kammoh/fobos/control/README.md

FOBOS Control
=============

If you want to use a Digilent Inc Basis 3 board for FOBOS Control, proceed to the directory `basys3ctrl`.

If you want to use a Xilinx Pynq board for FOBOS Control, proceed to the directory `pynctrl`.

The directory `ip_repo` contains FOBOS IP blocks that are used by either control board project.
