kammoh/fobos/hardware/fobos-dut/README.md

FOBOS-DUT Boards
=========
  * `dut-spartan7-s15`
    FOBOS DUT with a Xilinx Spartan-7 xc7s15cpga196-2 device and power measurement circuitry.
  * `dut-artix7-a12t-csg325`
    FOBOS DUT with a Xilinx Artix-7 xc7a12tcsg325 device and power measurement circuitry.
  * `dut-artix7-a12t-cpg238`
    FOBOS DUT with a Xilinx Artix-7 xc7a12tcpg238 device and power measurement circuitry.
  * `dut-cyclone10LP-016`
    FOBOS DUT with an Interl Cyclone 10 LP 10CL016-YU256C6 device and power measurement circuitry.
  * `dut-ecp5-25`
    FOBOS DUT with a Lattice ECP5 LFE5U-25F-6BG381C device and power measurement circuitry.

Check git Wiki
