kammoh/fobos/releasefilelist.txt

# use with tar czvf fobos-0.1.tgz -T releasefilelist.txt
./fobos/requirements.txt
./fobos/software/dummyCapture.py
./fobos/software/tools/x-test/x-test3.py
./fobos/software/tools/t-test/splitter.py
./fobos/software/tools/t-test/t-test2.py
./fobos/software/tools/t-test/read_traces.py
./fobos/software/tools/viewPlots.py
./fobos/software/dummyCaptureBasic.py
./fobos/software/tvgen/blockCipherTVGen.py
./fobos/software/captureScope.py
./fobos/software/attack_with_cpa.py
./fobos/software/program_Nexys3_dut.py
./fobos/software/dummyDUTCapture.py
./fobos/software/captureAES.py
./fobos/software/captureAES_picoscope.py
./fobos/software/genRandTV.py
./fobos/software/fobos/dummyserial.py
./fobos/software/fobos/fobosctrl.py
./fobos/software/fobos/projmgr.py
./fobos/software/fobos/traceset.py
./fobos/software/fobos/detectctrl.py
./fobos/software/fobos/ttestOnline.py
./fobos/software/fobos/cpa.py
./fobos/software/fobos/powermodels/__init__.py
./fobos/software/fobos/powermodels/AESFirstLast.py
./fobos/software/fobos/basys3ctrl.py
./fobos/software/fobos/nexys3dut.py
./fobos/software/fobos/__init__.py
./fobos/software/fobos/t-test2.py
./fobos/software/fobos/picoscope.py
./fobos/software/fobos/datagen.py
./fobos/software/fobos/scope.py
./fobos/software/fobos/hypopower.py
./fobos/software/fobos/postprocess.py
./fobos/workspace/dummyProject/FOBOS_DUT_dummy1.bit
./fobos/workspace/dummyProject/dinFile.txt
./fobos/workspace/aes/dinFile.txt
./fobos/LICENSE.txt
./fobos/capture/ctrl/ip_repo/dutcomm_1.0/xgui/dutcomm_v1_0.tcl
./fobos/capture/ctrl/ip_repo/dutcomm_1.0/component.xml
./fobos/capture/ctrl/ip_repo/dutcomm_1.0/dutcomm_IP_doc.txt
./fobos/capture/ctrl/ip_repo/dutcomm_1.0/hdl/dutcomm_v1_0_S_AXI.vhd
./fobos/capture/ctrl/ip_repo/dutcomm_1.0/hdl/dutCommCtrl.vhd
./fobos/capture/ctrl/ip_repo/dutcomm_1.0/hdl/half_duplex_interface.vhd
./fobos/capture/ctrl/ip_repo/dutcomm_1.0/hdl/dutcomm_v1_0.vhd
./fobos/capture/ctrl/ip_repo/dutcomm_1.0/hdl/dutcomm_wrapper.vhd
./fobos/capture/ctrl/ip_repo/dutcomm_1.0/hdl/dutComm.vhd
./fobos/capture/ctrl/ip_repo/dutcomm_1.0/hdl/fwft_fifo.vhd
./fobos/capture/ctrl/ip_repo/dutcomm_1.0/hdl/half_duplex_int_tb.vhd
./fobos/capture/ctrl/ip_repo/dutcomm_1.0/hdl/dutcomm_tb.vhd
./fobos/capture/ctrl/ip_repo/dutcomm_1.0/drivers/dutcomm_v1_0
./fobos/capture/ctrl/ip_repo/dutcomm_1.0/drivers/dutcomm_v1_0/src
./fobos/capture/ctrl/ip_repo/dutcomm_1.0/drivers/dutcomm_v1_0/src/Makefile
./fobos/capture/ctrl/ip_repo/dutcomm_1.0/drivers/dutcomm_v1_0/src/dutcomm.h
./fobos/capture/ctrl/ip_repo/dutcomm_1.0/drivers/dutcomm_v1_0/src/dutcomm_selftest.c
./fobos/capture/ctrl/ip_repo/dutcomm_1.0/drivers/dutcomm_v1_0/src/dutcomm.c
./fobos/capture/ctrl/ip_repo/dutcomm_1.0/drivers/dutcomm_v1_0/data
./fobos/capture/ctrl/ip_repo/dutcomm_1.0/drivers/dutcomm_v1_0/data/dutcomm.mdd
./fobos/capture/ctrl/ip_repo/dutcomm_1.0/drivers/dutcomm_v1_0/data/dutcomm.tcl
./fobos/capture/ctrl/ip_repo/seven_seg_1.0/xgui/seven_seg_v1_0.tcl
./fobos/capture/ctrl/ip_repo/seven_seg_1.0/component.xml
./fobos/capture/ctrl/ip_repo/seven_seg_1.0/hdl/seven_seg_v1_0.vhd
./fobos/capture/ctrl/ip_repo/seven_seg_1.0/hdl/seven_seg_v1_0_S_AXI.vhd
./fobos/capture/ctrl/ip_repo/seven_seg_1.0/drivers/seven_seg_v1_0
./fobos/capture/ctrl/ip_repo/seven_seg_1.0/drivers/seven_seg_v1_0/src
./fobos/capture/ctrl/ip_repo/seven_seg_1.0/drivers/seven_seg_v1_0/src/Makefile
./fobos/capture/ctrl/ip_repo/seven_seg_1.0/drivers/seven_seg_v1_0/src/seven_seg.c
./fobos/capture/ctrl/ip_repo/seven_seg_1.0/drivers/seven_seg_v1_0/src/seven_seg_selftest.c
./fobos/capture/ctrl/ip_repo/seven_seg_1.0/drivers/seven_seg_v1_0/src/seven_seg.h
./fobos/capture/ctrl/ip_repo/seven_seg_1.0/drivers/seven_seg_v1_0/data
./fobos/capture/ctrl/ip_repo/seven_seg_1.0/drivers/seven_seg_v1_0/data/seven_seg.tcl
./fobos/capture/ctrl/ip_repo/seven_seg_1.0/drivers/seven_seg_v1_0/data/seven_seg.mdd
./fobos/capture/ctrl/ip_repo/dut_controller_1.0/dut_ctrl_IP_doc.txt
./fobos/capture/ctrl/ip_repo/dut_controller_1.0/xgui/dut_controller_v1_0.tcl
./fobos/capture/ctrl/ip_repo/dut_controller_1.0/component.xml
./fobos/capture/ctrl/ip_repo/dut_controller_1.0/hdl/trigger_tb.vhd
./fobos/capture/ctrl/ip_repo/dut_controller_1.0/hdl/rst_mod.vhd
./fobos/capture/ctrl/ip_repo/dut_controller_1.0/hdl/rst_mod_tb.vhd
./fobos/capture/ctrl/ip_repo/dut_controller_1.0/hdl/counter.vhd
./fobos/capture/ctrl/ip_repo/dut_controller_1.0/hdl/dut_controller_v1_0.vhd
./fobos/capture/ctrl/ip_repo/dut_controller_1.0/hdl/timeout_mod_tb.vhd
./fobos/capture/ctrl/ip_repo/dut_controller_1.0/hdl/fobos_package.vhd
./fobos/capture/ctrl/ip_repo/dut_controller_1.0/hdl/trigger_module.vhd
./fobos/capture/ctrl/ip_repo/dut_controller_1.0/hdl/timeout_module.vhd
./fobos/capture/ctrl/ip_repo/dut_controller_1.0/hdl/dut_controller_v1_0_S_AXI.vhd
./fobos/capture/ctrl/ip_repo/dut_controller_1.0/drivers/dut_controller_v1_0
./fobos/capture/ctrl/ip_repo/dut_controller_1.0/drivers/dut_controller_v1_0/src
./fobos/capture/ctrl/ip_repo/dut_controller_1.0/drivers/dut_controller_v1_0/src/Makefile
./fobos/capture/ctrl/ip_repo/dut_controller_1.0/drivers/dut_controller_v1_0/src/dut_controller.c
./fobos/capture/ctrl/ip_repo/dut_controller_1.0/drivers/dut_controller_v1_0/src/dut_controller_selftest.c
./fobos/capture/ctrl/ip_repo/dut_controller_1.0/drivers/dut_controller_v1_0/src/dut_controller.h
./fobos/capture/ctrl/ip_repo/dut_controller_1.0/drivers/dut_controller_v1_0/data
./fobos/capture/ctrl/ip_repo/dut_controller_1.0/drivers/dut_controller_v1_0/data/dut_controller.tcl
./fobos/capture/ctrl/ip_repo/dut_controller_1.0/drivers/dut_controller_v1_0/data/dut_controller.mdd
./fobos/capture/ctrl/ip_repo/dummyDUT/fobos_dut_pkg.vhd
./fobos/capture/ctrl/ip_repo/dummyDUT/dut_reg1.vhd
./fobos/capture/ctrl/ip_repo/dummyDUT/fobos_controller.vhd
./fobos/capture/ctrl/ip_repo/dummyDUT/FOBOS_DUT.vhd
./fobos/capture/ctrl/ip_repo/dummyDUT/dut_regn.vhd
./fobos/capture/ctrl/ip_repo/dummyDUT/fifo.vhd
./fobos/capture/ctrl/ip_repo/dummyDUT/fifo2.vhd
./fobos/capture/ctrl/ip_repo/dummyDUT/test_controller.vhd
./fobos/capture/ctrl/ip_repo/dummyDUT/fobos_dut_tb.vhd
./fobos/capture/ctrl/ip_repo/dummyDUT/dummy.vhd
./fobos/capture/ctrl/basys3ctrl/sdk/src/seven_seg.c
./fobos/capture/ctrl/basys3ctrl/sdk/src/seven_seg.h
./fobos/capture/ctrl/basys3ctrl/sdk/src/ctrl.c
./fobos/capture/ctrl/basys3ctrl/vivado/Makefile
./fobos/capture/ctrl/basys3ctrl/vivado/src/bd/top.tcl
./fobos/capture/ctrl/basys3ctrl/vivado/src/constr/debug.xdc
./fobos/capture/ctrl/basys3ctrl/vivado/src/constr/basys3ctrl.xdc
./fobos/capture/ctrl/basys3ctrl/vivado/build_proj.tcl
./fobos/capture/dut/fpga_dut/fobos_dut_pkg.vhd
./fobos/capture/dut/fpga_dut/dut_reg1.vhd
./fobos/capture/dut/fpga_dut/fobos_controller.vhd
./fobos/capture/dut/fpga_dut/FOBOS_DUT.vhd
./fobos/capture/dut/fpga_dut/dut_regn.vhd
./fobos/capture/dut/fpga_dut/half_duplex_interface.vhd
./fobos/capture/dut/fpga_dut/fifo.vhd
./fobos/capture/dut/fpga_dut/test_controller.vhd
./fobos/capture/dut/fpga_dut/fobos_dut_tb.vhd
./fobos/capture/dut/fpga_dut/Nexys3.ucf
./fobos/capture/dut/fpga_dut/cw305_dut.xdc
./fobos/capture/dut/example_cores/dummy1
./fobos/capture/dut/example_cores/dummy1/dummy.vhd
./fobos/releasefilelist.txt
