kammoh/fobos/docs/source/dut/index.rst

.. _dut-label:

*********
FOBOS DUT
*********
FOBOS supports two boards for FOBOS Control:

#. Digilent Basys 3
#. Digilent Pynq-Z1

.. toctree::
   :hidden:
   
   dut_setup
   dut_development
