kammoh/fobos/hardware/fobos-dut/dut-artix7-a12t-csg325/dut-artix7-a12t.html

# D:\_Grad_School\CERG_2020\fobos\hardware\fobos-dut\dut-artix7-a12t\dut-artix7-a12t.sch

5/25/2021 10:37:35 PM

Eeschema (5.1.7)-1

Component Count:179

Ref | Qnty | Value | Part | Datasheet | Description | Vendor
C1, C2, C3, C4, C5, C9, C11, C13, C14, C16, C24, C54 | 12 | 100nF | Device:C | ~ | Unpolarized capacitor
C6, C10, C22, C23 | 4 | 10uF | Device:C | ~ | Unpolarized capacitor
C7 | 1 | 47uF6.3V | Device:C | ~ | Unpolarized capacitor
C8 | 1 | 10nF | Device:C | ~ | Unpolarized capacitor
C12 | 1 | 4n7 | Device:C | ~ | Unpolarized capacitor
C15 | 1 | 2u2 | Device:C | ~ | Unpolarized capacitor
C17, C21 | 2 | 22uF | Device:C | ~ | Unpolarized capacitor
C18, C19, C20 | 3 | 20pF | Device:C | ~ | Unpolarized capacitor
C25 | 1 | 100uF | Device:C | ~ | Unpolarized capacitor
C26, C27, C35 | 3 | 47uF | Device:C | ~ | Unpolarized capacitor
C28, C29, C36, C37, C38, C39, C40, C41 | 8 | 4.7uF | Device:C | ~ | Unpolarized capacitor
C30, C31, C32, C33, C34, C42, C43, C44, C45, C46, C47, C48, C49, C50, C51, C52, C53 | 17 | .47uF | Device:C | ~ | Unpolarized capacitor
D1, D2, D3, D4, D5, D6 | 6 | LG_L29K-G2J1-24-Z | cerg:LG_L29K-G2J1-24-Z | https://dammedia.osram.info/media/resource/hires/osram-dam-2493945/LG%20L29K.pdf | LED GREEN DIFFUSED 0603 SMD
F1 | 1 | MF-MSMF050-2 | Device:Polyfuse | ~ | Resettable fuse, polymeric positive temperature coefficient
H1, H2, H3, H4 | 4 | MountingHole | Mechanical:MountingHole | ~ | Mounting Hole without connection
J1 | 1 | Target | Connector_Generic:Conn_02x10_Odd_Even | ~ | Generic connector, double row, 02x10, odd/even pin numbering scheme (row 1 odd numbers, row 2 even numbers), script generated (kicad-library-utils/schlib/autogen/connector/)
J2 | 1 | Pmod 2x6 | Connector_Generic:Conn_02x06_Top_Bottom | ~ | Generic connector, double row, 02x06, top/bottom pin numbering scheme (row 1: 1...pins_per_row, row2: pins_per_row+1 ... num_pins), script generated (kicad-library-utils/schlib/autogen/connector/)
J3, J8 | 2 | 575-8 | cerg:575-8 | https://www.digikey.com/en/products/detail/keystone-electronics/575-8/318495 | CONN TIP JACK SOLDER RED
J4 | 1 | Glitch | Connector:Conn_Coaxial_Power | ~ | coaxial connector (BNC, SMA, SMB, SMC, Cinch/RCA, ...)
J5, J10 | 2 | Conn_01x02 | Connector_Generic:Conn_01x02 | ~ | Generic connector, single row, 01x02, script generated (kicad-library-utils/schlib/autogen/connector/)
J6, J9 | 2 | Measure | Connector:Conn_Coaxial_Power | ~ | coaxial connector (BNC, SMA, SMB, SMC, Cinch/RCA, ...)
J7 | 1 | 0878321420 | dk_Rectangular-Connectors-Headers-Male-Pins:0878321420 | https://www.molex.com/pdm_docs/sd/878322620_sd.pdf | CONN HEADER SMD 14POS 2MM
JP1 | 1 | Source | Jumper:Jumper_3_Open | ~ | Jumper, 3-pole, both open
JP2 | 1 | CurProbe | Jumper:Jumper_2_Open | ~ | Jumper, 2-pole, open
JP3 | 1 | Shunt1R | Jumper:Jumper_2_Open | ~ | Jumper, 2-pole, open
JP4 | 1 | FC3V3_3V3_SHUNT | Jumper:Jumper_2_Open | ~ | Jumper, 2-pole, open
JP5 | 1 | Conn_01x02 | Connector_Generic:Conn_01x02 | ~ | Generic connector, single row, 01x02, script generated (kicad-library-utils/schlib/autogen/connector/)
L1, L2 | 2 | 1k/500mA | Device:L_Core_Ferrite | ~ | Inductor with ferrite core
L3 | 1 | 1.5uH | Device:L | https://www.mouser.com/ProductDetail/Bourns/SRN2012-1R5M/?qs=U0ECReq1GB%2FS6CSJ%2FWDZfQ%3D%3D | Inductor
L4 | 1 | 3.3uH | Device:L | https://www.digikey.com/en/products/detail/taiyo-yuden/BRC2012T3R3MD/2648984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 | Inductor
L5 | 1 | 2.2uH | Device:L | https://www.digikey.com/en/products/detail/bourns-inc/SRN2010-2R2M/4867667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 | Inductor
Q1 | 1 | FDS9435A | Transistor_FET:FDS9435A | https://www.onsemi.com/pub/Collateral/FDS9435A-D.PDF | -5.3A Id, -30V Vds, P-Channel MOSFET, 50mOhm Ron, SO-8
Q2 | 1 | MBT3904DW1 | Transistor_BJT:MBT3904DW1 | http://www.onsemi.com/pub_link/Collateral/MBT3904DW1T1-D.PDF | 200mA IC, 40V Vce, Dual NPN/NPN Transistors, SOT-363
Q3, Q4, Q5, Q6, Q7 | 5 | BSS138 | Transistor_FET:BSS138 | https://www.fairchildsemi.com/datasheets/BS/BSS138.pdf | 50V Vds, 0.22A Id, N-Channel MOSFET, SOT-23
R1, R2, R3, R4, R5, R6, R13, R14, R15, R16, R17, R18 | 12 | 22R | Device:R | ~ | Resistor
R7, R8, R9, R10, R11, R12, R19, R20, R53, R72 | 10 | 200R | Device:R | ~ | Resistor
R21 | 1 | 1M | Device:R | ~ | Resistor
R22 | 1 | 100R | Device:R | ~ | Resistor
R23 | 1 | 0R1 | Device:R | ~ | Resistor
R24 | 1 | 49R9 | Device:R | ~ | Resistor
R25, R26, R31, R32, R33, R41, R52, R54, R55 | 9 | 4.7KR | Device:R | ~ | Resistor
R27, R28, R56 | 3 | 33R | Device:R | ~ | Resistor
R29, R30, R37, R67 | 4 | 0R | Device:R | ~ | Resistor
R34 | 1 | 3.48KR | Device:R | ~ | Resistor
R35, R42, R43, R44, R45, R51, R60, R61, R62, R63, R64, R65, R66, R68, R70, R71 | 16 | 10KR | Device:R | ~ | Resistor
R36 | 1 | 1KR | Device:R | ~ | Resistor
R38, R39, R40, R49 | 4 | 100KR | Device:R | ~ | Resistor
R46, R47 | 2 | 120KR | Device:R | ~ | Resistor
R48 | 1 | 57.6KR | Device:R | ~ | Resistor
R50 | 1 | 800R | Device:R | ~ | Resistor
R57, R58, R59, R69 | 4 | 470R | Device:R | ~ | Resistor
S1 | 1 | JS202011SCQN | cerg:JS202011SCQN | https://www.ckswitches.com/media/1422/js.pdf | SWITCH SLIDE DPDT 300MA 6V
S2, S4, S5 | 3 | 1825910-6 | cerg:1825910-6 | https://www.te.com/commerce/DocumentDelivery/DDEController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 | SWITCH TACTILE SPST-NO 0.05A 24V
SW1, SW2 | 2 | SW_DIP_x03 | cerg:SW_DIP_x03 | https://www.cuidevices.com/product/resource/ds04-254-smt.pdf | 3x DIP Switch, Single Pole Single Throw (SPST) switch, small symbol
U1 | 1 | XC7A12T-CSG325 | cerg:XC7A12T-CSG325 | https://www.xilinx.com/support/documentation/data_sheets/ds180_7Series_Overview.pdf | Xilinx Artix-7 FPGA, XC7A12T, CSG325
U2, U3, U4 | 3 | SP3003-04ATG | cerg:SP3003-04ATG | http://www.onsemi.com/pub/Collateral/SRV05-4-D.PDF | ESD Protection Diodes with Low Clamping Voltage, SOT-23-6
U5 | 1 | INA225 | cerg:INA225
U6 | 1 | BGA2801 | RF_Amplifier:BGA2801 | https://www.nxp.com/docs/en/data-sheet/BGA2801.pdf | MMIC wideband amplifier, DC-2.2GHz, +23dB @ 2120MHz, 3.3V, SOT-363
U7 | 1 | TS3A5018DBQR | cerg:TS3A5018DBQR | https://www.digikey.com/en/products/detail/texas-instruments/TS3A5018DBQR/705733
U8 | 1 | LTC3569EFE#PBF | cerg:LTC3569EFE#PBF
U9 | 1 | IS25LP256D-JMLE | cerg:IS25LP256D-JMLE | https://www.digikey.com/en/products/detail/issi-integrated-silicon-solution-inc/IS25LP256D-JMLE/7567432 | IC FLASH 256M SPI 133MHZ 16SOIC
