kammoh/fobos/docs/presentations/fobos2_reconfig19_demo.odt

An Open-Source Platform for Evaluating Side-channel Countermeasures

in Hardware Implementations of Cryptography

Abubakr Abdulgadir¹, William Diehl² and Jens-Peter Kaps¹

¹Cryptographic Engineering Research Group

George Mason University, Fairfax, Virginia 22030, USA

email: {aabdulga, jkaps}@gmu.edu

²Signatures Analysis Lab

Virginia Tech, Blacksburg, Virginia 24061, USA

email: wdiehl@vt.edu

Side-channel Analysis (SCA) is a major security threat for cryptographic implementations.

The Flexible, Opensource workBench fOr Side-channel analysis (FOBOS) is an SCA platform developed at George Mason University that can perform acquisition and analysis with main focus on FPGA implementations as target devices.

FOBOS uses commercially available boards when possible to reduce cost and make it easy to replicate the system by different teams. The system is designed in a modular fashion allowing easy modification. For example, separate control board and design-under-test (DUT) boards allows easy integration of new DUT boards.

The system is composed of two major modules. The Data Acquisition module is used to capture traces and the Data Analysis module is used to perform SCA attacks or assess leakage.

FOBOS features include configurable triggering unit and support for various hardware APIs like the Lightweight Cryptography (LWC) Hardware API.

The latest version of the system, FOBOS2, supports fast USB3-based oscilloscopes, modern DUT FPGA boards and configurable DUT reset.

Also, new leakage assessment capabilities like the chi-squared test have been added.

At ReConFig 2019, we will demo FOBOS2 and show a typical hardware setup. The acquisition module will be demonstrated by collecting traces and leakage assessment software will be used to evaluate SCA resistance of a NIST LWC round-2 candidate implemented on an FPGA.
