kammoh/fobos/oldfobos/doc/flash_basys3.odt

Used this but not sure if the part related to tools→ Device properties is necessary

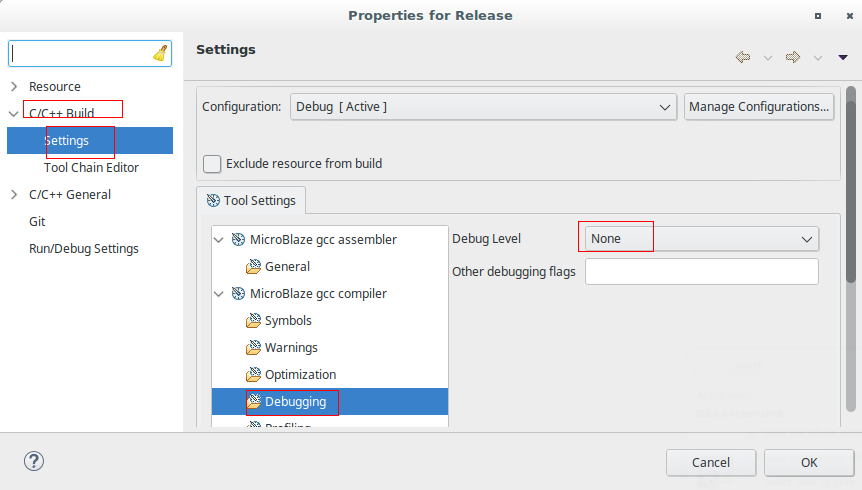
[picture p41: figure]

https://www.instructables.com/id/Flashing-a-MicroBlaze-Program/

Make sure that the program have no debug settings
