kammoh/fobos/doc/Poster/fobosposter.pdf

## Flexible, Opensource workBench fOr Side-channel analysis

# (FOBOS)

## Rajesh Velegalati, Panasayya Yalla, Jens-Peter Kaps

Department of Electrical and Computer Engineering, George Mason University, Fairfax, Virginia 22030, USA

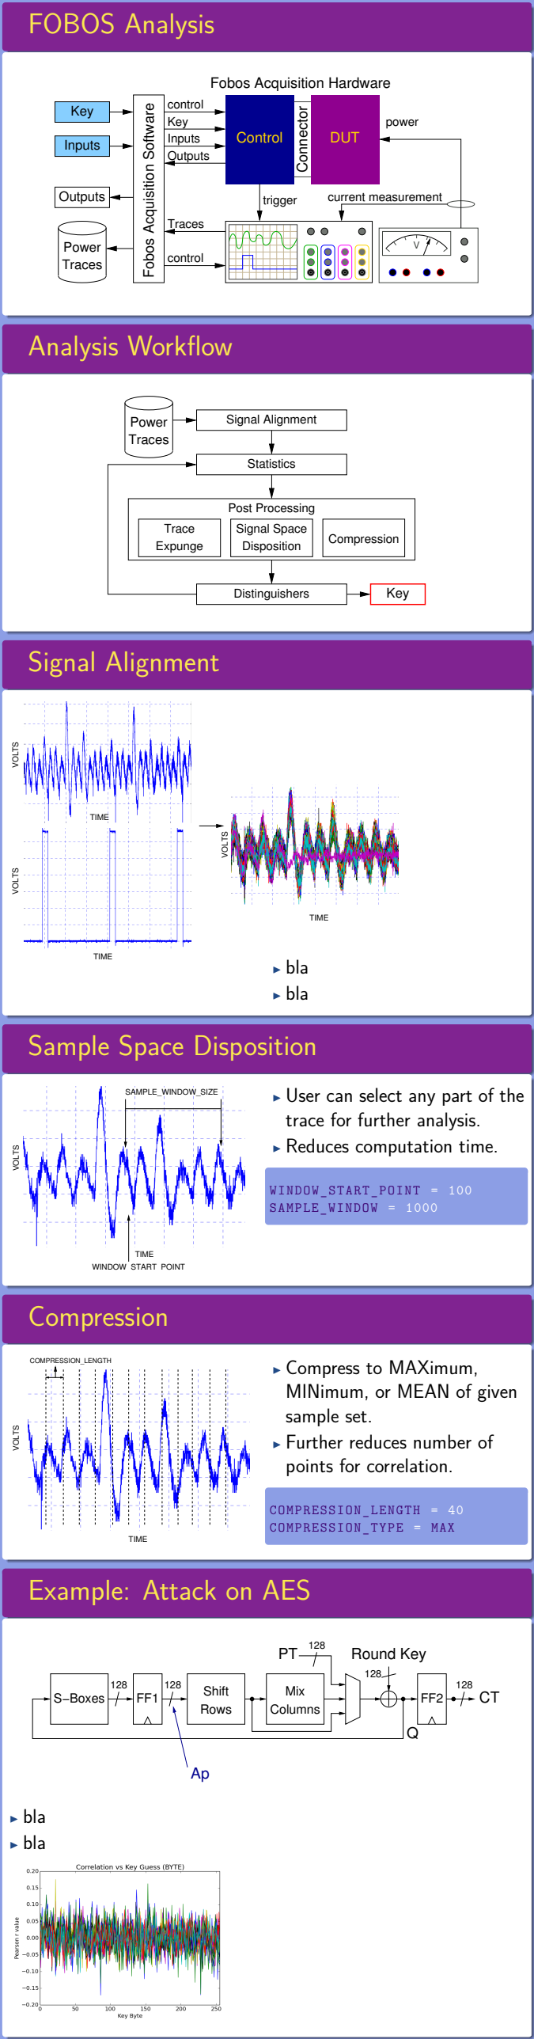
[picture p42: figure]
FOBOS Analysis; Connector; Control; DUT; Key; Inputs; Outputs; Power Traces; trigger; power; current measurement; control; Key Inputs Outputs; Traces; Fobos Acquisition Software; Fobos Acquisition Hardware; Analysis Workflow; Statistics; Distinguishers; Signal Alignment; Post Processing; Signal Space Disposition; Trace; Expunge; Compression; TIME; VOLTS VOLTS; VOLTS; I bla I bla; Sample Space Disposition; SAMPLE_WINDOW_SIZE; WINDOW_START_POINT; I User can select any part of the trace for further analysis. I Reduces computation time.; WINDOW_START_POINT = 100; SAMPLE_WINDOW = 1000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

## Abstract

Side-channel analysis (SCA) attacks pose a growing threat to implementations of cryptographic algorithms implemented in software as well as in hardware. Current standard side-channel evaluation boards with Field Programmable Gate Arrays (FPGAs), that allow for exploring the vulnerability of cryptographic implementations on FPGAs, are expensive and available only for a few FPGA devices. Furthermore, a complete open source software package that includes drivers that run test cases on the board, control the measurement equipment, and contain several side-channel analysis techniques is not readily available. Each user has to assemble their own setup based on software packages from multiple sources, written in multiple languages and write parts themselves. Additionally, this complexity and cost makes it very difficult, if not impossible, to educate students on side-channel analysis through hands-on laboratory exercises. FOBOS is an open-source framework for conducting side-channel attacks on FPGAs which supports multiple FPGA devices and includes all necessary software to run differential power analysis attacks, which are the most prominent kind of side-channel attacks. Through its completeness and support for educational FPGA boards it is an ideal teaching tool.

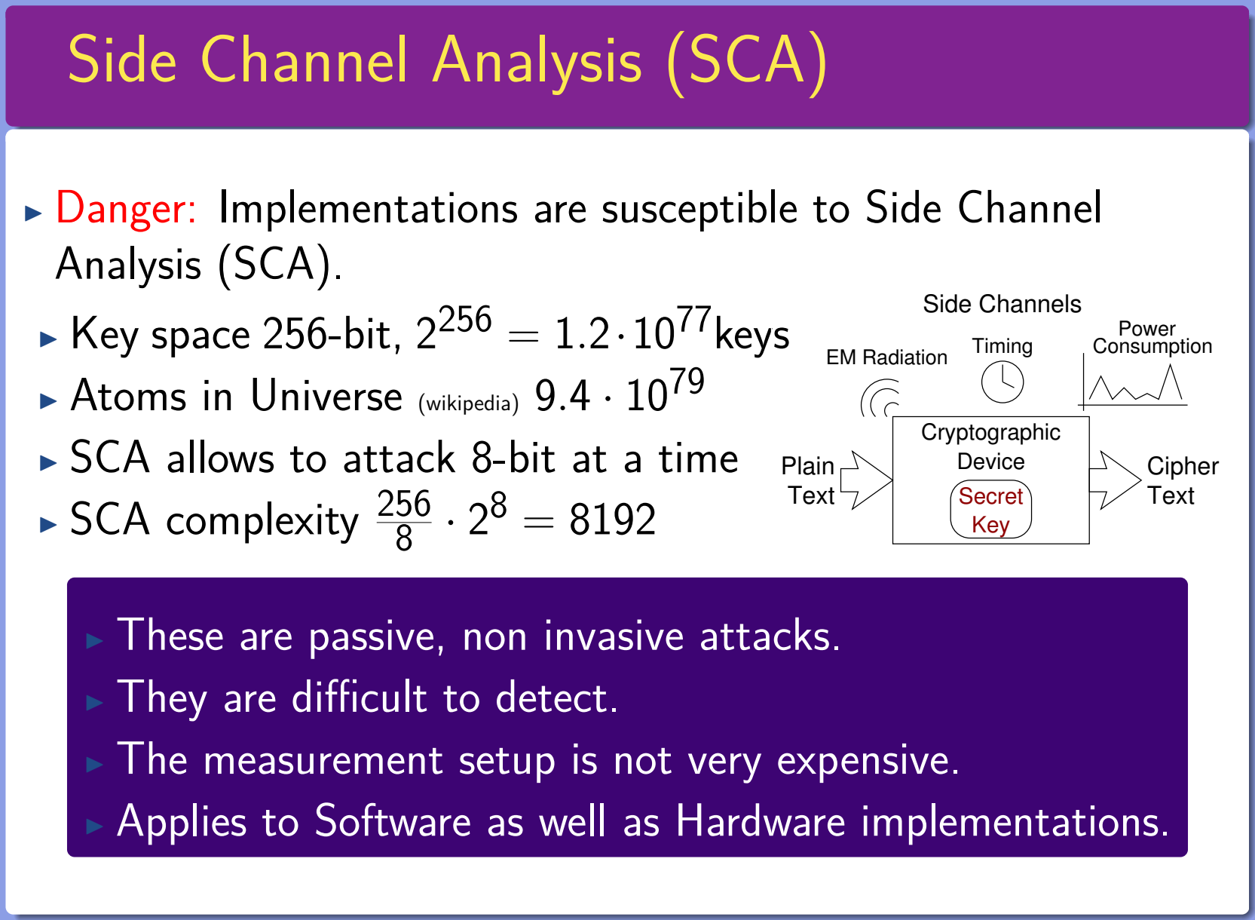
[picture p43: figure]
Side Channel Analysis (SCA); Analysis (SCA).; I SCA allows to attack 8-bit at a time I SCA complexity 256 8; Timing; Consumption; Power; Secret Key; Device; Cryptographic; Plain Text; EM Radiation; Side Channels; Text; Cipher; I They are difficult to detect.

I Danger: Implementations are susceptible to Side Channel

I Key space 256-bit, 2²⁵⁶ = 1.2·10⁷⁷keys
I Atoms in Universe (wikipedia) 9.4 · 10⁷⁹

I These are passive, non invasive attacks.

I The measurement setup is not very expensive.
I Applies to Software as well as Hardware implementations.

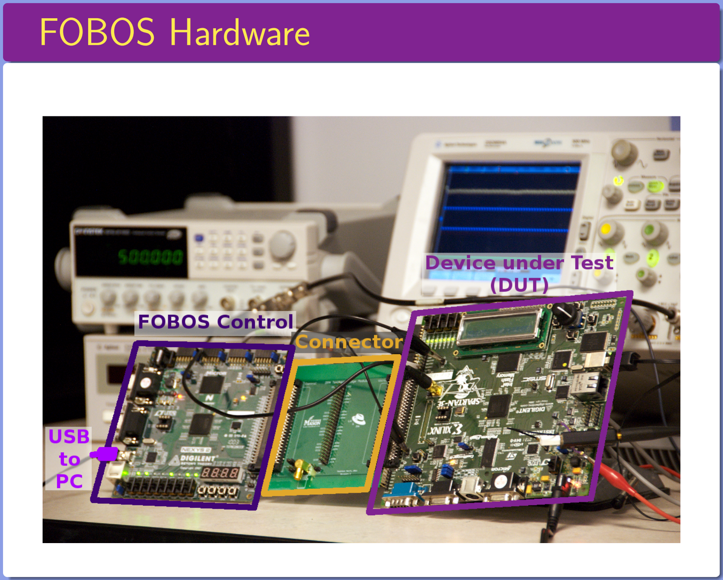
[picture p44: figure]
FOBOS Hardware

## Current SCA Evaluation Solutions

AES
I NIST standard for block
ciphers.
I Based on Rijndael block
cipher.
I 128-bit block size.
I 128/192/256-bit key size.

Keccak-p[1600,nr]
I Permutation based on Keccak, winner of competition for next Secure Hash Algorithm
(SHA-3).
I 1600-bit state size.

## Drawbacks of Current Solutions

I IA Meter only performs acquisition using Python.
I OpenSCA Toolbox performs only analysis using Matlab. I SASEBO has very limited FPGA support und uses C#.
I DPA resistance depends on FPGA family.
I DPA resistance depends on FPGA packaging (e.g., w/ or w/o capacitances).
I Currently only a patchwork of scripts and tools exist.
I No complete, free, and open-source solution is available. I No inexpensive out-of-the-box solution for education.

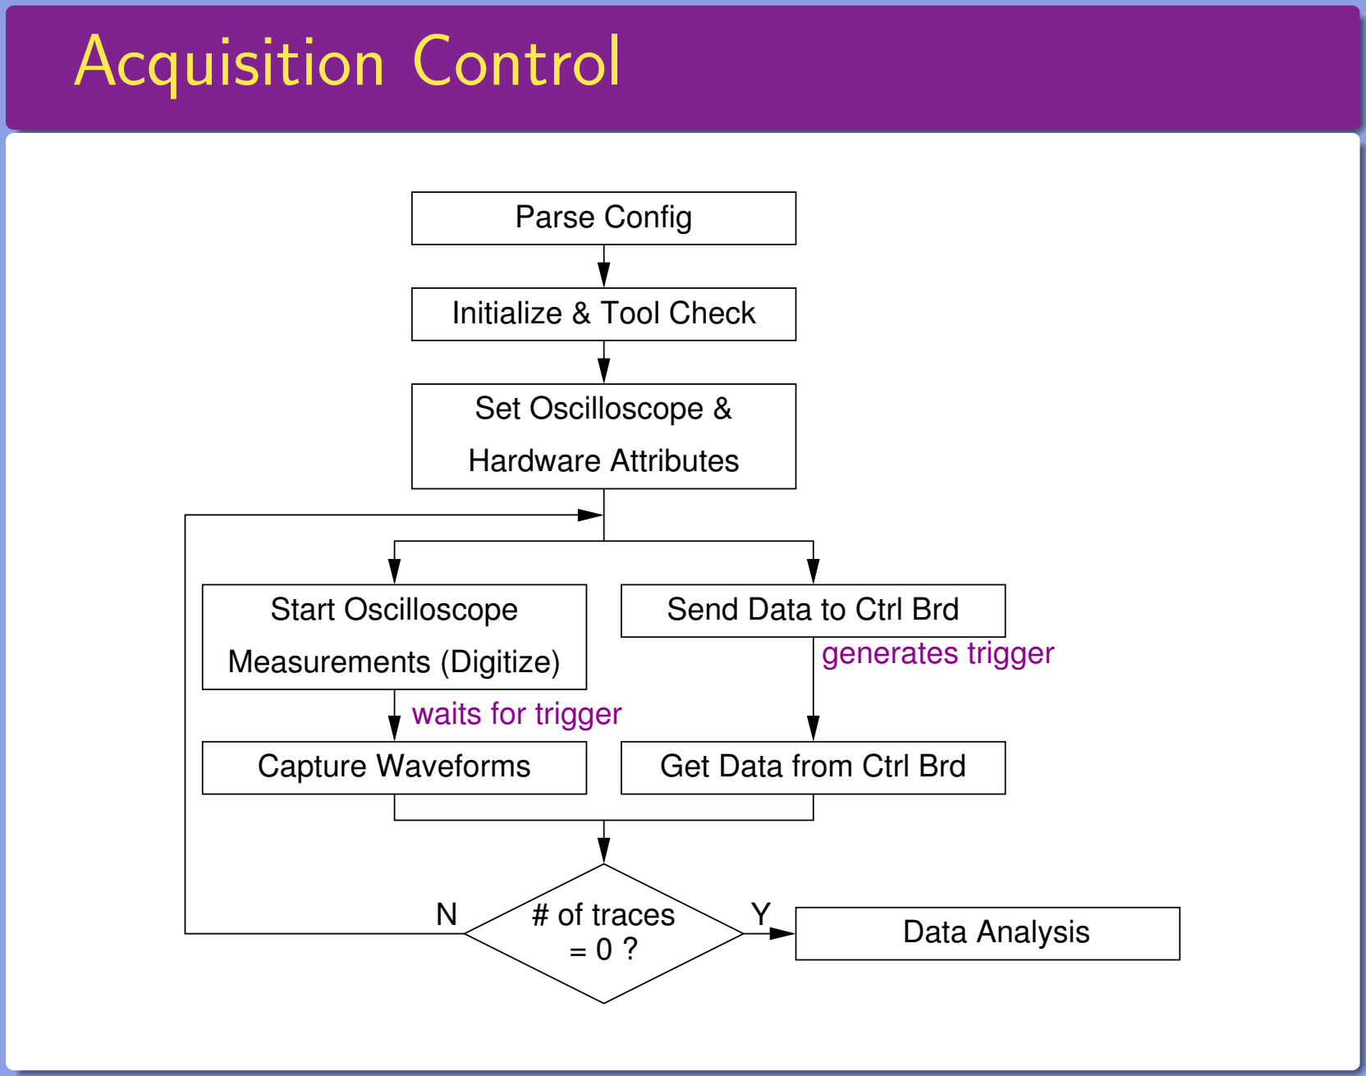
[picture p45: figure]
Acquisition Control; Data Analysis; Initialize & Tool Check; Set Oscilloscope &; Parse Config; Hardware Attributes; Start Oscilloscope; Send Data to Ctrl Brd; Measurements (Digitize); waits for trigger; generates trigger; Capture Waveforms; Get Data from Ctrl Brd; N Y # of traces

## Modes of Operation Summary

AES / Rijndael* and Keccak Modes (Rd. = Number of rounds)

Operation Mode | | Block Key Rd. ρ | Inputs | Outputs
Hash* MAC AEAD PRNG | AES-Hash 256 N/A 14 CMAC GCM Fortuna | 128 128 10 128 128 10 128 N/A 14 | |M|, M |M|, M, K, IV |M|, M, K, IV , T, C |AD|, AD S | H T R
Hash MAC AEAD PRNG | Sponge Sponge Duplex Duplex | 1600 N/A 24 1088 |M|, M 1600 128 24 1088 |M|, M, K, IV 1600 128 12 1344 |M|, M, K, IV , T, C 1600 N/A 12 1344 S | |AD|, AD | H T R

AES

Keccak

M–Message, K–Key, AD–Associated Data, S–Seed, IV –Initialization Value, H–Hash, T–Tag,

C–Cipher-text, R–Random Number, |X|–Length of X

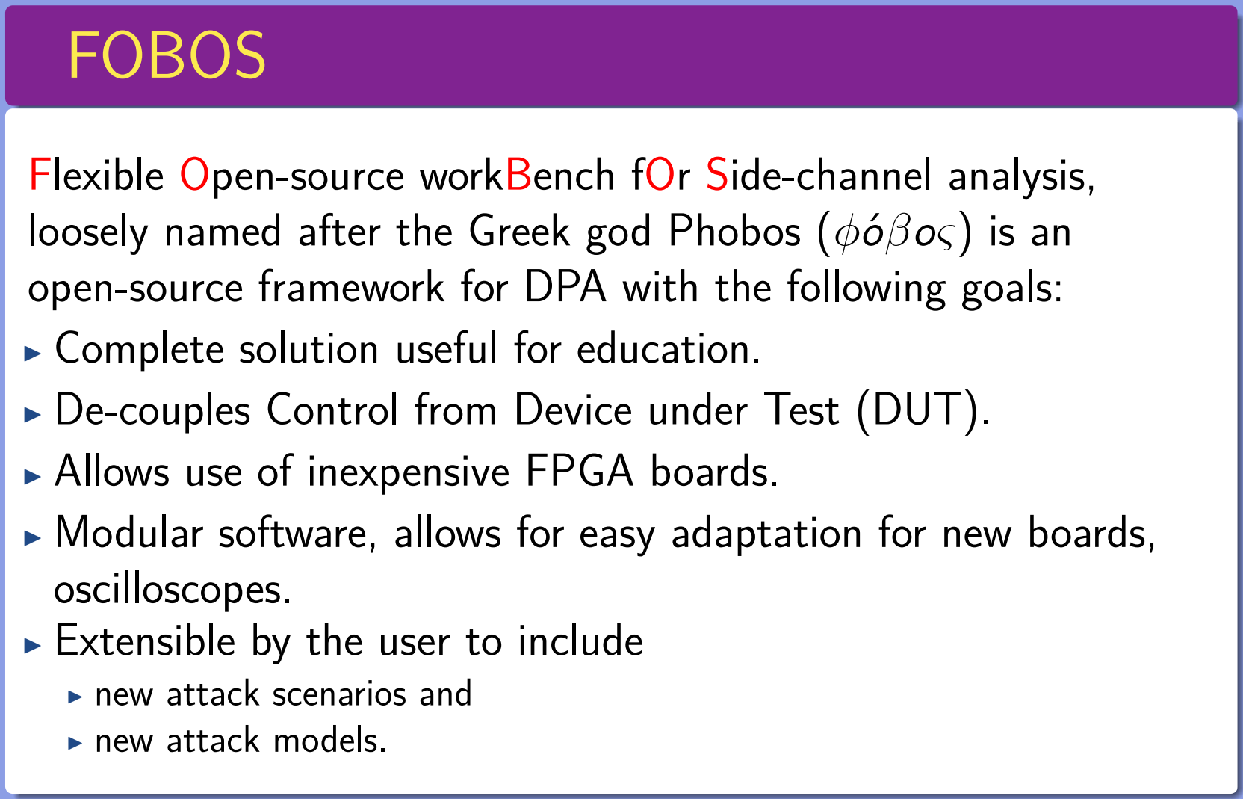
[picture p46: figure]
FOBOS; oscilloscopes. I Extensible by the user to include; I new attack scenarios and I new attack models.

Flexible Open-source workBench fOr Side-channel analysis, loosely named after the Greek god Phobos (φo´βoς) is an open-source framework for DPA with the following goals: I Complete solution useful for education.
I De-couples Control from Device under Test (DUT).
I Allows use of inexpensive FPGA boards.
I Modular software, allows for easy adaptation for new boards,

## Top Level Diagram

Key

Inputs

Outputs

Power
Traces

Power
Model | Key

Data Analysis

FOBOS
Data Acquisition

FOBOS

DUT

control

user provided

current measurement

Key Guess

user provided

## FOBOS Acquisition

V

Connector

Control | DUT

Key

Inputs

Outputs

Power
Traces

trigger

power

current measurement

control

control

Key
Inputs
Outputs

Traces

Fobos Acquisition Software

Fobos Acquisition Hardware

Cryptographic Engineering Research Group (CERG) | Department of Electrical and Computer Engineering | George Mason University | http://cryptography.gmu.edu
