kammoh/fobos/oldfobos/doc/figures/fobos-dan.pdf

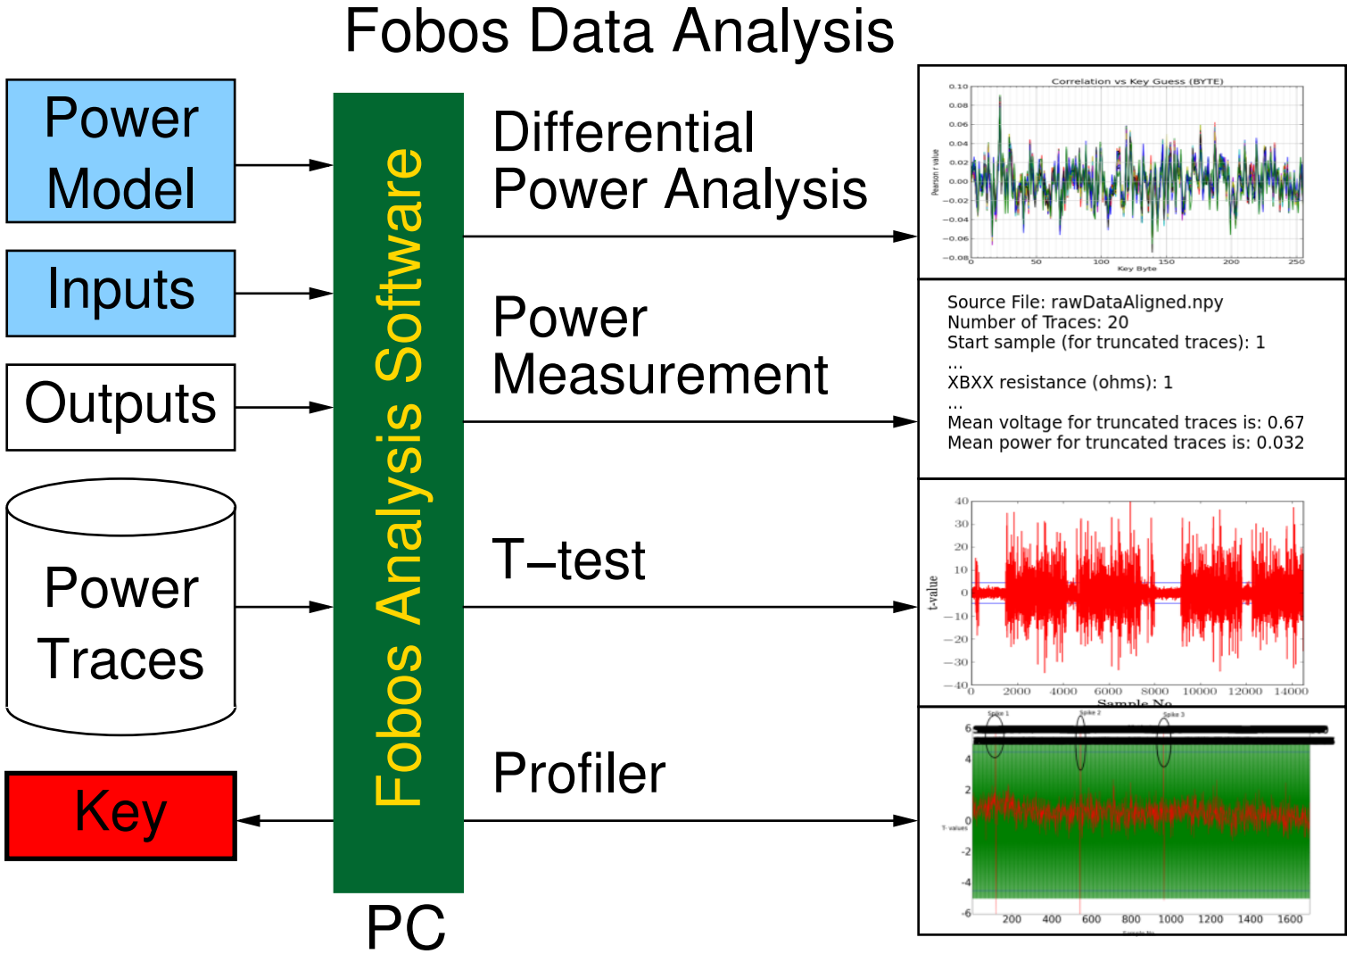
[picture p63: figure]
Power Model; Inputs; Outputs; Power Traces; Key; Fobos Analysis Software; Fobos Data Analysis; Profiler; Differential Power Analysis; Measurement; Power; T−test
