kammoh/fobos/oldfobos/doc/PmodConnector/pmod_connector.pdf

# Pmod On Nexys3 Controller and DUT

November 14, 2016

Pin 12

Pin 6

VCC GND | Pin 1

Pin 12

Pin 6

VCC GND | Pin 1
JD | JC

Figure 1: Pmod Connectors as Viewed from Front

Table 1: Pin Configuration on Nexys3
Pin | LOC | Net | Comment | Pin | LOC | Net | Comment
JC1 | H3 | DUTClock | GCLK20 | JD1 | G11 | reset
JC2 | L7 | src ready | | JD2 | F10 | dst ready
JC3 | K6 | datain[3] | | JD3 | F11 | dataout[3]
JC4 | G3 | datain[1] | | JD4 | E11 | dataout[1]
JC5 | | | GND | JD5 | | GND
JC7 | G1 | src read | | JD7 | D12
JC8 | J1 | | | JD8 | C12 | dst write
JC9 | J6 | datain[2] | | JD9 | F12 | dataout[2]
JC10 | F2 | datain[0] | | JD10 | E12 | dataout[0]

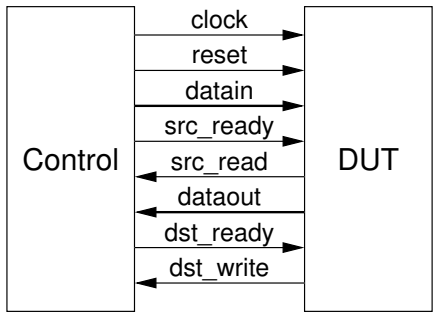
[picture p64: figure]
Control; DUT; src_ready src_read; dst_ready dst_write; clock reset datain; dataout

Figure 2: Connections between Control and DUT

1
