kammoh/fobos/oldfobos/doc/PmodConnector/pmod_connector-Nexys4-DUT.pdf

# Pmod connector on Nexys 4 DUT

November 14, 2016

Pin 12

Pin 6

VCC GND | Pin 1

Pin 12

Pin 6

VCC GND | Pin 1
JD | JC

Figure 1: Pmod Connectors as Viewed from Front

Table 1: Pin Configuration on Nexys3
Pin | LOC | Net | Comment | Pin | LOC | Net | Comment
JC1 | K2 | DUTClock | GCLK20 | JD1 | H4 | reset
JC2 | E7 | src ready | | JD2 | H1 | dst ready
JC3 | J3 | datain[3] | | JD3 | G1 | dataout[3]
JC4 | J4 | datain[1] | | JD4 | G3 | dataout[1]
JC5 | | | GND | JD4 | | GND
JC7 | K1 | src read | | JD7 | H2
JC8 | E6 | | | JD8 | G4 | dst write
JC9 | J2 | datain[2] | | JD9 | G2 | dataout[2]
JC10 | G6 | datain[0] | | JD10 | F3 | dataout[0]

Control; DUT; src_ready src_read; dst_ready dst_write; clock reset datain; dataout

Figure 2: Connections between Control and DUT

1
