kammoh/fobos/oldfobos/doc/figures/tracealingment.pdf

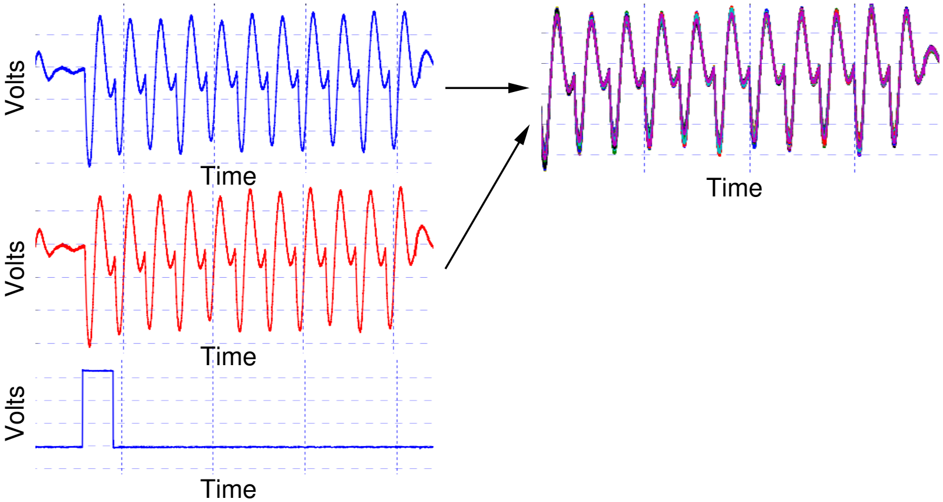
[picture p65: page 1]

Volts

Time

Time

Volts Volts

Time Time
