kammoh/fobos/oldfobos/doc/figures/data_anl.pdf

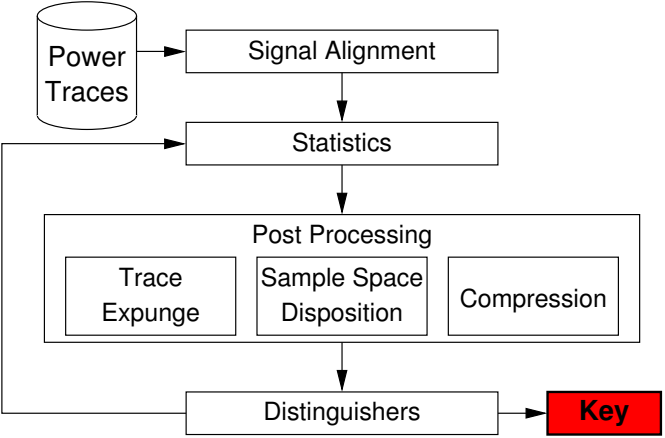
[picture p66: figure]
Statistics; Distinguishers; Power Traces; Signal Alignment; Key; Post Processing; Disposition; Trace; Expunge; Compression; Sample Space
