kammoh/fobos/oldfobos/doc/figures/oscilloscope-sample-window.pdf

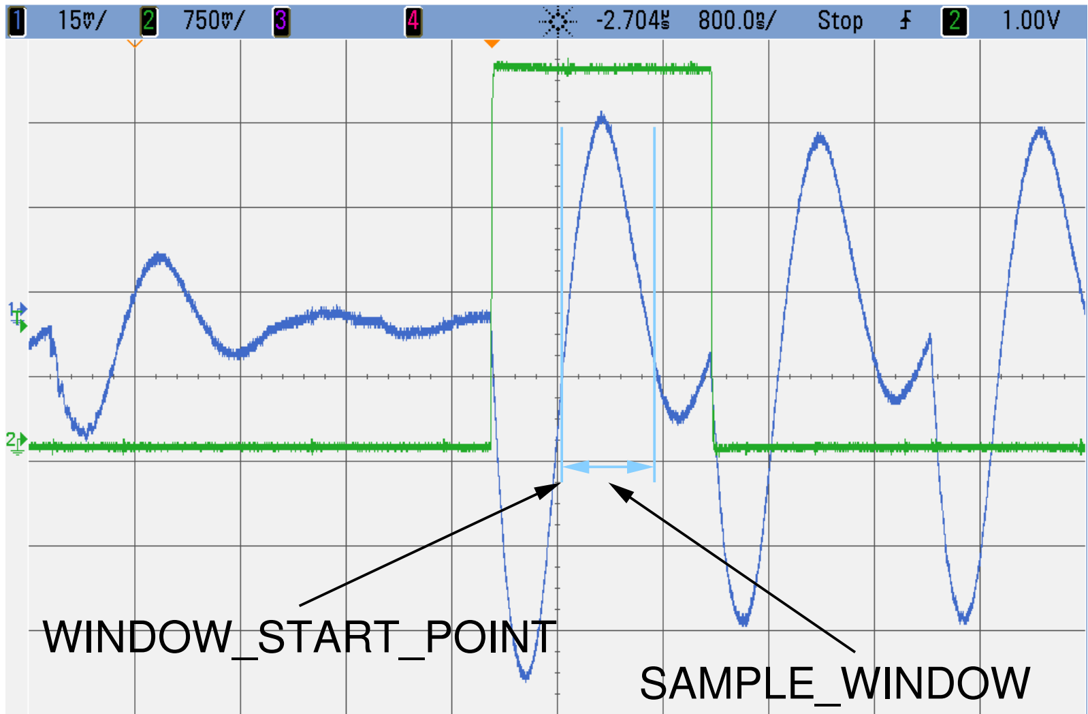
[picture p67: page 1]

WINDOW_START_POINT
SAMPLE_WINDOW
