kammoh/fobos/oldfobos/doc/figures/oscilloscope-compression-window.pdf

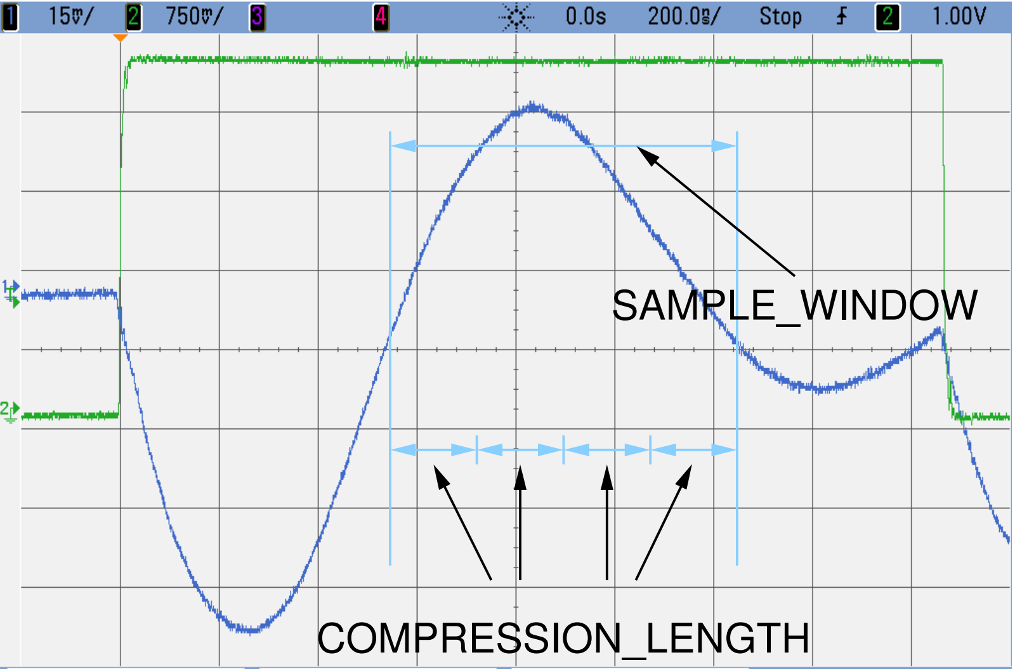
[picture p68: page 1]

SAMPLE_WINDOW

COMPRESSION_LENGTH
