kammoh/fobos/hardware/20 Pin Connector.ods

Sheet: Sheet1
FOBOS Target Connector Pin Number | FOBOS Name / Schematic Label | Chip Whisperer Name | Half Duplex DUT function | Direction* | Alt? | Alt function | Direction*
1 | FC_5V | CW_5V | POWER | in | NO | - | -
2 | GND | GND | POWER | in | NO | - | - | * All direction is denoted from the perspective of the DUT FPGA
3 | FC_3V3 | CW_3V3 | POWER | in | NO | - | - | ** When PROG is asserted, alt functions are enabled
4 | FD2C_CLK | CW_HS1 | UNUSED | out | NO | - | -
5 | FC_RST | CW_RST | d_rst | in | NO | - | -
6 | FC2D_CLK | CW_HS2 | clock_c2d | in | NO | - | - | CLK_C2D max 100 MHz
7 | FC_IO | CW_MISO | FS_IO=0 Dir = i, FS_IO=1 Dir = o | in | NO | - | - | FC_IO sets the direction of the i/o signals
8 | FD_VREF | CW_VREF | POWER | out | NO | - | - | FC stands for FOBOS Control
9 | FD_TF | CW_MOSI | UNUSED | out | YES | done | out | FD stands for FOBOS Device Under Test (DUT)
10 | FC_DIO0 | CW_TARG1 | dio[0] | i/o | YES | clk | in | each time FC or FD indicates the source of the signal
11 | (Ready) FC2D_HS | CW_SCK | handshake_c2d | in | NO | - | - | HS stands for HandShake signals (Valid/Ready)
12 | FC_DIO1 | CW_TARG2 | dio[1] | i/o | YES | din | in | FS_DIO is a 4 bit bidirectional data bus
13 | (Valid) FD2C_HS | CW_PDIC | handshake_d2c | out | NO | - | - | FD_TF is 0 when DUT is busy, else 1 on some DUTs
14 | FC_DIO2 | CW_TARG3 | dio[2] | i/o | YES | program_b | in
15 | (Aux) FC_PROG | CW_PDID | UNUSED | in | NO | - | -
16 | FC_DIO3 | CW_TARG4 | dio[3] | i/o | YES | init_b | out
17 | GND | GND | POWER | in | NO | - | -
18 | FC_3V3 | CW_3V3 | POWER | in | NO | - | -
19 | GND | GND | POWER | in | NO | - | -
20 | FC_5V | CW_5V | POWER | in | NO | - | -

Sheet: CW 20 Pinout
Number | Name | Dir | Description
1 | +VUSB (5V) | O | Not Connected on ChipWhisperer-Lite.
2 | GND | O | System GND.
3 | +3.3V | O | +3.3V to Target Device, can be turned off, 200mA available.
4 | FPGA-HS1 | I/O | High Speed Input (normally clock in).
5 | PROG-RESET | I/O | Target RESET Pin (AVR Programmer).
6 | FPGA-HS2 | I/O | High Speed Output (normally clock or glitch out).
7 | PROG-MISO | I/O | SPI input: MISO (for SPI + AVR Programmer).
8 | VTarget | I | Drive this pin with desired I/O voltage in range 1.5V-5V.
9 | PROG-MOSI | I/O | SPI output: MOSI (for SPI + AVR Programmer).
10 | FPGA-TARG1 | I/O | TargetIO Pin 1 - Usually UART TX or RX.
11 | PROG-SCK | I/O | SPI output: SCK (for SPI + AVR Programmer).
12 | FPGA-TARG2 | I/O | TargetIO Pin 2 - Usually UART RX or TX.
13 | PROG-PDIC | I/O | PDI Programming Clock (XMEGA Programmer), or CS pin (SPI).
14 | FPGA-TARG3 | I/O | TargetIO Pin 3 - Usually bidirectional IO for smartcard.
15 | PROG-PDID | I/O | PDI Programming Data (XMEGA Programmer).
16 | FPGA-TARG4 | I/O | TargetIO Pin 4 - Usually trigger input.
17 | GND | O
18 | +3.3V | O
19 | GND | O
20 | +VUSB (5V) | O | Not Connected on ChipWhisperer-Lite.
