kammoh/fobos/hardware/fobos-dut/dut-spartan7-s15-cpga196/7_Series_Schematic_Review_Recommendations.xlsm

Sheet: Project Info
 | SCHEMATIC REVIEW RECOMMENDATIONS
XMP277 (v1.10) March 30, 2020
Company | GMU CERG
Customer Project | DUT-SPARTAN7-7S15-CPGA196
Customer Contact | Jans Kaps
Review Date | mm-dd-yyyy
Xilinx Reviewers | na
PURPOSE | Conducting schematic reviews to ensure an FPGA design is optimally configured for first-time success is a difficult task. Part of the challenge stems from the many different sources of information that the designer needs to reference, including the device data sheet, family user guide, answer records, errata, etc., as well as the software design tools. This recommendations document provides a template for performing and recording the results of a schematic review.
DISCLAIMER | NOTICE OF DISCLAIMER: The information disclosed to you hereunder (the “Materials”) is provided solely for the selection and use of Xilinx products. To the maximum extent permitted by applicable law: (1) Materials are made available "AS IS" and with all faults, Xilinx hereby DISCLAIMS ALL WARRANTIES AND CONDITIONS, EXPRESS, IMPLIED, OR STATUTORY, INCLUDING BUT NOT LIMITED TO WARRANTIES OF MERCHANTABILITY, NON-INFRINGEMENT, OR FITNESS FOR ANY PARTICULAR PURPOSE; and (2) Xilinx shall not be liable (whether in contract or tort, including negligence, or under any other theory of liability) for any loss or damage of any kind or nature related to, arising under, or in connection with, the Materials (including your use of the Materials), including for any direct, indirect, special, incidental, or consequential loss or damage (including loss of data, profits, goodwill, or any type of loss or damage suffered as a result of any action brought by a third party) even if such damage or loss was reasonably foreseeable or Xilinx had been advised of the possibility of the same. Xilinx assumes no obligation to correct any errors contained in the Materials or to notify you of updates to the Materials or to product specifications. You may not reproduce, modify, distribute, or publicly display the Materials without prior written consent. Certain products are subject to the terms and conditions of Xilinx’s limited warranty, please refer to Xilinx’s Terms of Sale which can be viewed at at www.xilinx.com/legal.htm#tos; IP cor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
COPYRIGHT | © Copyright 2012–2020 Xilinx, Inc. Xilinx, the Xilinx logo, Artix, ISE, Kintex, Spartan, Virtex, Vivado, Zynq, and other designated brands included herein are trademarks of Xilinx in the United States and other countries. The PowerPC name and logo are registered trademarks of IBM Corp., and used under license. All other trademarks are the property of their respective owners.

Sheet: Instructions
General Instructions to the Reviewer
! | Macros must be enabled for full functionality.
1. | This spreadsheet is intended to provide a list of what has been checked (and what has not been checked) during a customer schematic review. It is not intended to be a comprehensive checklist.
2. | The Project Info page gives an overview of the schematic that is being reviewed and the person(s) performing the review. It also contains the Purpose and Disclaimer paragraphs.
3. | The Checklist pages contain some of the more common items that should be checked. In some cases, these items might not apply to a specific schematic review and can be deleted. In other cases, there might be additional items that need to be checked. In that case, the user can add a line to the end of the worksheet.
4. | In several cells, there are Xilinx recommendations containing question marks (e.g., ? of ?? mF cap ). The question marks are intended to remind the user to replace the '?' with the appropriate value. In this example, the number of caps and the value of those caps need to be recorded.
5. | The Checklist pages are intended to collect information for a single FPGA and its supporting device (such as a configuration PROM). At the top of the Checklist page, the device part number and reference designator need to be recorded. If there are multiple devices, a workbook should be created for each device.
6. | Each cell in the Status column has a pull-down menu with the color-coded selections OK, CHECK, and PROBLEM. The Status column allows the customer to quickly see the results of the schematic review. · OK: The item receives reviewer approval. · CHECK: The reviewer does not have sufficient information to determine if the item is OK or poses a PROBLEM. The designer must research the item and provide additional information. · PROBLEM: There is an issue with the item. PROBLEM flags the item for the designer, who needs to research the issue and find a solution. · Not Checked: The item has not been checked and might require additional attention. · N/A: The item is not applicable to this device or design.
7. | The Actual Implementation column can be used to provide additional clarification. This information is especially important if the item is tagged with CHECK or PROBLEM.

Sheet: Spartan 7
Spartan 7
Items on the page are related to the following Device and Configuration Mode
Family | Spartan-7
Device | 7S15
Package | CPGA196
Configuration Mode | Slave Serial (and JTAG) (Mode 111)
Configuration Frequency (MHz) | 25.000
Reference Designator | U1
Power Distribution System
Item | Xilinx Recommendation | Actual Implementation | Status | Additional Information | Comments
VCCINT | 1.0V, 0 of 680 uF, 0 of 330 uF, 1 of 100 uF,0 of 47 uF, 2 of 4.7 uF, 2 of 0.47 uF |  |  | 1.0V except for the following: - Artix-7, Kintex-7, and Zynq-7000 parts in the -2LE speed grade can operate with VCCINT=1.0V or 0.9V. - Artix-7 parts in the -1LI speed grade operate at VCCINT=0.95V. - Kintex-7 and Zynq-7000 parts in the -2LI speed grade operate at VCCINT=0.95V. - Zynq-7000 parts in the -1LI speed grade can operate with VCCINT=1.0V or 0.95V.
VCCBRAM | 1.0V, 0 of 100 uF, 1 of 47 uF, 1 of 4.7 uF , 1 of 0.47 uF |  |  | 1.0V except for the following: - Kintex-7 parts in the -2LE speed grade can operate with VCCBRAM=1.0V or 0.9V. - Artix-7 parts in the -1LI speed grade operate with VCCBRAM=0.95V. - Kintex-7 and Zynq-7000 parts in the -2LI speed grade operate at VCCBRAM=0.95V. - Zynq-7000 parts in the -1LI speed grade can operate with VCCBRAM=1.0V or 0.95V.
VCCAUX | 1.8V, 1 of 47 uF, 1 of 4.7 uF, 2 of 0.47 uF
VCCAUX_IO_G# | Does not apply to selected family or device. |  |  | Supply must be run at 2.0V for high-speed memory applications, but only has a ±3% tolerance. See UG586 "Design Guidelines" and family specific data sheet for voltage tolerances. Also see UG471 for more info on VCCAUX_IO grouping.
VCCO Bank 0 | 1.5V - 3.3V, 1 of 47uF |  |  | VCCO_0 supports 1.5V - 3.3V, except Virtex-7 HT FPGAs support only VCCO_0=1.8V. Make sure that the VCCO_0 matches the voltage level of the JTAG and serial configuration signals. Ensure CFGBVS pin connection is compatible with VCCO_0 voltage. See the "Configuration Banks Voltage Select" section of UG470, 7 Series FPGAs Configuration User Guide for more information.
VCCO Bank 14 | 1.2V - 3.3V, 1 of 47 uF or 100 uF (can be shared by up to 4 banks when powered by the same voltage), 2 of 4.7 uF, 4 of 0.47 uF |  |  | Recommend VCCO_14, VCCO_0, JTAG signals, and serial signals are the same voltage level. See UG470, 7-Series FPGAs Configuration User Guide, for voltage limitations on specific device families. Make sure that VCCO_14 matches the VCCO of the serial configuration source. IMPORTANT! For Artix-7 and Kintex-7 and serial configuration mode, if VCCO_14 is 1.8V or 1.5V, then VCCO_0 must also be 1.8V or 1.5V, and CFGBVS must be connected to GND.
VCCO Bank 15 | 1.2V - 3.3V, 1 of 47 uF or 100 uF (can be shared by up to 4 banks when powered by the same voltage), 2 of 4.7 uF, 4 of 0.47 uF
HR banks 14,34 | 1.2V - 3.3, 1 of 47 uF or 100 uF per 4 banks (when powered by the same voltage) and 2 of 4.7 uF, 4 of 0.47 uF per bank |  |  | Make sure voltages are consistent with I/O standard selections. Due to the architectural differences between banks 14/15 (and banks 11, 12, 17, 18, 20 and 21 for SSI devices) and other banks, special consideration must be taken when using them under certain conditions. See the "State of I/Os During and After Configuration" and the "Special DCI Requirements in Some Banks" sections of UG471, 7 Series FPGAs SelectIO Resources User Guide for details.
HP banks N/A (No VCCAUX_IO groups) | There are no HP banks in this device. |  |  | Make sure voltages are consistent with I/O standard selections. Due to the architectural differences between banks 14/15 (and banks 11, 12, 17, 18, 20 and 21 for SSI devices) and other banks, special consideration must be taken when using them under certain conditions. See the "State of I/Os During and After Configuration" and the "Special DCI Requirements in Some Banks" sections of UG471, 7 Series FPGAs SelectIO Resources User Guide for details.
VREF | Connect to the appropriate voltage if the input standard requires a reference voltage. VREF supply stabilization requires one capacitor per pin; values are in the 0.022 µF—0.47 µF range. If internal VREF is used no capacitor is required and the pin can be used as I/O.
RSVDGND | Connect to ground
Device Migration | 7S6-CPGA196,,,,, |  |  | These are the devices that are pin compatible with the device that was chosen.
VCCO of unused I/O banks | Connect to VCCAUX or any available VCCO, but do not require decoupling. If you plan on migration, connect the unbounded I/O banks to the appropriate VCCO supplies. Make sure the voltage limits are followed for the HR and HP I/O's. |  |  | See AR #11906.
Power-up/down Sequence | VCCINT, VCCAUX, VCCO |  |  | See Power Sequencing in data sheet.
Power Supply Ramp Time | 200 µS < VCCINT ramp < 50 mS 200 µS < VCCAUX ramp < 50 mS 200 µS < VCCO ramp < 50 mS 200 µS < VCCBRAM ramp < 50 mS 200 µS < VCCAUX_IO ramp < 50 mS 200 µS < MGTAVCC ramp < 50 mS 200 µS < MGTAVTT ramp < 50 mS 200 µS < MGTVCCAUX ramp < 50 mS VCCO2VCCAUX < 300 mS @ TJ 125C VCCO2VCCAUX < 500 mS @ TJ 100C VCCO2VCCAUX < 800 mS @ TJ 85C |  |  | See the "Power Supply Ramp Time" table in the family data sheet for details.
Configuration
General Comments: | See User Guide 470. See the 'Configuration Memory Devices' appendix in UG908 for a list of flash memory devices supported by Vivado Device Programmer, and select a flash memory that can fit at least the Bitstream Length shown in this sheet. | UG470 (http://www.xilinx.com/support/documentation/user_guides/ug470_7Series_Config.pdf)
Item | Xilinx Recommendation | Actual Implementation | Status | Additional Information | Comments
CFGBVS | Insufficient or incorrect data selection: Check family, Configuration Mode, and Bank0 Voltage. |  |  | Configuration Banks Voltage Select Dedicated input pin referenced to VCCO_0. CAUTION! CFGBVS must be tied to GND or VCCO_0 according to the VCCO_0 voltage to avoid device damage: - Connect CFGBVS=GND when VCCO_0 is 1.8V or 1.5V. - Connect CFGBVS=VCCO_0 when VCCO_0 is 3.3V or 2.5V. CFGBVS determines the I/O voltage operating range and voltage tolerance for the dedicated bank 0 at all times in all 7 series devices, except for Virtex-7 HT devices where CFGBVS is not available because bank 0 supports only 1.8V operation. For Artix-7 and Kintex-7 FPGAs, CFGBVS also determines the I/O voltage operating range and tolerance for the multi-purpose HRIO bank 14 and HRIO bank 15 prior to and during configuration. See the "Configuration Banks Voltage Select" section of UG470, 7 Series FPGAs Configuration User Guide for more information.
M[2:0] | Connect each mode pin either directly or via a 1 kΩ (or stronger) resistor to VCCO_0 or GND. M[2:0] = 111 |  |  | Configuration Mode Dedicated input pins referenced to VCCO_0. M[2:0] determines the configuration mode. For the configuration mode settings, see the 7 Series FPGA Configuration Modes table in the "Configuration Interfaces" chapter of UG470, 7-Series FPGAs Configuration User Guide.
TCK | Connect to the JTAG cable header's TCK output signal. For the Xilinx 14-pin JTAG ribbon cable header, TCK is pin 6. |  |  | IEEE Std 1149.1 (JTAG) Test Clock for all devices on a JTAG chain. Dedicated input pin referenced to VCCO_0. Treat as a critical clock signal. For multiple device JTAG chains, buffer or voltage translate the TCK signal as necessary. If the TCK signal is buffered, connect the buffer input to an external weak (e.g., 10 kΩ) pull-up resistor to maintain a valid High when no cable is connected.
TMS | Connect to the JTAG cable header's TMS output signal. For the Xilinx 14-pin JTAG ribbon cable header, TMS is pin 4. |  |  | JTAG Test Mode Select Mode select for all devices on a JTAG chain. Dedicated input pin referenced to VCCO_0. For multiple device JTAG chains, buffer or voltage translate the TMS signal as necessary. If the TMS signal is buffered, connect the buffer input to an external weak (e.g., 10 kΩ) pull-up resistor to maintain a valid High when no cable is connected.
TDI | For an isolated device or for the first device in a JTAG chain, connect TDI to the JTAG cable header's TDI output signal. Otherwise, when the FPGA is not the first device in a JTAG chain, connect to the TDO pin of the upstream JTAG device in the JTAG scan chain. For the Xilinx 14-pin JTAG ribbon cable header, TDI is pin 10. |  |  | JTAG Test Data Input. Dedicated input pin referenced to VCCO_0. JTAG data is serially daisy chained from device to device via the device TDI and TDO pins. The Xilinx cable TDI signal drives the data to the TDI pin of the first device. Data is output from the first device's TDO pin to the next device's TDI pin. Finally, the last device's TDO pin is driven back to the Xilinx cable's TDO signal. The TDI input signal to the FPGA might need voltage translation when the upstream device TDO or cable header output is not voltage-compatible with the FPGA TDI input.
TDO | For an isolated device or for the last device in a JTAG chain, connect TDO to the JTAG cable header's TDO input signal. Otherwise, when the FPGA is not the last device in a JTAG chain, connect to the TDI pin of the downstream JTAG device in the JTAG scan chain. For the Xilinx 14-pin JTAG ribbon cable header, TDO is pin 8. |  |  | JTAG Test Data Output. Dedicated three-state output pin referenced to VCCO_0. JTAG data is serially daisy chained from device to device via the device TDI and TDO pins. The Xilinx cable TDI signal drives the data to the TDI pin of the first device. Data is output from the first device's TDO pin to the next device's TDI pin. Finally, the last device's TDO pin is driven back to the Xilinx cable's TDO signal. The TDO output signal from the FPGA might need voltage translation when the downstream device TDI or cable header input is not voltage-compatible with the FPGA TDO output.
PROGRAM_B | Connect PROGRAM_B to an external 4.7 kΩ (or stronger) pull-up resistor to VCCO_0 to ensure a stable High input, and recommend push-button to GND to enable manual configuration reset. |  |  | Program (bar) Dedicated input pin referenced to VCCO_0. Active-Low reset input to configuration logic. When PROGRAM_B is pulsed Low, the FPGA configuration is cleared and a new configuration sequence is initiated. Configuration reset is initiated upon falling edge, and configuration (i.e., programming) sequence begins upon the following rising edge. Note: If the power-on configuration sequence must be delayed, use INIT_B to delay the power-on configuration sequence.
INIT_B | Connect INIT_B to a 4.7 kΩ (or stronger) pull-up resistor to VCCO_0 to ensure clean Low-to-High transitions. |  |  | Initialization (bar) Active-Low FPGA initialization pin or configuration error signal. Dedicated open-drain output and input pin referenced to VCCO_0. The FPGA drives this pin Low when the FPGA is in a configuration reset state, when the FPGA is initializing (clearing) its configuration memory, or when the FPGA has detected a configuration error. Upon completing the FPGA initialization process, INIT_B is released to high impedance, at which time an external resistor is expected to pull INIT_B High. INIT_B can externally be held Low during power-up to stall the power-on configuration sequence at the end of the initialization process. When a High is detected at the INIT_B input after the initialization process, the FPGA starts the configuration sequence dictated by the M[2:0] pin settings. Use the INIT_B signal to reset configuration memories during FPGA configuration initialization.
DONE | Connect DONE to an external 330Ω pull-up resistor to VCCO_0. |  |  | Done Dedicated bidirectional pin referenced to VCCO_0. A High signal on the DONE pin indicates completion of the configuration sequence. The DONE output is an open-drain output by default. Note: DONE has an internal pull-up resistor of approximately 10 kΩ. There is no setup/hold requirement for the DONE register. These changes, along with the DonePipe register software default, eliminate the need for the DriveDONE driver-option. For more details on the need for an external pull-up, see AR# 44237, AR# 44103 and AR# 62972. If multiple devices are to be connected in the same configuration chain, see the "Multiple FPGA Configuration" section of UG470 for guidelines.
PUDC_B | PUDC_B must be tied either directly or via a 1 kΩ (or stronger) resistor to VCCO_14 or GND. |  |  | Pull-Up During Configuration (bar) Multi-purpose pin referenced to VCCO_14. Before and during configuration, PUDC_B is an active-Low input that activates the internal pull-up resistors on the unconfigured SelectIO pins. • When PUDC_B is Low, the internal pull-up resistors are activated on each SelectIO pin. • When PUDC_B is High, internal pull-up resistors are de-activated on each SelectIO pin. Caution! Do not allow this pin to float before and during configuration. After configuration, the PUDC_B pin becomes a user-defined SelectIO. The behavior for all other SelectIO, internal pull-up or otherwise, is defined by the user design for the respective SelectIO pin.
CCLK | Connect CCLK to an external configuration clock source. CCLK is an input that receives the slave serial configuration clock signal. |  |  | Configuration Clock Dedicated output or input depending on the configuration mode pins, referenced to VCCO_0. CCLK runs the synchronous FPGA configuration sequence in all modes except JTAG mode. After configuration, CCLK is ignored and put into a high-impedance state unless the user design drives the CCLK through the STARTUPE2 primitive or the bitstream Persist option is enabled to maintain the SelectMAP configuration interface functionality. Note: Treat CCLK as a critical clock signal to ensure good signal integrity. The FPGA data sheet specifies the maximum CCLK frequency. However, the maximum configuration frequency is dependent on system-level timing between the configuration source and FPGA.
EMCCLK | EMCCLK is ignored in the slave modes and can be left unconnected. |  |  | External Master Configuration Clock Multi-purpose pin referenced to VCCO_14. During a master mode configuration, the bitstream ExtMasterCclk_en option enables the configuration logic to switch to the EMCCLK input as its reference clock source instead of the default internal oscillator. The bitstream ExtMasterCclk_en option also allows the EMCCLK frequency to be divided down before use by the configuration logic. See the Command Line Tools User Guide for the available divider values. During JTAG or a slave configuration mode, the EMCCLK input is ignored. After configuration, EMCCLK becomes a user-defined SelectIO. The FPGA data sheet specifies the absolute maximum EMCCLK input frequency. However, the maximum configuration frequency is dependent on system-level timing between the configuration flash and FPGA. Refer to AR# 44635, 7 Series - EMCCLK considerations to ensure the FPGA completes startup sequence.
CSI_B | CSI_B is ignored and can be left unconnected. |  |  | Chip Select Input (bar) Multi-purpose pin referenced to VCCO_14. Only during SelectMAP mode configuration, CSI_B is an active-Low input that enables the corresponding FPGA's SelectMAP configuration interface. During all non-SelectMAP modes, CSI_B is ignored. After configuration, CSI_B becomes a user-defined SelectIO unless the bitstream Persist option is enabled to maintain the SelectMAP configuration interface functionality.
DOUT_CSO_B | For an upstream device in a serial configuration daisy-chain, connect DOUT to the DIN of the downstream slave-serial FPGA. Otherwise, DOUT_CSO_B is high impedance and can be left unconnected. |  |  | Data Output or Chip Select Output (bar) Multi-purpose pin referenced to VCCO_14. For serial or SPI x1 modes, DOUT is the data output for a serial configuration daisy-chain. (Serial daisy-chaining is NOT supported from a SPIx2 or SPIx4 configuration.) Note: DOUT can output data when the Debug Bitstream option is enabled. For SelectMAP modes and BPI parallel daisy-chains, CSO_B is an active-Low open-drain output that can drive Low to enable the slave SelectMAP configuration interface of the downstream FPGA in a parallel configuration daisy-chain. After configuration, CSO_B becomes a user-defined SelectIO unless the bitstream Persist option is enabled to maintain the SelectMAP configuration interface functionality.
RDWR_B | RDWR_B is ignored and can be left unconnected. |  |  | Read/Write (bar) Multi-purpose pin referenced to VCCO_14. Only during SelectMAP configuration, RDWR_B determines the direction of the SelectMAP data bus. When RDWR_B is High, the FPGA outputs read data onto the SelectMAP data bus. When RDWR_B is Low, an external controller can write data to the FPGA through the SelectMAP data bus. During all non-SelectMAP modes, RDWR_B is ignored. After configuration, RDWR_B becomes a user-defined SelectIO unless the bitstream Persist option is enabled to maintain the SelectMAP configuration interface functionality.
D00_MOSI | D00_MOSI is ignored and kept in a high-impedance state during configuration. It can be left unconnected. |  |  | D[00] (LSB) of a data bus or the SPI bus master-output, slave-input signal. Multi-purpose bidirectional pin referenced to VCCO_14. After configuration, D00_MOSI becomes a user-defined SelectIO unless the bitstream Persist option is enabled to maintain the SelectMAP configuration interface functionality. Note: D00_MOSI is an active signal during iMPACT/Vivado indirect SPI/BPI flash programming.
D01_DIN | Connect D01_DIN to the serial data output pin of the serial data source. |  |  | D[01] of a data bus or serial mode data input. Multi-purpose bidirectional pin referenced to VCCO_14. After configuration, D01_DIN becomes a user-defined SelectIO unless the bitstream Persist option is enabled to maintain the SelectMAP configuration interface functionality. Note: D01_DIN is an active signal during iMPACT/Vivado indirect SPI/BPI flash programming.
D02 | D02 is ignored and can be left unconnected. |  |  | D[02] of a data bus. Multi-purpose bidirectional pin referenced to VCCO_14. After configuration, D02 becomes a user-defined SelectIO unless the bitstream Persist option is enabled to maintain the SelectMAP configuration interface functionality. Note: D02 is an active signal during iMPACT/Vivado indirect BPI flash programming.
D03 | D03 is ignored and can be left unconnected. |  |  | D[03] of a data bus. Multi-purpose bidirectional pin referenced to VCCO_14. After configuration, D03 becomes a user-defined SelectIO unless the bitstream Persist option is enabled to maintain the SelectMAP configuration interface functionality. Note: D03 is an active signal during iMPACT/Vivado indirect BPI flash programming.
D[04-07] | D[04-07] are ignored and can be left unconnected. |  |  | D[04-07] of a data bus. Multi-purpose bidirectional pins referenced to VCCO_14. After configuration, D[04-07] becomes a user-defined SelectIO unless the bitstream Persist option is enabled to maintain the SelectMAP configuration interface functionality. Note: D[04-07] is an active signal during iMPACT/Vivado indirect BPI flash programming.
D[08-15] | D[08-15] are ignored and can be left unconnected. |  |  | D[08-15] of a data bus. Multi-purpose bidirectional pins referenced to VCCO_14. After configuration, D[08-15] becomes a user-defined SelectIO unless the bitstream Persist option is enabled to maintain the SelectMAP configuration interface functionality. Note: D[08-15] is an active signal during iMPACT/Vivado indirect BPI x16 flash programming.
A[00-15]_D[16-31] | A[00-15]_D[16-31] are ignored and can be left unconnected. |  |  | A[00-15] of the BPI address bus or D[16-31] of a SelectMAP data bus. Multi-purpose bidirectional pins referenced to VCCO_14. In BPI mode, A[00-15] pins output addresses to a BPI flash. A00 is the least significant bit of the address bus. In SelectMAP mode, a subset or all of the D[00-31] pins are the bidirectional data bus interface. After configuration, A[00-15]_D[16-31] becomes a user-defined SelectIO unless the bitstream Persist option is enabled to maintain the SelectMAP configuration interface functionality. Note: A[00-15] is actively driven during iMPACT/Vivado indirect BPI flash programming.
A[16-28] | A[16-28] are ignored and can be left unconnected. |  |  | A[16-28] of the BPI address bus. Multi-purpose bidirectional pins referenced to VCCO_15. After configuration, A[16-28] becomes a user-defined SelectIO. Note: During BPI configuraiton and during iMPACT/Vivado indirect BPI flash programming, all A[00-28] pins actively output the BPI addresses. Any re-use of these pins must be tolerant of these situations.
FCS_B | FCS_B is high impedance and can be left unconnected. |  |  | Flash Chip Select (bar) Multi-purpose open-drain output pin referenced to VCCO_14. During SPI and BPI configuration and during iMPACT/Vivado indirect programming, FCS_B drives Low to select the flash. After configuration, FCS_B becomes a user-defined SelectIO. Tie to an external pull-up resistor to maintain the flash in a disabled state when the flash is not being used.
FOE_B | FOE_B is high-impedance and can be left unconnected. |  |  | Flash Output-Enable (bar) Multi-purpose open-drain output pin referenced to VCCO_15. During BPI configuration and during iMPACT/Vivado indirect BPI flash programming, FOE_B drives Low to enable the flash data bus output.
FWE_B | FWE_B is high impedance and can be left unconnected. |  |  | Flash Write-Enable (bar) Multi-purpose output pin referenced to VCCO_15. During BPI configuration, FWE_B drives High to keep the BPI flash in read mode. During iMPACT/Vivado indirect BPI flash programming, FWE_B is driven High or Low, depending on the state of the programming operation.
ADV_B | ADV_B is high impedance and can be left unconnected. |  |  | Address Valid (bar) Multi-purpose output pin referenced to VCCO_15. During BPI configuration, ADV_B is driven to control the BPI flash address latch enable (for flash that have an address latch enable input).
RS0, RS1 | RS0 and RS1 are high impedance and can be left unconnected. |  |  | Revision Select Multi-purpose open-drain output pins referenced to VCCO_15. The RS0 and RS1 pins are revision selection output pins that are optionally used during BPI configuration. Normally, RS0 and RS1 are high impedance during configuration. However, the FPGA can drive the RS0 and RS1 pins under two possible conditions: When the bitstream Config Fallback option is enabled, the FPGA drives RS0 and RS1 Low during the fallback configuration process that follows a detected configuration error. When a user-invoked MultiBoot configuration is initiated, the FPGA can drive the RS0 and RS1 pins to a user-defined state during the MultiBoot configuration process. See the Fallback section in UG470 for more details.
JTAG Connector Pinout | Suggest using Xilinx 14-pin ribbon cable header: GND = pins 1, 3, 5, 7, 9, 11, 13; Vref = pin 2; NC = 12, 14; TMS = pin 4; TCK = pin 6; TDO = pin 8; TDI = pin 10. Connect all header GND pins to the ground plane. Connect header Vref pin to same supply as FPGA VCCO_0. Connect header TCK pin to all devices in the JTAG chain. Connect header TMS pin to all devices in the JTAG chain. Connect header TDI pin to the TDI pin of the first device in the JTAG scan chain. Connect header TDO pin to the TDO pin of the last device in the JTAG scan chain. |  |  | See DS593, Platform Cable USB II data sheet. Treat TCK as a critical clock signal. Buffer TCK and TMS as necessary. If TCK, TMS, TDI, and/or TDO are buffered, connect each buffer input to its own 10 KΩ pull-up such that the buffer inputs are held at a valid logic High when the Xilinx cable is not connected to the board (or when TDO is not driving). The IEEE Std 1149.1 (JTAG) allows devices to have an optional active-low TRST (test reset) input. Xilinx devices and cables do not have and do not support the TRST signal. However, third-party devices in the JTAG chain might have TRST pins. Typically, each TRST pin is tied High, or the TRST pins can be left unconnected because the IEEE Std 1149.1 requires undriven TRST inputs to be equivalent to a logical '1' input.
Bitstream Length | 4310752 Bits
Bitstream Programming Time | (Bitstream Length) / (Configuration Clock Rate x Configuration Bus Width) = 172.43 ms |  |  | Power-up time is not included in this calculation.
VCCBATT | If there is no requirement to use the decryptor key from the volatile key storage area, connect this pin to GND or VCCAUX. If the decryptor key is being used, the voltage must be between 1.0V and 1.89V. |  |  | Battery Backup Supply VCCBATT is the battery backup supply for the FPGA's internal volatile memory that stores the key for the AES decryptor. For encrypted bitstreams that require the decryptor key from the volatile key memory area, connect this pin to a battery to preserve the key when the FPGA is unpowered.
1. Each I/O is referenced to the VCCO supply voltage for the bank in which the I/O is located. For example "0", indicates the I/O is referenced to Bank 0's VCCO_0.
XADC
General Comments: | See User Guide 480 (http://www.xilinx.com/support/documentation/user_guides/ug480_7Series_XADC.pdf)
Item | Xilinx Recommendation | Actual Implementation | Status | Additional Information | Comments
VCCADC_0 | This pin can be tied to the 1.8V VCCAUX supply. However, in a mixed-signal system the supply should be connected to a separate 1.8V analog, if available. See the "Analog Power Supply and Ground (VCCADC and GNDADC)" section of UG480, 7 Series FPGAs XADC Dual 12-Bit 1MSPS Analog-to-Digital Converter User Guide for more information. This pin should never be tied to GND. The pin should be tied to VCCAUX even if the XADC is not being used. A 100 nF decoupling capacitor should be placed between VCCADC and GNDADC as close to the FPGA package balls as possible. |  |  | This is the analog supply pin for the ADCs and other analog circuits in the XADC.
GNDADC_0 | This pin can be tied to the system ground via an isolating ferrite bead. In a mixed-signal system this pin should be tied to an analog ground plane if available, in which case the ferrite bead is not required. See the "Analog Power Supply and Ground (VCCADC and GNDADC)" section of UG480, 7 Series FPGAs XADC Dual 12-Bit 1MSPS Analog-to-Digital Converter User Guide for more information. This pin should always be tied to GND even if the XADC is not being used. |  |  | This is the ground reference pin for the ADCs and other analog circuits in the XADC.
VREFP_0 | This pin should be tied to an external 1.25V accurate reference source (±0.2%) for best performance of the ADCs. It should be treated as an analog signal that together with the VREFN_0 signal provides a differential 1.25V voltage. By connecting this pin to GNDADC, an on-chip reference source (±1%) is activated. This pin should always be connected to GNDADC if an external reference is not supplied. A 100 nF decoupling capacitor should be placed between VREFP_0 and GNDADC as close to the FPGA package balls as possible. |  |  | 0
VREFN_0 | This pin should be tied to the GND pin of an external 1.25V accurate reference source (±0.2%) for best performance of the ADCs. It should be treated as an analog signal that together with the VREFP_0 signal provides a differential 1.25V voltage. This pin should always be connected to GNDADC even if an external reference is not supplied.
VP_0 | This is the positive input terminal of the dedicated differential analog input channel (VP/VN). The analog input channels are very flexible and support multiple analog input signal types. This pin should be connected to GND if not used.
VN_0 | This is the negative input terminal of the dedicated differential analog input channel (VP/VN). The analog input channels are very flexible and support multiple analog input signal types.This pin should be connected to GND if not used.
AD0P to AD15P | These are multi-function pins that can support analog inputs or can be used as regular digital I/O. These pins support up to 16 positive input terminals of the differential auxiliary analog input channels (VAUXP/VAUXN). The analog input channels are very flexible and support multiple analog input signal types. When not being used as analog inputs, these pins can be treated like any other digital I/O. |  |  | Auxiliary channels 6, 7, 13, 14, and 15 are not supported on Kintex-7 devices.
AD0N to AD15N | These are multi-function pins that can support analog inputs or can be used as regular digital I/O. These pins support up to 16 negative input terminals of the differential auxiliary analog input channels (VAUXP/VAUXN). The analog input channels are very flexible and support multiple analog input signal types. When not being used as analog inputs, these pins can be treated like any other digital I/O. |  |  | Auxiliary channels 6, 7, 13, 14, and 15 are not supported on Kintex-7 devices.
General Comments: | See User Guide 476 (http://www.xilinx.com/support/documentation/user_guides/ug476_7Series_Transceivers.pdf)
Item | Xilinx Recommendation | Actual Implementation | Status | Additional Information | Comments
No GTs exist in this device. | No GTs exist in this device. |  |  | No GTs exist in this device.
No GTs exist in this device. | No GTs exist in this device. |  |  | No GTs exist in this device.
No GTs exist in this device. | No GTs exist in this device. |  |  | No GTs exist in this device.
No GTs exist in this device. | No GTs exist in this device. |  |  | No GTs exist in this device.
No GTs exist in this device. | No GTs exist in this device. |  |  | No GTs exist in this device.
No GTs exist in this device. | No GTs exist in this device. |  |  | No GTs exist in this device.
No GTs exist in this device. | No GTs exist in this device. |  |  | No GTs exist in this device.
No GTs exist in this device. | No GTs exist in this device. |  |  | No GTs exist in this device.
General Comments:
Item | Xilinx Recommendation | Actual Implementation | Status | Additional Information | Comments
No GTZs exist in this device. | No GTZs exist in this device. |  |  | No GTs exist in this device.
No GTZs exist in this device. | No GTZs exist in this device. |  |  | No GTs exist in this device.
No GTZs exist in this device. | No GTZs exist in this device. |  |  | No GTs exist in this device.
No GTZs exist in this device. | No GTZs exist in this device. |  |  | No GTs exist in this device.
No GTZs exist in this device. | No GTZs exist in this device. |  |  | No GTs exist in this device.
No GTZs exist in this device. | No GTZs exist in this device. |  |  | No GTs exist in this device.
No GTZs exist in this device. | No GTZs exist in this device. |  |  | No GTs exist in this device.
No GTZs exist in this device. | No GTZs exist in this device. |  |  | No GTs exist in this device.
No GTZs exist in this device. | No GTZs exist in this device. |  |  | No GTs exist in this device.
No GTZs exist in this device. | No GTZs exist in this device. |  |  | No GTs exist in this device.
No GTZs exist in this device. | No GTZs exist in this device. |  |  | No GTs exist in this device.
No GTZs exist in this device. | No GTZs exist in this device. |  |  | No GTs exist in this device.
No GTZs exist in this device. | No GTZs exist in this device. |  |  | No GTs exist in this device.
No GTZs exist in this device. | No GTZs exist in this device. |  |  | No GTs exist in this device.
No GTZs exist in this device. | No GTZs exist in this device. |  |  | No GTs exist in this device.
No GTZs exist in this device. | No GTZs exist in this device. |  |  | No GTs exist in this device.
Other Items
Item | Xilinx Recommendation | Actual Implementation | Status | Additional Information | Comments
MRCC | When connecting a single-ended clock to the differential CC pair of pins, it must be connected to the positive (P) side of the pair. The MRCC (multi-region) pins, when used as single region resource, can drive four BUFIOs and four BUFR in a single bank. Clocking resources in each region are limited, so careful planning must be done to insure the resources are sufficient when connecting multiple clock inputs to a single region. When implementing a source-synchronous interface, it is recommended that clock signals enter the same bank as the data signals or an adjacent bank using MRCC pins. This applies to interfaces spanning multiple banks as well. |  |  | These are the clock capable I/Os driving BUFRs, BUFIOs, BUFGs, and MMCMs/PLLs. In addition, these pins can drive the BUFMR for multi-region BUFIO and BUFR support. These pins become regular user I/Os when not needed as a clock.
SRCC | When connecting a single-ended clock to the differential CC pair of pins, it must be connected to the positive (P) side of the pair. The SRCC (single region) pins can drive four BUFIOs and four BUFRs in a single bank. Clocking resources in each region are limited, so careful planning must be done to insure the resources are sufficient when connecting multiple clock inputs to a single region. |  |  | These are the clock capable I/Os driving BUFRs, BUFIOs, and MMCMs/PLLs. These pins become regular user I/Os when not needed for clocks.
VRN | VRN is pulled High with a reference resistor, the value of reference resistor is dependent on the DCI I/O Standard used in the bank. VRN functionality does not apply to HR banks. NOTE: resistor values have changed from prior generations. |  |  | NOTE: resistor values have changed from prior generations. This pin is for the DCI voltage reference resistor of N transistor (per bank, to be pulled High with reference resistor). See the 7 series FPGA DCI sections in UG471: 7 Series FPGAs SelectIO Resources User Guide for more information on the VRN/VRP pins.
VRP | VRP is pulled Low with a reference resistor, the value of reference resistor is dependent on the DCI I/O Standard used in the bank. VRP functionality does not apply to HR banks. NOTE: resistor values have changed from prior generations. |  |  | NOTE: resistor values have changed from prior generations. This pin is for the DCI voltage reference resistor of N transistor (per bank, to be pulled High with reference resistor). See the 7 series FPGA DCI sections in UG471: 7 Series FPGAs SelectIO Resources User Guide for more information on the VRN/VRP pins.
DXP_0, DXN_0 | When not used, tie to GND. See UG475, 7 Series FPGAs Packaging and Pinout Specification for more information and AR#5738 for implementation examples. |  |  | Temperature-sensing diode pins (Anode: DXP; Cathode: DXN). The thermal diode is accessed by using the DXP and DXN pins in bank 0.
DCI cascading | If you are using DCI Cascade then see UG471, 7 Series FPGAs SelectIO Resources User Guide. Make sure the DCI Cascade rules are followed. |  |  | Note for ISE users: When running BitGen via a command line or script, the .pcf file must be included. The .pcf file is read into BitGen to include the DCI_CASCADE attributes. From Project Navigator, the .pcf file is automatically included during BitGen because it has the same name as the design name.
3.3V level translation | See XAPP520, Interfacing 7 Series FPGAs High-Performance I/O Banks with 2.5V and 3.3V I/O Standards for 3.3V translation solutions. |  |  | HP I/O support 1.2V, 1.5V, and 1.8V I/O standards.
I/O Standard Compatibility | Run DRC with Vivado.
SSO Analysis | Run SSN Analysis with Vivado using the report_ssn command.
MIG | Use MIG tool to verify pin placement rules.
HR memory termination | The HR I/O have uncalibrated termination for HSTL and SSTL standards built in. Therefore, external termination is not necessary.
General Comments: | See Zynq Documentation Site (http://www.xilinx.com/products/silicon-devices/soc/zynq-7000.html)
Item | Xilinx Recommendation | Actual Implementation | Status | Additional Information | Comments
RSVDVCC | Does not apply to selected family.
RSVDGND | Does not apply to selected family.
VCCO_MIO0 | Does not apply to selected family.
VCCO_MIO1 | Does not apply to selected family.
VCCO_DDR | Does not apply to selected family.
VCCPINT | Does not apply to selected family.
VCCPAUX | Does not apply to selected family.
VCCPLL | Does not apply to selected family.
PS_DDR_VREF0 PS_DDR_VREF1 | Does not apply to selected family.
VTT | Does not apply to selected family.
PS_MIO_VREF | Does not apply to selected family.
Power-On/Off Sequence | Does not apply to selected family.
Power Supply Ramp Time | Does not apply to selected family.
General Comments: | See Zynq Documentation Site (http://www.xilinx.com/products/silicon-devices/soc/zynq-7000.html)
Item | Xilinx Recommendation | Actual Implementation | Status | Additional Information | Comments
PS_CLK | Does not apply to selected family.
PS_POR_B PS power-on reset | Does not apply to selected family.
PS_SRST_B PS system reset | Does not apply to selected family.
vmode [1:0] = MIO[8:7] I/O bank voltage | Does not apply to selected family.
BOOT_MODE[3] = MIO[2] JTAG mode | Does not apply to selected family.
BOOT_MODE[2:0] = MIO[5:3] Boot devices | Does not apply to selected family.
BOOT_MODE[4] = MIO[6] PLL mode | Does not apply to selected family.
CASCADED JTAG | Does not apply to selected family.
INDEPENDENT JTAG | Does not apply to selected family.
Note: PUDC_B | Does not apply to selected family.
General Comments: | See Zynq Documentation Site (http://www.xilinx.com/products/silicon-devices/soc/zynq-7000.html)
Item | Xilinx Recommendation | Actual Implementation | Status | Additional Information | Comments
DDR Termination | Does not apply to selected family.
DDR_CK_P DDR_CK_N | Does not apply to selected family.
DDR topology | Does not apply to selected family.
PS_DDR_VRP | Does not apply to selected family.
PS_DDR_VRN | Does not apply to selected family.
DDR ZQ Pin | Does not apply to selected family.
LPDDR2 simulation | Does not apply to selected family.
MIO Interface Type | MIO Pin Selection
IIC0
IIC1
SPI0
SPI1
CAN0
CAN0 CLK
CAN1
CAN1 CLK
UART0
UART1
TTC0
TTC1
SWDT
PJTAG
TRACE CTRL
TRACE
SDIO0
SDIO1
SDIO0 POWER
SDIO1 POWER
SDIO0 WP
SDIO0 CD
SDIO1 WP
SDIO1 CD
ETHERNET0
ETHERNET1
ETHERNET MDIO
QSPI0 1BIT
QSPI0 2BIT
QSPI0 4BIT
QSPI1 1BIT
QSPI1 2BIT
QSPI1 4BIT
QSPI CS
QSPI FEEDBACK CLK
USB0
USB1
NOR/SRAM
NAND 8BIT
NAND 16BIT
Item | Does not apply to selected family. | Actual Implementation | Status | Additional Information | Comments
MIO0 | Does not apply to selected family.
MIO1 | Does not apply to selected family.
MIO2 | Does not apply to selected family.
MIO3 | Does not apply to selected family.
MIO4 | Does not apply to selected family.
MIO5 | Does not apply to selected family.
MIO6 | Does not apply to selected family.
MIO7 | Does not apply to selected family.
MIO8 | Does not apply to selected family.
MIO9 | Does not apply to selected family.
MIO10 | Does not apply to selected family.
MIO11 | Does not apply to selected family.
MIO12 | Does not apply to selected family.
MIO13 | Does not apply to selected family.
MIO14 | Does not apply to selected family.
MIO15 | Does not apply to selected family.
MIO16 | Does not apply to selected family.
MIO17 | Does not apply to selected family.
MIO18 | Does not apply to selected family.
MIO19 | Does not apply to selected family.
MIO20 | Does not apply to selected family.
MIO21 | Does not apply to selected family.
MIO22 | Does not apply to selected family.
MIO23 | Does not apply to selected family.
MIO24 | Does not apply to selected family.
MIO25 | Does not apply to selected family.
MIO26 | Does not apply to selected family.
MIO27 | Does not apply to selected family.
MIO28 | Does not apply to selected family.
MIO29 | Does not apply to selected family.
MIO30 | Does not apply to selected family.
MIO31 | Does not apply to selected family.
MIO32 | Does not apply to selected family.
MIO33 | Does not apply to selected family.
MIO34 | Does not apply to selected family.
MIO35 | Does not apply to selected family.
MIO36 | Does not apply to selected family.
MIO37 | Does not apply to selected family.
MIO38 | Does not apply to selected family.
MIO39 | Does not apply to selected family.
MIO40 | Does not apply to selected family.
MIO41 | Does not apply to selected family.
MIO42 | Does not apply to selected family.
MIO43 | Does not apply to selected family.
MIO44 | Does not apply to selected family.
MIO45 | Does not apply to selected family.
MIO46 | Does not apply to selected family.
MIO47 | Does not apply to selected family.
MIO48 | Does not apply to selected family.
MIO49 | Does not apply to selected family.
MIO50 | Does not apply to selected family.
MIO51 | Does not apply to selected family.
MIO52 | Does not apply to selected family.
MIO53 | Does not apply to selected family.
Note: All skew numbers refer to matching on the PCB. There is no need to incorporate the package when deskewing.
Customer Items

Sheet: Revision History
Revision History
Date | Version | Revision
2012-10-04 | 1.0 | - Initial Draft
2012-10-22 | 1.1 | - Added ability to add or remove checklist sheets
 |  | - Added XC7VX690T-FFG1158 support
 |  | - Changed connection recommendation for unused MGT receive pins
 |  | - Removed XC7V1500T and XC7A350T
 |  | - Added to MRCC and SRCC recommendations
 |  | - Added to VRN and VRP recommendations
 |  | - Added 7VX1140T-FLG1926 support
 |  | - Added 7A200T-SBG484 support
 |  | - Updated recommendations for MGT pins to show document titles
 |  | - Changed capacitor recommendations for MGT pins
2013-04-24 | 1.2 | - Added support for 7Z030, 7Z045, and 7Z100 devices
 |  | - Corrected error in ETHERNET0/ETHERNET1 MIO interface
 |  | - Changed recommendation for PS_DDR_CKE termination
 |  | - Changed recommendation for PS_MIO_VREF
 |  | - Changed MGTAVCC_N/S to MGTAVCC_G(N)
 |  | - Updated decoupling capacitor recommendation to match user guide
 |  | - Added NAND 8BIT MIO interface
 |  | - Added pins to QSPI MIO interfaces
 |  | - Updated color scheme
 |  | - Added recommendations for MIO interface pins
 |  | - Updated recommendations for all MIO interface pins (changed 50 ps to 9 ps)
 |  | - Changed recommendation for VCCPLL
 |  | - Moved recommendations for PS_DDR pins to the PS_DDR section
 |  | - Changed VCCBATT maximum voltage to 1.89 V
 |  | - Updated Zynq-7000 decoupling capacitor recommendations for VCCo
 |  | - Changed configuration mode for Zynq-7000
 |  | - Updated PS_MIO_VREF recommendations
 |  | - Updated Ethernet MIO interface pin recommendations
2013-09-19 | 1.3 | - Added support for 7VH580T and 7VH870T devices
 |  | - Added support for CLG485 package for 7Z015 device
 |  | - Added support for SBG485 package for 7Z030 device
 |  | - Added decoupling capacitor values for SBG484 package for 7A200T device
 |  | - Added to power supply ramp time
 |  | - Fixed reversal of IIC clock and data MIO pin numbers
 |  | - Added section for MGTZ recommendations
 |  | - Added function to hide sections that are not used by selected family/device/package
 |  | - Added support for 7A35T, 7A50T, and 7A75T devices
 |  | - Updated recommendation for Zynq DDR Termination
 |  | - Added support for CLG225 package for 7Z010 device
 |  | - Updated CFGBVS recommendations as per AR # 57045
 |  | - Replaced all instances of "Transciever" with "Transceiver"
 |  | - Updated skew requirements for IIC, SDIO and QSPI interfaces for Zynq
2014-03-07 | 1.4 | - Fixed issue with selecting 7VH580T-HCG1931
 |  | - Changed VCCO_14 to VCCO_34 in PUDC_B recommendation for Zynq-7000
 |  | - Fixed typo in PS_SRST_BPS recommendation
 |  | - Set rows previously showing "Does not apply to selected family" for Zynq to hidden
 |  | - Added pointer to user guide for Zynq power supply section
 |  | - Added pointer to user guide for Bank 14 VCCO recommendation
 |  | - Updated DDR Termination recommendations
 |  | - Updated DDR Topology recommendations
 |  | - Updated Zynq-7000 decoupling capacitor recommendations
 |  | - Added support for the CSG236 and CSG325 package for 7A35T and 7A50T
 |  | - Changed reference to VCCO_14 in PUDC to VCCO_34 for Zynq-7000
 |  | - Added to additional info for EMCCLK
 |  | - Updated VCCO decoupling recommendations
 |  | - Updated Zynq-7000 power supply decoupling recommendations
 |  | - Updated reference in M[2:0] additional information section
 |  | - Updated additional information and voltage implementation selections for VCCO_0
2014-03-25 | 1.4.1 | - Corrected typographical error in Project Info sheet.
2014-04-10 | 1.4.2 | - Corrected error in formula for FTG256 package power supply decoupling recommendations
2015-03-26 | 1.5 | - Added support for 7A15T and 7Z035 Devices
 |  | - Changed pullup resistor value for PJTAG MIO interface
 |  | - Updated delay requirement recommendations for Ethernet CCLK MIO pins
 |  | - Added exception for Virtex-7 VCCO_0 voltage recommendation
 |  | - Updated decoupling capacitor recommendation to match user guide
 |  | - Updated additional information for INIT_B for Zynq-7000 parts
 |  | - Removed MGTVCCAUX, MGTAVTTRCAL, VCCAUX_IO, VRP, VRN, and DCI Cascading recommendations for non-applicable Zynq-7000 and Artix-7 parts
 |  | - Removed VCCBRAM for 7Z010-CLG225
 |  | - Updated the I/O Standard Compatibility and SSO Analysis recommendations
 |  | - Added a note to CAN and USB MIO interfaces about RX/TX positions differing between CAN0/USB0 and CAN1/USB1
 |  | - Loosened delay matching recommendations for UART MIO interface pins
 |  | - Corrected typographical error in TMS recommendations
 |  | - Added decoupling recommendation to VCCADC and VREFP_0
 |  | - Added references to answer records for DONE
 |  | - Moved recommendations for DXP_0/DXN_0 from the additional information column to the recommendations column
 |  | - Removed T and T_DQS from the item list
 |  | - Added additional information to MIG
 |  | - Removed reference to BPI Flash in INIT_B recommendations for Zynq
 |  | - Updated additional information for Zynq BOOT_MODE pins
 |  | - Updated additional information for Zynq Independent JTAG field
 |  | - Updated user guide reference for LPDDR2 ZQ pin and moved it to additional information field
 |  | - Moved user guide reference for DDR Termination to additional information field
 |  | - Moved user guide reference for DDR_CK to additional information field
 |  | - Changed LPDDR2 ZQ to DDR ZQ and updated the recommendations
 |  | - Updated the recommendations and additional information for PS_DDR_VRP and PS_DDR_VRN
 |  | - Updated VCCINT additional information
 |  | - Updated VCCBRAM additional information
 |  | - Replaced all instances of iMPACT with iMPACT/Vivado
 |  | - Added a pointer to UG908 for configuration
 |  | - Added a reference to Design Advisory # 63149 for PS_POR_BPS
 |  | - Updated Zynq LPDDR2 recommendation
2016-06-01 | 1.6 | - Added a pointer to I/O transition/DCI restrictions sections in UG471
 |  | - Added references to answer records for DONE
 |  | - Added note to Zynq BOOT_MODE pins to use jumpers/switches for debug
 |  | - Fixed issue where an error message shows after selecting QSPI PSMIO interfaces
 |  | - Added a note to DONE recommendations
 |  | - Updated recommendations for PS_POR_B
 |  | - Updated recommendations for PS_SRST_B
 |  | - Changed CS236 package name to CP236
 |  | - Removed lead-free (G) designator for package codes and added note for package selection field
 |  | - Added input restriction to vmode recommendations
 |  | - Removed 33.333 MHz recommendation for PS_CLK
 |  | - Updated link to UG908
 |  | - Updated links to Zynq-7000 documentation
 |  | - Changed instances of BitGen to bitstream
 |  | - Added reference to UG471 for VCCAUX_IO_G#
 |  | - Added a check for PUDC_B connection for Zynq-7000
2017-07-25 | 1.7 | - Updated PS_POR_B recommendations
 |  | - Updated recommendations for unconnected MGT receivers
 |  | - Removed Tpor from bitstream programming time calculation
 |  | - Added support for 7A12T and 7A25T devices
 |  | - Added support for 7Z007S, 7Z012S and 7Z014S devices
 |  | - Added support for Spartan-7 devices
2017-08-24 | 1.7.1 | - Corrected decoupling capacitor values for 7S50 in CSGA324 and FTGB196 packages
2018-03-12 | 1.8 | - Updated recommendations for USB MIO Interface
 |  | - Updated recommendations for SPI MIO Interface
 |  | - Fixed broken link to UG908
 |  | - Updated VCCAUX_IO decoupling 4.7 uF capacitor number for 7Z035 devices
 |  | - Added reference to AR# 62972 for DONE
 |  | - Changed RSVDGND tieoff recommendation from ground to floating
2018-10-24 | 1.9 | - Separated QSPI_FEEDBACK_CLK from QSPI_CS
 |  | - Fixed error when selecting USB0 or USB1 MIO interfaces
 |  | - Corrected decoupling capacitor values for 7Z035 devices
2020-03-30 | 1.10 | - Added RSVDGND pin for 7A12T device
 |  | - Corrected the description for Note: PUDC_B in the PS Configuration section
 |  | - Added PS boot mode configurations options
 |  | - Clarified additional information for DCI Cascade only applies to ISE users
