kammoh/fobos/oldfobos/temp/mem_buffer/schematics/dual_fifo/FOBOS_mem_schematics.pptx

## Memory Buffer

Slide 1 = Interface between Datapath and Controller
Slide 2 = Controller Logic

## Slide 2

Datapath “TOP”

Controller
