kammoh/fobos/docs/source/figures/aes-traces-example.pdf

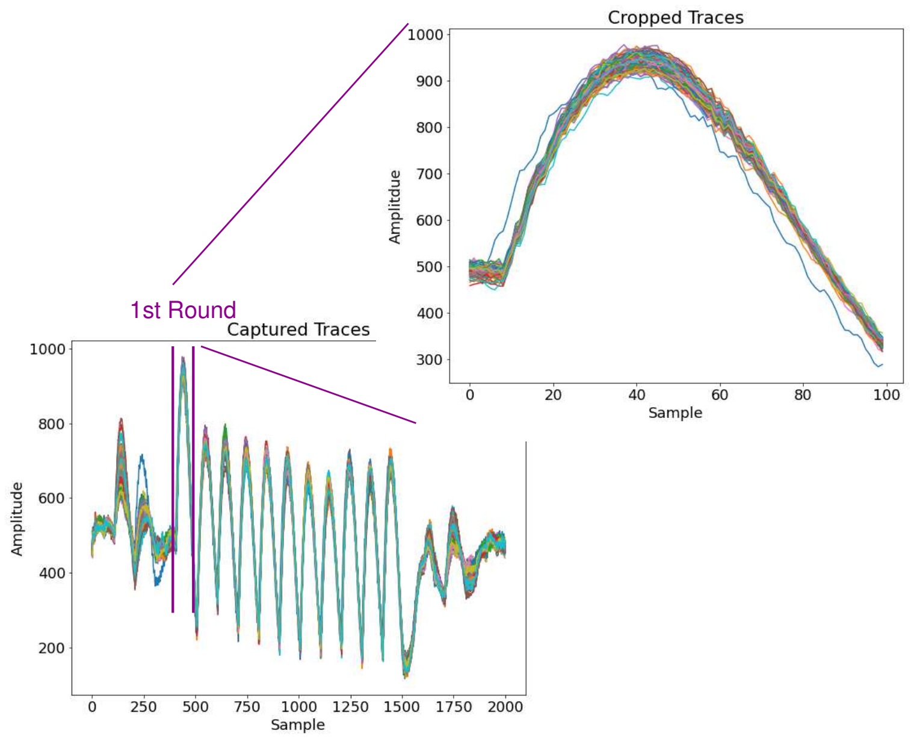
[picture p69: page 1]

1st Round
