kammoh/fobos/oldfobos/doc/figures/DUT_interface.pdf

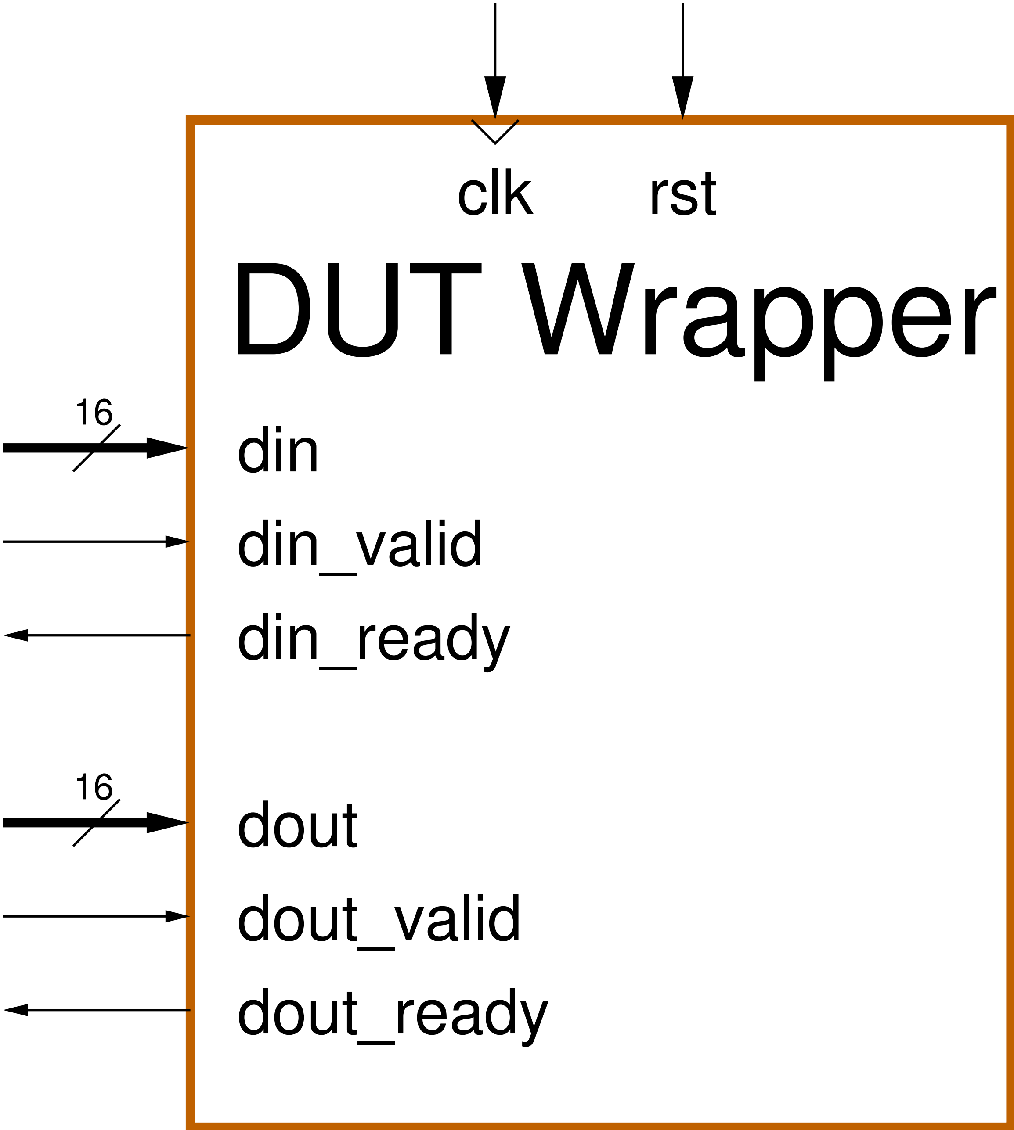
[picture p70: figure]
clk; rst; din; din_valid; din_ready; dout; dout_valid; dout_ready; DUT Wrapper
