kammoh/fobos/docs/source/figures/ctrl-dut_connections.pdf

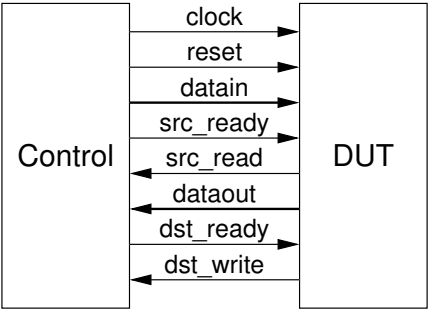
[picture p71: figure]
Control; DUT; src_ready src_read; dst_ready dst_write; clock reset datain; dataout
