kammoh/fobos/oldfobos/doc/figures/oscilloscope-all-4ch.pdf

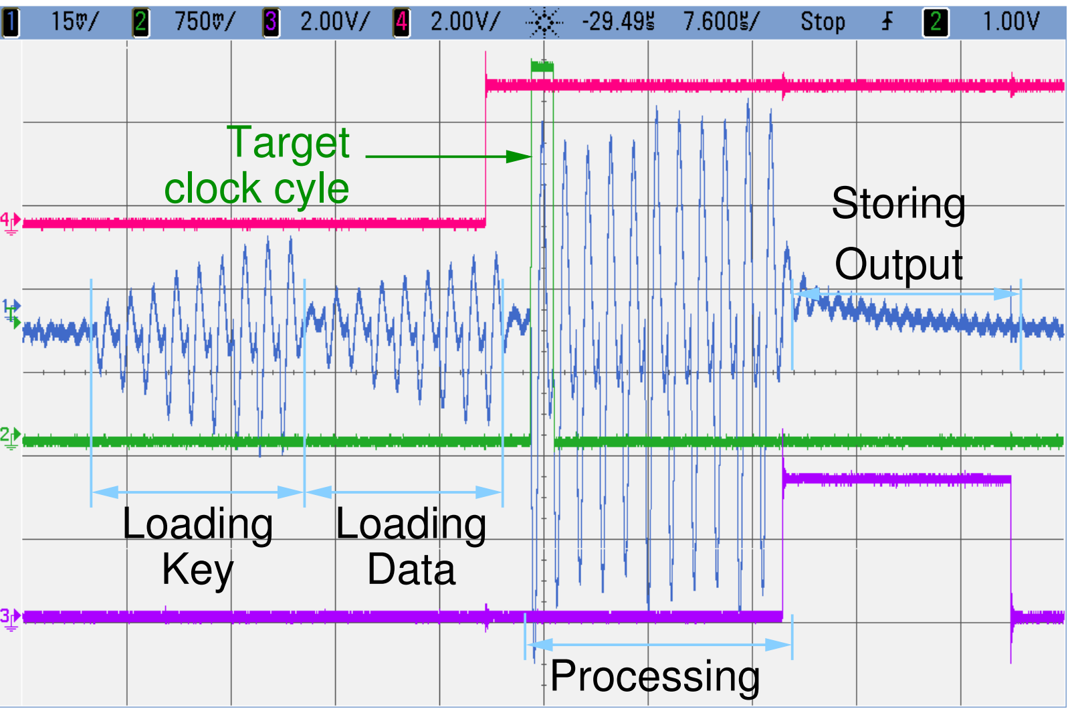
[picture p72: page 1]

Output

Storing

Target
clock cyle

Loading
Data

Loading
Key

Processing
