kammoh/fobos/oldfobos/doc/figures/oscilloscope-compression-window-new.pdf

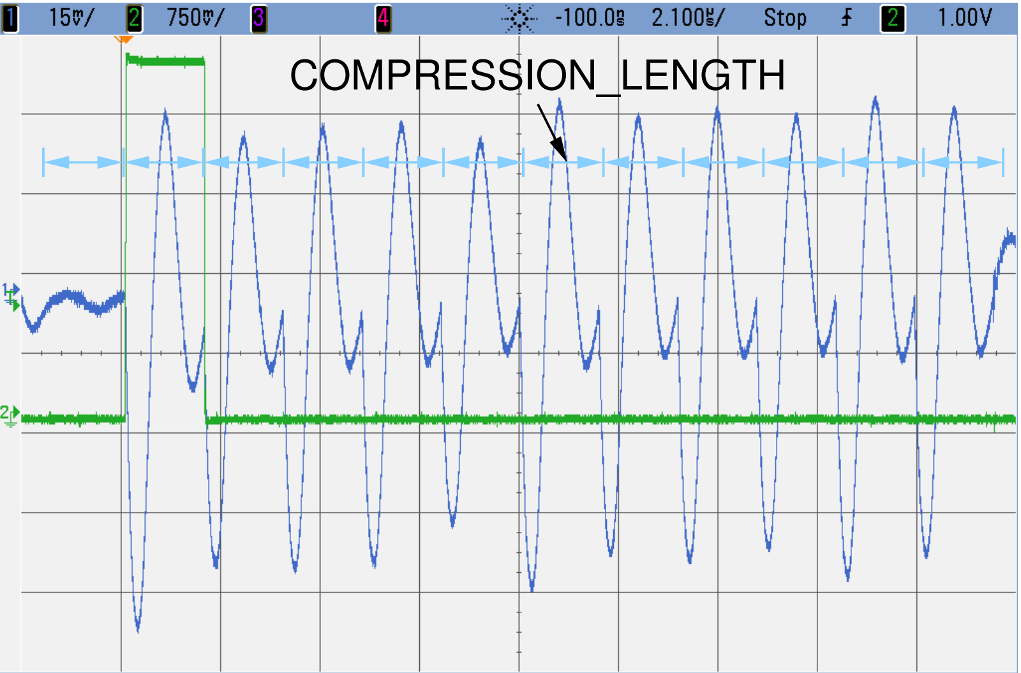
[picture p73: page 1]

COMPRESSION_LENGTH
