kammoh/fobos/docs/source/figures/add_config_mem.png

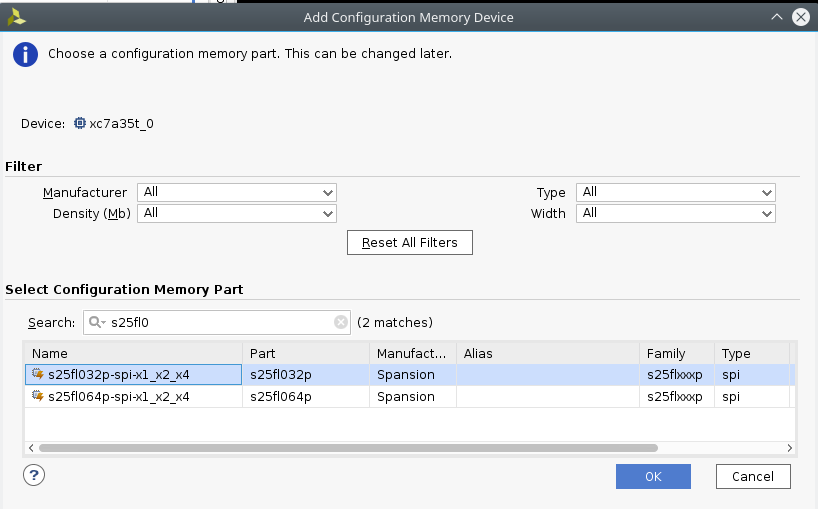
docs/source/figures/add_config_mem.png
