kammoh/fobos/docs/source/figures/aes-traces-cropped.png

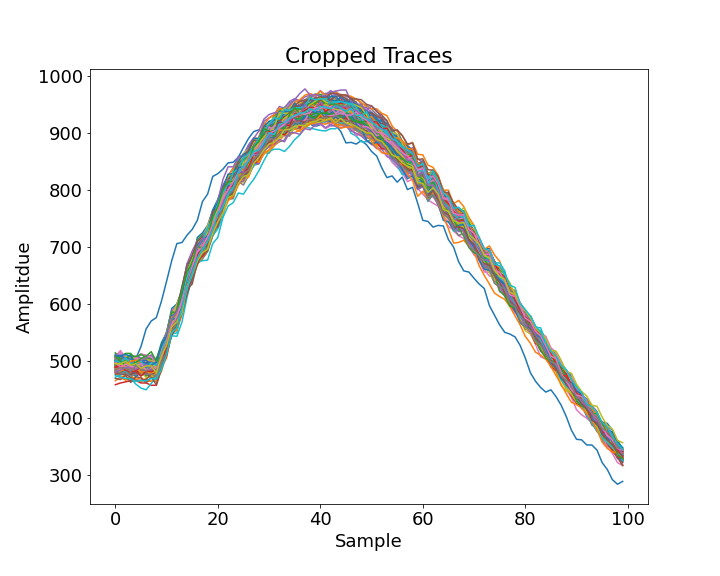
docs/source/figures/aes-traces-cropped.png
