kammoh/fobos/docs/source/figures/aes-traces.png

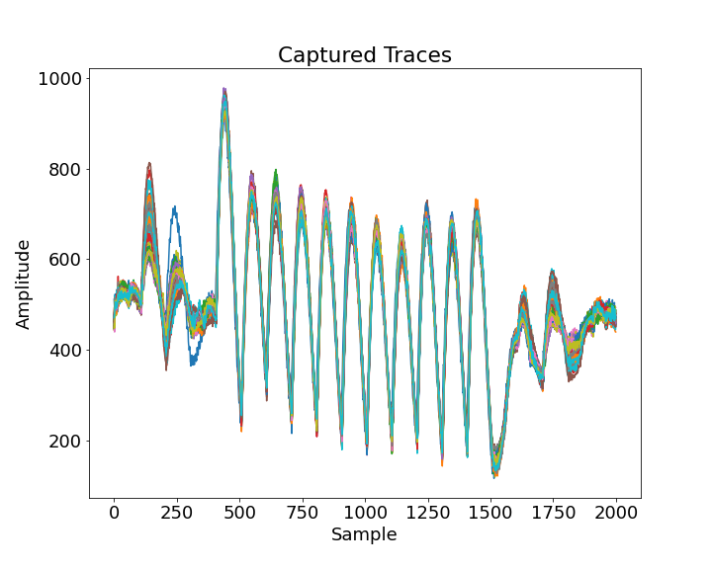
docs/source/figures/aes-traces.png
