kammoh/fobos/docs/source/figures/associate_elf.png

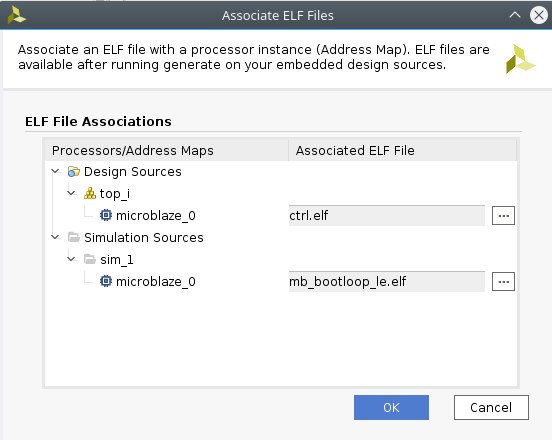
docs/source/figures/associate_elf.png
