kammoh/fobos/docs/source/figures/capture-code-example.png

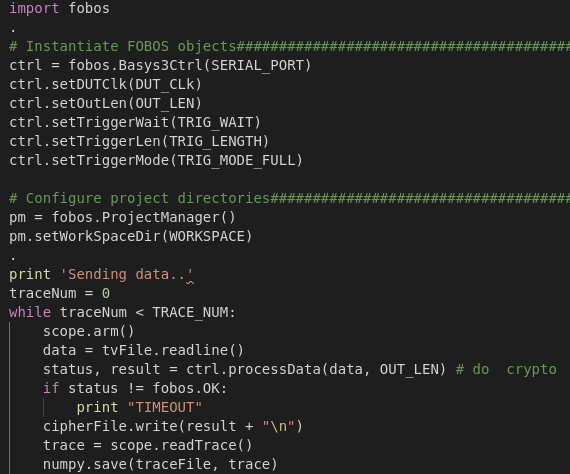
docs/source/figures/capture-code-example.png
