kammoh/fobos/docs/source/figures/correlation04.png

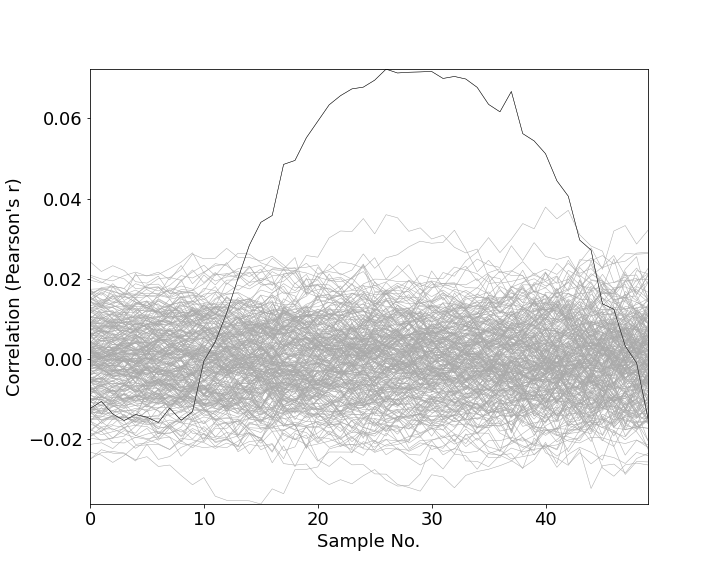
docs/source/figures/correlation04.png
