kammoh/fobos/docs/source/figures/DUT-artix7-power.png

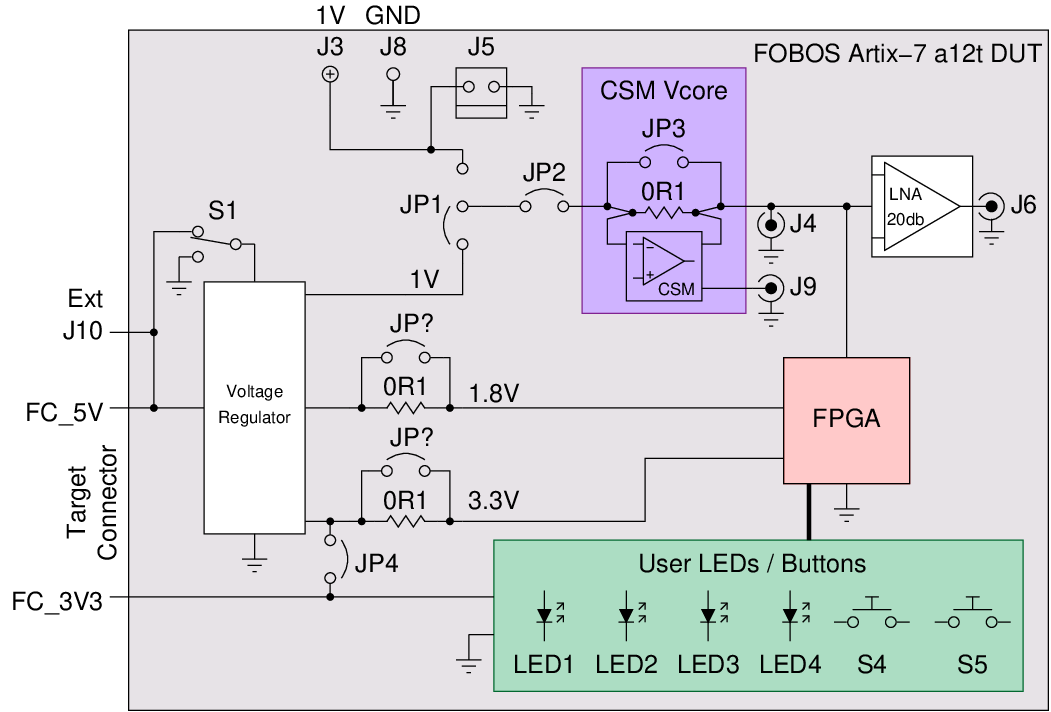
docs/source/figures/DUT-artix7-power.png
