kammoh/fobos/docs/source/figures/fobos2-nexys3-annotated.jpg

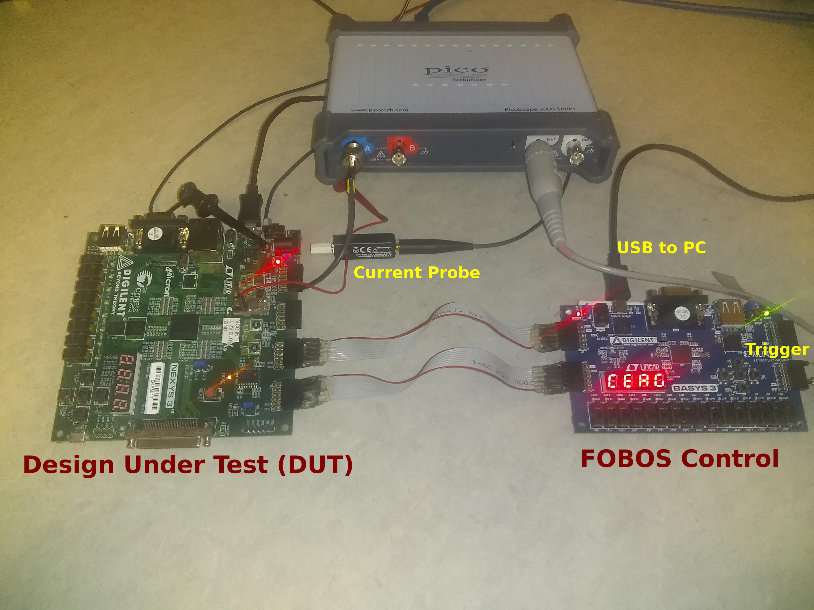
docs/source/figures/fobos2-nexys3-annotated.jpg
