kammoh/fobos/docs/source/figures/fobos3-cw305-power.jpg

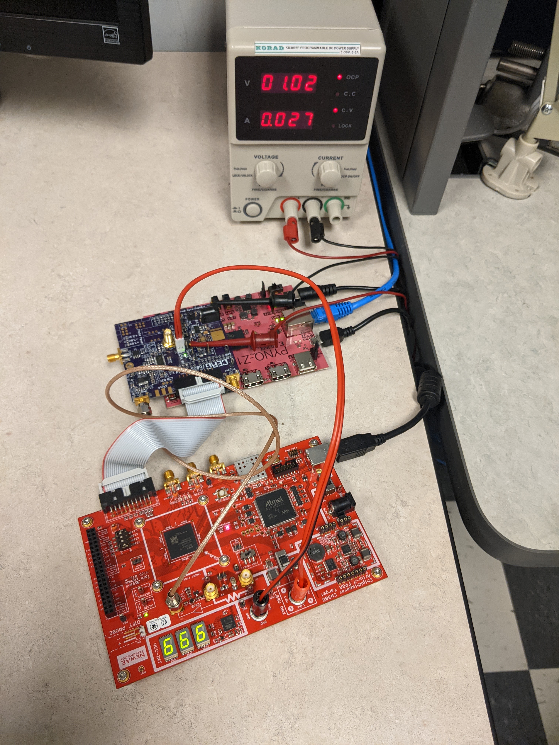
docs/source/figures/fobos3-cw305-power.jpg
