kammoh/fobos/docs/source/figures/fobos3-power.png

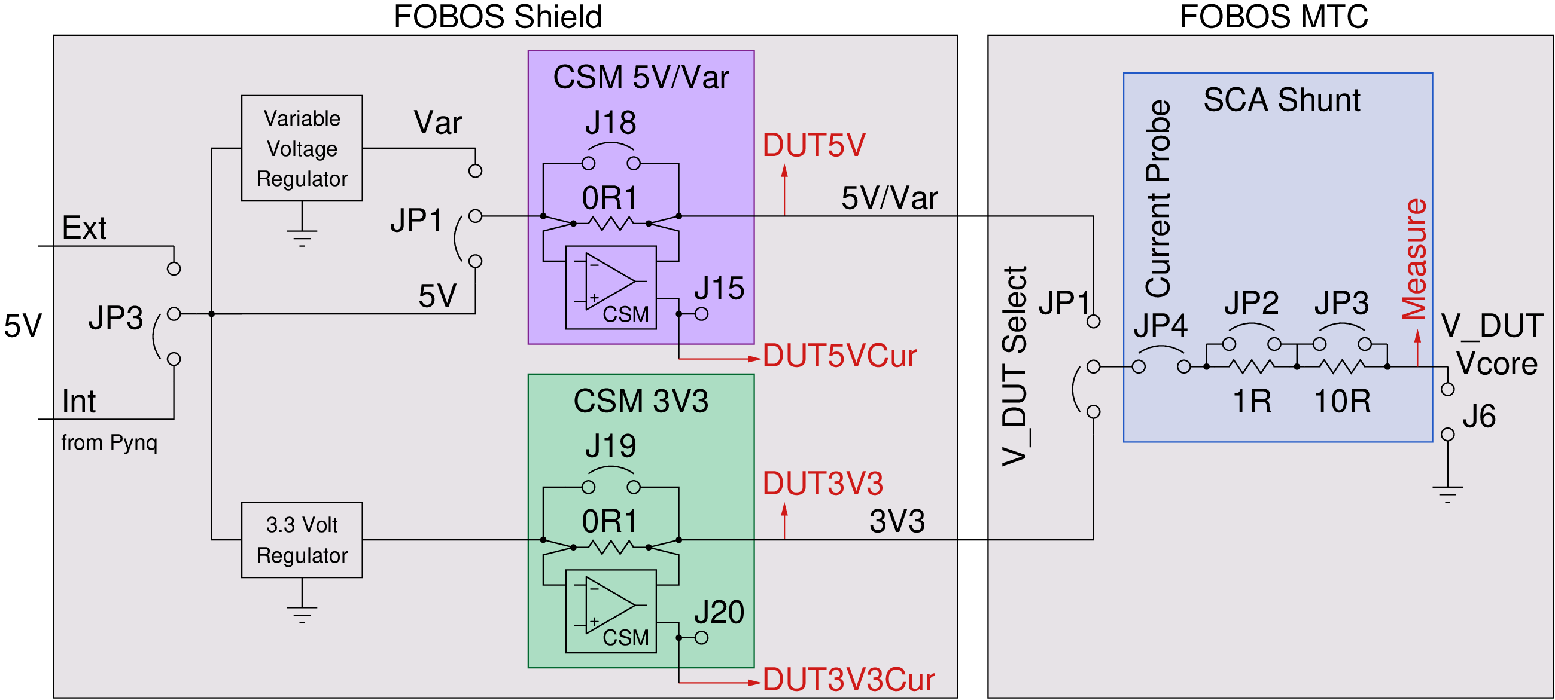
docs/source/figures/fobos3-power.png
