kammoh/fobos/docs/source/figures/MTD04.png

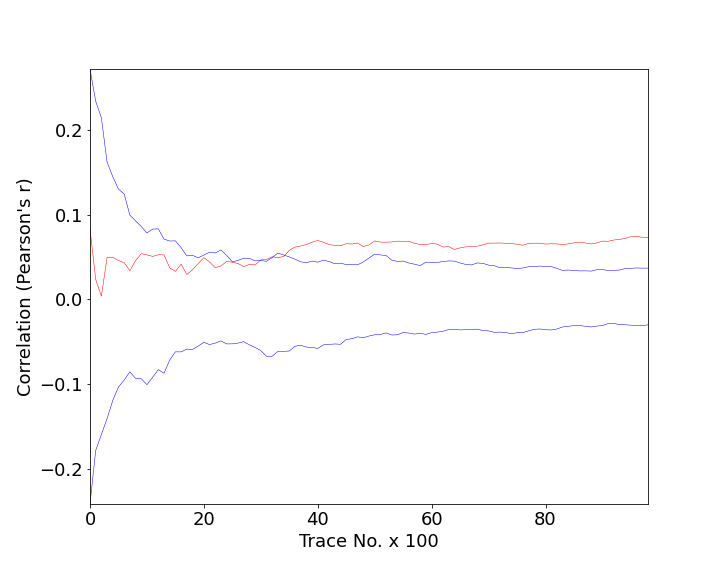
docs/source/figures/MTD04.png
