kammoh/fobos/oldfobos/doc/figures/1-autocorrelationGraph.png

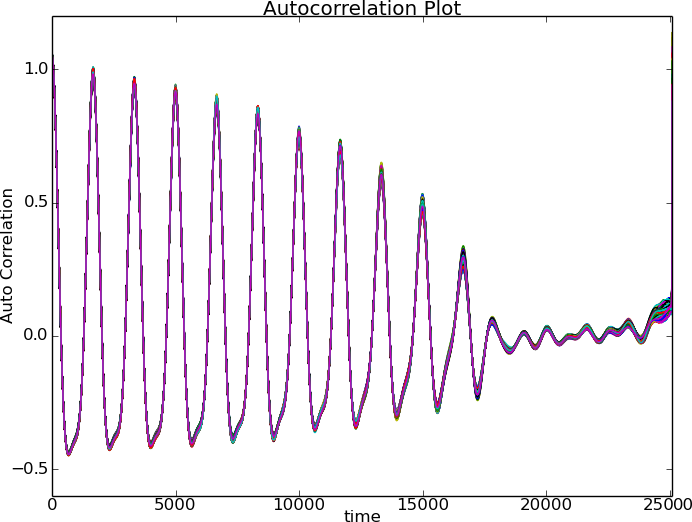
oldfobos/doc/figures/1-autocorrelationGraph.png
