kammoh/fobos/oldfobos/doc/figures/afterAlignment.png

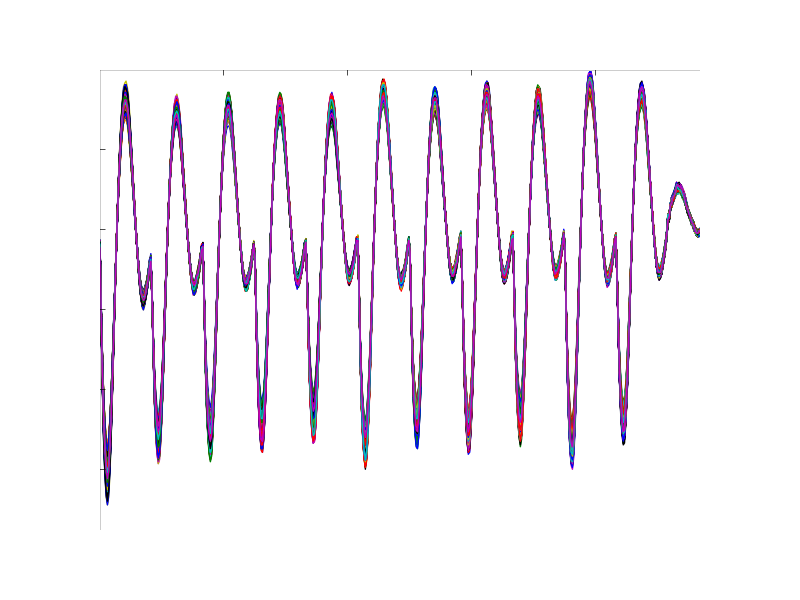
oldfobos/doc/figures/afterAlignment.png
