kammoh/fobos/oldfobos/doc/figures/alignedTraces.png

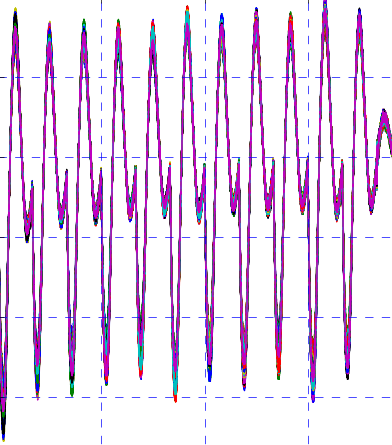
oldfobos/doc/figures/alignedTraces.png
