kammoh/fobos/oldfobos/doc/figures/CorrelationGraph.png

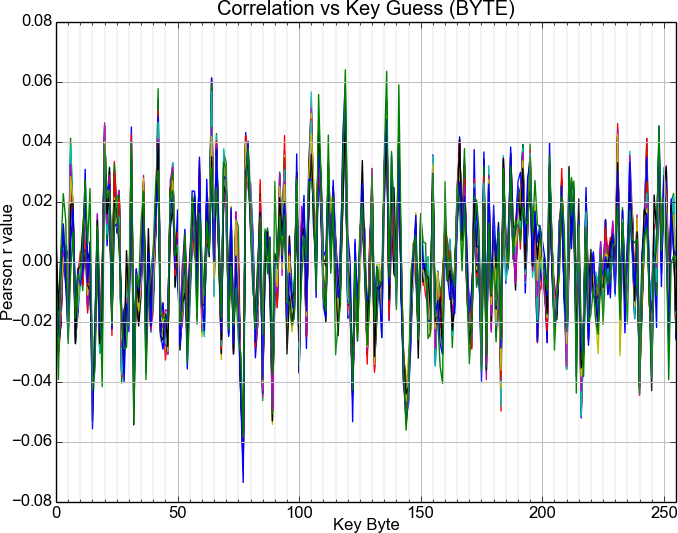
oldfobos/doc/figures/CorrelationGraph.png
