kammoh/fobos/oldfobos/doc/figures/fobos2-block.png

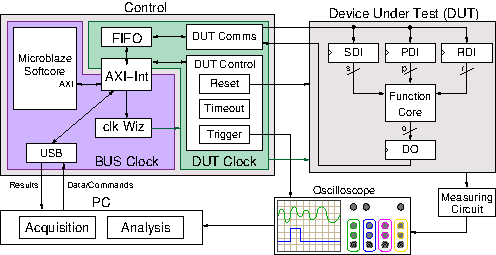
oldfobos/doc/figures/fobos2-block.png
