kammoh/fobos/oldfobos/doc/figures/FOBOS-label.png

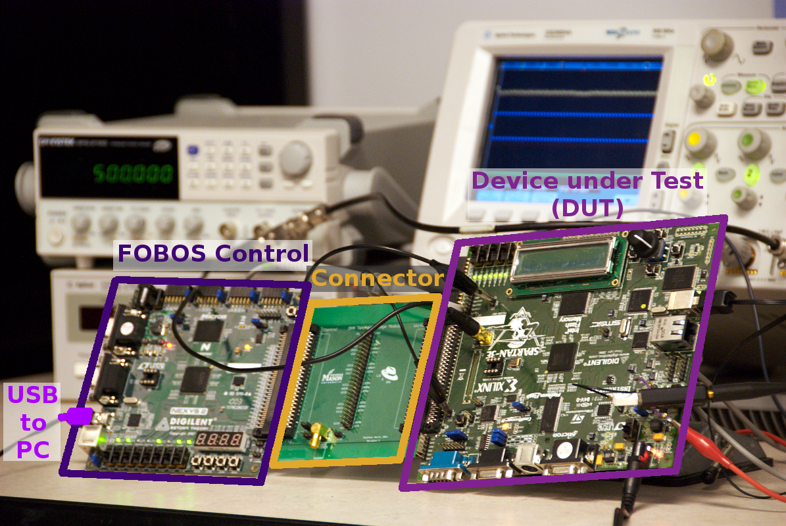
oldfobos/doc/figures/FOBOS-label.png
