kammoh/fobos/oldfobos/doc/figures/FOBOS.png

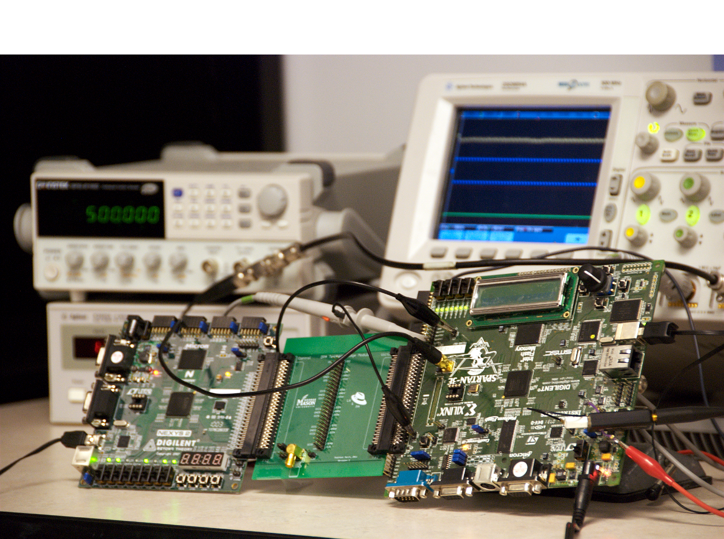
oldfobos/doc/figures/FOBOS.png
