kammoh/fobos/oldfobos/doc/figures/histogram.png

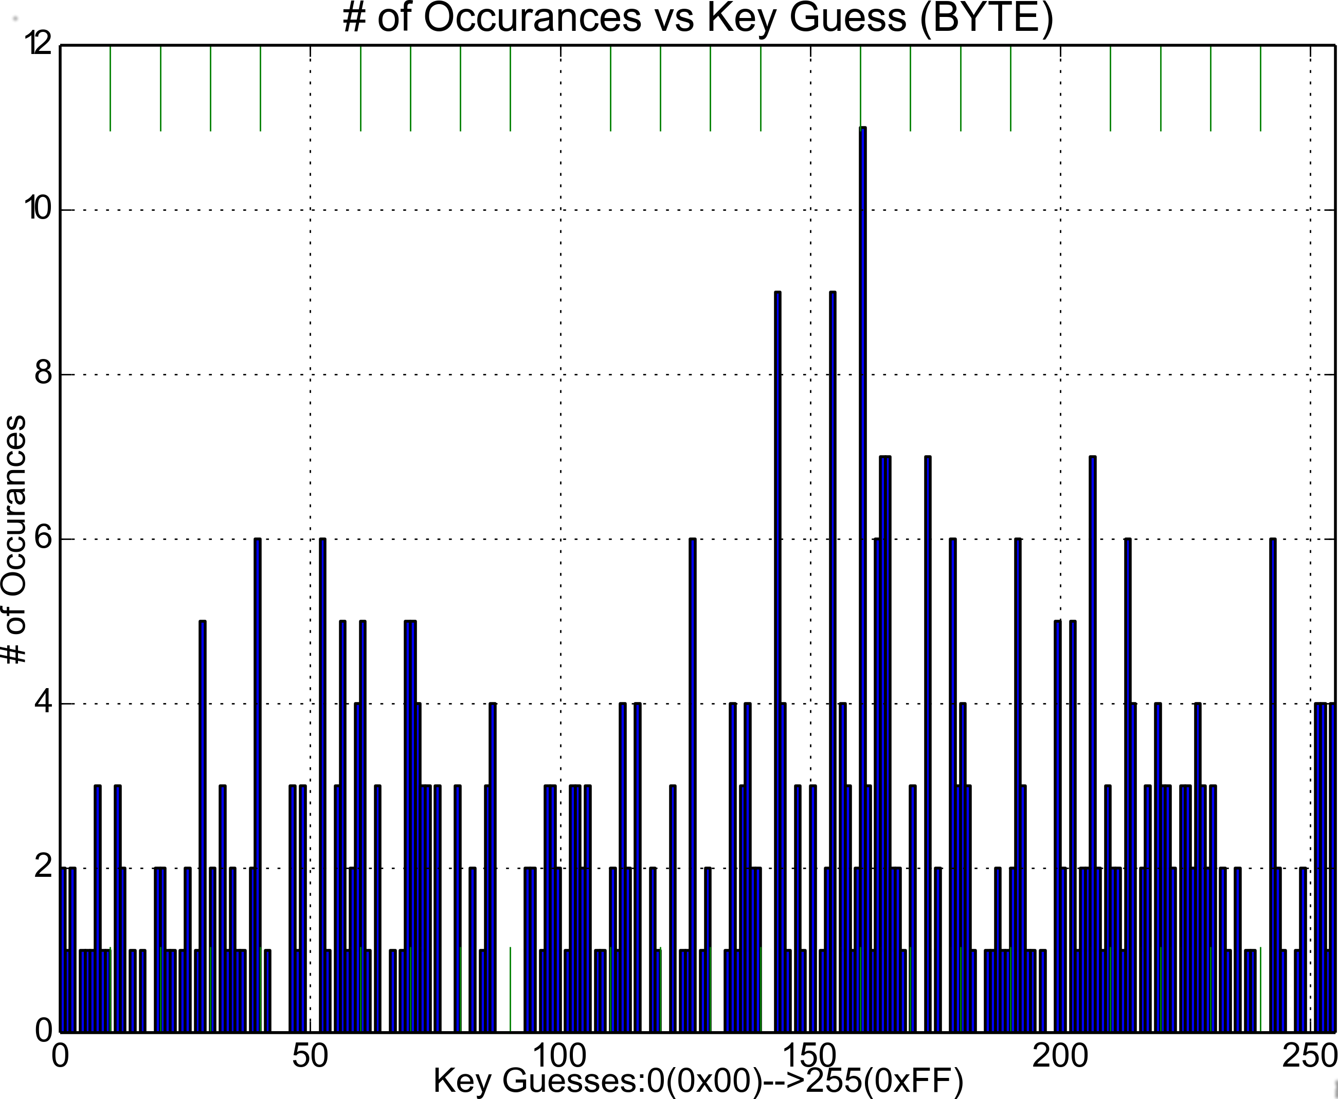
oldfobos/doc/figures/histogram.png
