kammoh/fobos/oldfobos/doc/figures/ina225.png

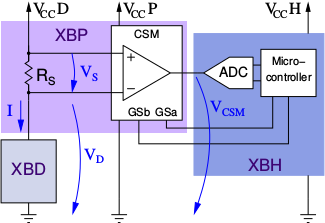
oldfobos/doc/figures/ina225.png
