kammoh/fobos/oldfobos/doc/figures/ina225_only.png

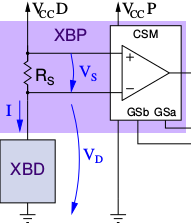
oldfobos/doc/figures/ina225_only.png
