kammoh/fobos/oldfobos/doc/figures/minimumGuessingEntropy.png

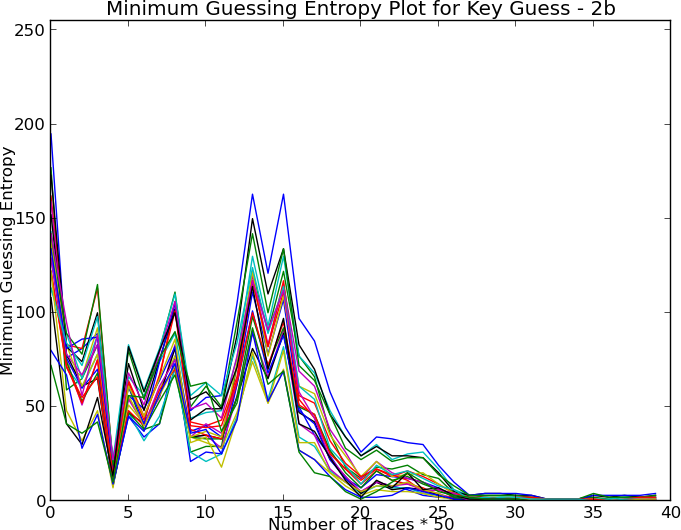
oldfobos/doc/figures/minimumGuessingEntropy.png
