kammoh/fobos/oldfobos/doc/figures/oscilloscope-all-4ch-1.png

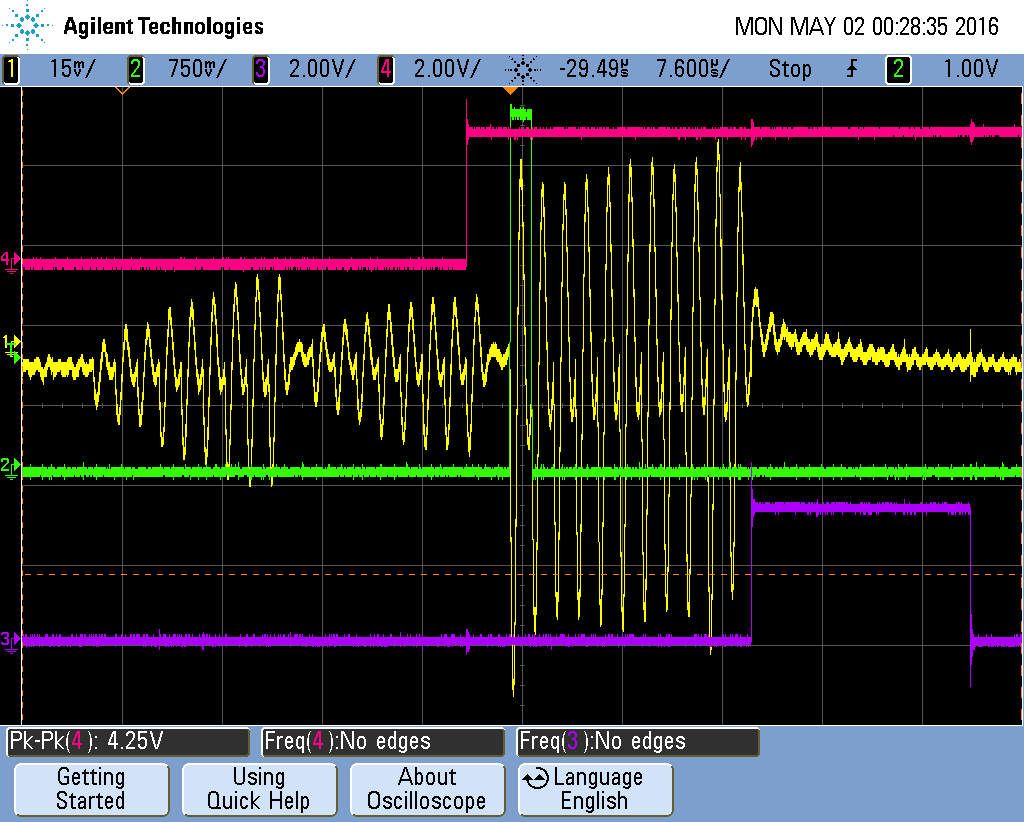
oldfobos/doc/figures/oscilloscope-all-4ch-1.png
