kammoh/fobos/oldfobos/doc/figures/oscilloscope-sample-window-1-mod.png

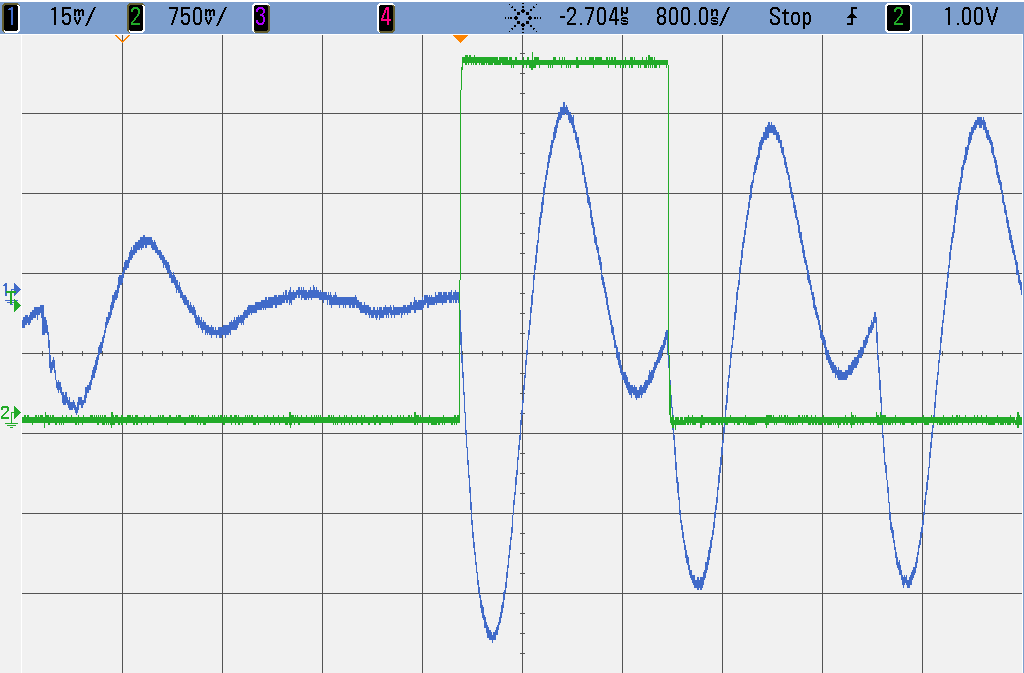
oldfobos/doc/figures/oscilloscope-sample-window-1-mod.png
