kammoh/fobos/oldfobos/doc/figures/oscilloscope-sample-window-1.png

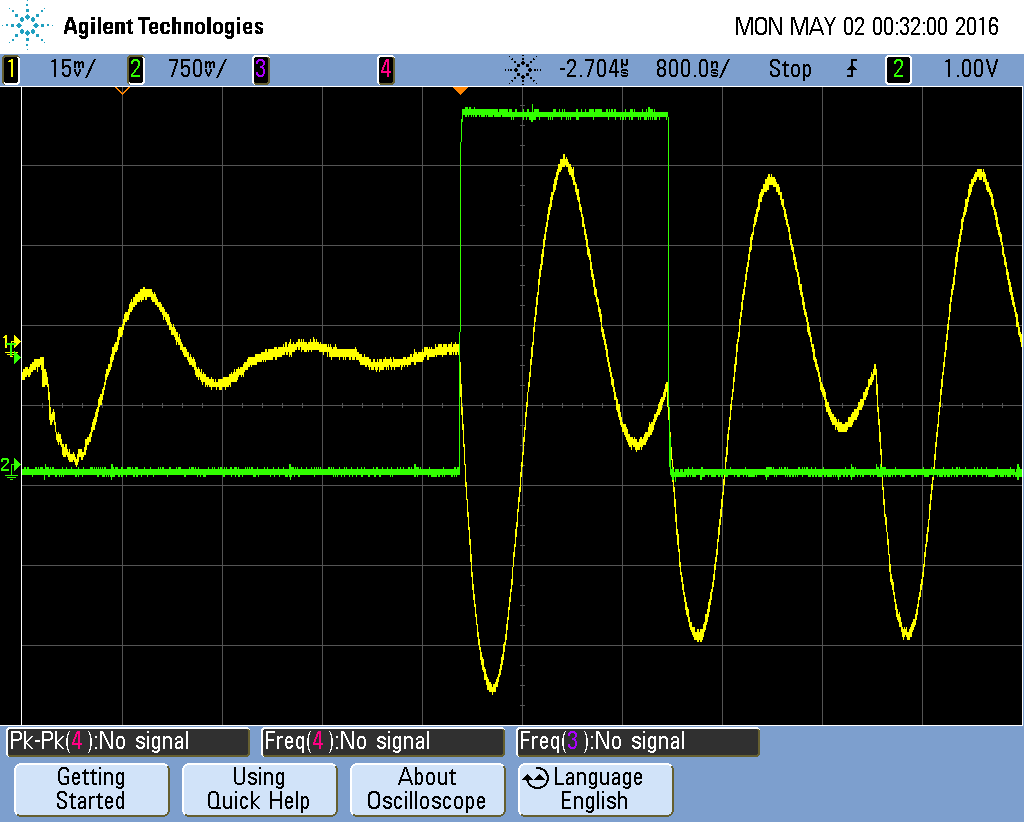
oldfobos/doc/figures/oscilloscope-sample-window-1.png
