kammoh/fobos/oldfobos/doc/figures/oscilloscope-sample-window-2-mod.png

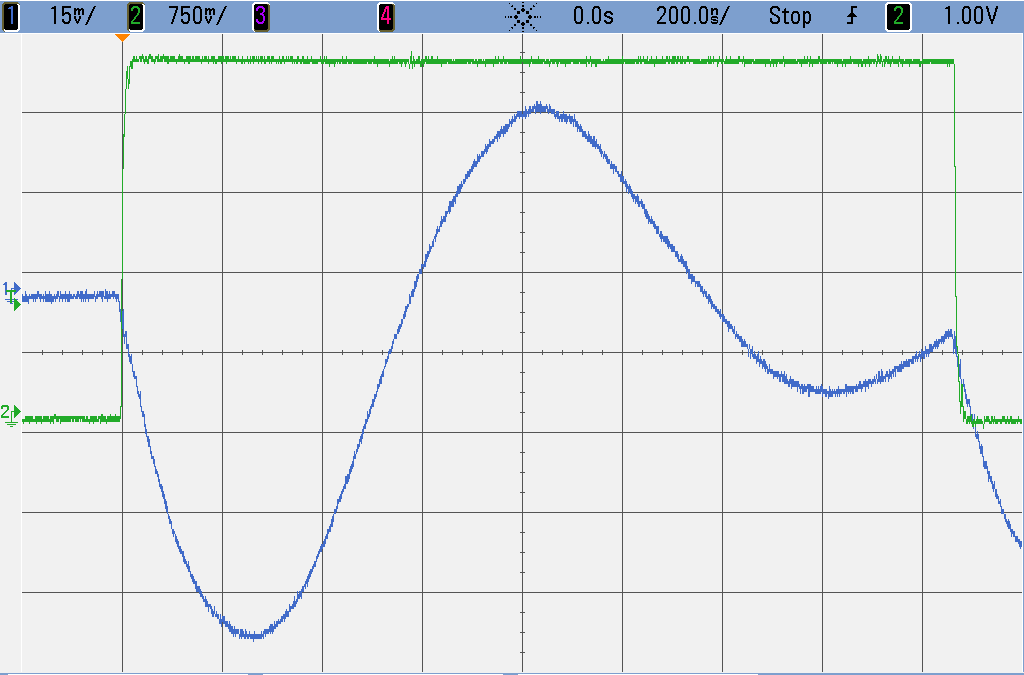
oldfobos/doc/figures/oscilloscope-sample-window-2-mod.png
