kammoh/fobos/oldfobos/doc/figures/oscilloscope-sample-window-2.png

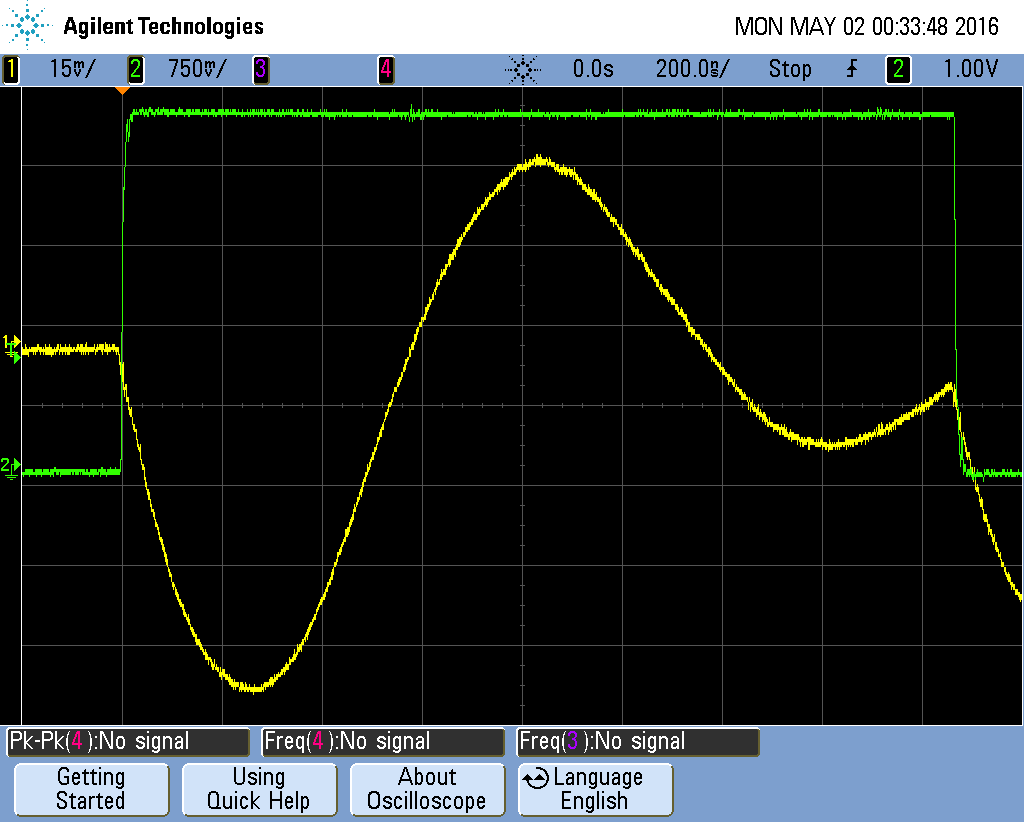
oldfobos/doc/figures/oscilloscope-sample-window-2.png
