kammoh/fobos/oldfobos/doc/figures/Oscilloscope-sample-window.png

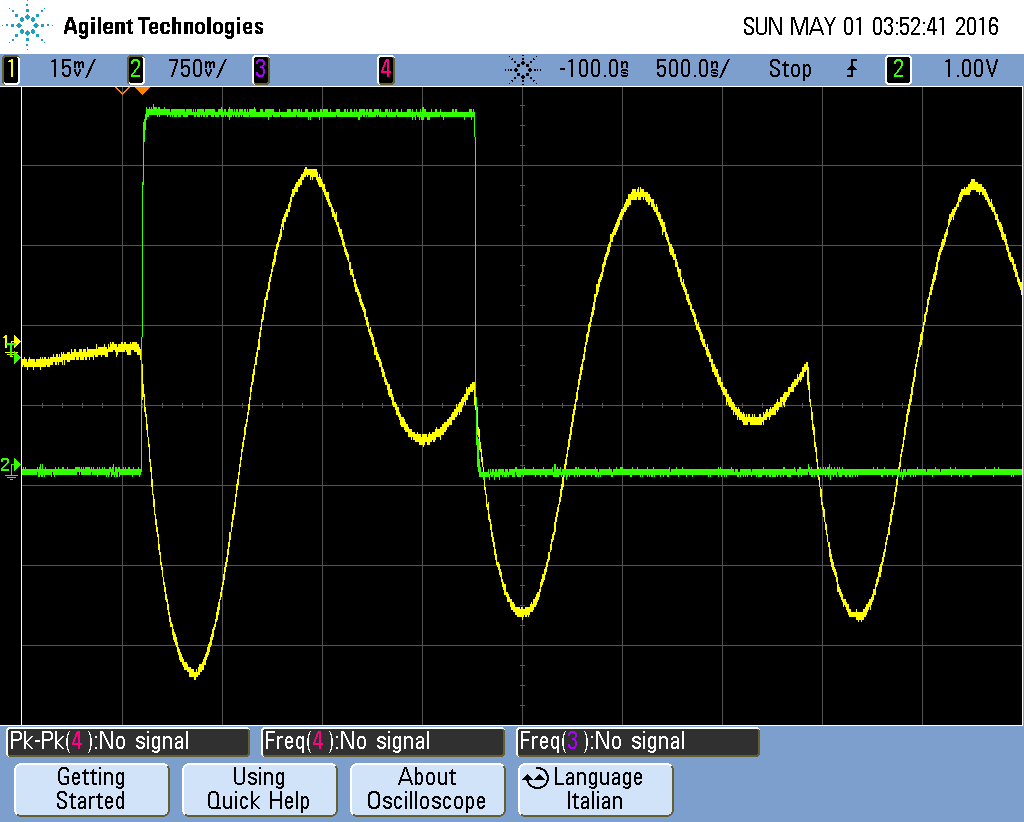
oldfobos/doc/figures/Oscilloscope-sample-window.png
