kammoh/fobos/oldfobos/doc/figures/Oscilloscope_with_all_four_channels-mod.png

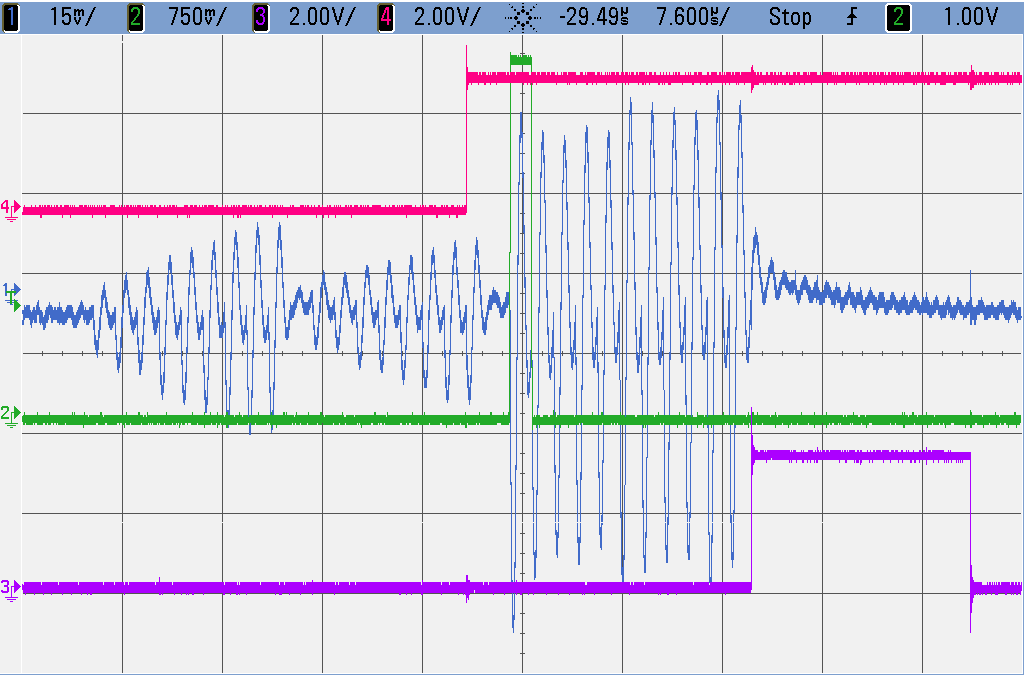
oldfobos/doc/figures/Oscilloscope_with_all_four_channels-mod.png
