kammoh/fobos/oldfobos/doc/figures/Oscilloscope_with_trigger_power_all_11_rounds-mod.png

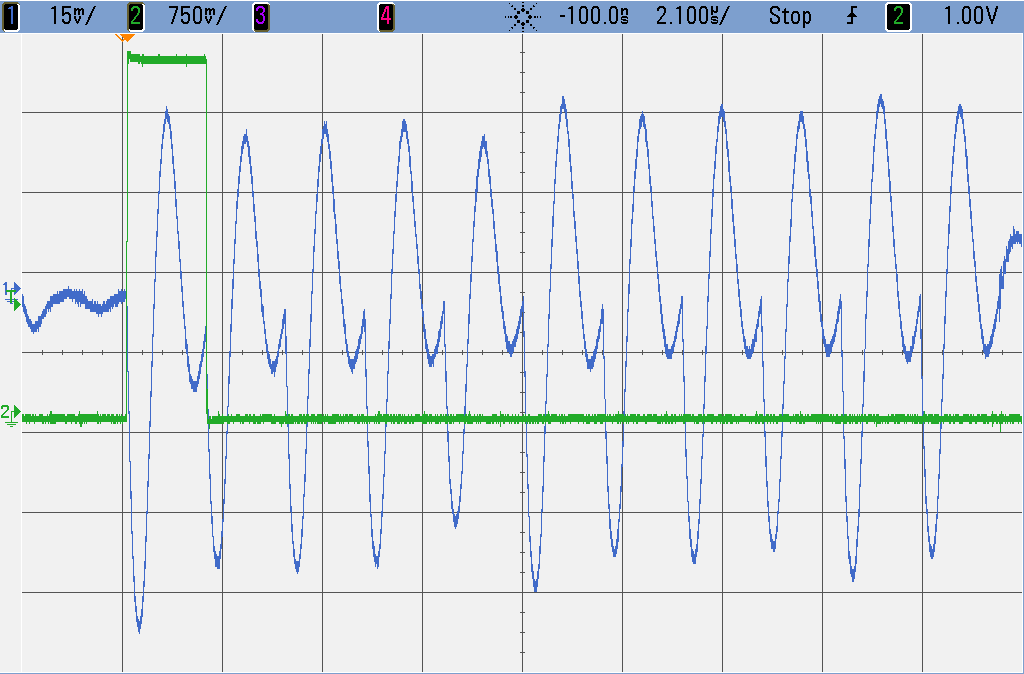
oldfobos/doc/figures/Oscilloscope_with_trigger_power_all_11_rounds-mod.png
