kammoh/fobos/oldfobos/doc/figures/pearsonsGraph.png

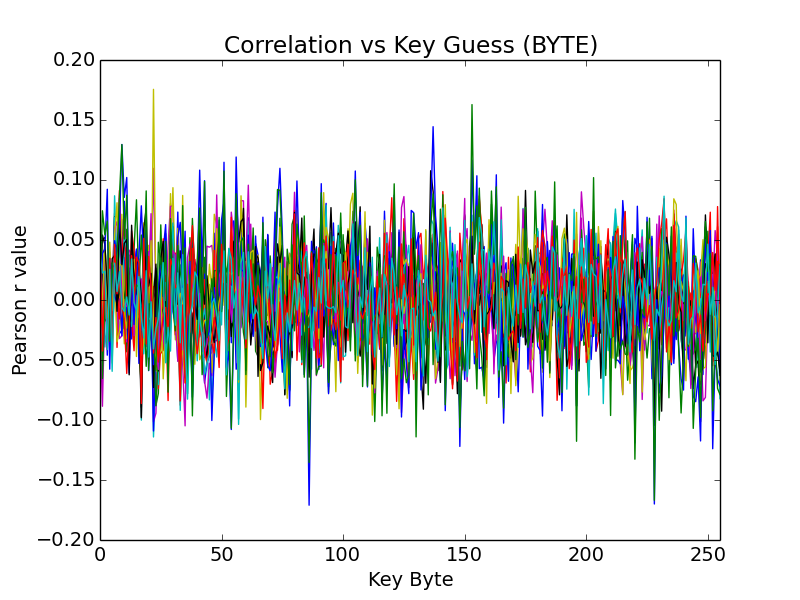
oldfobos/doc/figures/pearsonsGraph.png
