kammoh/fobos/oldfobos/doc/figures/power_script.png

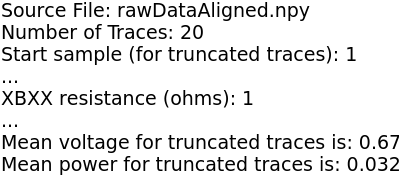
oldfobos/doc/figures/power_script.png
