kammoh/fobos/oldfobos/doc/figures/profiler_1sm.png

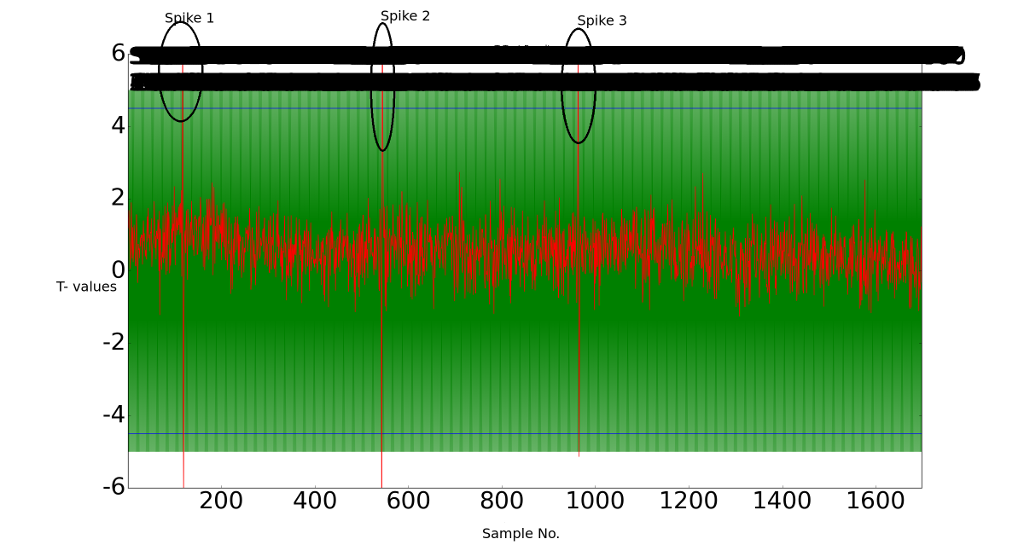
oldfobos/doc/figures/profiler_1sm.png
