kammoh/fobos/oldfobos/doc/figures/rawTrace1.png

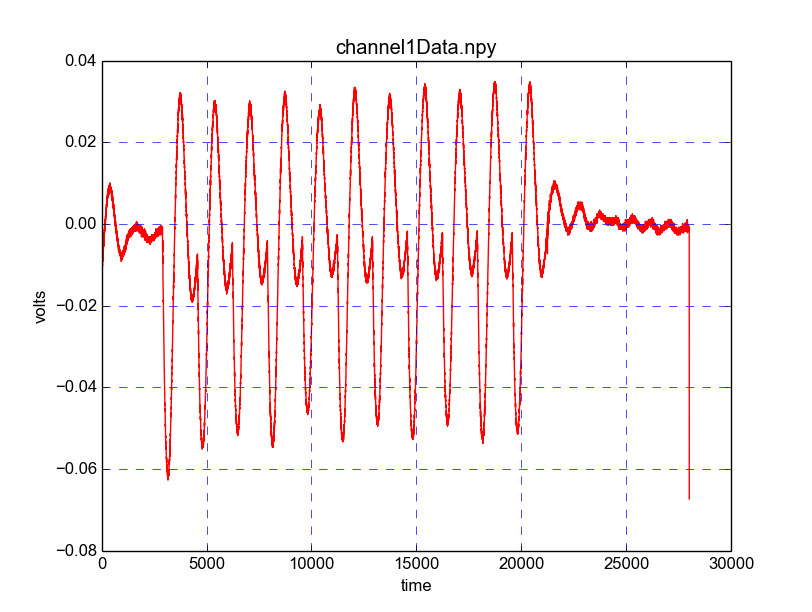
oldfobos/doc/figures/rawTrace1.png
