kammoh/fobos/oldfobos/doc/figures/rawTrace-2.png

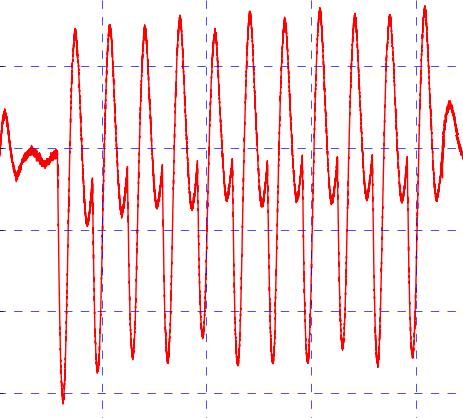
oldfobos/doc/figures/rawTrace-2.png
