kammoh/fobos/oldfobos/doc/figures/rawTrace.png

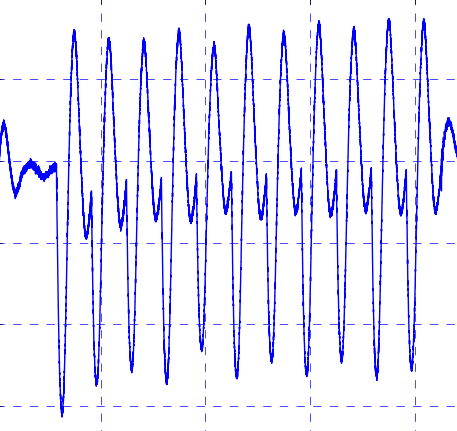
oldfobos/doc/figures/rawTrace.png
