kammoh/fobos/oldfobos/doc/figures/TraceWise-stdOfData.png

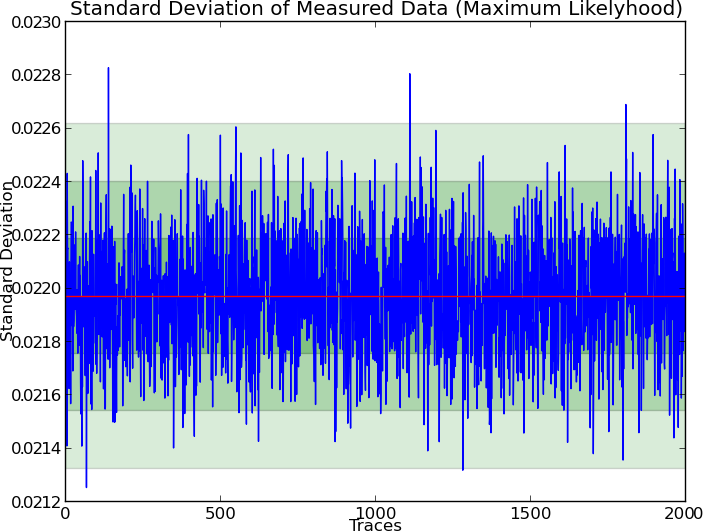
oldfobos/doc/figures/TraceWise-stdOfData.png
