kammoh/fobos/oldfobos/doc/figures/TraceWise-varOfData.png

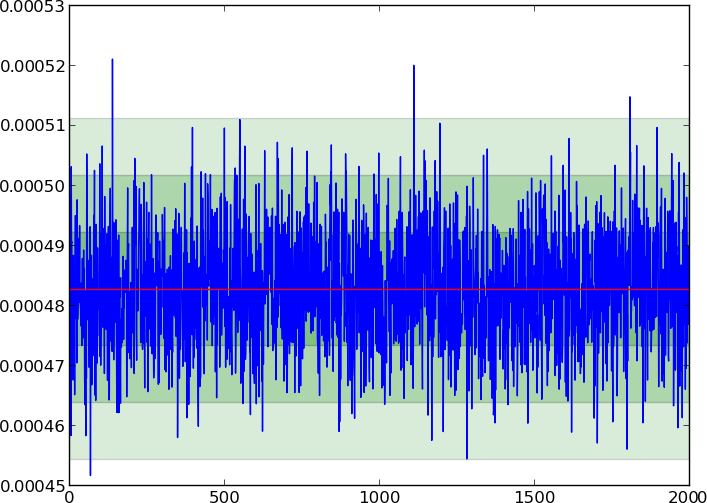
oldfobos/doc/figures/TraceWise-varOfData.png
