kammoh/fobos/oldfobos/doc/figures/traceWith-all-rounds.png

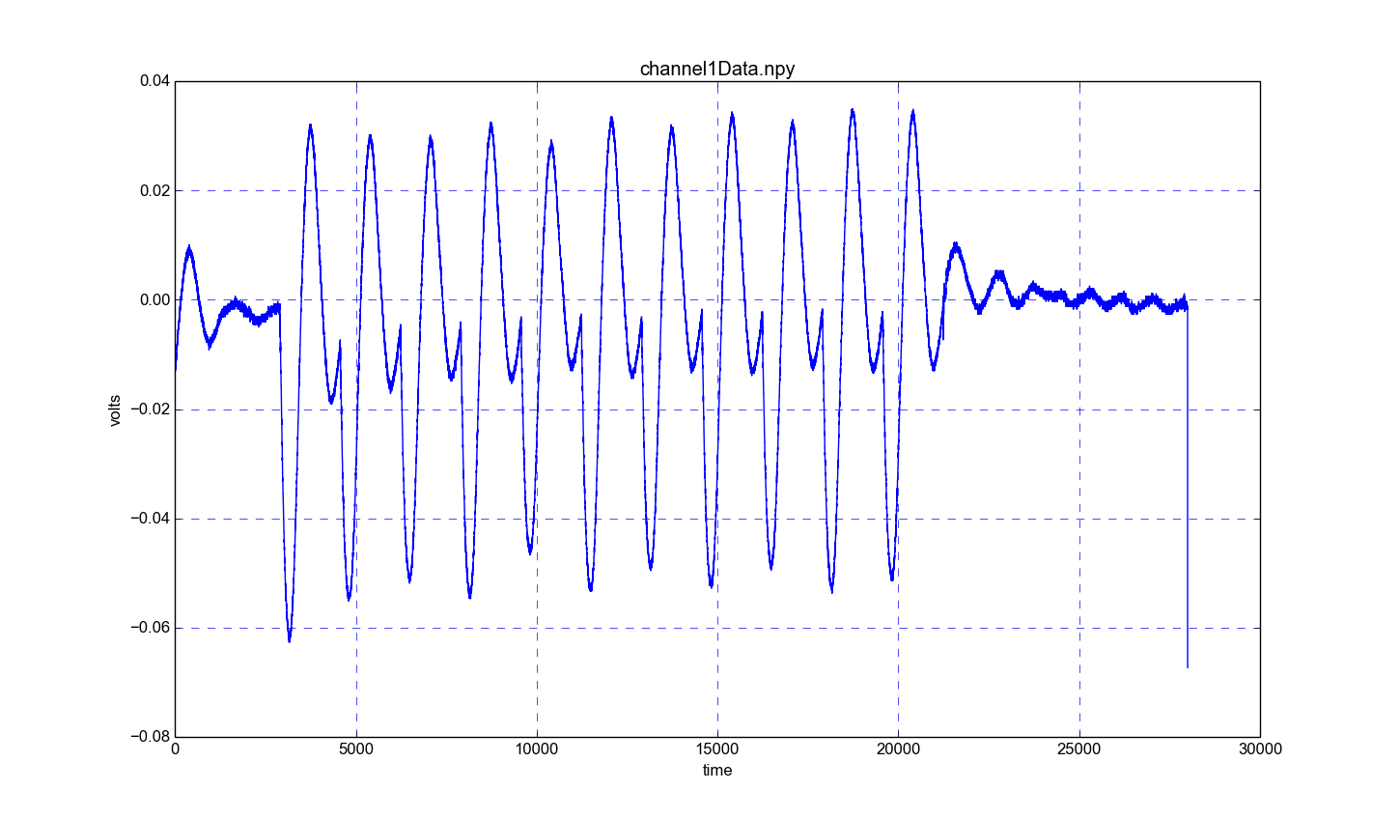
oldfobos/doc/figures/traceWith-all-rounds.png
