kammoh/fobos/oldfobos/doc/figures/trigger.png

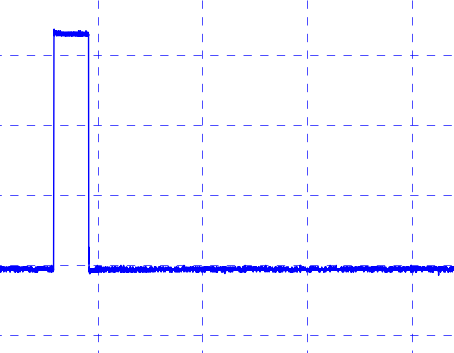
oldfobos/doc/figures/trigger.png
