kammoh/fobos/oldfobos/doc/Poster/images/power_plain.png

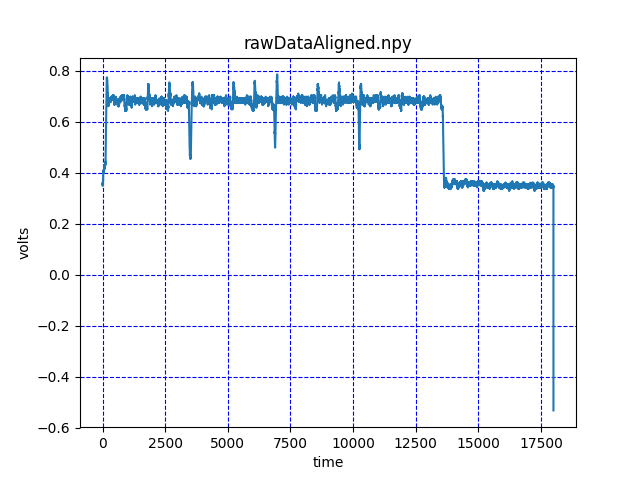
oldfobos/doc/Poster/images/power_plain.png
