kammoh/fobos/oldfobos/doc/Poster/images/power_traces_aes_gcm_unprotected.png

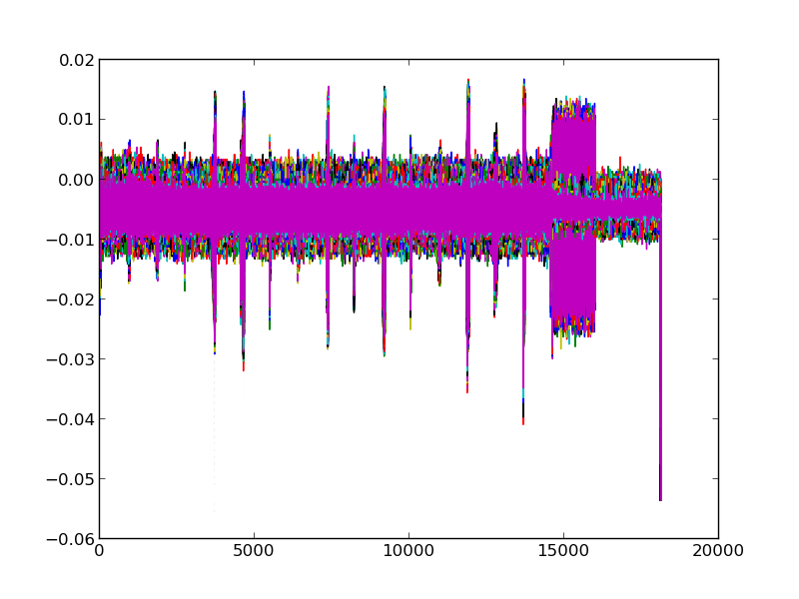
oldfobos/doc/Poster/images/power_traces_aes_gcm_unprotected.png
