kammoh/fobos/oldfobos/doc/Poster/images/profiler_1_plain.png

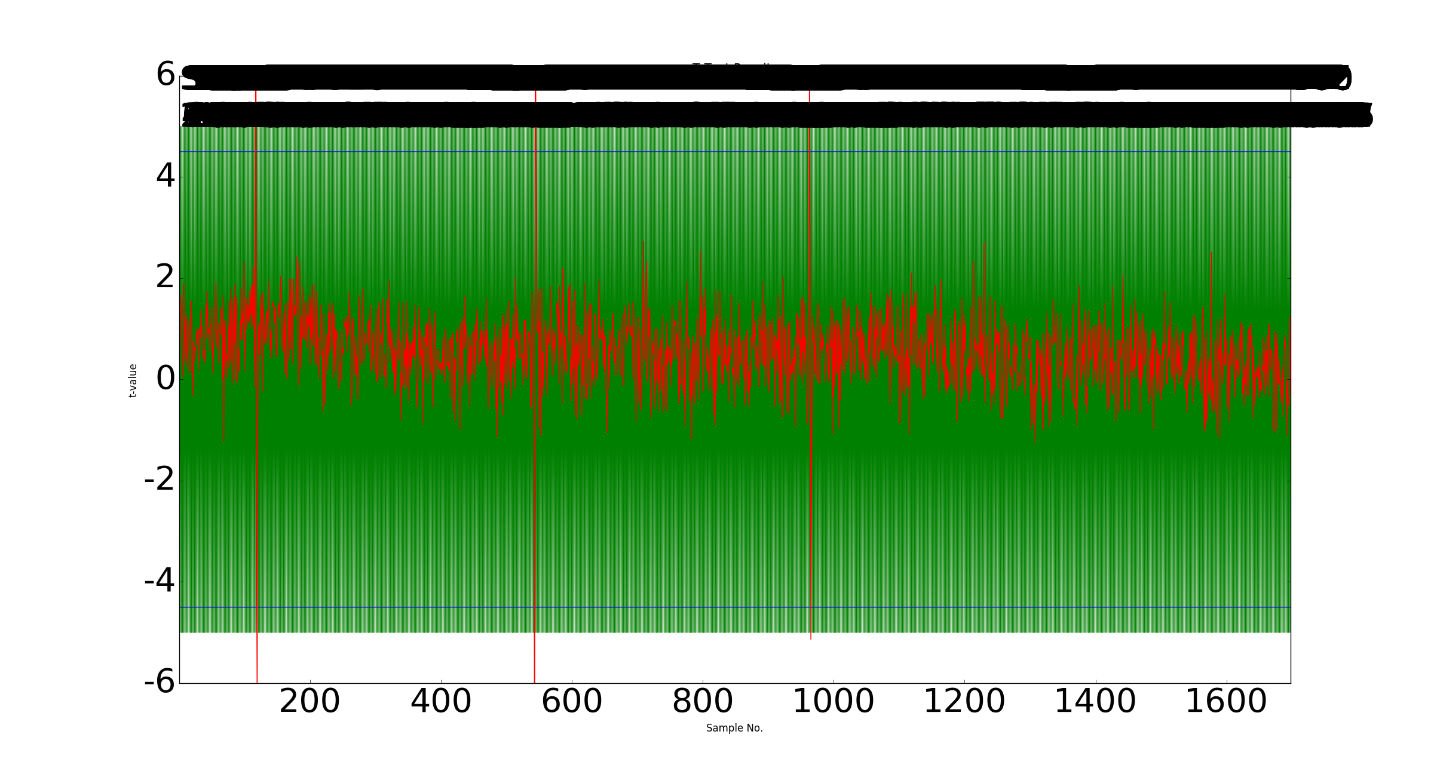
oldfobos/doc/Poster/images/profiler_1_plain.png
