kammoh/fobos/oldfobos/temp/mem_buffer/schematics/dual_fifo/datapath.png

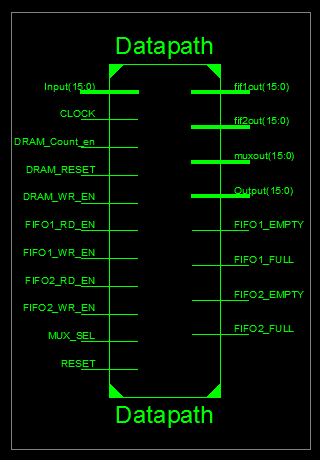
oldfobos/temp/mem_buffer/schematics/dual_fifo/datapath.png
