kammoh/fobos/oldfobos/temp/mem_buffer/schematics/hardware_abstraction_slow/micron cellular ram mt45w8mw16 FSM Async.png

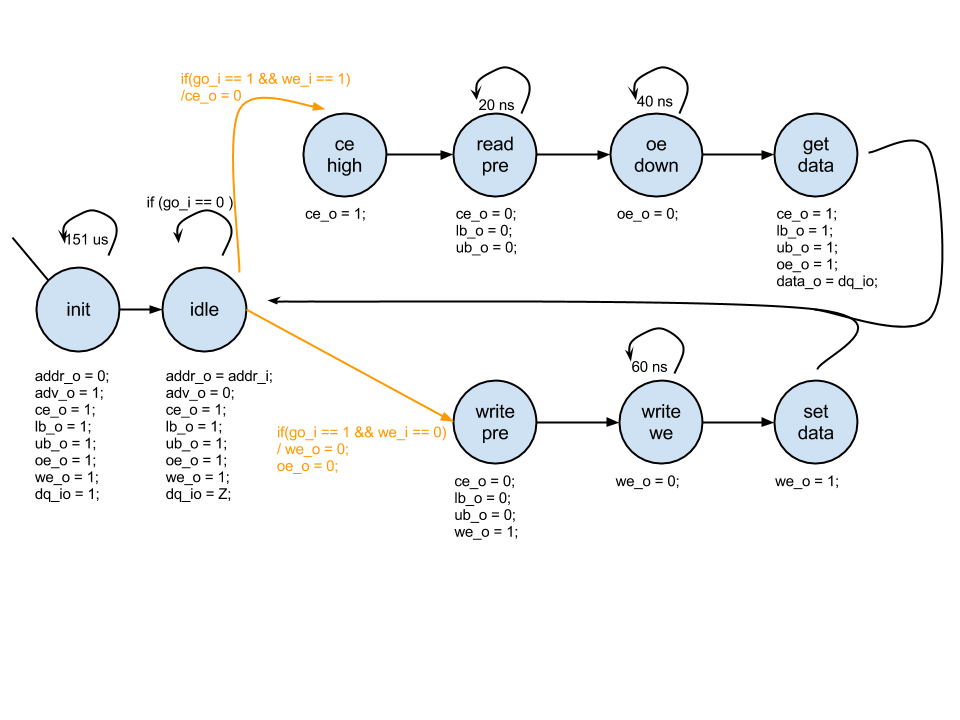
oldfobos/temp/mem_buffer/schematics/hardware_abstraction_slow/micron cellular ram mt45w8mw16 FSM Async.png
