kammoh/fobos/oldfobos/temp/mem_buffer/schematics/hardware_abstraction_slow/micron_rtl_view.PNG

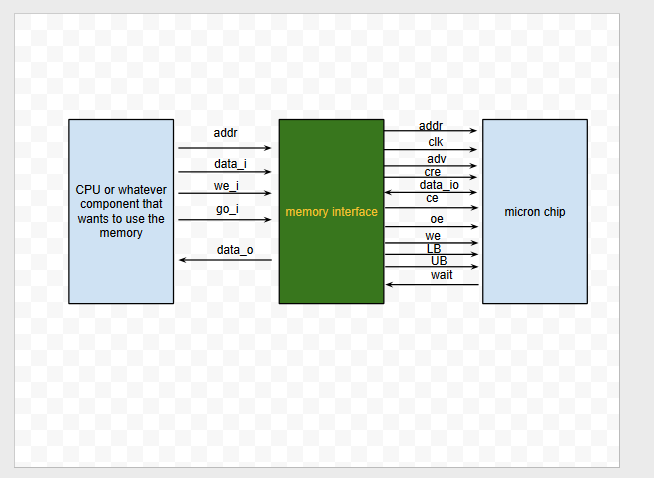
oldfobos/temp/mem_buffer/schematics/hardware_abstraction_slow/micron_rtl_view.PNG
