kammoh/fobos/oldfobos/temp/mem_buffer/schematics/mem_buf_new.jpg

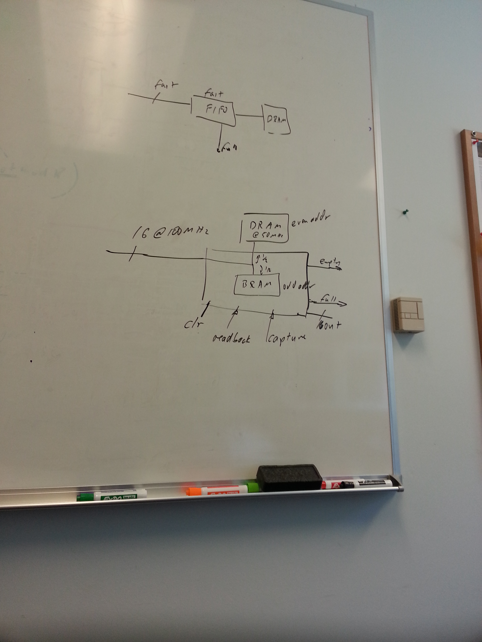
oldfobos/temp/mem_buffer/schematics/mem_buf_new.jpg
