kammoh/fobos/hardware/fobos-shield/fobosshield-bom.ods

Source: | /home/jkaps/projects/fobos/sources/fobos-shield/fobosshield.sch
Date: | Sun 30 Sep 2018 12:37:50 AM EDT
Tool: | Eeschema 5.0.0-fee4fd1~66~ubuntu18.04.1
Generator: | /usr/share/kicad/plugins/bom_csv_grouped_by_value_with_fp.py
Component Count: | 154
Ref | Qnty | Value | Cmp name | Footprint | Description | Vendor
C1, C2, | 2 | 100nF | C | Capacitor_SMD:C_0603_1608Metric | Unpolarized capacitor
C5, C4, C62, | 3 | 1uF | CP | Capacitor_Tantalum_SMD:CP_EIA-3216-18_Kemet-A | Polarised capacitor
C7, C23, C26, C27, C43, C45, C50, C3, C6, | 9 | 1uF | C | Capacitor_SMD:C_0603_1608Metric | Unpolarized capacitor
C9, C17, C20, C19, | 4 | 1nF | C_Small | Capacitor_SMD:C_0603_1608Metric | Unpolarized capacitor
C10, C16, C14, C8, C15, C18, C22, C21, C11, C24, C25, C28, C34, C30, C31, C39, C36, C38, C42, C46, C48, C54, C55, C58, C57, | 25 | 100n | C | Capacitor_SMD:C_0603_1608Metric | Unpolarized capacitor
C12, | 1 | 22pF | C_Small | Capacitor_SMD:C_0603_1608Metric | Unpolarized capacitor
C13, | 1 | 18nF | C_Small | Capacitor_SMD:C_0603_1608Metric | Unpolarized capacitor
C29, C35, | 2 | 10u | C_Small | Capacitor_SMD:C_0603_1608Metric | Unpolarized capacitor
C33, C32, | 2 | 100p | C_Small | Capacitor_SMD:C_0603_1608Metric | Unpolarized capacitor
C41, C37, C40, C44, C47, | 5 | 10n | C_Small | Capacitor_SMD:C_0603_1608Metric | Unpolarized capacitor
C49, | 1 | 2u2 | C_Small | Capacitor_SMD:C_0603_1608Metric | Unpolarized capacitor
C51, | 1 | 10nF | C | Capacitor_SMD:C_0603_1608Metric | Unpolarized capacitor
C52, | 1 | 220p | C | Capacitor_SMD:C_0603_1608Metric | Unpolarized capacitor
C53, | 1 | 10uF X5R | C | Capacitor_SMD:C_0805_2012Metric | Unpolarized capacitor
C59, C56, C60, C61, | 4 | 10uF | C | Capacitor_SMD:C_0805_2012Metric | Unpolarized capacitor
D1, D5, D11, | 3 | 5V1 | D_Zener_ALT | Diode_SMD:D_SOT-23_ANK | Zener Diode, alternativ symbol
D3, | 1 | 1N4148 | 1N4148 | Diode_SMD:D_SOD-323F | 100V 0.15A standard switching diode, DO-35
D4, D2, D6, D10, D12, | 5 | green | LED_ALT | LED_SMD:LED_0603_1608Metric | LED generic, alternativ symbol
D7, | 1 | BAV99 | BAV99 | Package_TO_SOT_SMD:SOT-23 | BAV99 High-speed switching diodes
D8, | 1 | 2V4 | D_Zener_ALT | Diode_SMD:D_SOT-23_ANK | Zener Diode, alternativ symbol
D9, | 1 | red | LED_ALT | LED_SMD:LED_0603_1608Metric | LED generic, alternativ symbol
J1, | 1 | Target | Conn_02x10_Odd_Even | Connector_IDC:IDC-Header_2x10_P2.54mm_Horizontal | Generic connector, double row, 02x10, odd/even pin numbering scheme (row 1 odd numbers, row 2 even numbers), script generated (kicad-library-utils/schlib/autogen/connector/)
J2, | 1 | Glitch | Conn_Coaxial_Power | cerg:SMA-JOHNSON-142-0701-801 | coaxial connector (BNC, SMA, SMB, SMC, Cinch/RCA, ...)
J3, | 1 | Analog | Conn_02x06_Odd_Even | cerg:PinHeader_2x06_P2.54mm_Vertical_flipped | Generic connector, double row, 02x06, odd/even pin numbering scheme (row 1 odd numbers, row 2 even numbers), script generated (kicad-library-utils/schlib/autogen/connector/)
J4, | 1 | IOH | Conn_02x08_Odd_Even | cerg:PinHeader_2x08_P2.54mm_Vertical_Flipped | Generic connector, double row, 02x08, odd/even pin numbering scheme (row 1 odd numbers, row 2 even numbers), script generated (kicad-library-utils/schlib/autogen/connector/)
J5, | 1 | SPI | Conn_02x03_Odd_Even | Connector_PinSocket_2.54mm:PinSocket_2x03_P2.54mm_Vertical | Generic connector, double row, 02x03, odd/even pin numbering scheme (row 1 odd numbers, row 2 even numbers), script generated (kicad-library-utils/schlib/autogen/connector/)
J6, | 1 | Analog2 | Conn_01x04 | Connector_PinHeader_2.54mm:PinHeader_1x04_P2.54mm_Vertical | Generic connector, single row, 01x04, script generated (kicad-library-utils/schlib/autogen/connector/)
J7, | 1 | Power | Conn_01x08 | Connector_PinHeader_2.54mm:PinHeader_1x08_P2.54mm_Vertical | Generic connector, single row, 01x08, script generated (kicad-library-utils/schlib/autogen/connector/)
J8, | 1 | IOL | Conn_02x08_Odd_Even | cerg:PinHeader_2x08_P2.54mm_Vertical_Flipped | Generic connector, double row, 02x08, odd/even pin numbering scheme (row 1 odd numbers, row 2 even numbers), script generated (kicad-library-utils/schlib/autogen/connector/)
J9, | 1 | SPI2 | Conn_01x02 | Connector_PinHeader_2.54mm:PinHeader_1x02_P2.54mm_Vertical | Generic connector, single row, 01x02, script generated (kicad-library-utils/schlib/autogen/connector/)
J10, | 1 | ADCin | Conn_Coaxial_Power | cerg:SMA-JOHNSON-142-0701-801 | coaxial connector (BNC, SMA, SMB, SMC, Cinch/RCA, ...)
J11, | 1 | PP1 | Conn_02x03_Odd_Even | Connector_IDC:IDC-Header_2x03_P2.54mm_Horizontal | Generic connector, double row, 02x03, odd/even pin numbering scheme (row 1 odd numbers, row 2 even numbers), script generated (kicad-library-utils/schlib/autogen/connector/)
J12, | 1 | PP2 | Conn_02x03_Odd_Even | Connector_IDC:IDC-Header_2x03_P2.54mm_Horizontal | Generic connector, double row, 02x03, odd/even pin numbering scheme (row 1 odd numbers, row 2 even numbers), script generated (kicad-library-utils/schlib/autogen/connector/)
J13, | 1 | Clock | Conn_Coaxial_Power | cerg:SMA-JOHNSON-142-0701-801 | coaxial connector (BNC, SMA, SMB, SMC, Cinch/RCA, ...)
J14, | 1 | Trigger | Conn_Coaxial_Power | cerg:SMA-JOHNSON-142-0701-801 | coaxial connector (BNC, SMA, SMB, SMC, Cinch/RCA, ...)
J15, | 1 | CSM5VCur | Conn_01x01 | Connector_PinHeader_2.54mm:PinHeader_1x01_P2.54mm_Vertical | Generic connector, single row, 01x01, script generated (kicad-library-utils/schlib/autogen/connector/)
J16, | 1 | Conn_01x01 | Conn_01x01 | Connector_PinHeader_2.54mm:PinHeader_1x01_P2.54mm_Vertical | Generic connector, single row, 01x01, script generated (kicad-library-utils/schlib/autogen/connector/)
J17, | 1 | Barrel_Jack_Switch | Barrel_Jack_Switch | Connector_BarrelJack:BarrelJack_CUI_PJ-102AH_Horizontal | DC Barrel Jack with an internal switch
J18, J19, | 2 | Conn_01x02 | Conn_01x02 | Connector_PinHeader_2.54mm:PinHeader_1x02_P2.54mm_Vertical | Generic connector, single row, 01x02, script generated (kicad-library-utils/schlib/autogen/connector/)
J20, | 1 | CSM3V3Cur | Conn_01x01 | Connector_PinHeader_2.54mm:PinHeader_1x01_P2.54mm_Vertical | Generic connector, single row, 01x01, script generated (kicad-library-utils/schlib/autogen/connector/)
J22, J21, | 2 | GND | Conn_01x01 | Connector_PinHeader_2.54mm:PinHeader_1x01_P2.54mm_Vertical | Generic connector, single row, 01x01, script generated (kicad-library-utils/schlib/autogen/connector/)
JP1, | 1 | 5V or Variable | Jumper_NC_Dual | Connector_PinHeader_2.54mm:PinHeader_1x03_P2.54mm_Vertical | Dual Jumper, normally closed
JP2, | 1 | ExtClkSel | Jumper_3_Open | Connector_PinHeader_2.54mm:PinHeader_1x03_P2.54mm_Vertical | Jumper, 3-pole, both open
JP3, | 1 | Power Ext or int | Jumper_3_Open | Connector_PinHeader_2.54mm:PinHeader_1x03_P2.54mm_Vertical | Jumper, 3-pole, both open
L1, | 1 | 120nH | L | Inductor_SMD:L_0402_1005Metric | Inductor
L2, | 1 | 1k500mA | L_Core_Ferrite | Inductor_SMD:L_0603_1608Metric | Inductor with Ferrite Core
L3, L4, L5, L6, | 4 | 1k/500mA | L_Core_Ferrite | Inductor_SMD:L_0603_1608Metric | Inductor with Ferrite Core
Q1, | 1 | IRF7807Z | IRF7807Z | Package_SO:SOIC-8_3.9x4.9mm_P1.27mm | Power MOSFET, 30V, 11A
Q2, | 1 | IRLML2502 | Q_NMOS_GSD | Package_TO_SOT_SMD:SOT-23 | Transistor N-MOSFETwith substrate diode (general)
Q3, | 1 | BSS138L | BSS138 | Package_TO_SOT_SMD:SOT-23 | 50V Vds, 0.22A Id, N-channel MOSFET, SOT-23
R3, R1, | 2 | 1R | R | Resistor_SMD:R_0603_1608Metric | Resistor
R5, R6, | 2 | 1K2, 1% | R | Resistor_SMD:R_0603_1608Metric | Resistor
R7, | 1 | 240R,1% | R | Resistor_SMD:R_0603_1608Metric | Resistor
R8, R11, | 2 | 33R, 0.5% | R_Small | Resistor_SMD:R_0603_1608Metric | Resistor, small symbol
R9, | 1 | 274R | R_Small | Resistor_SMD:R_0603_1608Metric | Resistor, small symbol
R10, R4, R2, | 3 | 10k | R | Resistor_SMD:R_0603_1608Metric | Resistor
R12, R13, R19, | 3 | 2k | R_Small | Resistor_SMD:R_0603_1608Metric | Resistor, small symbol
R14, R16, R15, R17, R20, | 5 | 1k | R_Small | Resistor_SMD:R_0603_1608Metric | Resistor, small symbol
R18, R27, R24, R25, R26, | 5 | 100R | R | Resistor_SMD:R_0603_1608Metric | Resistor
R22, | 1 | 22K | R | Resistor_SMD:R_0603_1608Metric | Resistor
R23, | 1 | 240R, 1% | R | Resistor_SMD:R_0603_1608Metric | Resistor
R28, R32, | 2 | 0R1 | R | Resistor_SMD:R_1206_3216Metric | Resistor
R30, R29, R21, R31, | 4 | 1k68 1% | R | Resistor_SMD:R_0603_1608Metric | Resistor
R33, R35, | 2 | 470R | R | Resistor_SMD:R_0603_1608Metric | Resistor
U1, | 1 | RB-0509D | NMA0509SC | Converter_DCDC:Converter_DCDC_muRata_NMAxxxxSC_THT | +/-55mA Isolated 1W Dual output DC/DC Converter Module, 5V Input Voltage, +/-9V Output Voltage, SIP3
U2, | 1 | REE-0505S | REE-0505S | Converter_DCDC:Converter_DCDC_muRata_NMAxxxxSC_THT | 200mA Isolated 1W Dual output DC/DC Converter Module, 5V Input Voltage, 5V Output Voltage, SIP7
U3, | 1 | LM317L_SO8 | LM317L_SO8 | Package_SO:SOIC-8_3.9x4.9mm_P1.27mm | 100mA 35V Adjustable Linear Regulator, SO-8
U4, | 1 | LM337L_SO8 | LM337L_SO8 | Package_SO:SOIC-8_3.9x4.9mm_P1.27mm | 100mA 35V Adjustable Negative Linear Regulator, SO-8
U5, | 1 | LD59015 | AP2204K-3.3 | cerg:sot323-5 | 150mA low dropout linear regulator, wide input voltage range, 3.3V fixed positive output, SOT-23-5 package
U6, | 1 | LP3985IM5-3.0 | LD3985G33R_TSOT23 | Package_TO_SOT_SMD:TSOT-23-5 | 150 mA Low Dropout Voltage Regulator, Fixed Output 3.3V, TSOT-23-5
U7, | 1 | AD8331 | AD8331 | cerg:QSOP-20_3.9x8.7mm_P0.635mm | Ultralow Noise VGAs with Preamplifier and Programmable Rin
U8, | 1 | TPS7A7100_VQFN20 | TPS7A7100_VQFN20 | Package_DFN_QFN:Texas_VQFN-RGW-20 | 1-A, Fast-Transient, Low-Dropout Voltage Regulator
U9, | 1 | AD9215 | AD9215 | Package_SO:TSSOP-28_4.4x9.7mm_P0.65mm | 10-Bit, 65/80/105 MSPS 3V A/D Converter
U10, U11, | 2 | INA225 | INA225 | Package_SO:MSOP-8_3x3mm_P0.65mm
U12, | 1 | LD1117S33TR_SOT223 | LD1117S33TR_SOT223 | Package_TO_SOT_SMD:SOT-223-3_TabPin2 | 800mA Fixed Low Drop Positive Voltage Regulator, Fixed Output 3.3V, SOT-223
