kammoh/fobos/oldfobos/temp/FOBOS_BOM.xlsx

Sheet: Sheet1
FOBOS INPUT/ OUTPUT SIGNALS
NAME | DIRECTION | ENTITY ID | ENTITY PIN | Source/ Destination

Sheet: Sheet2
FOBOS PARTS LIST
FOBOS PARTS
Component | # | Manufacturer | Man Part Num | Vendor | Part Number | Details | Schematic page | PR# | PO# | PO Date | Arrived? | Cost | Total
DAC | 1 | Analog Devices | AD9708ARZ | DIgi-key | AD9708ARZ-ND | sampling rate 125M/s, 28-SOIC (0.295", 7.50mm Width) | 2 |  |  |  |  | $7.34 | $7.34
LEDs | many | REICHELT |  |  |  | will need to be re-spec'ed | 2 |  |  |  |  |  | #VALUE!
Jumpers/ DIP switched |  |  |  |  |  |  | 2 |  |  |  |  |  | $0.00
IC1AD80XXOP1- OP AMP |  | Analog Devices | AD8058 | DIgi-key |  | AD8058 or THS3062 | 2 |  |  |  |  |  | $0.00
BNC port | 1 |  |  |  |  | PU-SMA-V | 2
LT1763NC/G1/G2 |  | LTI | LT1763 | DIgi-key |  | power regulator, exact specs TBD | 1
Test points |  |  |  |  |  |  | 1
Resistors |  |  |  |  |  |  | 1
Capacitors |  |  |  |  |  |  | 1
ADC |  | Analog Devices | AD9283 | DIgi-key | AD9283BRSZ-50-ND |  | 3
multiplexer |  | Analog Devices | AD8183 | DIgi-key |  |  | 3
ISO7816 card interface |  |  |  |  |  |  | 4
Total |  |  |  |  |  |  |  |  |  |  |  |  | $-
USB_FPGA_MODULE 1.11 CONNECTORS
Component | # | Manufacturer | Man Part Num | Vendor | Part Number | Details | Schematic page | PR# | PO# | PO Date | Arrived? | Cost | Total
CON1_ABE_FPGA
ABE_FX2
JTAG
CDF_FX2
CDF_PWR
ABE_PWR
Total |  |  |  |  |  |  |  |  |  |  |  |  | $-
