kammoh/fobos/hardware/fobos-dut/dut-artix7-a12t-cpg238/Outputs/BOM/BOM_dut-artix7-a12t-cpg238.xlsx

Sheet: Project
Artix-7 DUT
Ref# | Qty. | Value | Size | Mouser # | Mfr. # | Manufacturer | Description
R29 R30 R37 R67 | 4 | 0R | 0603 | 603-RC0603JR-070RL | RC0603JR-070RL | Yageo | Thick Film Resistors - SMD 0 Ohms 100 mW 0603 5%
R23 | 1 | 0R1 | 1206 | 71-WSL1206R1000DEA | WSL1206R1000DEA | Vishay | Current Sense Resistors - SMD 1/4watt .1ohms .5%
R24 | 1 | 49R9 | 0603 | 652-CR0603FX-49R9ELF | CR0603-FX-49R9ELF | Bourns | Thick Film Resistors - SMD 49.9 ohm 1%
R75 R76 | 2 | 0R1 | 0805 | 588-KDV08FR100ET | KDV08FR100ET | Ohmite | Current Sense Resistors - SMD 0.1 ohm 0805 1% 0.25W
R22 | 1 | 100R | 0603 | 603-RC0603FR-13100RL | RC0603FR-13100RL | Yageo | Thick Film Resistors - SMD 100 OHM 1%
R36 R77 R78 | 3 | 1k | 0603 | 603-RC0603FR-071KL | RC0603FR-071KL | Yageo | Thick Film Resistors - SMD 1K OHM 1%
R35 R42 R43 R44 R45 R51 R60 R61 R62 R63 R64 R65 R66 R68 R70 R71 R73 R74 | 18 | 10k | 0603 | 603-RC0603FR-0710KL | RC0603FR-0710KL | Yageo | Thick Film Resistors - SMD 10K OHM 1%
R38 R39 R40 R49 | 4 | 100k | 0603 | 652-CR0603-FX-103ELF | CR0603-FX-1003ELF | Bourns | Thick Film Resistors - SMD 100K 1% 1/10 WATT
R21 | 1 | 1M | 0603 | 652-CR0603FX-1004ELF | CR0603-FX-1004ELF | Bourns | Thick Film Resistors - SMD 1M 1% 1/10W
R46 R47 | 2 | 120k | 0603 | 603-RC0603FR-13120KL | RC0603FR-13120KL | Yageo | Thick Film Resistors - SMD 120 kOhms 100-200 mW 0603 1%
R7 R8 R9 R10 R11 R12 R19 R20 R53 R72 | 10 | 200R | 0603 | 603-RC0603FR-07200RL | RC0603FR-07200RL | Yageo | Thick Film Resistors - SMD 200 OHM 1%
R1 R2 R3 R4 R5 R6 R13 R14 R15 R16 R17 R18 | 12 | 22R | 0603 | 603-RC0603FR-0722RL | RC0603FR-0722RL | Yageo | Thick Film Resistors - SMD 22 OHM 1%
R27 R28 R56 | 3 | 33R, 0.5% | 0603 | 667-ERA-3AHD330V | ERA-3AHD330V | Panasonic | Thin Film Resistors - SMD 0603 33ohms 50ppm 0.5% AEC-Q200
R34 | 1 | 3k48 | 0603 | 603-RC0603FR-073K48L | RC0603FR-073K48L | Yageo | Thick Film Resistors - SMD 3.48 kOhms 100mW 0603 1%
R57 R58 R59 R69 | 4 | 470R | 0603 | 603-RC0603FR-10470RL | RC0603FR-10470RL | Yageo | Thick Film Resistors - SMD 470 OHM 1%
R25 R26 R31 R32 R33 R41 R52 R54 R55 | 9 | 4k7 | 0603 | 603-RC0603FR-134K7L | RC0603FR-134K7L | Yageo | Thick Film Resistors - SMD 4.7 kOhms 100-200mW 0603 1%
R48 | 1 | 57k6 | 0603 | 652-CR0603FX-5762ELF | CR0603-FX-5762ELF | Bourns | Thick Film Resistors - SMD 57.6K ohm 1%
R50 | 1 | 800R | 0603 | 603-RC0603FR-07806RL | RC0603FR-07806RL | Yageo | Thick Film Resistors - SMD 806 Ohms 100 mW 0603 1%
C8 | 1 | 10nF | 0603 | 603-CS0603KRX79BB103 | CS0603KRX7R9BB103 | Yageo | Multilayer Ceramic Capacitors MLCC - SMD/SMT 10 nF 50 V 10% Ceramic Capacitors
C1 C2 C3 C4 C5 C9 C11 C13 C14 C16 C24 C54 C57 C58 | 14 | 100nF | 0603 | 77-VJ0603Y104JXQPBC | VJ0603Y104JXQPW1BC | Vishay / Vitramon | Multilayer Ceramic Capacitors MLCC - SMD/SMT 0603 0.1uF 10volts X7R 5%
C6 C10 C22 C23 | 4 | 10uF | 0805 | 81-GRM21BC81C106MA3L | GRM21BC81C106MA73L | Murata Electronics | Multilayer Ceramic Capacitors MLCC - SMD/SMT 0805 10uF 16volts X6S 20%
C18 C19 C20 | 3 | 20pF | 0603 | 80-C0603C200K8HACTU | C0603C200K8HACTU | KEMET | Multilayer Ceramic Capacitors MLCC - SMD/SMT 10V 20pF X8R 0603 10%
C15 | 1 | 2u2F | 0805
C17 C21 | 2 | 22uF | 0805 | 187-CL21A226KQCLRNC | CL21A226KQCLRNC | Samsung | Multilayer Ceramic Capacitors MLCC - SMD/SMT 22uF+/-10% 6.3V X5R 2012
C12 | 1 | 4n7F | 0603 | 710-885012206087 | 885012206087 | Wurth Electronics | Multilayer Ceramic Capacitors MLCC - SMD/SMT WCAP-CSGP 4700pF 0603 10% 50V MLCC
C29 C30 C31 C32 C33 C34 C35 C36 C42 C43 C44 C45 C46 C50 C51 C52 C53 C56 | 18 | 470nF | 0402 | 963-JMK105BJ474KV-F | JMK105BJ474KV-F | Taiyo Yuden | CAP CER 0.47UF 6.3V X5R 0402
C25 C26 C27 C28 C40 C41 C48 C49 | 8 | 4.7uF | 0402 | 81-GRM155R60J475ME8J | GRM155R60J475ME87J | Murata Electronics | CAP CER 4.7UF 6.3V X5R 0402
C37 C39 C47 C55 | 4 | 47uF | 0603 | 81-GRM21BR60J476ME5K | GRM21BR60J476ME15K | Murata Electronics | Multilayer Ceramic Capacitors MLCC - SMD/SMT 0805 47uF 6.3volts
C7 | 1 | 47uF | 0805 | 81-GRT21BR60J476ME3L | GRT21BR60J476ME13L | Murata Electronics | Multilayer Ceramic Capacitors MLCC - SMD/SMT 47UF 6.3V 20% 0805
C38 | 1 | 100uF | 1210 | 81-GRM32ER61A107ME0L | GRM32ER61A107ME0L | Murata Electronics | Multilayer Ceramic Capacitors MLCC - SMD/SMT 1210 100uF 10V
L1 L2 | 2 | 1k/500mA | 0603 | 963-FBMH1608HM102-T | FBMH1608HM102-T | Taiyo Yuden | Ferrite Beads HI CUR CHIP BD 0603 1000OHMS 25%
L3 | 1 | 1.5uH |  | 652-SRN2012-1R5M | SRN2012-1R5M | Bourns Inc. | FIXED IND 1.5UH 1.8A 108MOHM SMD
L4 | 1 | 3.3uH |  | 963-BRC2012T3R3MD | BRC2012T3R3MD | Taiyo Yuden | FIXED IND 3.3UH 870MA 221MOHM SM
L5 | 1 | 2.2uH |  | 652-SRN2010-2R2M | SRN2010-2R2M | Bourns Inc. | FIXED IND 2.2UH 1.7A 170MOHM SMD
D1 D2 D3 D4 D5 D6 | 6 | green | 0603 | 604-APT1608CGCK | APT1608CGCK | Kingbright | Standard LEDs - SMD Green Water Clear 570nm 40mcd 120deg
Q3 Q4 Q5 Q6 Q7 | 5 | BSS138L | SOT-23-3 | 512-BSS138L | BSS138L | ON Semiconductor | MOSFET 0.20A, 50V N-Channel SOT-23 MOSFET
Q1 | 1 | FDS9435A | SOIC-8 | 512-FDS9435A | FDS9435A | ON Semiconductor/Fairchild | MOSFET SO-8 SGL P-CH -30V
Q2 Q8 | 2 | 3904 | SOT-23-3 | 863-MMBT3904LT1G | MMBT3904LT1G | ON Semiconductor | Bipolar Transistors - BJT NPN GENERAL PURPOSE
U8 | 1 | LTC3569EFE#PBF | 16TSSOP | LTC3569EFE#PBF | LTC3569EFE#PBF | Analog Devices Inc. | Switching Voltage Regulators Programmable 1.2A and 2X600mA, Triple Buck Regulator
U5 | 1 | INA225 | MSOP-8 | 595-INA225AIDGKT | INA225AIDGKT | Texas Instruments | Current Sense Amplifiers 36V Bidir 0-Drift Ser Crnt-Shunt Mon
U7 | 1 | TS3A5018DBQR | 16SSOP | 595-TS3A5018DBQR | TS3A5018DBQR | Texas Instruments | Analog Switch ICs 10-Ohm Quad SPDT Analog Switch
U9 | 1 | IS25LP256D-JMLE | 16SOIC | IS25LP256D-JMLE | IS25LP256D-JMLE | ISSI, Integrated Silicon Solution Inc | NOR Flash 256M 3V 166MHZ Serial Flash
U6 | 1 | BGA2801 | SOT-363 | 771-BGA2801115 | BGA2801,115 | NXP USA Inc. | RF Amplifier 6CH MMIC Amp 3.8 dB 3.3V 14.3mA 2.8GHz
U1 | 1 | XC7A12T-cpg238 | CPG238 | 217-XC7A12T-1CPG238C | XC7A12T-1CPG238C | Xilinx | FPGA - Field Programmable Gate Array XC7A12T-1CPG238C
F1 | 1 | MF-MSMF050-2 | 1206 | 667-ERB-RG2R00V | ERB-RG2R00V | Panasonic Electronic Components | FUSE BOARD MOUNT 2A 63VDC 1206
U2 U3 U4 U10 U11 | 5 | Fuse | MSOP-10 | 576-SP3003-04ATG | SP3003-04ATG | Littelfuse | ESD Suppressors / TVS Diodes 4 Ch 8kV 0.65pF SPA
J10 | 1 | Barrel Jack |  | 490-PJ-102AH | PJ-102AH | CUI | DC Power Connectors Power Jacks
J4 | 1 | SMA Edge |  | 530-142-0701-801 | 142-0701-801 | Johnson / Cinch Connectivity Solutions | RF Connectors / Coaxial Connectors PC END MT JCK GLD .062" BOARD THICK
J6 J9 | 2 | SMA Vertical |  | 712-CONSMA008-G | CONSMA008-G | Linx Technologies | RF Connectors / Coaxial Connectors SMA Female PCB Mnt, Extended, Gold
J1 | 1 | Shrd Hdr | 2x10 | 517-30320-5002 | 30320-5002HB | 3M Electronic Solutions Division | Headers & Wire Housings 20P R/A 4WALL GLDFL
JP1, JP2, JP3, JP4 | 1 | Pin Header | 1x36 | 649-68001-236HLF | 68001-236HLF | Amphenol FCI | Headers & Wire Housings 36P HDR
J5 | 1 | Molex | 1x2-P2.54mm | 538-22-11-2022 | 22-11-2022 | Molex | Connector_Molex:Molex_KK-254_AE-6410-02A_1x02_P2.54mm_Vertical, gold
J7 | 1 | Shrd Hdr | 2x7 2mm | 538-87832-1420 | 878321420 | Molex | Headers & Wire Housings 14P SMD PB FREE SHRD
J3 J8 | 2 | 575-8 |  | 534-575-8 | 575-8 | Keystone Electronics | CONN BANANA JACK SOLDER
J2 | 1 | Pin Socket | 2x6 90 deg | 200-SSW10602FDRA | SSW-106-02-F-D-RA | Samtec | Board to Board & Mezzanine Connectors Tiger Buy Socket Strip with PCB Tails, 0.100 Pitch
TP1 TP2 TP3 TP4 TP5 TP6 TP7 TP8 TP9 | 9 | 5281 |  | 534-5281 | 5281 | Keystone Electronics | Circuit Board Hardware - PCB TEST POINT BLACK MULTIPURPOSE
S1 | 1 | JS202011SCQN |  | 611-JS202011SCQN | JS202011SCQN | C&K | SWITCH SLIDE DPDT 300MA 6V
S2 S3 S4 S5 | 4 | 1825910-6 |  |  | 1825910-6 | TE Connectivity ALCOSWITCH Switches | SWITCH TACTILE SPST-NO 0.05A 24V
SW1 SW2 | 2 | SW_DIP_x03 |  | 490-DS04254203BK-SMT | DS04-254-2-03BK-SMT | CUI Devices | DIP SWITCH, SPST, 2.54 PITCH, FL
The following components are DNI
R37 R77 C48 C49 C50 C51 C52 C53

Sheet: MTC
FOBOS 3 MTC
C1, C4, C5, C6, C7 | 5 | 100nF | 0603 | 77-VJ0603Y104JXQPBC | VJ0603Y104JXQPW1BC | Vishay / Vitramon | Multilayer Ceramic Capacitors MLCC - SMD/SMT 0603 0.1uF 10volts X7R 5% | #REF! | #REF!
C2 | 1 | 10uF | 0805 | 81-GRM21BC81C106MA3L | GRM21BC81C106MA73L | Murata Electronics | Multilayer Ceramic Capacitors MLCC - SMD/SMT 0805 10uF 16volts X6S 20% | #REF! | #REF!
C3 | 1 | 47uF | 0805 | 81-GRM21BR60J476ME5K | GRM21BR60J476ME15K | Murata Electronics | Multilayer Ceramic Capacitors MLCC - SMD/SMT 0805 47uF 6.3volts | #REF! | #REF!
D1 | 1 | green | 0603 | 604-APT1608CGCK | APT1608CGCK | Kingbright | Standard LEDs - SMD Green Water Clear 570nm 40mcd 120deg | #REF! | #REF!
F1 | 1 | Fuse | 1812 | 652-MF-MSMF050-2 | MF-MSMF050-2 | Bourns | Resettable Fuses - PPTC 0.50A 15V 0.15ohm AEC-Q200 | #REF! | #REF!
J1, J2, J3, J4 | 1 | Pin Header | 2x36 | 649-67997-272HLF | 67997-272HLF | Amphenol FCI | Headers & Wire Housings BREAKAWAY HEADER 72 | #REF! | #REF!
J5 | 1 | Shrd Hdr | 2x10 | 517-30320-5002 | 30320-5002HB | 3M Electronic Solutions Division | Headers & Wire Housings 20P R/A 4WALL GLDFL | #REF! | #REF!
J6, J7, JP2, JP3, JP4 | 1 | Pin Header | 1x36, 90deg | 710-61303611021 | 61303611021 | Wurth Electronics | Headers & Wire Housings WR-PHD 2.54mm Hdr 36P Single RA Gold | #REF! | #REF!
J8, J9 | 2 | SMA Edge |  | 530-142-0701-801 | 142-0701-801 | Johnson / Cinch Connectivity Solutions | RF Connectors / Coaxial Connectors PC END MT JCK GLD .062" BOARD THICK | #REF! | #REF!
J10, J11 | 2 | Pin Socket | 2x10 | 517-929852-01-10-RB | 929852-01-10-RB | 3M | Headers & Wire Housings 20/2R/BM SKT/.100 STR/.125/30AVE/ROHS | #REF! | #REF!
J12, J13 | 2 | Pin Header | 2x36, 90deg | 710-61303621021 | 61303621021 | Wurth Electronics | Headers & Wire Housings WR-PHD 2.54mm Hdr 36P Dual RA Gold | #REF! | #REF!
JP1 | 1 | Pin Header | 1x36 | 649-68001-236HLF | 68001-236HLF | Amphenol FCI | Headers & Wire Housings 36P HDR | #REF! | #REF!
L1 | 1 | 1k/500mA | 0603 | 963-FBMH1608HM102-T | FBMH1608HM102-T | Taiyo Yuden | Ferrite Beads HI CUR CHIP BD 0603 1000OHMS 25% | #REF! | #REF!
Q1 | 1 | BSS138L | SOT-23-3 | 512-BSS138L | BSS138L | ON Semiconductor | MOSFET 0.20A, 50V N-Channel SOT-23 MOSFET | #REF! | #REF!
Q2 | 1 | BSS84 | SOT-23-3 | 726-BSS84PH6327 | BSS84P H6327 | Infineon | MOSFET P-Ch -60V -170mA SOT-23-3 | #REF! | #REF!
R1, R9, R10, R11, R12, R13, R14, R15, R16, R17, R18, R19 | 12 | 22R | 0603 | 603-RC0603FR-0722RL | RC0603FR-0722RL | Yageo | Thick Film Resistors - SMD 22 OHM 1% | #REF! | #REF!
R2, R3, R6, R7 | 4 | 10k | 0603 | 603-RC0603FR-0710KL | RC0603FR-0710KL | Yageo | Thick Film Resistors - SMD 10K OHM 1% | #REF! | #REF!
R4 | 1 | 1R | 1206 | 660-SR732BTTD1R00D | SR732BTTD1R00D | KOA Speer | Current Sense Resistors - SMD 1 OHM .5%, 330mW | #REF! | #REF!
R5 | 1 | 470R | 0603 | 603-RC0603FR-10470RL | RC0603FR-10470RL | Yageo | Thick Film Resistors - SMD 470 OHM 1% | #REF! | #REF!
R8 | 1 | 10R | 1210 | 660-SR732ETTE10R0F | SR732ETTE10R0F | KOA Speer | Current Sense Resistors - SMD 10ohms 1% 100 PPM, 500mW | #REF! | #REF!
U1, U2, U3 | 3 | Fuse | MSOP-10 | 576-SP3003-04ATG | SP3003-04ATG | Littelfuse | ESD Suppressors / TVS Diodes 4 Ch 8kV 0.65pF SPA | #REF! | #REF!
 |  |  |  |  |  |  |  | #REF! | #REF!
