kammoh/fobos/oldfobos/doc/Presentations/SpeedAnalysis/speed-analysis.ods

Sheet: Osciloscopes
Manufacturer | Model | Sample Rate | Resolution | Bandwidth | Price | Connection | Acquisition Speed
 |  |  |  |  |  |  | [traces/sec]
FOBOS 3 | OpenADC | 105 MS/S | 10 bits | 40 MHz | $137.00 | AXI Stream | 200
Rigol | DS1054Z | 1 GS/S | 8 bits | 50 MHz | $375.00 | Ethernet | 6
FOBOS 4 |  | 1 GS/S | 8 bits | 500 MHz | $500.00 | AXI Stream | 200
Picoscope | 6402C | 5 GS/S | 8 bits | 250 MHz | $3,300.00 | USB 3 | 8000
Agilent | DSO6054A | 4 GS/S | 8 bits | 500 MHz | $10,000.00 | Ethernet | 10
Tektronix | DPO7054C | 20 GS/S | 8 bits | 500 MHz | $21,400.00 | PCI Express | 8000
1 Trace = 2000 samples
19.53 | Msps
2000 | Samples 8 bit each
0.0001024066 | time per trace
9765 | traces
1. Ethernet mounted drive vs sd card
2. Collection loop in C

Sheet: Speed Analysis
 | Secret Key | Public Key
 | AES | RSA
Input size [bits] | 128 | 4096
Transmission at 500 kHz, 4-bit bus [sec] | 0.000064 | 0.002048
For 1 Million vectors [sec] | 64 | 2048 |  | 1.00E-03 | 1000 | 16.6666666667
For 1 Billion vectors [hrs] | 17.78 | 568.89 |  | 1000
Transmission at 5 MHz, 4-bit bus [sec] | 0.0000064 | 0.0002048
For 1 Million vectors [sec] | 6.4 | 204.8
For 1 Billion vectors [hrs] | 1.78 | 56.89
clock cycles | 11 | 16,777,216
Computation 1 encryption, at 500 kHz [sec] | 0.000022 | 33.554432 | 45454.5454545455 | 0.0298023224
For 1 Million vectors [sec] | 22 | 33,554,432 | 388.3614814815
For 1 Billion vectors [hrs] | 6.11 | 9,320,676 | 107.8781893004
Computation 1 encryption, at 5 MHz [sec] | 0.0000022 | 3.3554432
For 1 Million vectors [sec] | 2.2 | 3,355,443 | 38.8361481481
For 1 Billion vectors [hrs] | 0.61 | 932,068 | 10.78781893
Oscilloscope Speed, 1000 samples/trace [traces/sec] | 2 | 10 | 200
For 1 Million vectors [hrs] | 138.89 | 27.78 | 1.39
[days] | 5.79
For 1 Billion vectors [days] | 5787.04 | 1157.41 | 57.87
[days] | 241.13 | 48.23 | 2.41
