kammoh/fobos/hardware/fobos-dut/dut-cyclone10-10cl016-u256/3d models/BELFUSE_1050753001/105-0753-001.stp

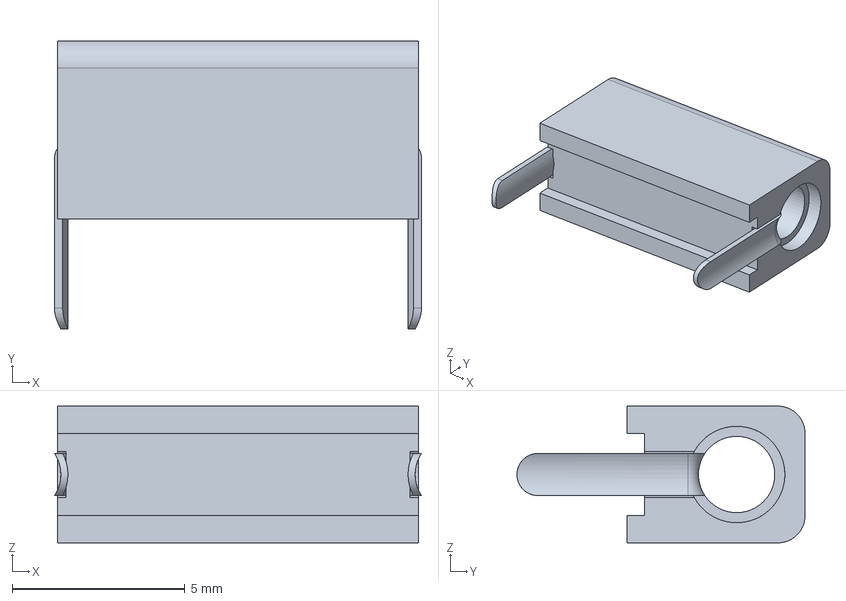
[picture p122: CAD file, 2021-01-13]
hardware/fobos-dut/dut-cyclone10-10cl016-u256/3d models/BELFUSE_1050753001/105-0753-001.stp
10.6 x 8.34 x 3.96 mm
