kammoh/fobos/hardware/fobos-dut/dut-cyclone10-10cl016-u256/3d models/BELFUSE_1420701201/142-0701-201.stp

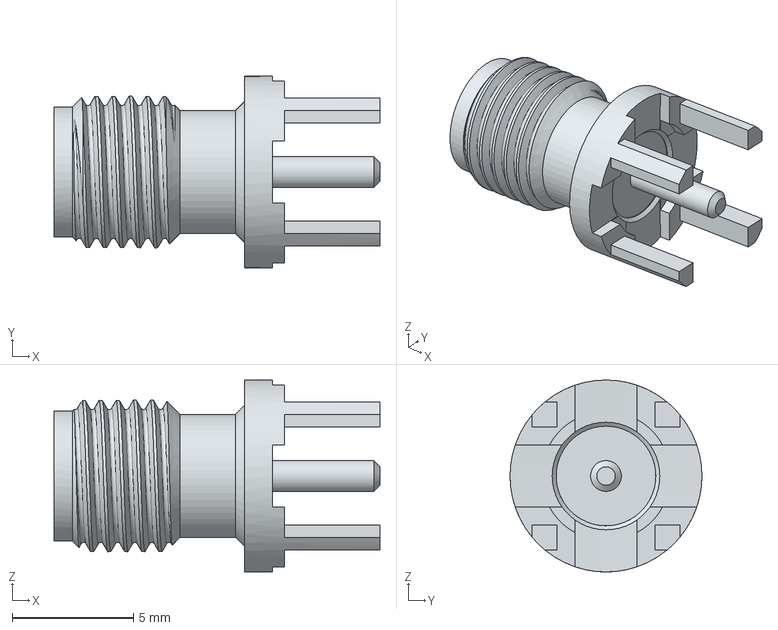
[picture p123: CAD file, 2021-06-06]
hardware/fobos-dut/dut-cyclone10-10cl016-u256/3d models/BELFUSE_1420701201/142-0701-201.stp
13.5 x 7.92 x 7.92 mm
