kammoh/fobos/hardware/fobos-dut/dut-cyclone10-10cl016-u256/3d models/ENG_CVM_CVM_1825910-6_C.3d_stp/c-1825910-6-c-3d.stp

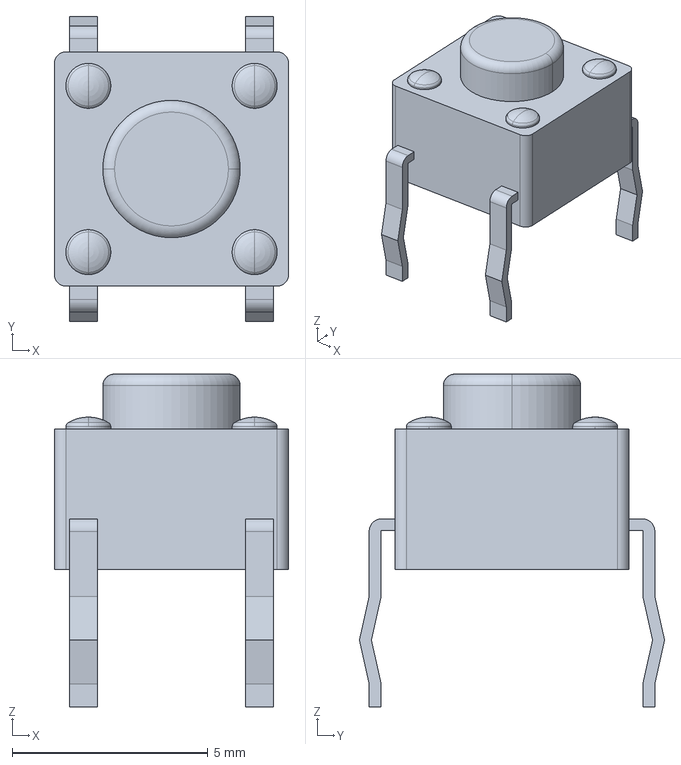
[picture p124: CAD file, 2021-02-05]
hardware/fobos-dut/dut-cyclone10-10cl016-u256/3d models/ENG_CVM_CVM_1825910-6_C.3d_stp/c-1825910-6-c-3d.stp
5.99 x 7.80 x 8.51 mm
