kammoh/fobos/hardware/fobos-dut/dut-cyclone10-10cl016-u256/3d models/SBH11-_ _ _C-D05-ST-_ _.IGS

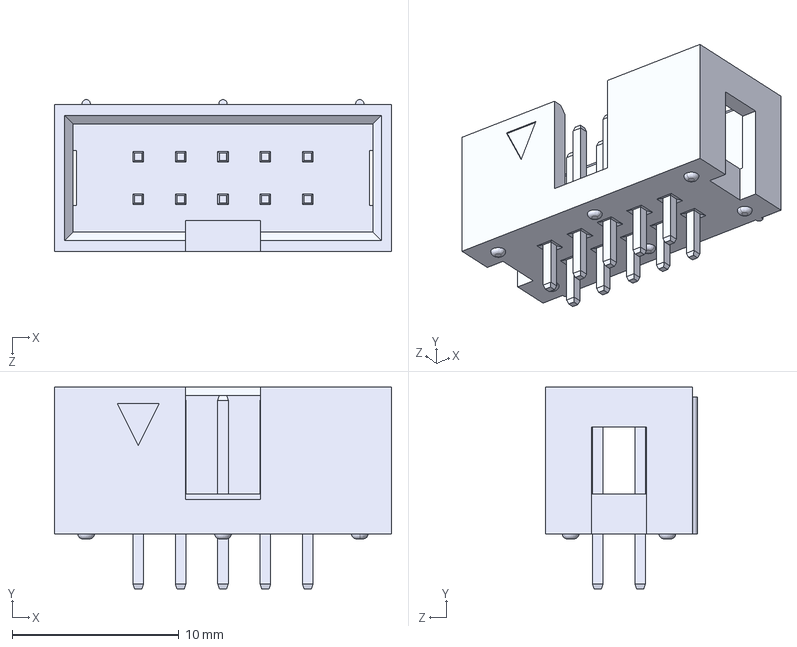
[picture p125: CAD file, 2022-05-28]
hardware/fobos-dut/dut-cyclone10-10cl016-u256/3d models/SBH11-_ _ _C-D05-ST-_ _.IGS
20.2 x 12.1 x 9.10 mm
