kammoh/fobos/hardware/fobos-dut/dut-cyclone10-10cl016-u256/cerg_3d_models/CUI_DEVICES_DS04-254-2-03BK-SMT-TR.step

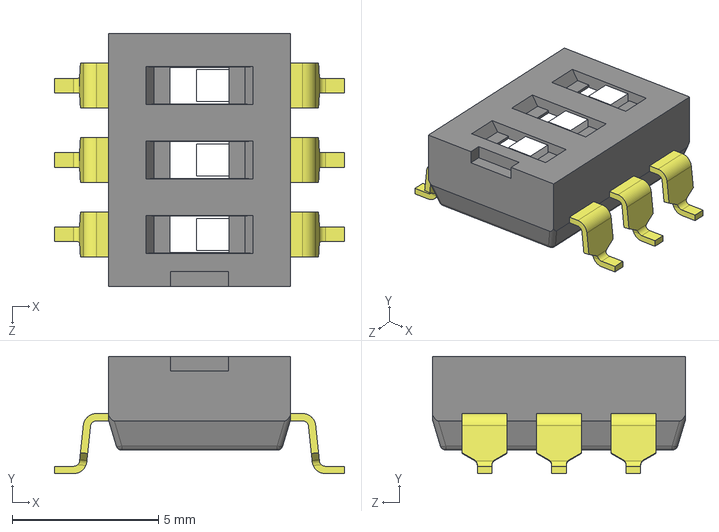
[picture p126: CAD file, 2022-05-28]
hardware/fobos-dut/dut-cyclone10-10cl016-u256/cerg_3d_models/CUI_DEVICES_DS04-254-2-03BK-SMT-TR.step
9.90 x 4.00 x 8.62 mm
