kammoh/fobos/hardware/fobos-dut/dut-spartan7-s15-cpga196/3d models/CUI_PJ-102AH.step

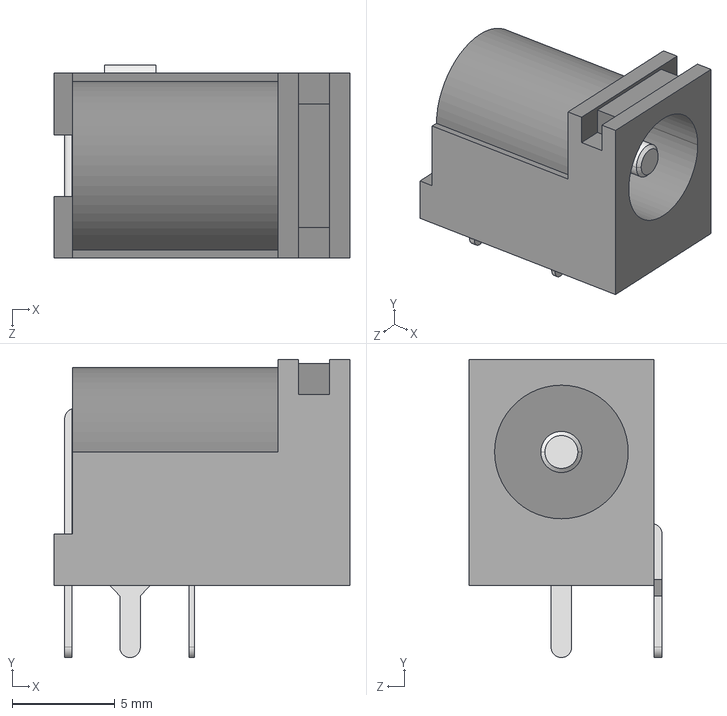
[picture p128: CAD file, 2021-02-15]
hardware/fobos-dut/dut-spartan7-s15-cpga196/3d models/CUI_PJ-102AH.step
14.4 x 14.5 x 9.40 mm
