kammoh/fobos/hardware/fobos-dut/dut-spartan7-s15-cpga196/cerg_3d_models/User Library-SSOP16.step

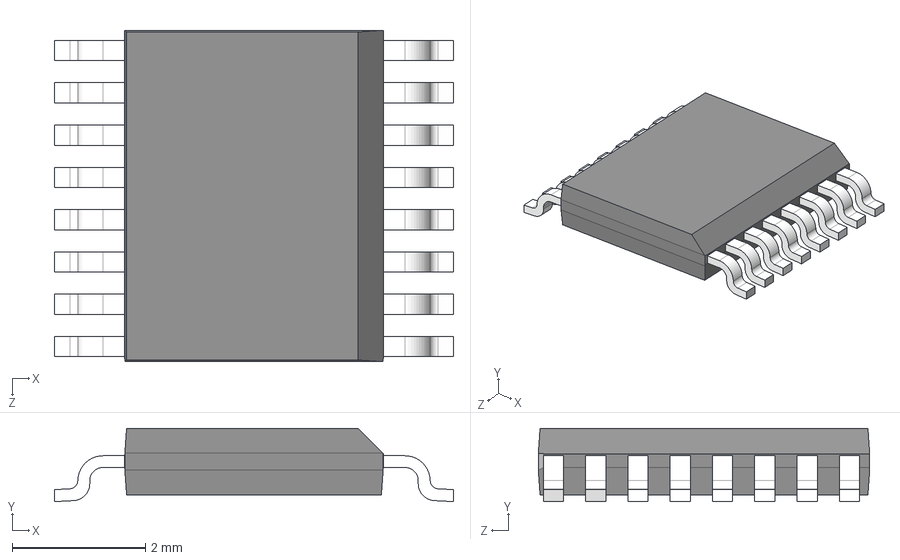
[picture p129: CAD file, 2021-02-15]
hardware/fobos-dut/dut-spartan7-s15-cpga196/cerg_3d_models/User Library-SSOP16.step
5.99 x 1.10 x 4.98 mm
