kammoh/fobos/hardware/fobos-dut/dut-cyclone10-10cl016-u256/3d models/SRN2012 series.stp

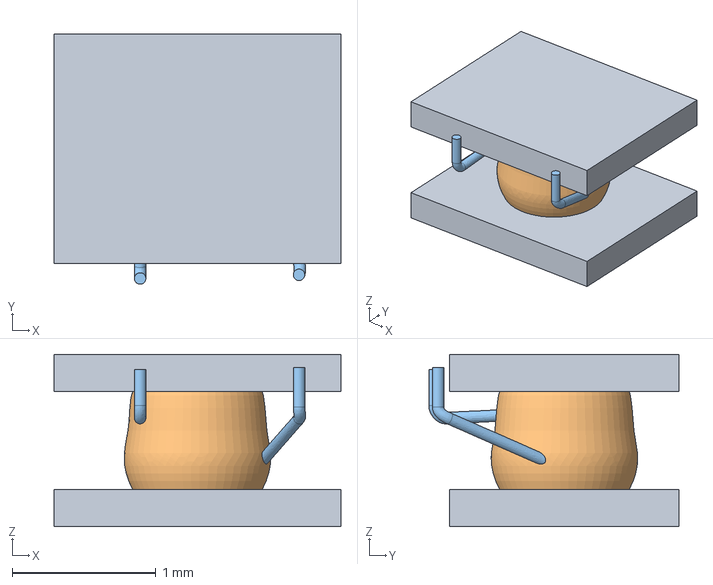
[picture p130: CAD file, 2021-02-05]
hardware/fobos-dut/dut-cyclone10-10cl016-u256/3d models/SRN2012 series.stp
2.00 x 1.75 x 1.20 mm
