kammoh/fobos/hardware/fobos-dut/dut-cyclone10-10cl016-u256/3d models/BRC2012T3R3MD.STEP

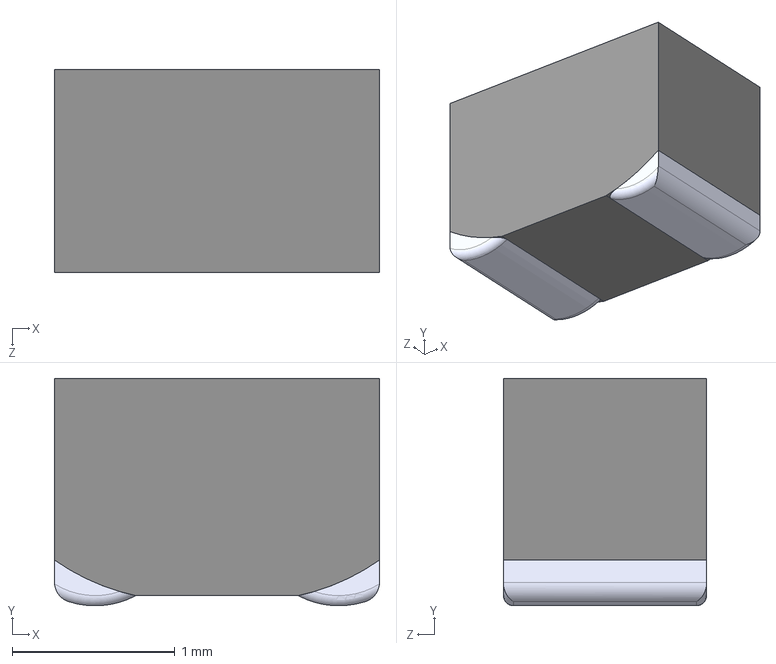
[picture p131: CAD file, 2021-02-05]
hardware/fobos-dut/dut-cyclone10-10cl016-u256/3d models/BRC2012T3R3MD.STEP
2.00 x 1.40 x 1.25 mm
