kammoh/fobos/hardware/fobos-dut/dut-cyclone10-10cl016-u256/cerg_3d_models/TSSOP-16_FEBA_LIT.step

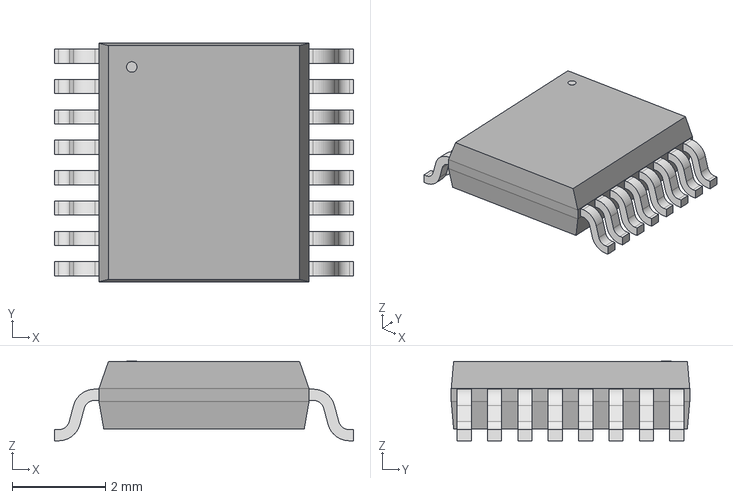
[picture p132: CAD file, 2021-01-13]
hardware/fobos-dut/dut-cyclone10-10cl016-u256/cerg_3d_models/TSSOP-16_FEBA_LIT.step
6.40 x 5.11 x 1.70 mm
