kammoh/fobos/hardware/fobos-dut/dut-cyclone10-10cl016-u256/cerg_3d_models/PVQFN16.step

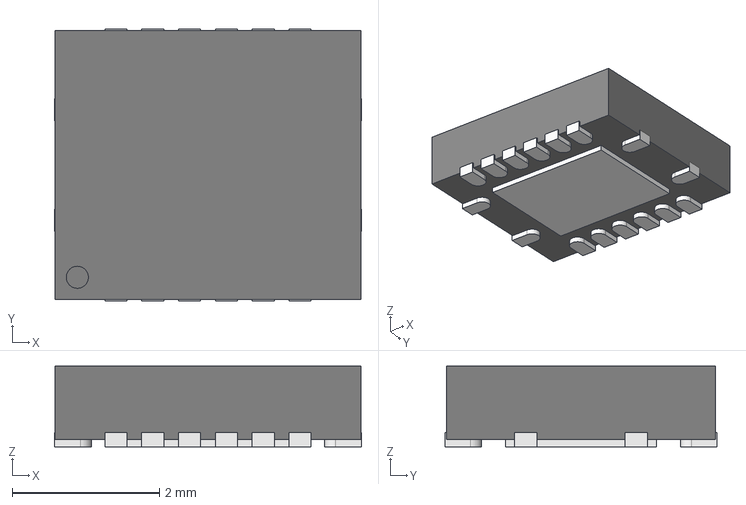
[picture p133: CAD file, 2019-05-30]
hardware/fobos-dut/dut-cyclone10-10cl016-u256/cerg_3d_models/PVQFN16.step
4.17 x 3.70 x 1.10 mm
