kammoh/fobos/hardware/fobos-dut/dut-spartan7-s15-cpga196/cerg_3d_models/SMA_Board_Edge_Molex_732511150.step

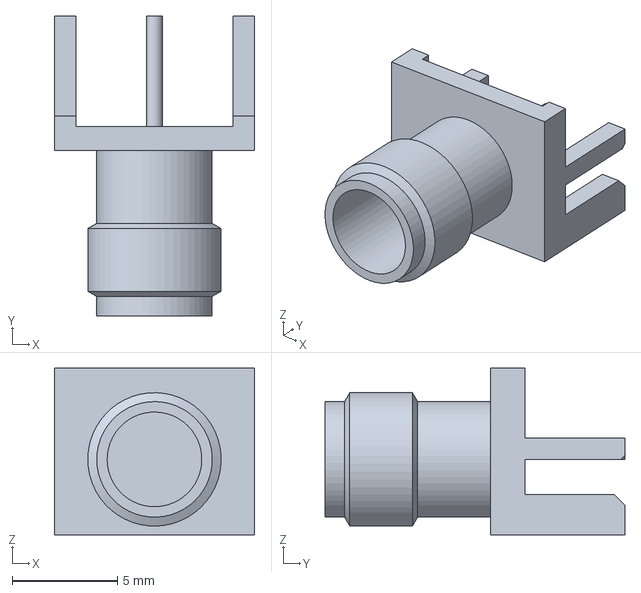
[picture p134: CAD file, 2019-05-30]
hardware/fobos-dut/dut-spartan7-s15-cpga196/cerg_3d_models/SMA_Board_Edge_Molex_732511150.step
9.53 x 14.3 x 7.93 mm
