kammoh/fobos/hardware/fobos-dut/dut-cyclone10-10cl016-u256/cerg_3d_models/SSOP-20.step

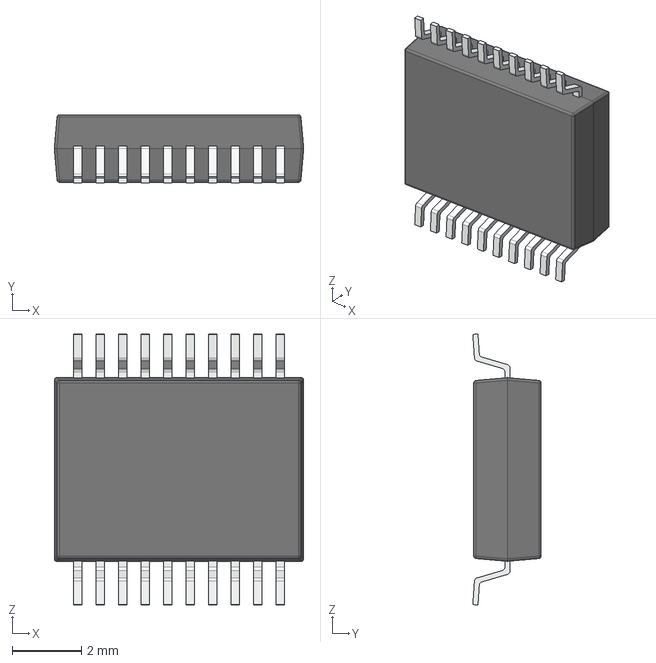
[picture p135: CAD file, 2019-05-30]
hardware/fobos-dut/dut-cyclone10-10cl016-u256/cerg_3d_models/SSOP-20.step
7.20 x 1.98 x 7.82 mm
