kammoh/fobos/hardware/fobos-dut/dut-spartan7-s15-cpga196/3d models/keystone-PN575-8.STEP

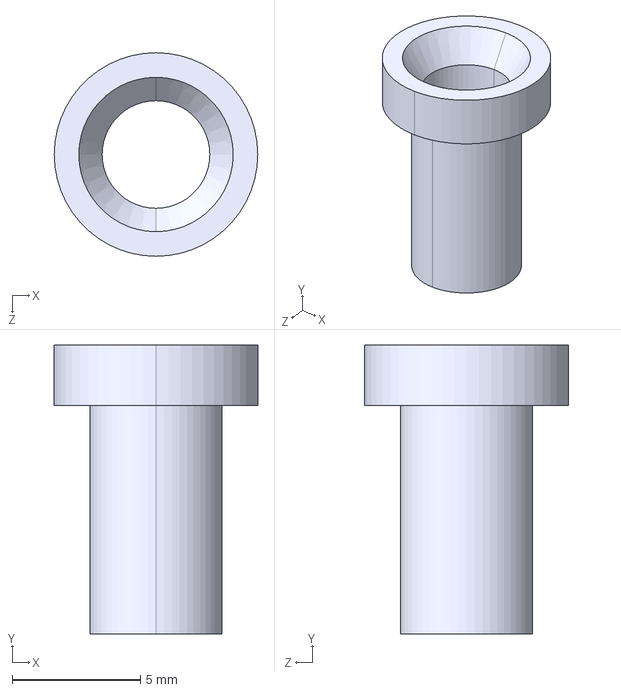
[picture p136: CAD file, 2021-02-05]
hardware/fobos-dut/dut-spartan7-s15-cpga196/3d models/keystone-PN575-8.STEP
7.92 x 11.3 x 7.92 mm
