kammoh/fobos/hardware/fobos-dut/dut-spartan7-s15-cpga196/3d models/keystone-PN5281.STEP

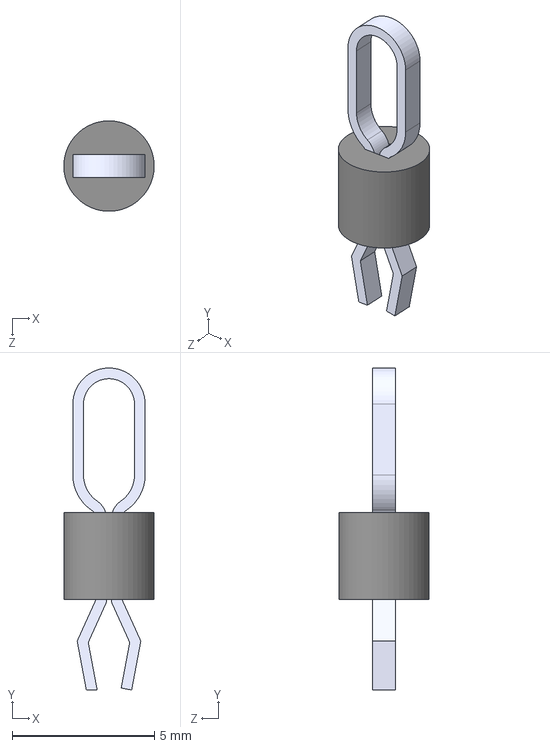
[picture p137: CAD file, 2021-01-13]
hardware/fobos-dut/dut-spartan7-s15-cpga196/3d models/keystone-PN5281.STEP
3.17 x 11.3 x 3.17 mm
