kammoh/fobos/(list of files, cad)

Other CAD files:
hardware/fobos-dut/dut-cyclone10-10cl016-u256/3d models/87832-1420_stp/878321420.stp
hardware/fobos-dut/dut-cyclone10-10cl016-u256/3d models/91772A106_18-8 SS PAN HEAD PHILLIPS MACHINE SCREW.STEP
hardware/fobos-dut/dut-cyclone10-10cl016-u256/3d models/91780A537_ALUM FEM THRDED HEX STANDOFF.STEP
hardware/fobos-dut/dut-cyclone10-10cl016-u256/cerg_3d_models/JS202011SCQN.stp
hardware/fobos-dut/dut-spartan7-s15-cpga196/3d models/87832-1420_stp/878321420.stp
hardware/fobos-dut/dut-spartan7-s15-cpga196/3d models/91772A106_18-8 SS PAN HEAD PHILLIPS MACHINE SCREW.STEP
hardware/fobos-dut/dut-spartan7-s15-cpga196/3d models/91780A537_ALUM FEM THRDED HEX STANDOFF.STEP
hardware/fobos-dut/dut-spartan7-s15-cpga196/cerg_3d_models/JS202011SCQN.stp
hardware/fobos-shield/js202011scqn.stp
