kammoh/fobos/oldfobos/doc/UserGuide/figures/compression.pdf

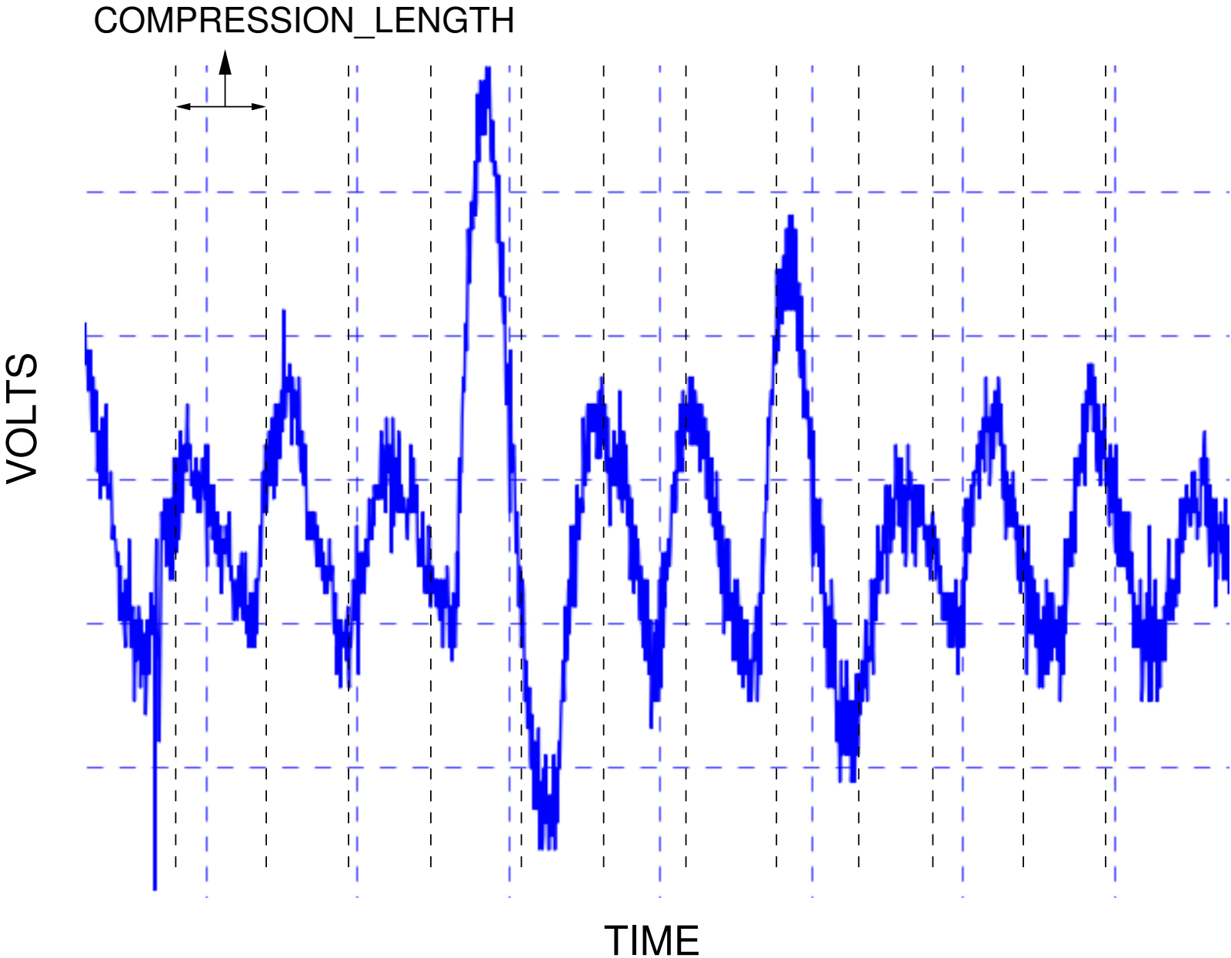
[picture p174: page 1]

COMPRESSION_LENGTH

### TIME

VOLTS
