kammoh/fobos/oldfobos/doc/UserGuide/figures/data_anl.pdf

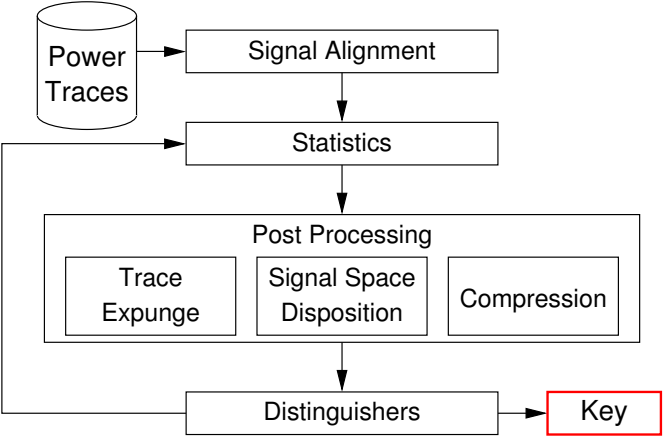
[picture p175: figure]
Statistics; Distinguishers; Key; Power Traces; Signal Alignment; Post Processing; Signal Space Disposition; Trace; Expunge; Compression
