kammoh/fobos/oldfobos/doc/UserGuide/figures/leakage.pdf

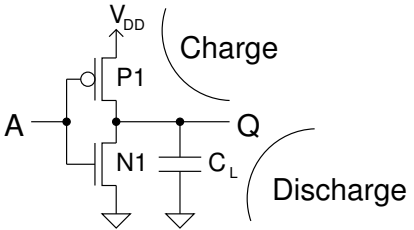
[picture p176: figure]
VDD; Charge; Discharge
