kammoh/fobos/oldfobos/doc/UserGuide/figures/sampleSpaceDisp.pdf

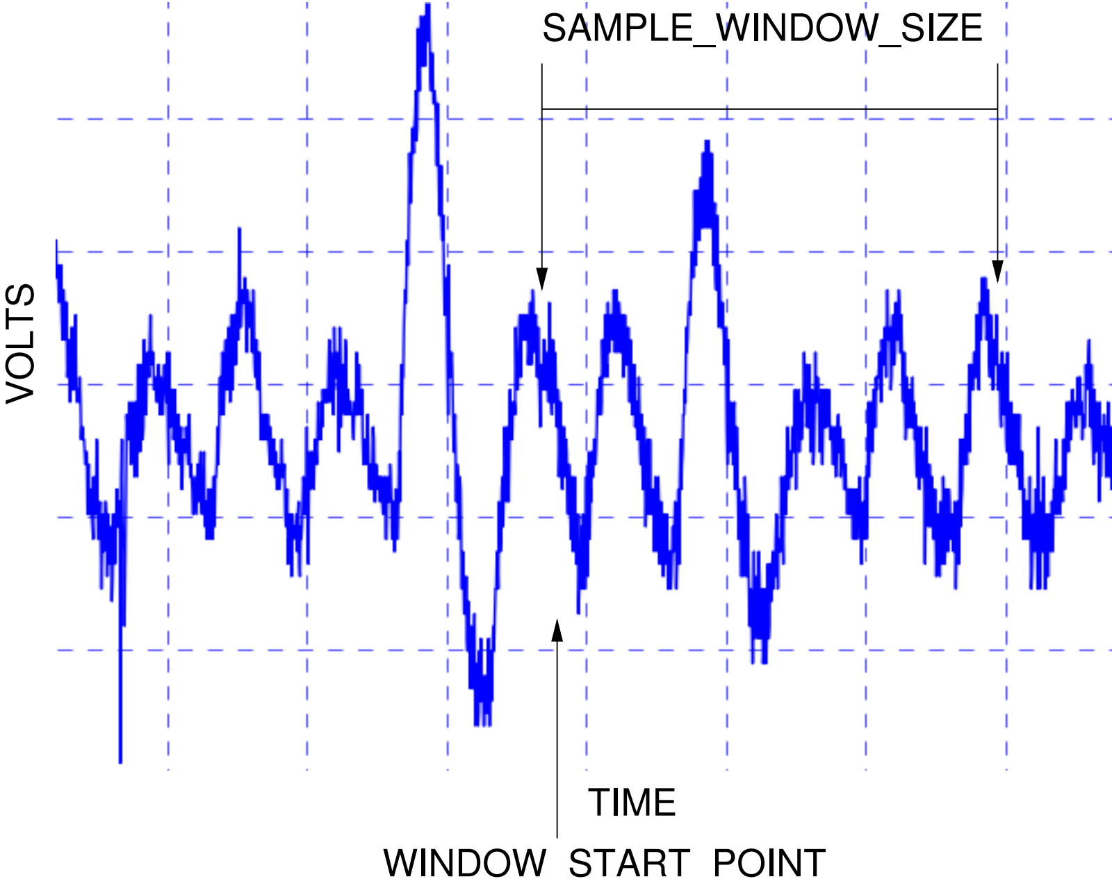
[picture p177: page 1]

SAMPLE_WINDOW_SIZE

VOLTS

WINDOW_START_POINT

TIME
