kammoh/fobos/oldfobos/doc/UserGuide/figures/sampleVstrace.pdf

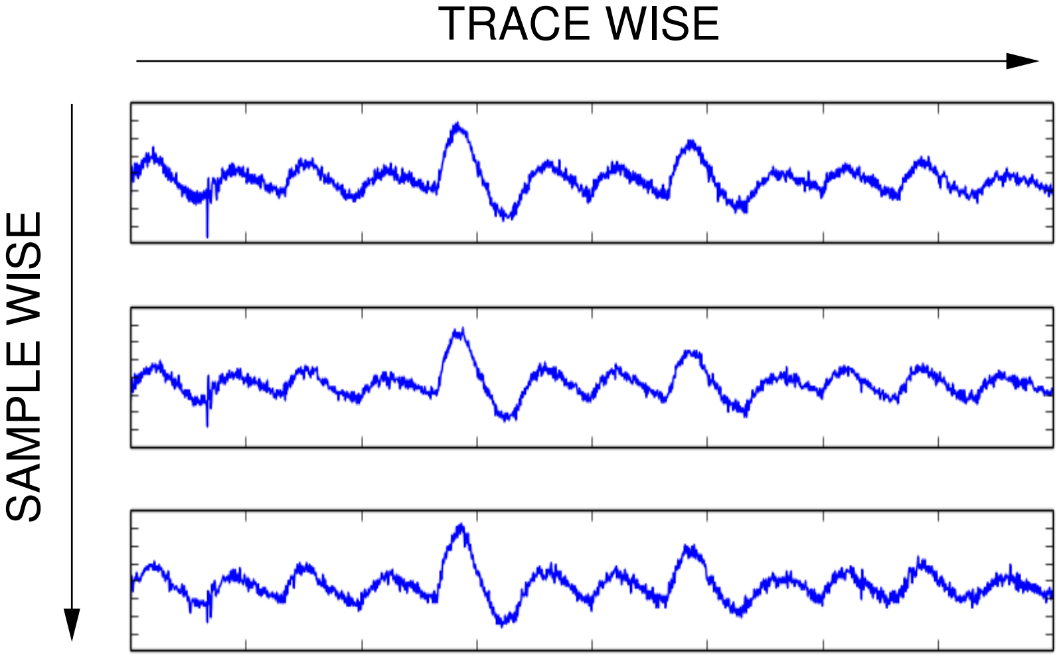
[picture p178: page 1]

TRACE WISE

SAMPLE WISE
