kammoh/fobos/oldfobos/doc/UserGuide/figures/sidechannel2.pdf

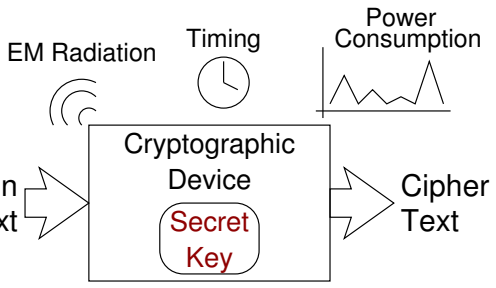
[picture p179: figure]
Timing; Consumption; Power; Secret Key; Device; Cryptographic; EM Radiation; Text; Cipher

### Plain Text

### Side Channels
