kammoh/fobos/oldfobos/doc/UserGuide/figures/sidechannel3.pdf

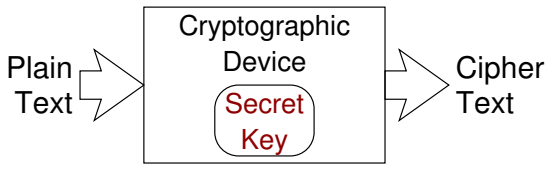
[picture p180: figure]
Secret Key; Device; Cryptographic; Plain; Text; Cipher
