kammoh/fobos/oldfobos/doc/UserGuide/figures/signalAlignment.pdf

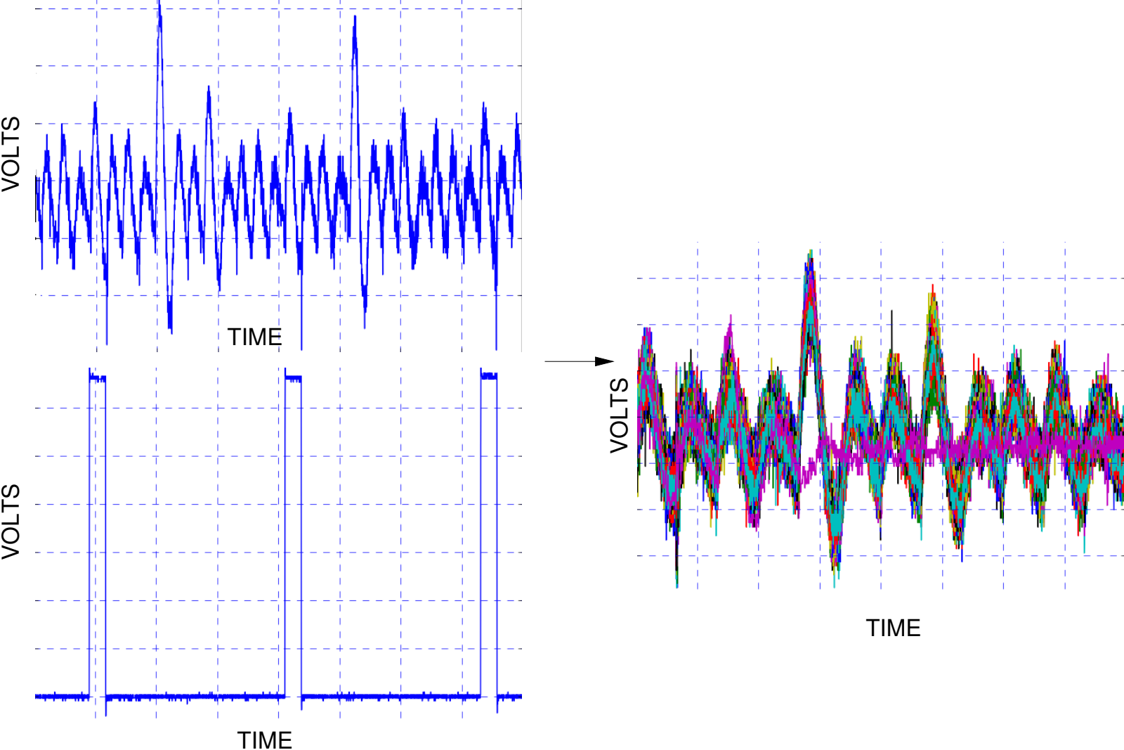
[picture p181: page 1]

TIME

TIME

TIME

VOLTS VOLTS

VOLTS
