kammoh/fobos/oldfobos/doc/UserGuide/figures/traceExpungMod.pdf

2σ
1σ

3σ

ΜΕΑΝ

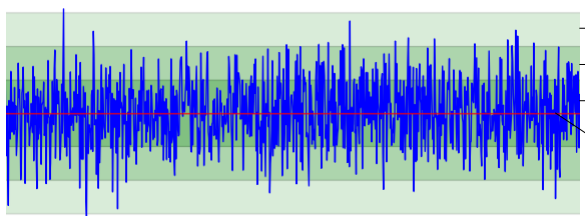
[picture p182: figure]

LOWER_BOUNDS

UPPER_BOUNDS

### TRACES

VAR
