kammoh/fobos/oldfobos/doc/UserGuide/figures/var-tracewise.pdf

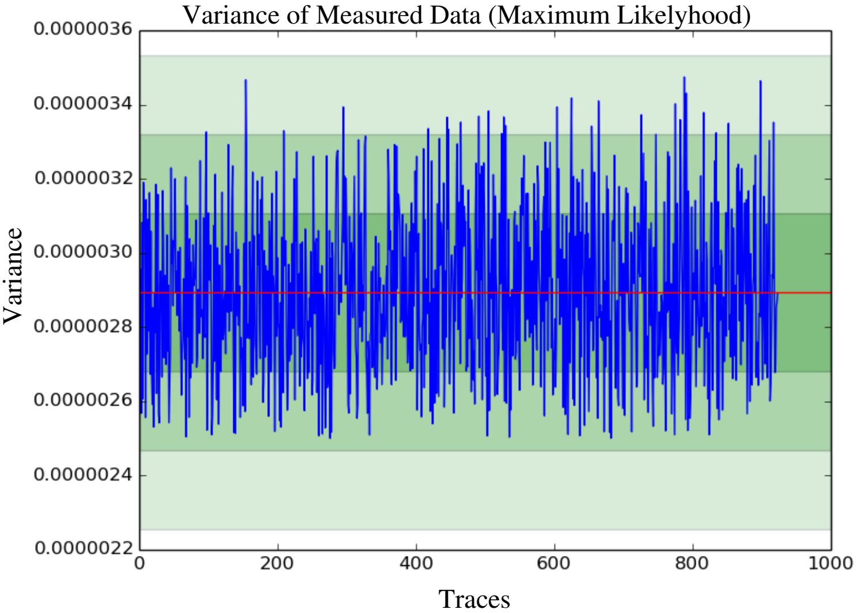
[picture p183: page 1]

Traces

Variance of Measured Data (Maximum Likelyhood)

Variance
