kammoh/fobos/oldfobos/doc/UserGuide/powermanager.ods

Reg Nr. | Address | Command
 |  |  |  | Trigger |  | Gain1 |  | Gain0 |  | clear | P enable | enable = | enables Variable power supply
 |  |  |  |  | en | 3V3 |  | 5V |  |  |  | clear = | clears status register and all result registers
 |  |  |  | SW | HW | 1 | 0 | 1 | 0
0 | 00 |  |  | 7 | 6 | 5 | 4 | 3 | 2 | 1 | 0
 |  | Status
 |  |  | Overflow | Trigger |  | Gain1 |  | Gain0 |  | busy | P good | overflow = | sample counter overflow | Power Good | 1
 |  |  |  | Fired |  | 3V3 |  | 5V |  |  |  |  |  | busy | 2
 |  |  | HW | SW | HW | 1 | 0 | 1 | 0 |  |  |  |  | 3V3 Gain 0 | 4
1 | 04 |  | 8 | 7 | 6 | 5 | 4 | 3 | 2 | 1 | 0 | HW overflow = | HW Trigger sample counter overflow | 3V3 Gain 1 | 8
 |  |  |  |  |  |  |  |  |  |  |  |  |  | 5V Gain 0 | 16
 |  | Results |  |  |  |  |  |  |  |  |  |  |  | 5V Gain 1 | 32
2 | 08 | Actual |  | 3V3 |  | Voltage |  |  |  |  |  |  |  | HW Trig | 64
3 | 0C | Actual |  | 3V3 |  | Current |  |  |  |  |  |  |  | SW Trig | 128
4 | 10 | Actual |  | 5V |  | Voltage |  |  |  |  |  |  |  | overflow | 256
5 | 14 | Actual |  | 5V |  | Current
6 | 18 | Average |  | 3V3 |  | Voltage
7 | 1C | Maximum |  | 3V3 |  | Voltage
8 | 20 | Average |  | 3V3 |  | Current
9 | 24 | Maximum |  | 3V3 |  | Current
10 | 28 | Average |  | 5V |  | Voltage
11 | 2C | Maximum |  | 5V |  | Voltage
12 | 30 | Average |  | 5V |  | Current
13 | 34 | Maximum |  | 5V |  | Current
14 | 38 | Variable Voltage Setting
15 | 3C | Smpl Cnt |  | HW Trigger |  |  |  |  |  | for debugging
