kammoh/fobos/oldfobos/doc/UserGuide/fobos-userguide.tex

\documentclass[twoside,11pt]{cergdoc}
\usepackage{graphicx}
\usepackage{amsmath}
\usepackage{tikz}
\usepackage{enumitem}

\begin{document}

\title{Flexible, Opensource workBench fOr Side-channel analysis (FOBOS)}
\subtitle{FOBOS User Guide v2.0}
\author{Abubakr Abdulgadir \and William Diehl \and Rajesh Velegalati \and Jens-Peter Kaps}
\email{[aabdulga, wdiehl, jkaps]@gmu.edu}
\affiliation{George Mason University\\
  Fairfax, Virginia}
\topicpic{fobos-slide}
\maketitle
\tableofcontents
% -----------------------------------------------------------------------------
\include{fobos-overview}
\include{fobos-installation}
\include{dut-development}
\include{fobos-hardware-config}
\include{test-vector-gen}
\include{fobos-acquisition}
\include{fobos-cpa}
\include{fobos-t-test}
\include{fobos-profiler}
\include{fobos-power-measurement}
% -----------------------------------------------------------------------------
\begin{appendix}
\include{functions}
\end{appendix}
\end{document}
