kammoh/fobos/oldfobos/doc/UserGuide/gls.tex

\newglossaryentry{SCA}
{
	name=SCA,
	description={Side Channel Attack}
}

\newglossaryentry{HD}
{
	name=HD,
	description={Hamming Distance}
}

\newglossaryentry{HW}
{
	name=HW,
	description={Hamming Weight}
}
