kammoh/fobos/oldfobos/doc/UserGuide/figures/mean-samplewise.pdf

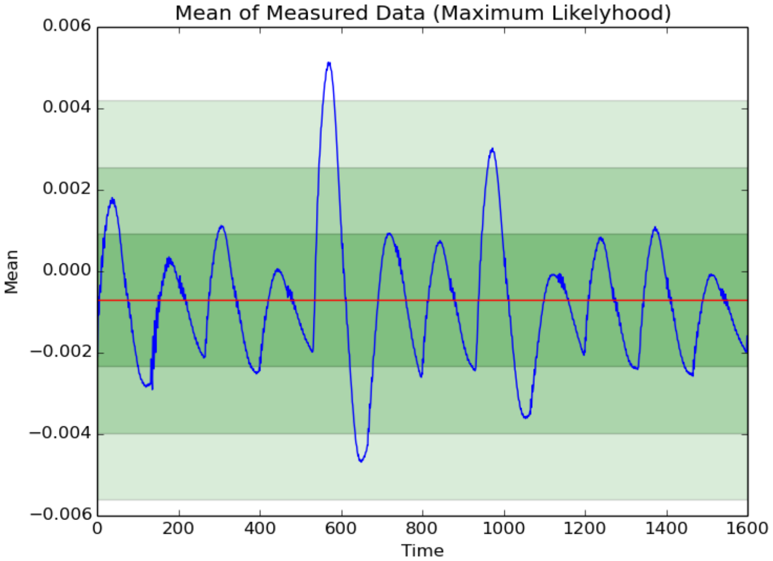
[picture p184: page 1]
