kammoh/fobos/oldfobos/doc/UserGuide/figures/mean-tracewise.pdf

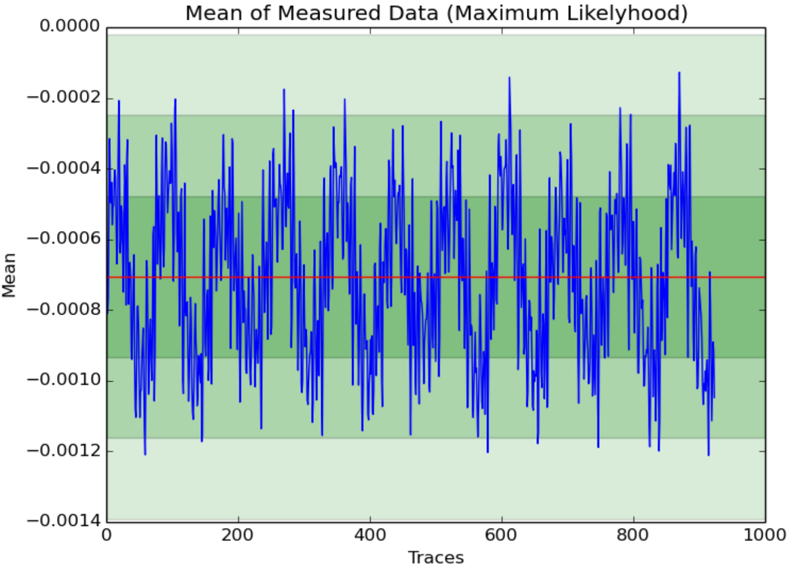
[picture p185: page 1]
