kammoh/fobos/oldfobos/doc/UserGuide/figures/pearson-r.pdf

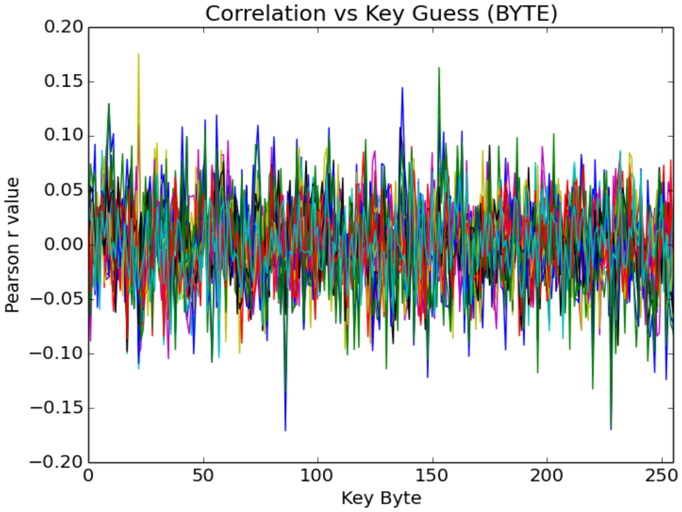
[picture p186: page 1]
