kammoh/fobos/oldfobos/doc/UserGuide/figures/protocol.pdf

16−bit Command for Loading / Writing Data

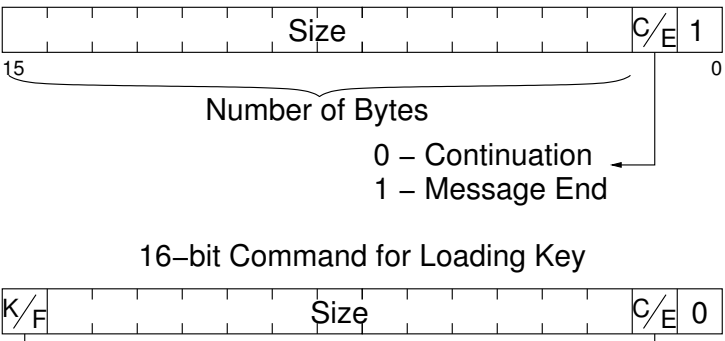
[picture p187: figure]
16−bit Command for Loading Key; 15 0 Number of Bytes; 0 − Continuation 1 − Message End; Size
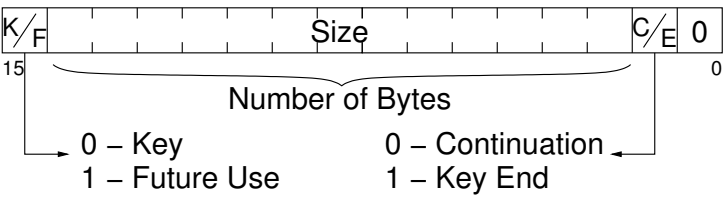
[picture p188: figure]
0 − Continuation 1 − Key End; 0 − Key; Number of Bytes; 1 − Future Use
