kammoh/fobos/oldfobos/doc/UserGuide/figures/scaTrace1.pdf

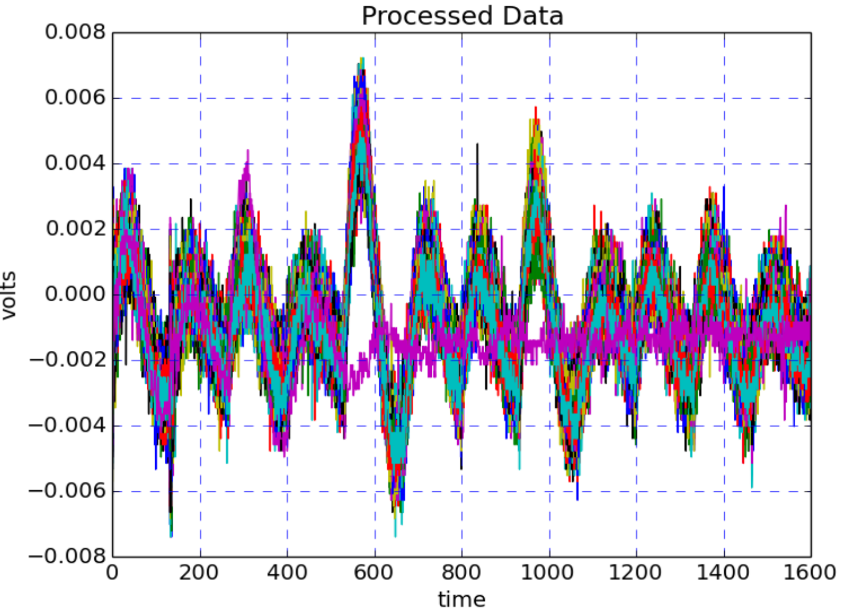
[picture p189: page 1]
