kammoh/fobos/oldfobos/doc/UserGuide/figures/scaTrace2.pdf

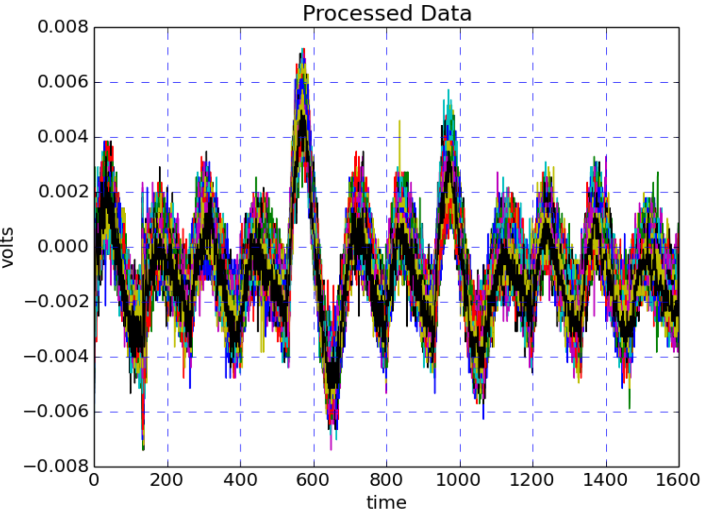
[picture p190: page 1]
