kammoh/fobos/oldfobos/doc/UserGuide/figures/scaTrace3.pdf

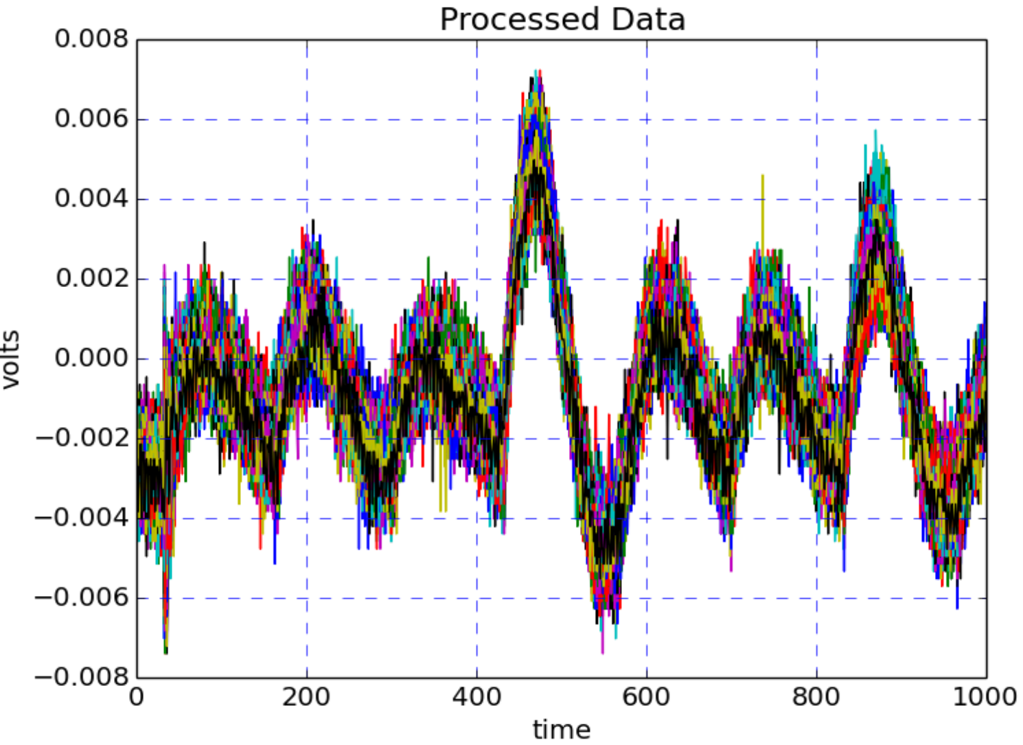
[picture p191: page 1]
