kammoh/fobos/oldfobos/doc/UserGuide/figures/scaTrace4.pdf

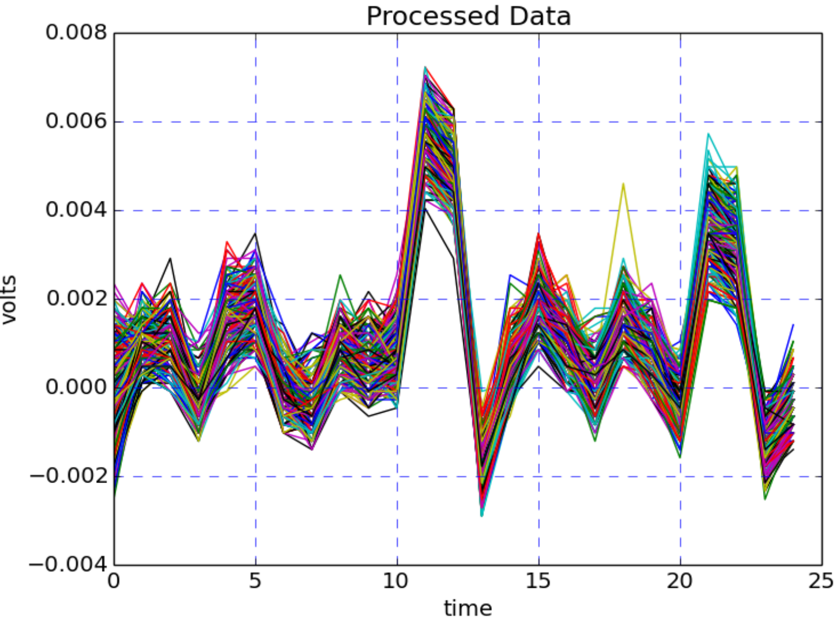
[picture p192: page 1]
