kammoh/fobos/oldfobos/doc/UserGuide/figures/spearman-rho.pdf

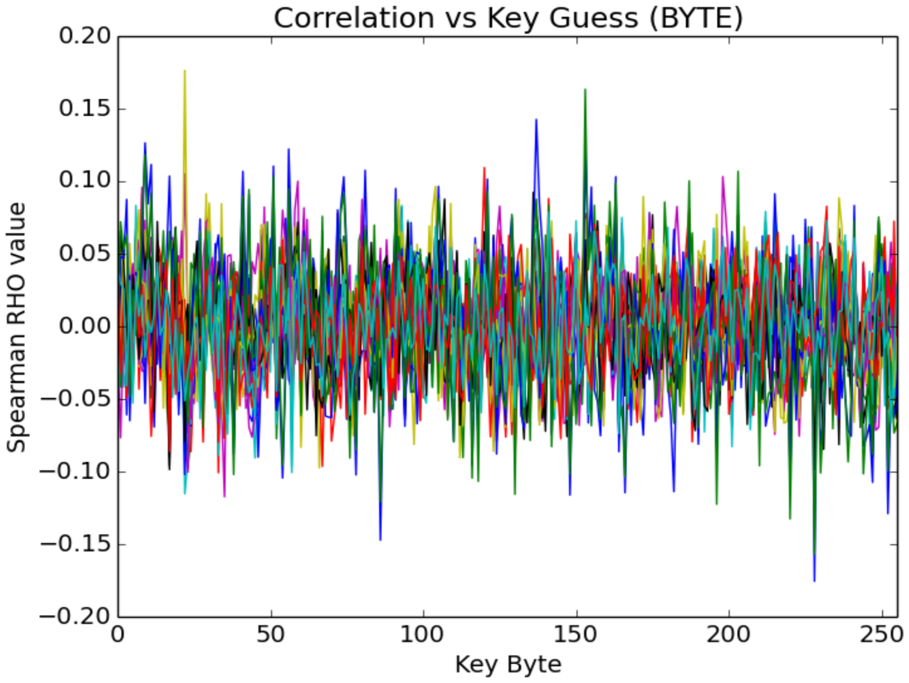
[picture p193: page 1]
