kammoh/fobos/oldfobos/doc/UserGuide/figures/std-samplewise.pdf

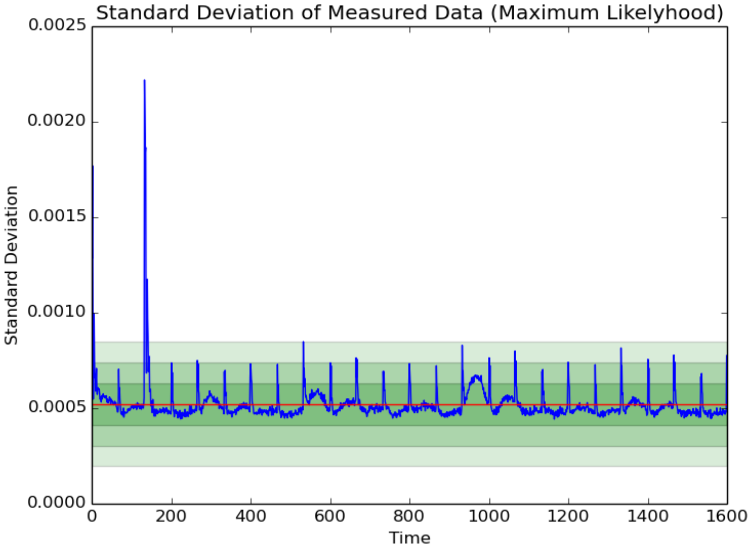
[picture p194: page 1]
