kammoh/fobos/oldfobos/doc/UserGuide/figures/std-tracewise.pdf

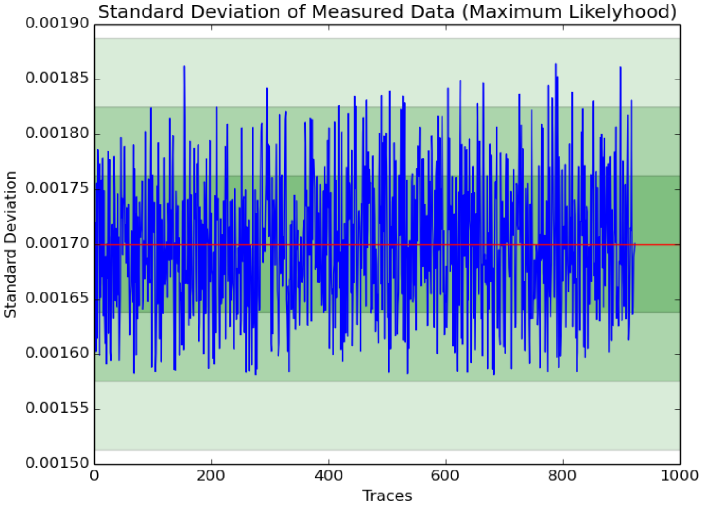
[picture p195: page 1]
