kammoh/fobos/oldfobos/doc/UserGuide/figures/var-samplewise.pdf

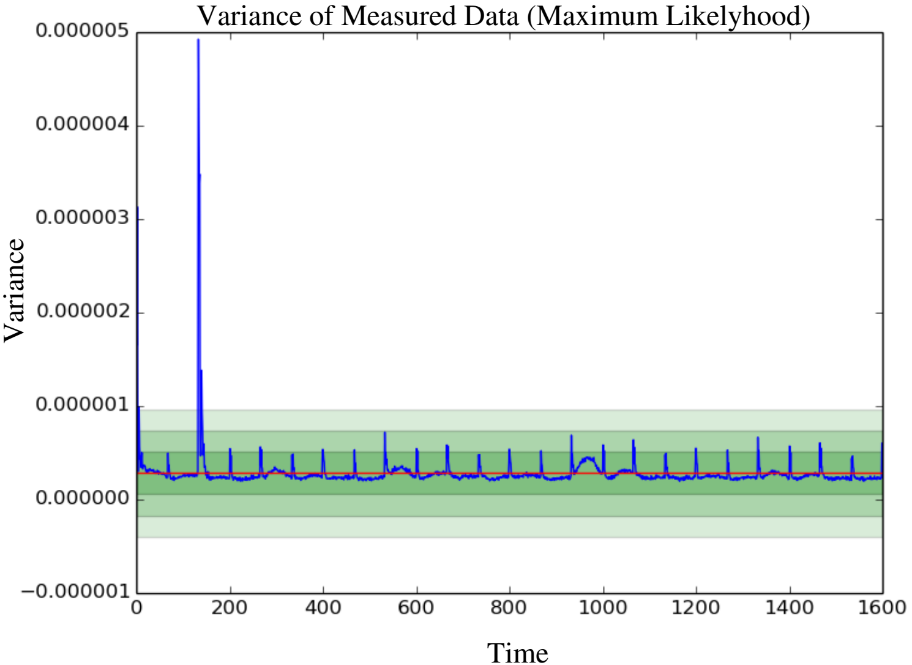
[picture p196: page 1]

Time

Variance of Measured Data (Maximum Likelyhood)

Variance
