kammoh/fobos/oldfobos/doc/UserGuide/figures/alignedTraces.png

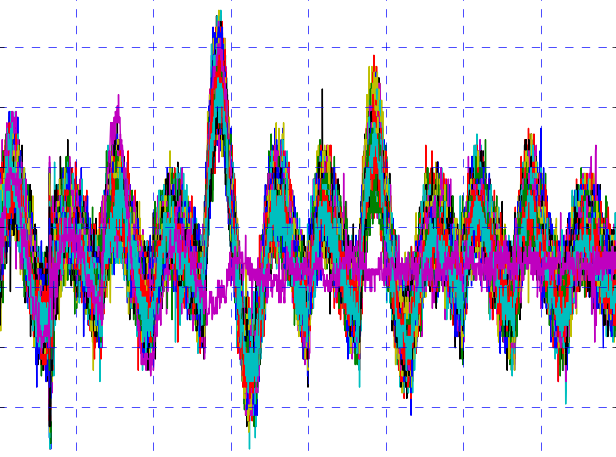
oldfobos/doc/UserGuide/figures/alignedTraces.png
