kammoh/fobos/oldfobos/doc/UserGuide/figures/ctrl-create-project.png

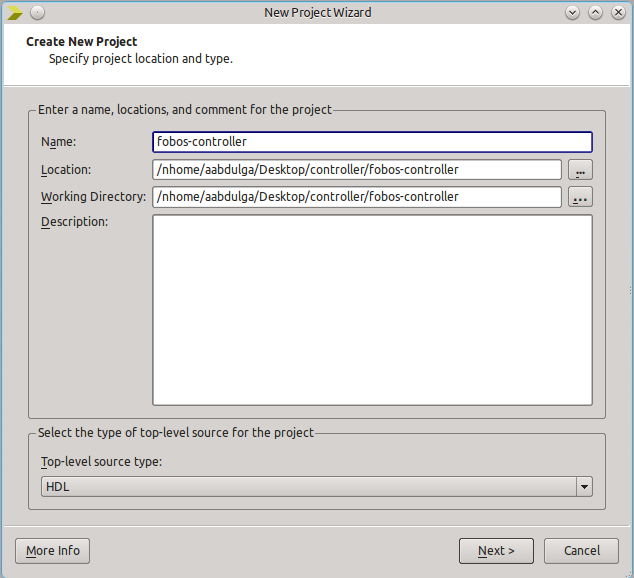
oldfobos/doc/UserGuide/figures/ctrl-create-project.png
