kammoh/fobos/oldfobos/doc/UserGuide/figures/ctrl-gen-prog-file.png

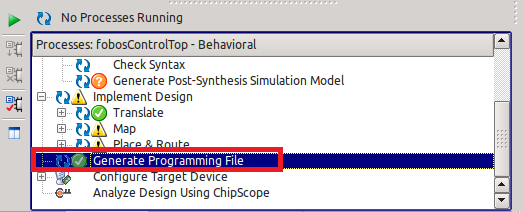
oldfobos/doc/UserGuide/figures/ctrl-gen-prog-file.png
