kammoh/fobos/oldfobos/doc/UserGuide/figures/ctrl-project-properties.png

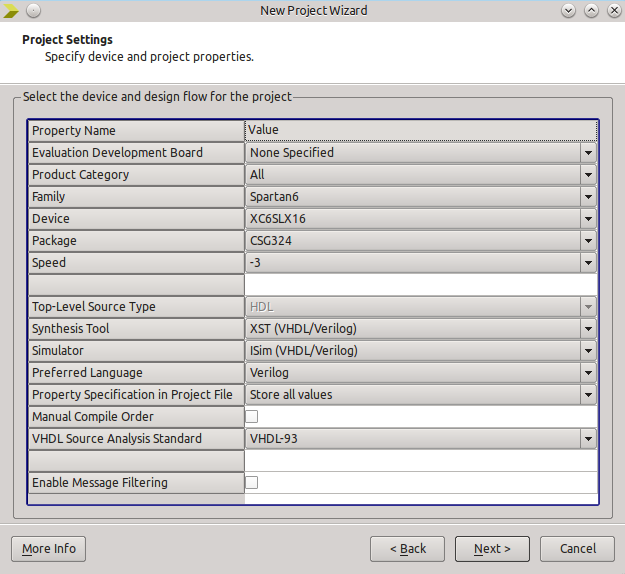
oldfobos/doc/UserGuide/figures/ctrl-project-properties.png
