kammoh/fobos/oldfobos/doc/UserGuide/figures/FOBOS-label.png

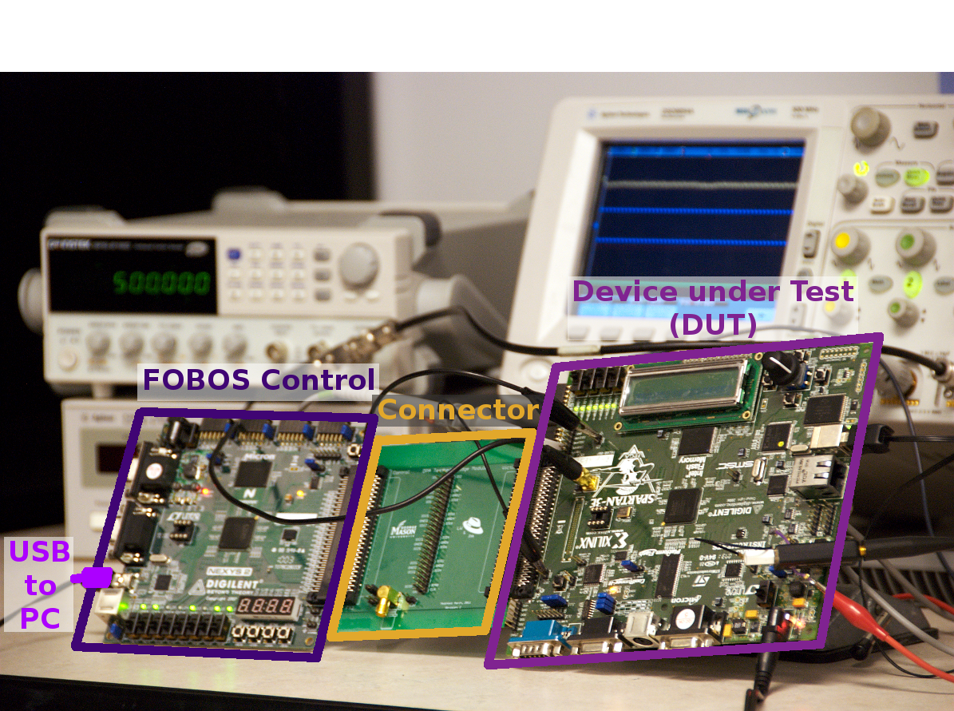
oldfobos/doc/UserGuide/figures/FOBOS-label.png
