kammoh/fobos/oldfobos/doc/UserGuide/figures/openADC.png

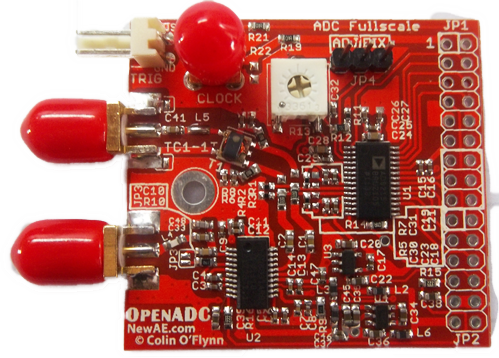
oldfobos/doc/UserGuide/figures/openADC.png
