kammoh/fobos/oldfobos/doc/UserGuide/figures/rawPowerTrace.png

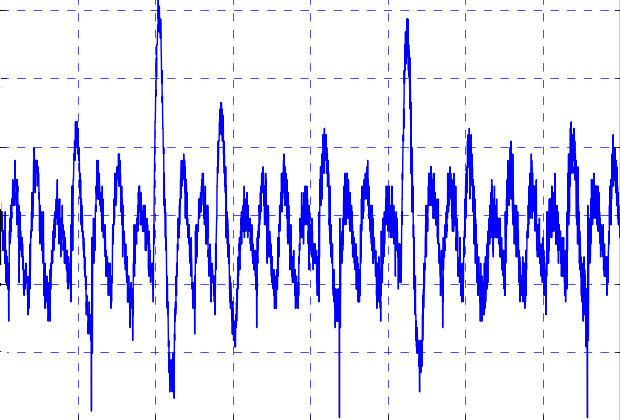
oldfobos/doc/UserGuide/figures/rawPowerTrace.png
