kammoh/fobos/oldfobos/doc/UserGuide/figures/rawTriggerTrace.png

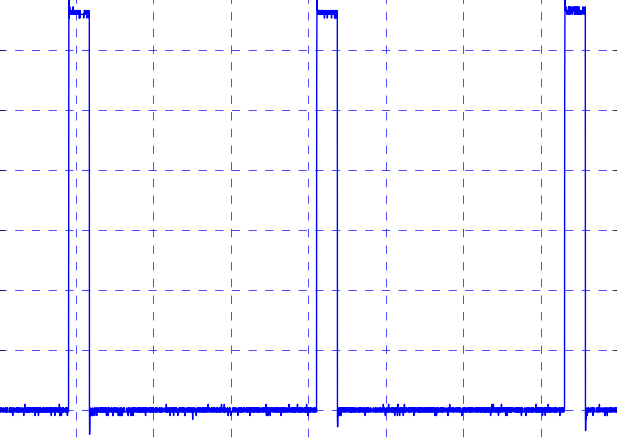
oldfobos/doc/UserGuide/figures/rawTriggerTrace.png
