kammoh/fobos/oldfobos/doc/UserGuide/figures/sampleWindowRaw.png

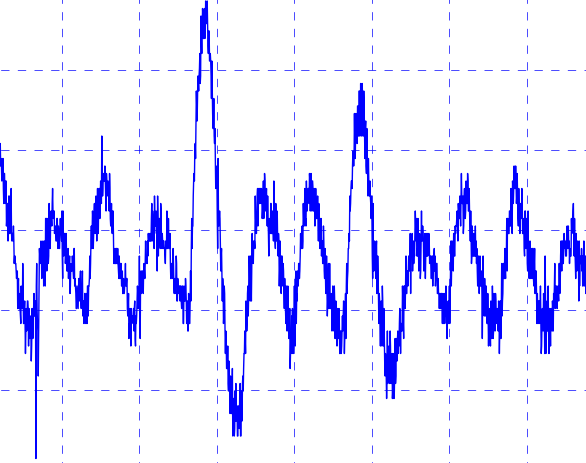
oldfobos/doc/UserGuide/figures/sampleWindowRaw.png
