kammoh/fobos/oldfobos/doc/UserGuide/figures/SampleWise-meanOfData.png

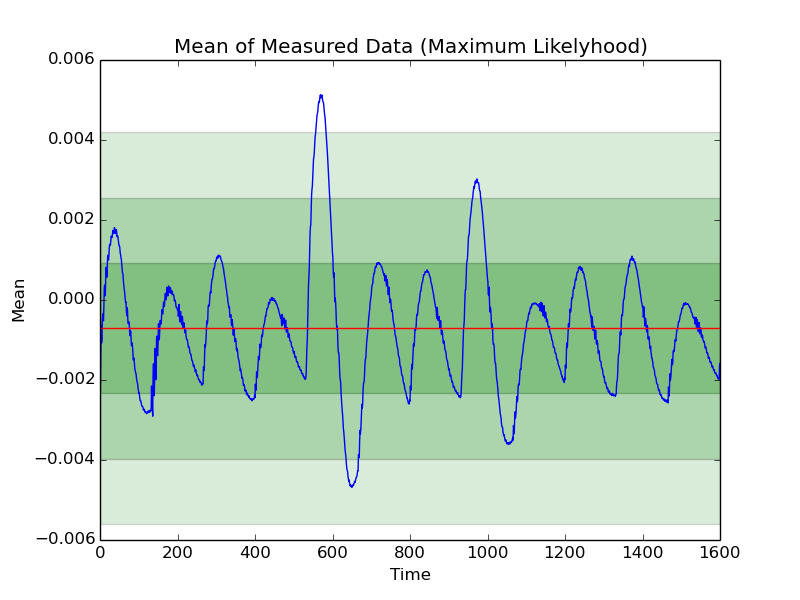
oldfobos/doc/UserGuide/figures/SampleWise-meanOfData.png
