kammoh/fobos/oldfobos/doc/UserGuide/figures/SampleWise-stdOfData.png

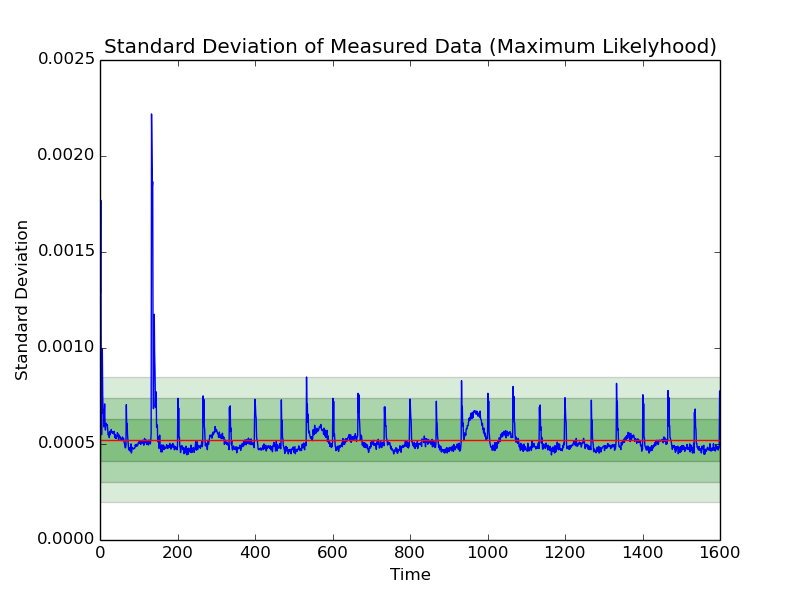
oldfobos/doc/UserGuide/figures/SampleWise-stdOfData.png
