kammoh/fobos/oldfobos/doc/UserGuide/figures/SampleWise-varOfData.png

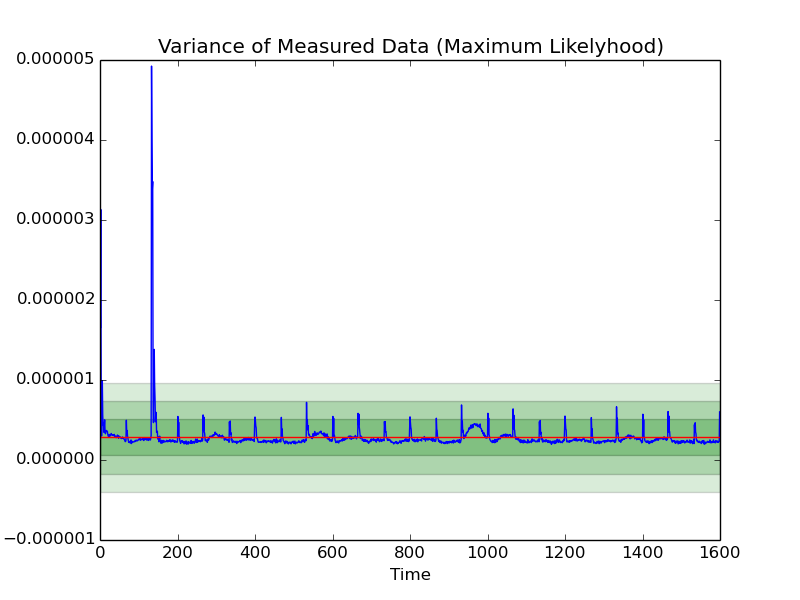
oldfobos/doc/UserGuide/figures/SampleWise-varOfData.png
