kammoh/fobos/oldfobos/doc/UserGuide/figures/spa-rsa.jpg

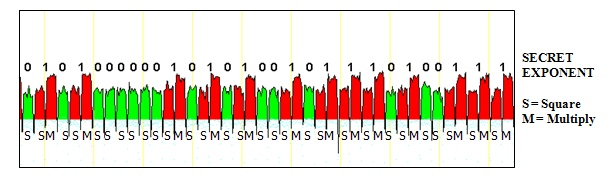
oldfobos/doc/UserGuide/figures/spa-rsa.jpg
