kammoh/fobos/oldfobos/doc/UserGuide/figures/traceExpunge.png

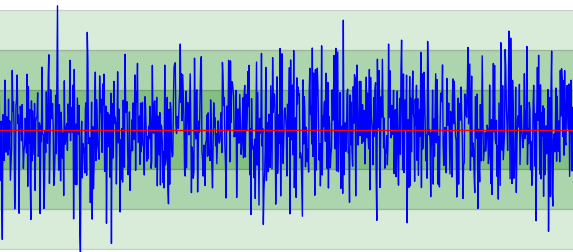
oldfobos/doc/UserGuide/figures/traceExpunge.png
