kammoh/fobos/oldfobos/doc/UserGuide/figures/traceVsample.png

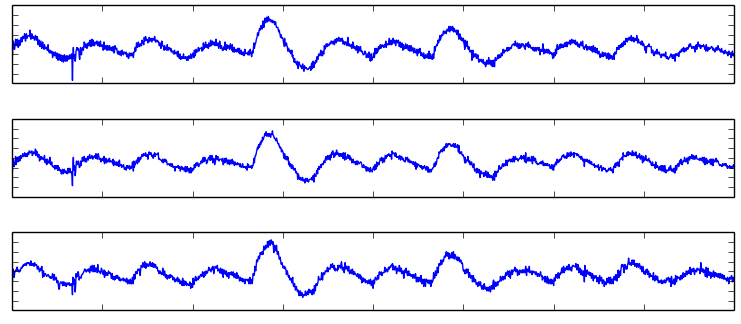
oldfobos/doc/UserGuide/figures/traceVsample.png
