kammoh/fobos/oldfobos/doc/UserGuide/figures/TraceWise-meanOfData.png

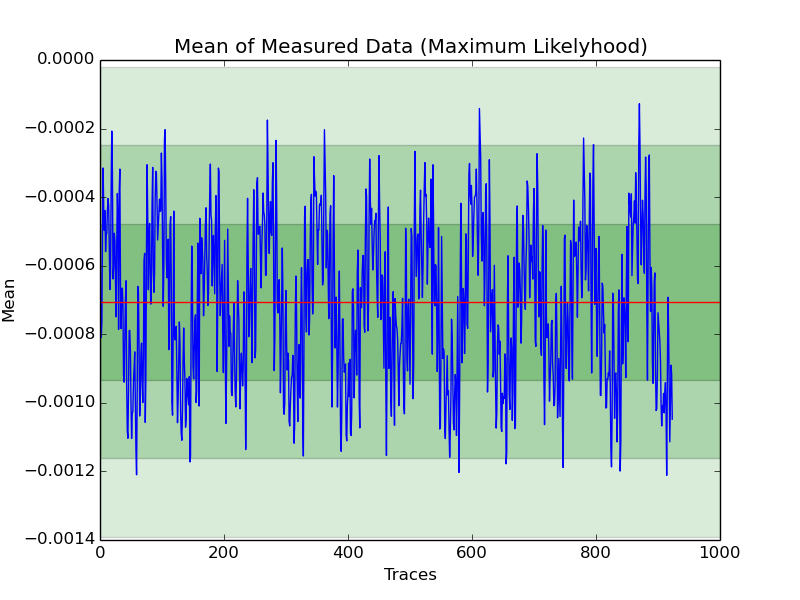
oldfobos/doc/UserGuide/figures/TraceWise-meanOfData.png
