kammoh/fobos/oldfobos/doc/UserGuide/figures/TraceWise-stdOfData.png

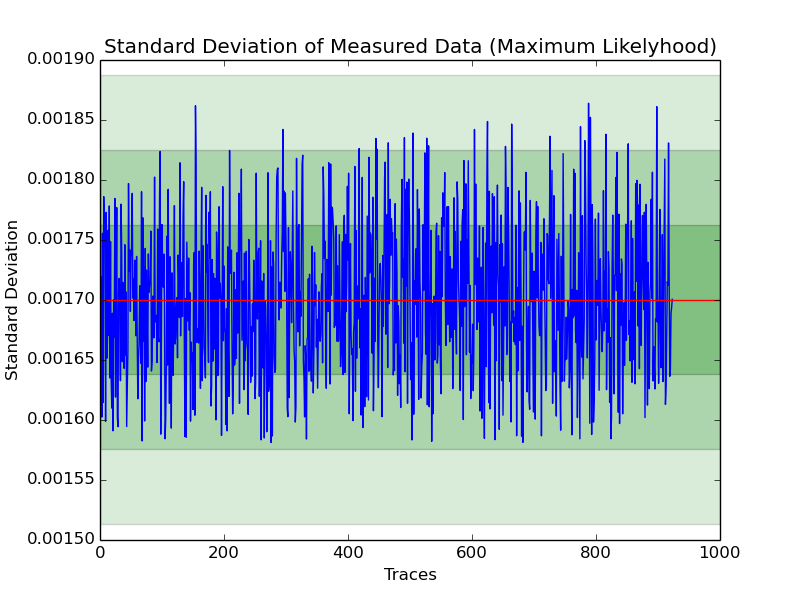
oldfobos/doc/UserGuide/figures/TraceWise-stdOfData.png
