kammoh/fobos/oldfobos/doc/figures/t-test-flow.pdf

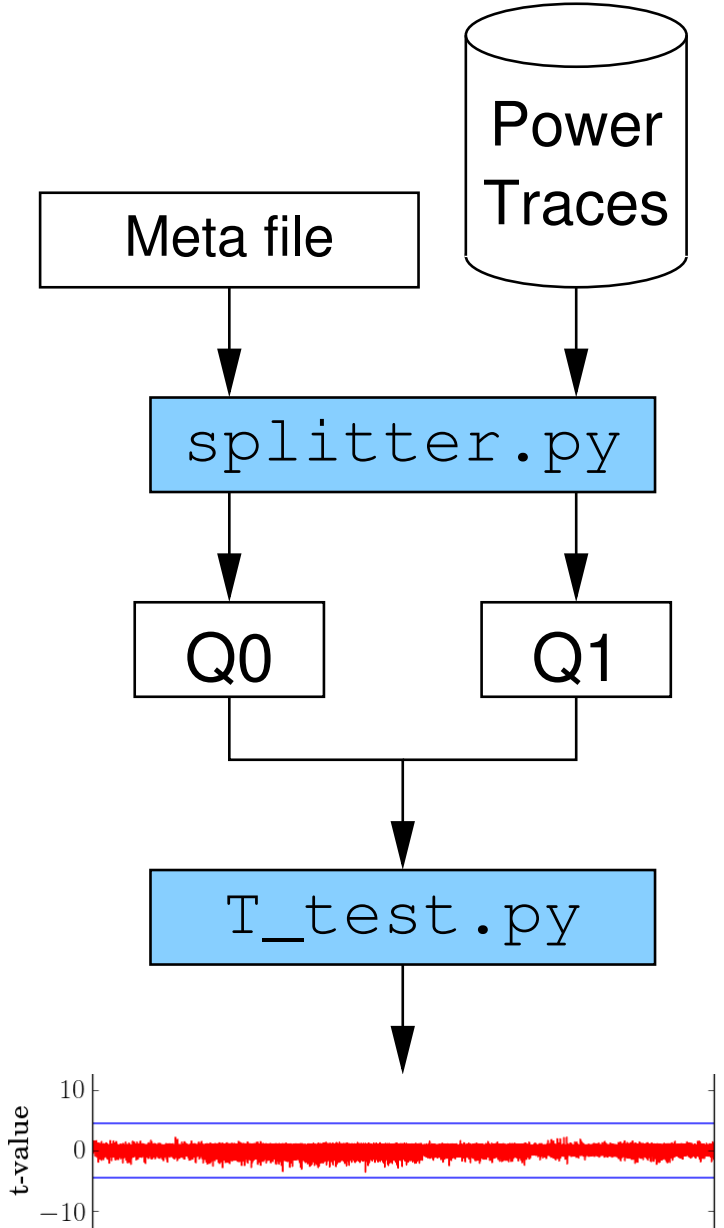
[picture p217: figure]
Power; Traces; splitter.py; Meta file; T_test.py
