kammoh/fobos/oldfobos/bin/usb/test/500kHz-100mV-zoom-clean.png

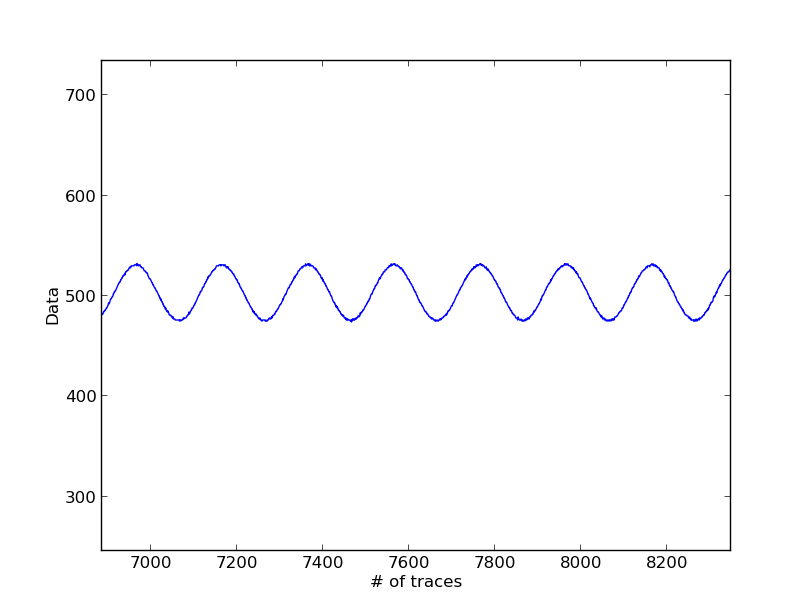
oldfobos/bin/usb/test/500kHz-100mV-zoom-clean.png
