kammoh/fobos/oldfobos/bin/usb/test/500kHz-100mV-zoom-spikes.png

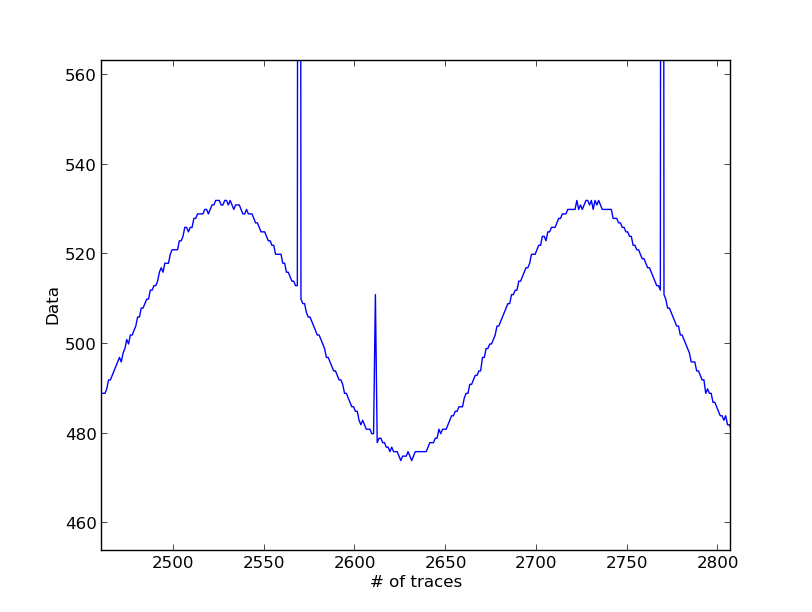
oldfobos/bin/usb/test/500kHz-100mV-zoom-spikes.png
