kammoh/fobos/oldfobos/bin/usb/test/500kHz-100mV.png

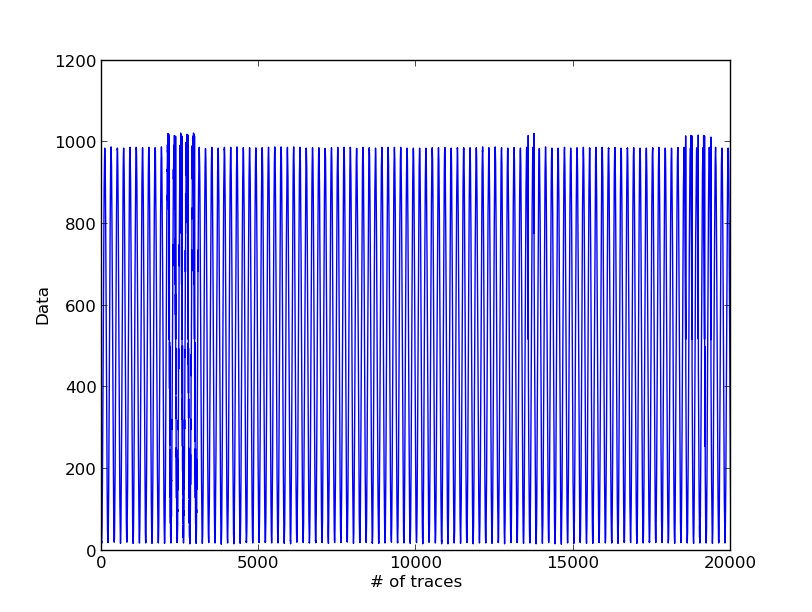
oldfobos/bin/usb/test/500kHz-100mV.png
