kammoh/fobos/oldfobos/bin/usb/test/500kHz-200mv-Nexys2.png

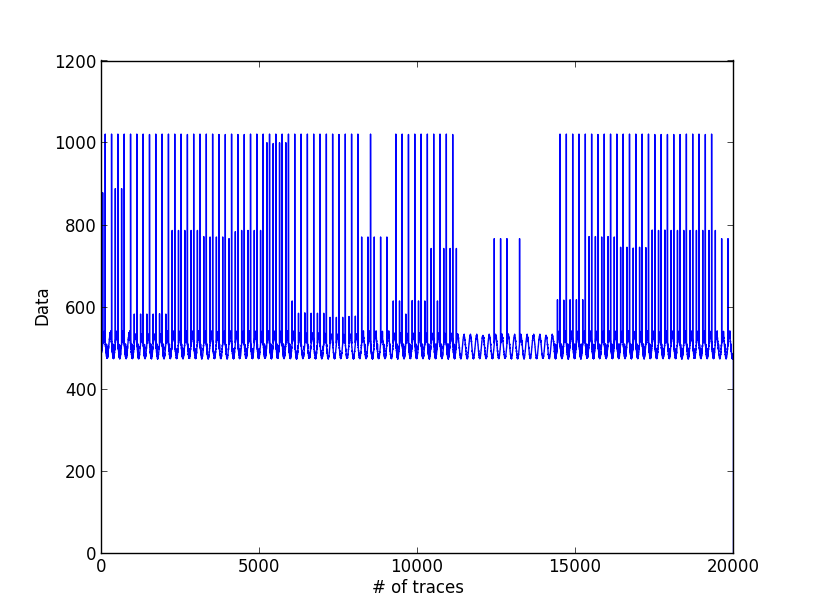
oldfobos/bin/usb/test/500kHz-200mv-Nexys2.png
