kammoh/fobos/oldfobos/bin/usb/test/500kHz-200mv-Nexys3.png

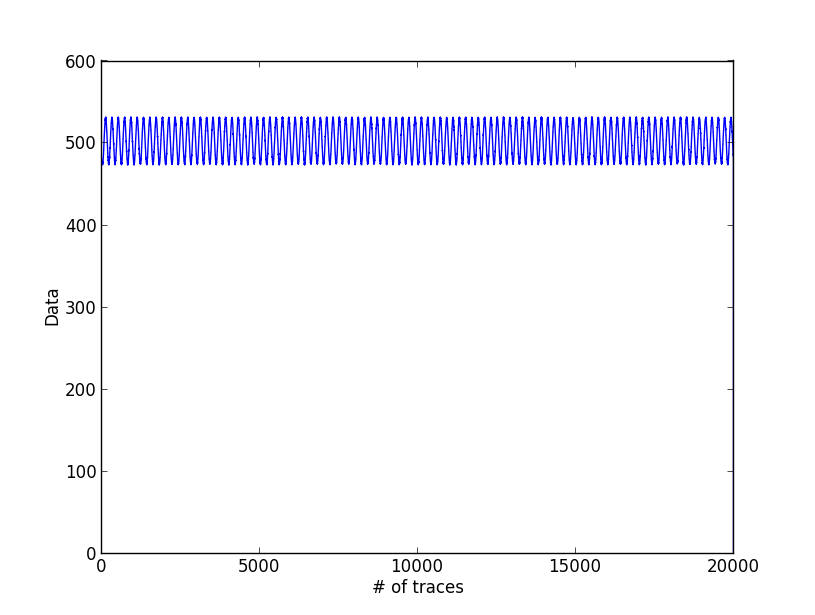
oldfobos/bin/usb/test/500kHz-200mv-Nexys3.png
