kammoh/fobos/oldfobos/bin/usb/test/500kHz-500mv-Nexys2.png

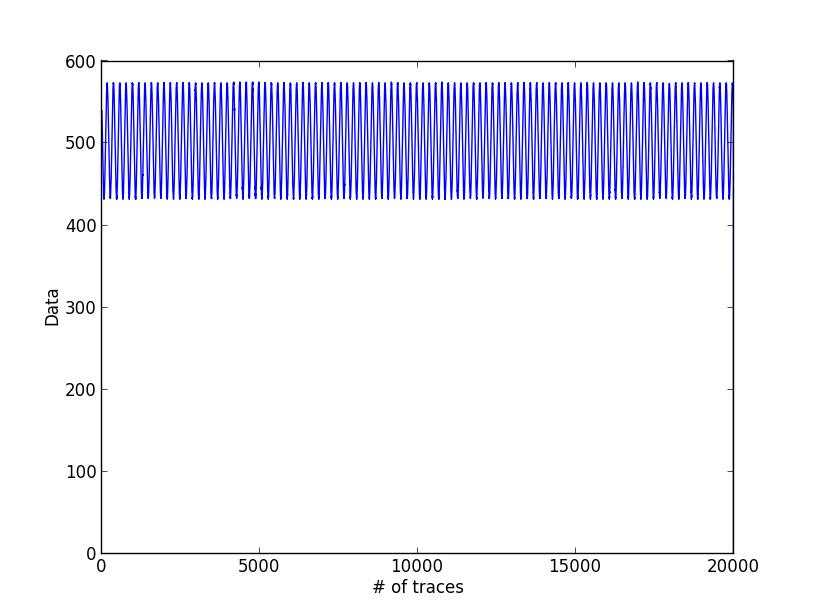
oldfobos/bin/usb/test/500kHz-500mv-Nexys2.png
