kammoh/fobos/oldfobos/bin/usb/test/snapShot.png

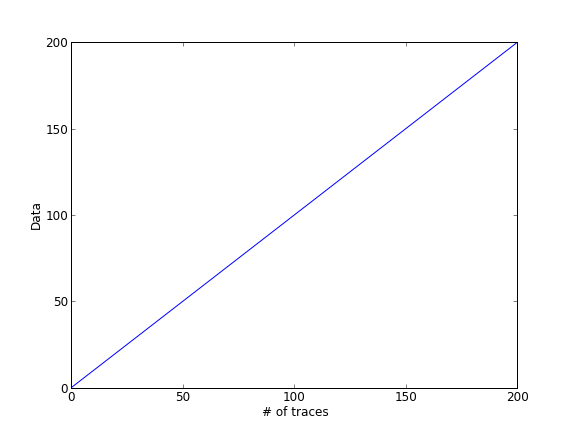
oldfobos/bin/usb/test/snapShot.png
