kammoh/fobos/oldfobos/doc/figures/t_test_aes_gcm_unpr_a7_edited.png

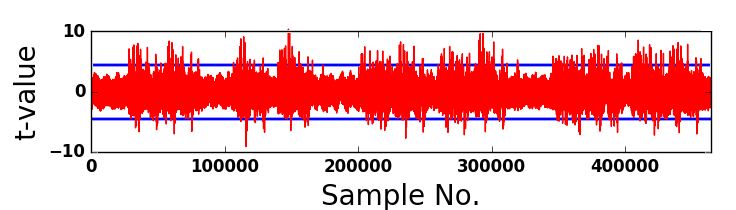
oldfobos/doc/figures/t_test_aes_gcm_unpr_a7_edited.png
