kammoh/fobos/oldfobos/fobosold/t-test/cleanTrace.png

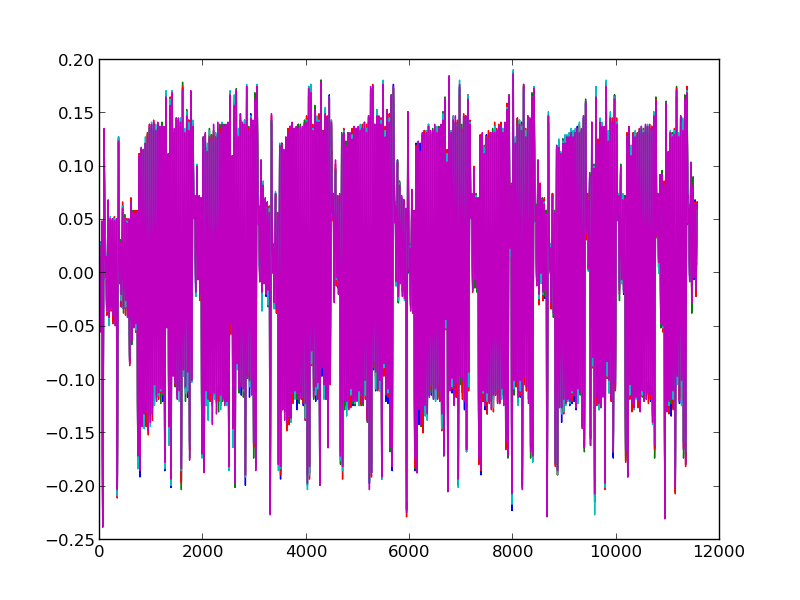
oldfobos/fobosold/t-test/cleanTrace.png
