kammoh/fobos/oldfobos/fobosold/t-test/fig.png

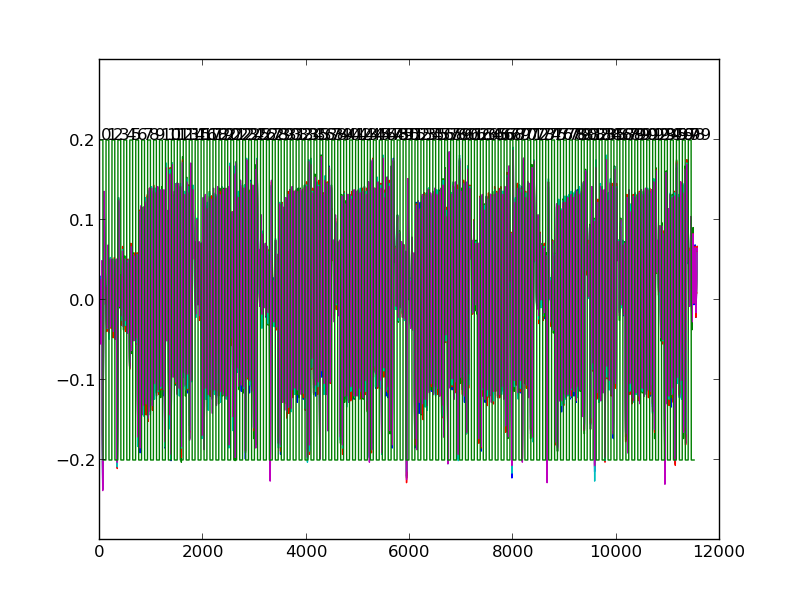
oldfobos/fobosold/t-test/fig.png
