kammoh/fobos/oldfobos/temp/test/graph.png

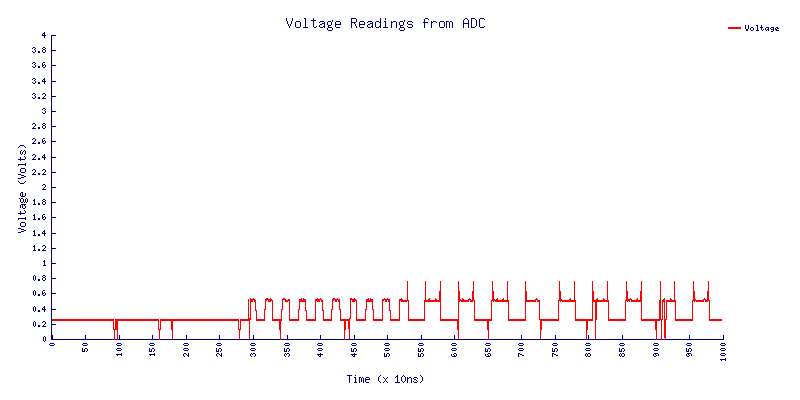
oldfobos/temp/test/graph.png
