kammoh/fobos/hardware/fobos-dut/dut-artix7-a12t-csg325/dut-artix7-a12t.pdf

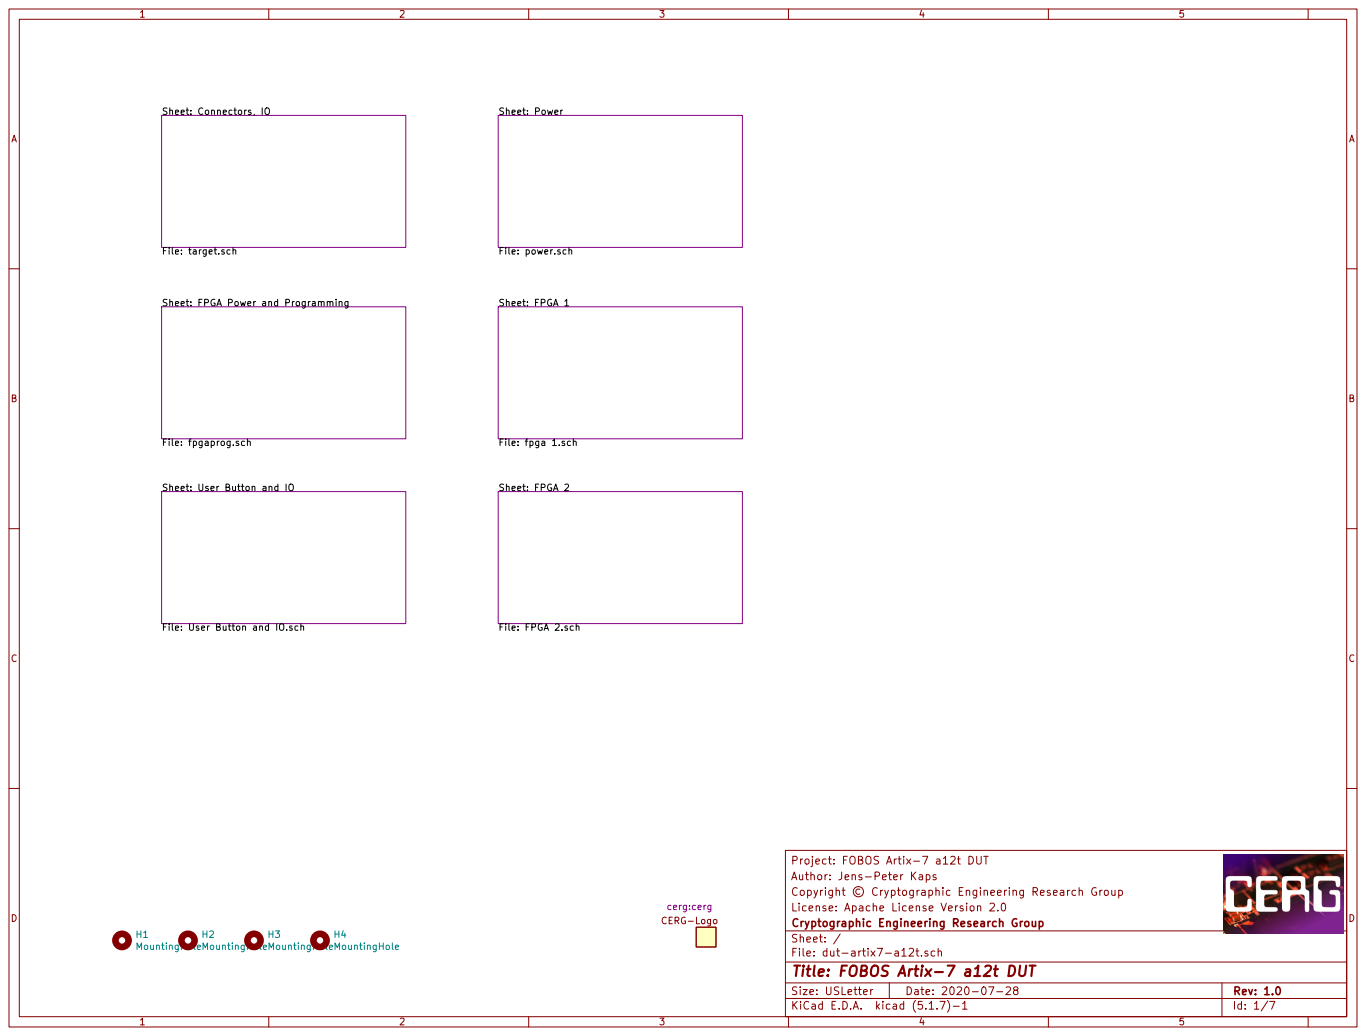
[picture p233: page 1]

Sheet: FPGA Power and Programming

File: User Button and IO.sch H1MountingHole H2MountingHole H3MountingHole H4MountingHole

Project: FOBOS Artix-7 a12t DUT
Author: Jens-Peter Kaps
Copyright © Cryptographic Engineering Research Group
License: Apache License Version 2.0
File: dut-artix7-a12t.sch Sheet: / Cryptographic Engineering Research Group

Id: 1/7 Title: FOBOS Artix-7 a12t DUT

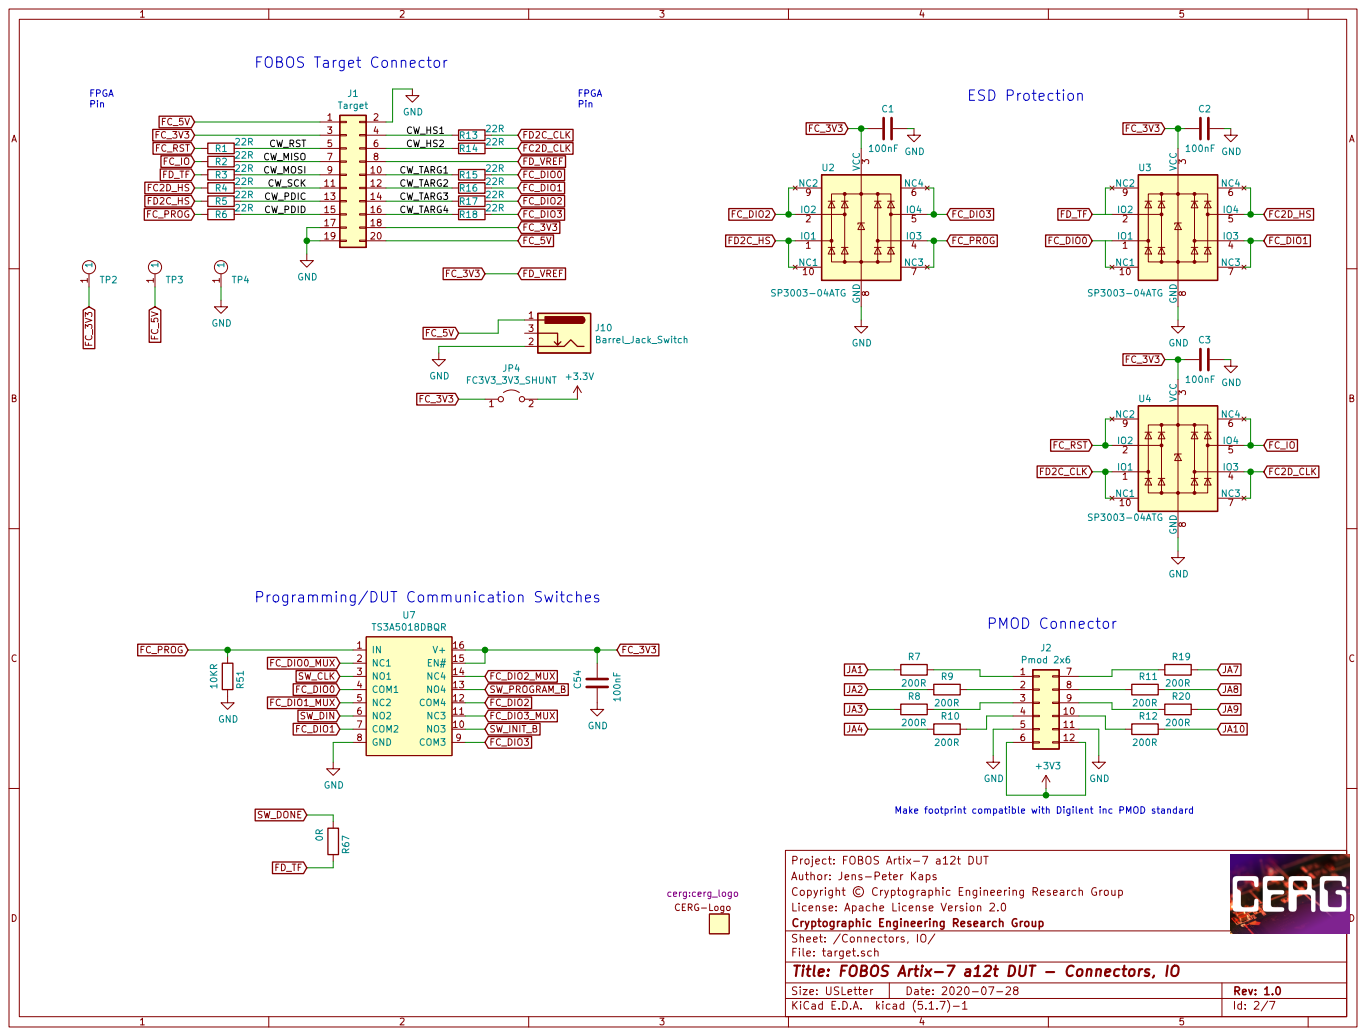
[picture p234: page 2]

Author: Jens-Peter Kaps
Copyright © Cryptographic Engineering Research Group
License: Apache License Version 2.0
Cryptographic Engineering Research Group
Sheet: /Connectors, IO/
File: target.sch
Id: 2/7 Title: FOBOS Artix-7 a12t DUT - Connectors, IO

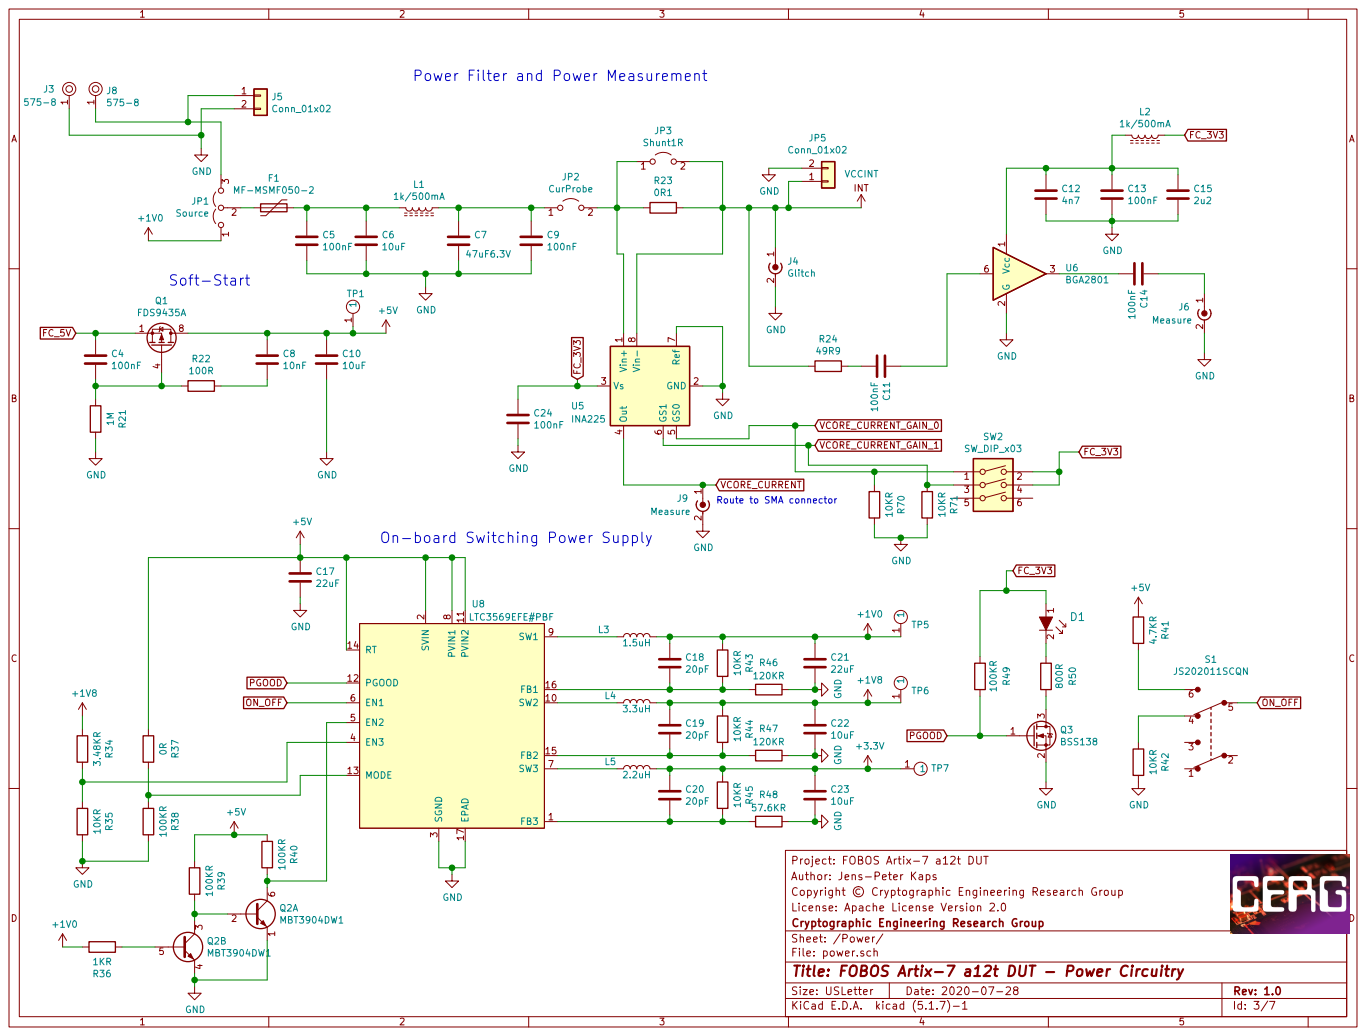
[picture p235: page 3]

FC_3V3 FC_3V3 Route to SMA connector Power Filter and Power Measurement

On-board Switching Power Supply

Project: FOBOS Artix-7 a12t DUT GND

Author: Jens-Peter Kaps
Copyright © Cryptographic Engineering Research Group
License: Apache License Version 2.0
File: power.sch Sheet: /Power/ Cryptographic Engineering Research Group

Id: 3/7 Title: FOBOS Artix-7 a12t DUT - Power Circuitry

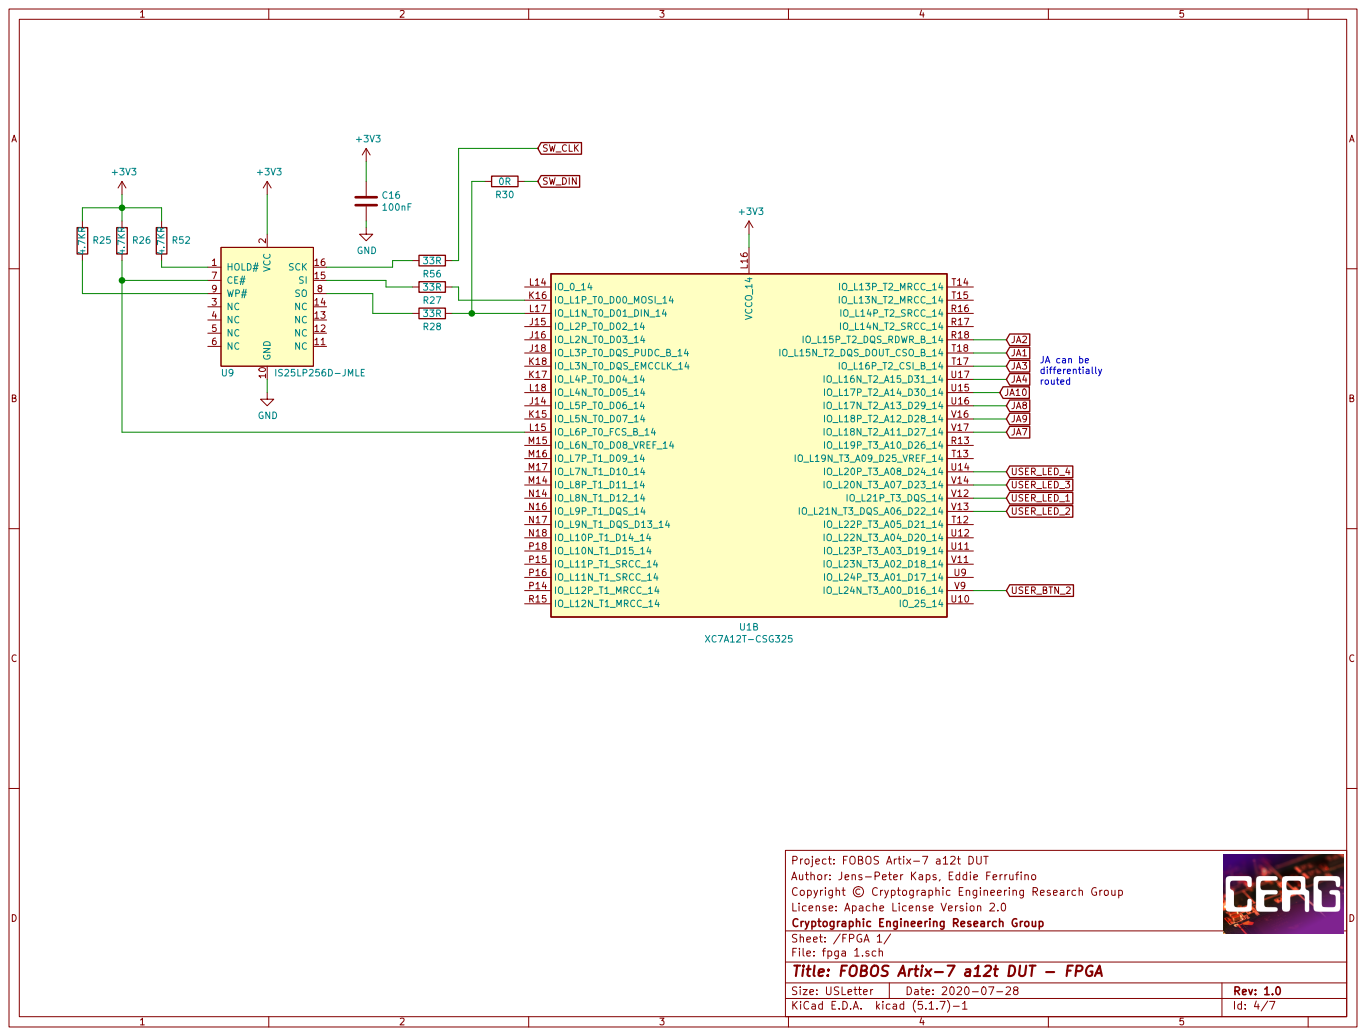
[picture p236: page 4]

2 NC 3 NC 4 NC 5 NC 6 CE# 7 SO 8 WP# 9 U9 IS25LP256D-JMLE R30

Project: FOBOS Artix-7 a12t DUT
Author: Jens-Peter Kaps, Eddie Ferrufino
Copyright © Cryptographic Engineering Research Group
License: Apache License Version 2.0
File: fpga 1.sch Sheet: /FPGA 1/ Cryptographic Engineering Research Group

Id: 4/7 Title: FOBOS Artix-7 a12t DUT - FPGA

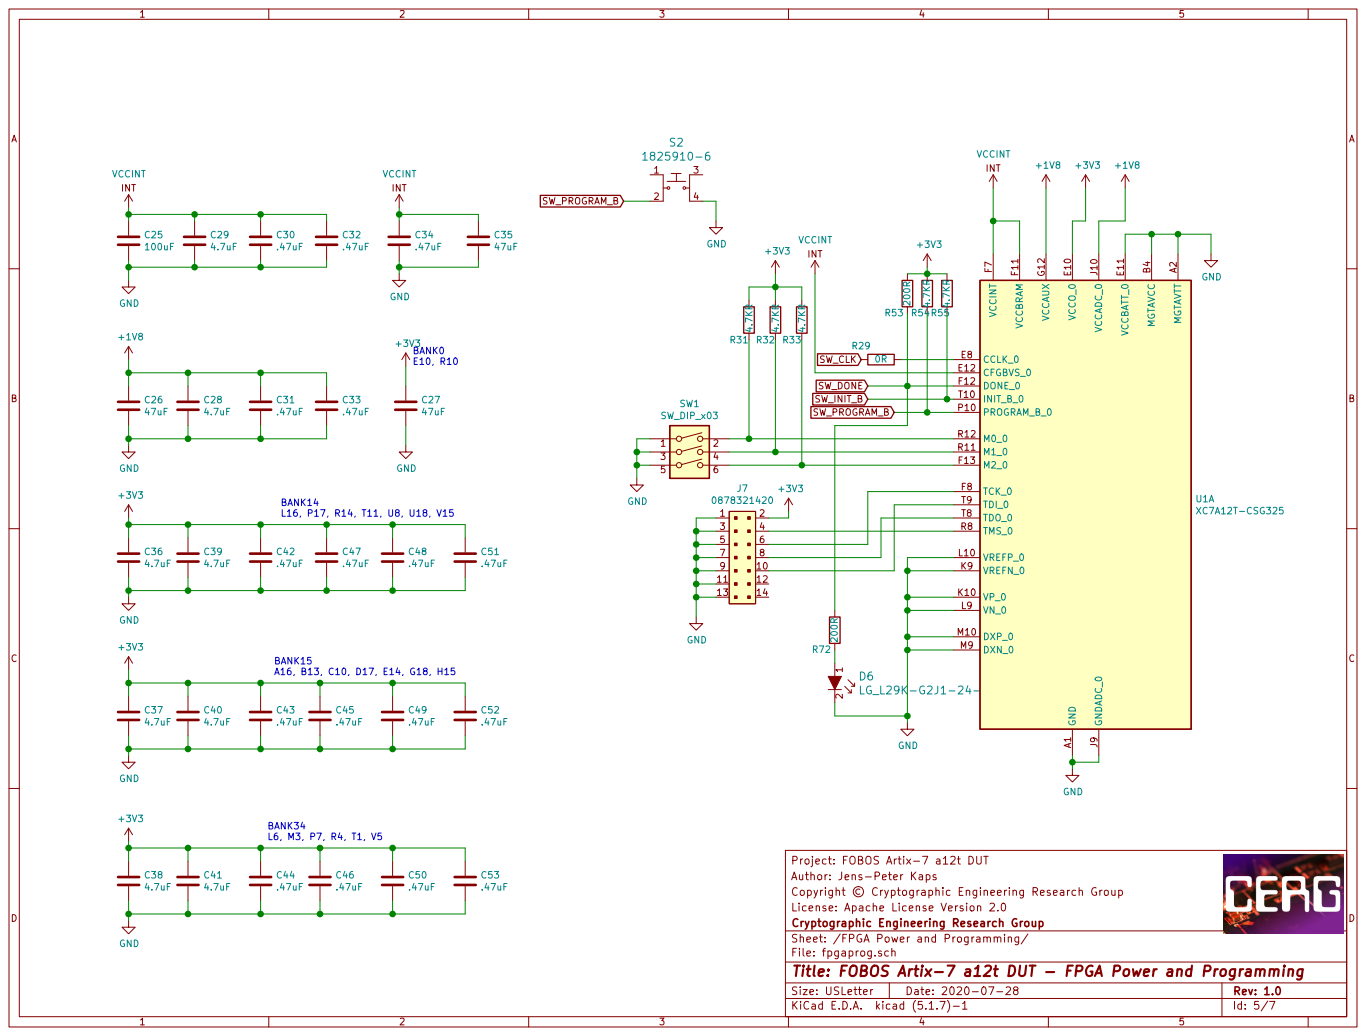
[picture p237: page 5]

9 | 10
11 | 12
13 | 14

Project: FOBOS Artix-7 a12t DUT
Author: Jens-Peter Kaps
Copyright © Cryptographic Engineering Research Group
License: Apache License Version 2.0
Cryptographic Engineering Research Group
Sheet: /FPGA Power and Programming/
File: fpgaprog.sch
Id: 5/7 Title: FOBOS Artix-7 a12t DUT - FPGA Power and Programming

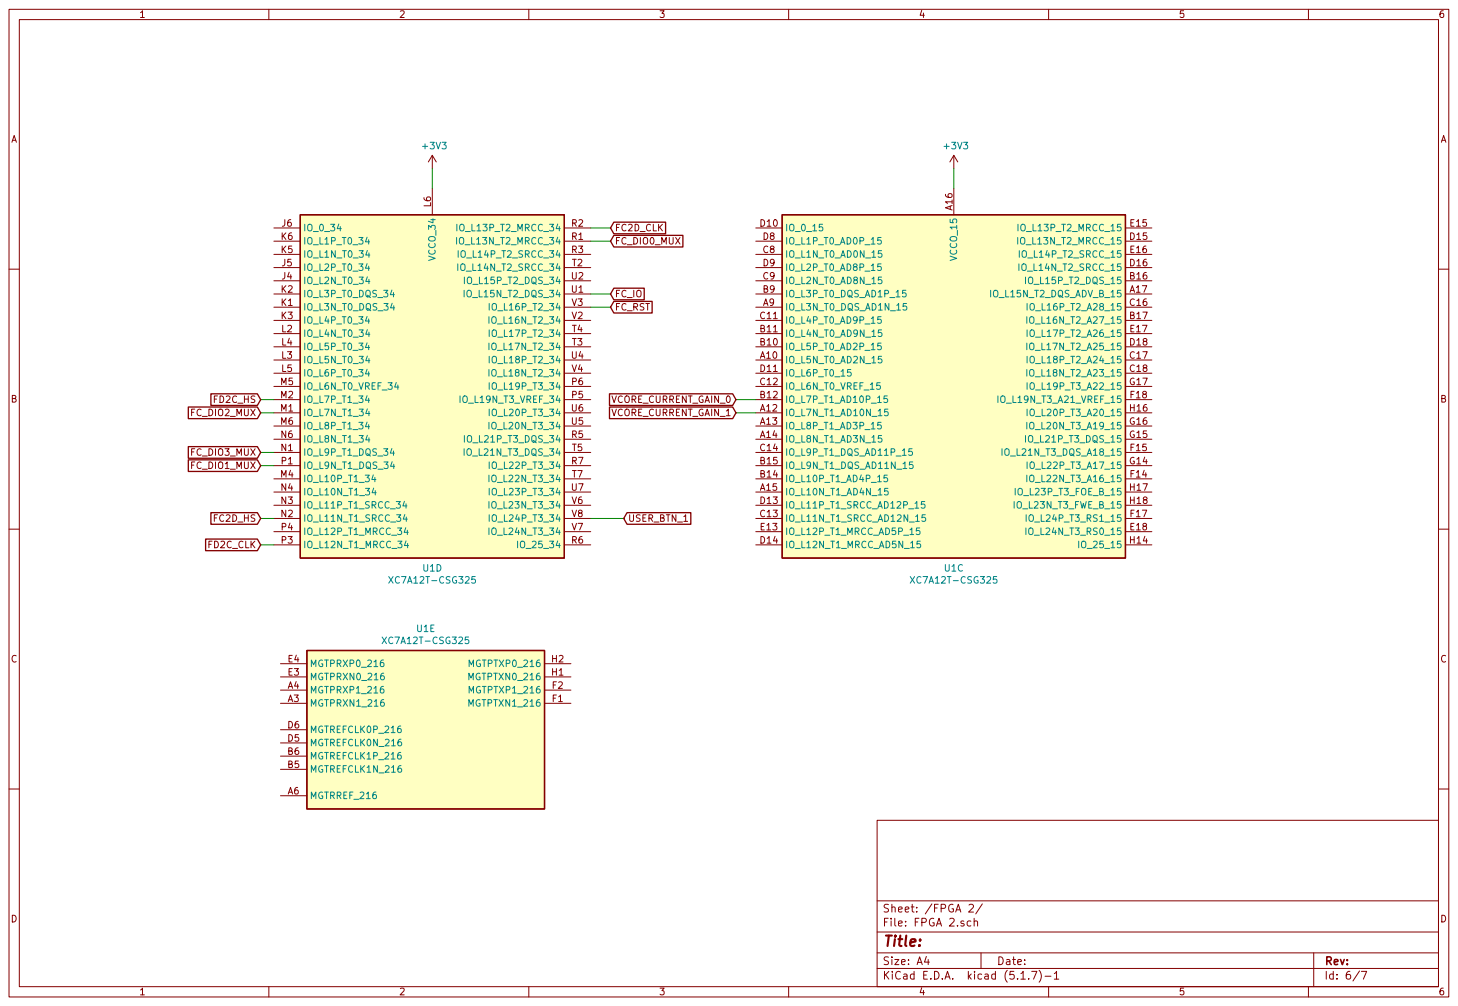
[picture p238: page 6]

Id: 6/7 Title: File: FPGA 2.sch Sheet: /FPGA 2/

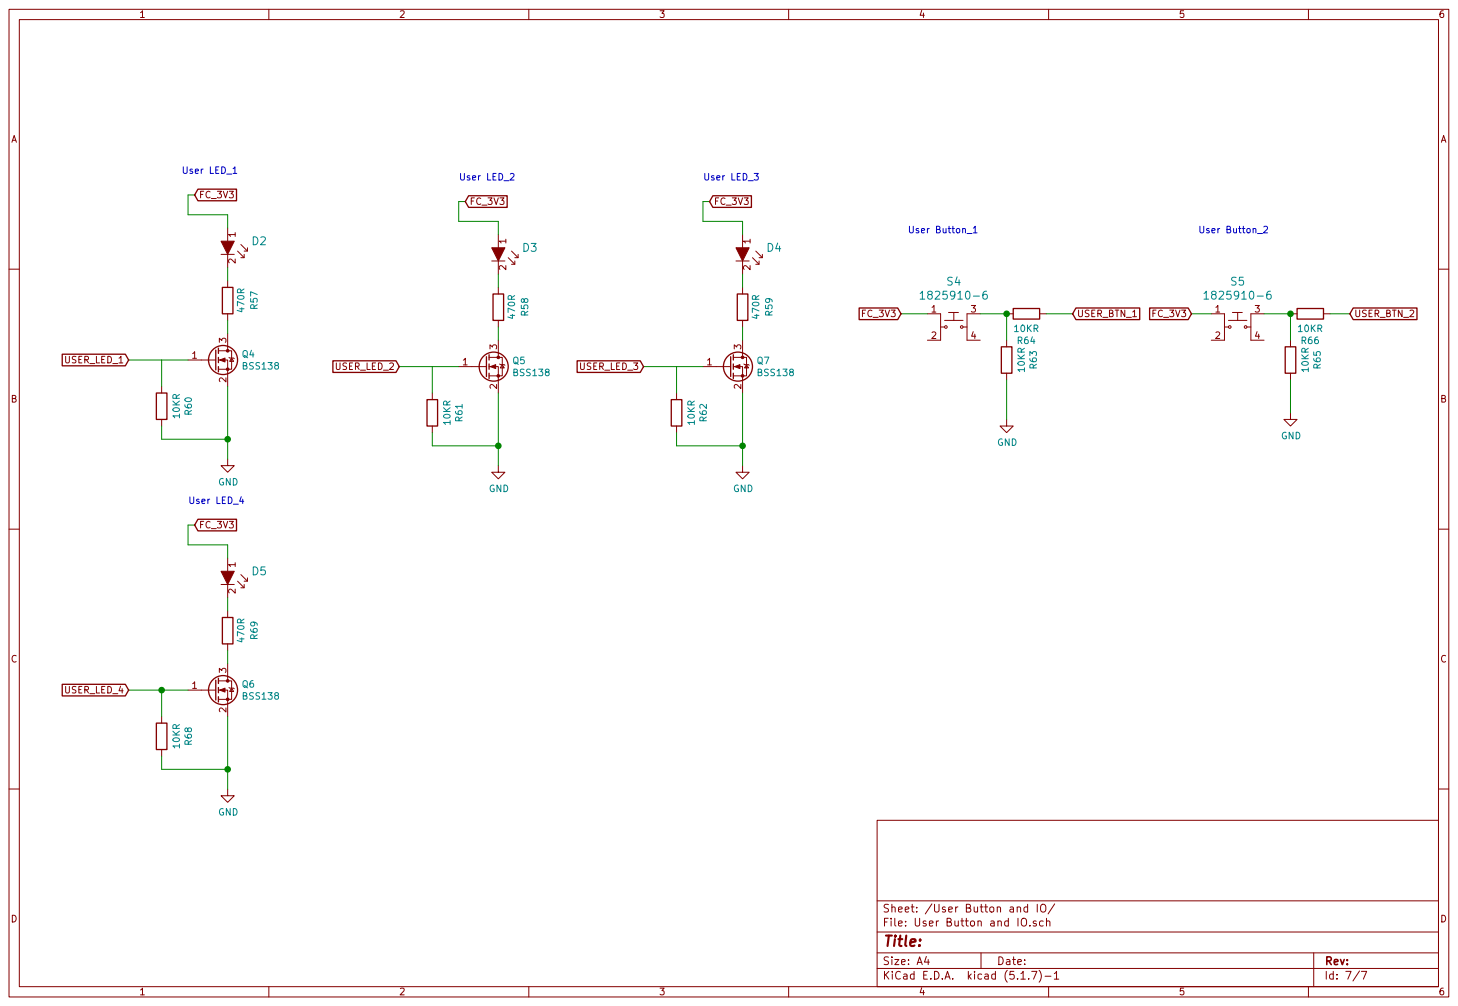
[picture p239: page 7]

1 2 D4 USER_LED_2 USER_LED_3 USER_LED_4 USER_LED_1 FC_3V3 FC_3V3 USER_BTN_2 FC_3V3 FC_3V3 FC_3V3 USER_BTN_1 FC_3V3 User Button_1 User LED_1 User Button_2 User LED_4 User LED_2 User LED_3
