kammoh/fobos/hardware/fobos-dut/dut-artix7-a12t-cpg238/Outputs/dut-artix7-a12t-schematic.pdf

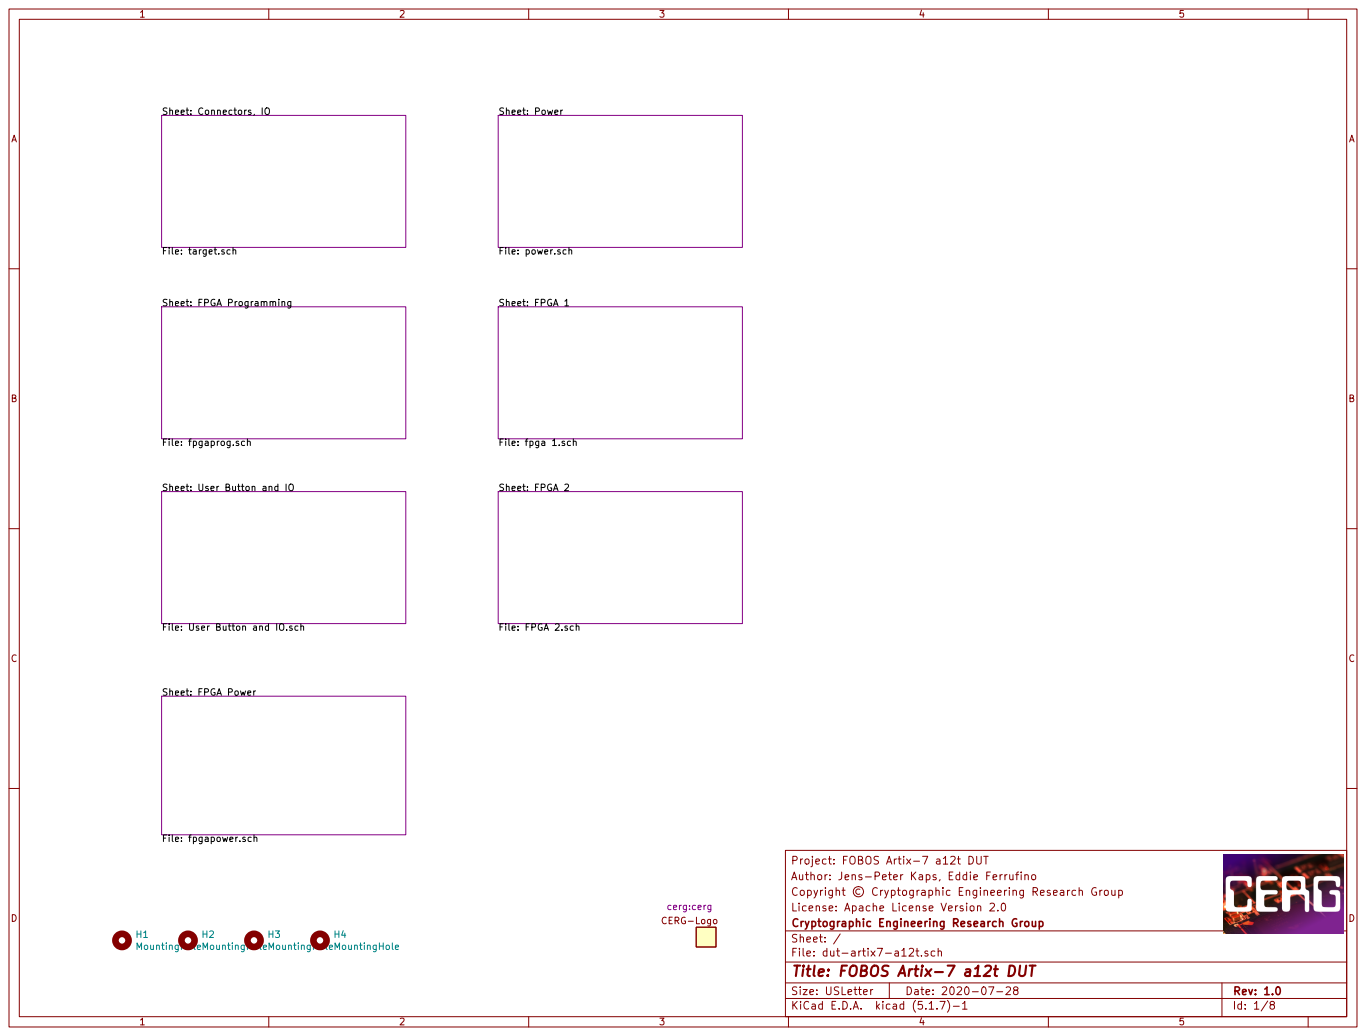
[picture p240: page 1]

File: fpgaprog.sch Sheet: User Button and IO

Project: FOBOS Artix-7 a12t DUT
Author: Jens-Peter Kaps, Eddie Ferrufino
Copyright © Cryptographic Engineering Research Group
License: Apache License Version 2.0
File: dut-artix7-a12t.sch Sheet: / Cryptographic Engineering Research Group

Id: 1/8 Title: FOBOS Artix-7 a12t DUT

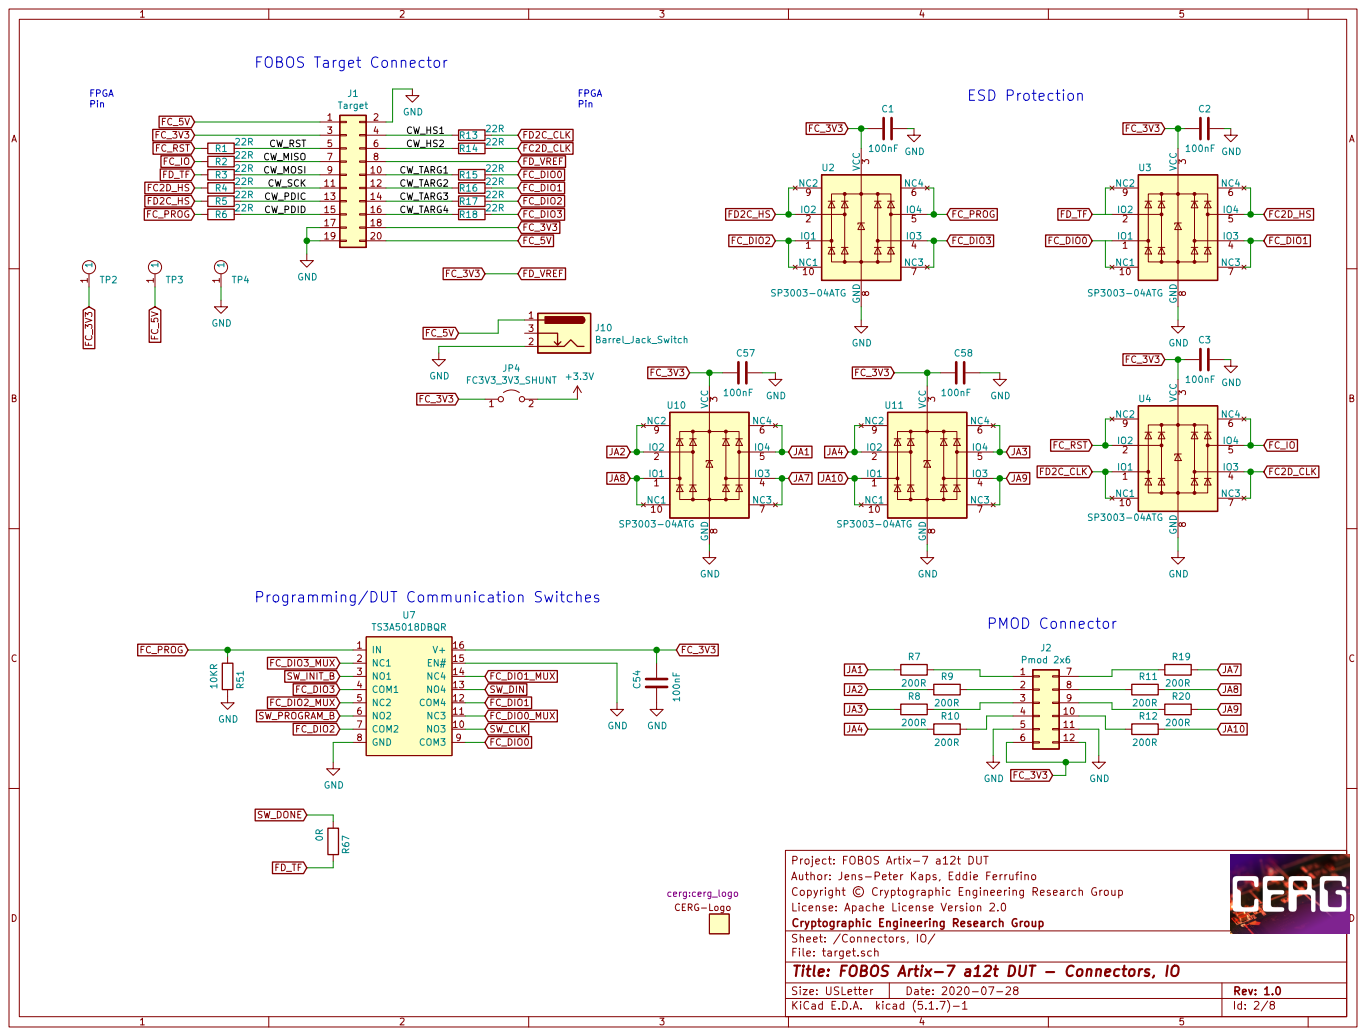
[picture p241: page 2]

Pin Programming/DUT Communication Switches

Project: FOBOS Artix-7 a12t DUT
Author: Jens-Peter Kaps, Eddie Ferrufino
Copyright © Cryptographic Engineering Research Group
License: Apache License Version 2.0
Cryptographic Engineering Research Group
Sheet: /Connectors, IO/
File: target.sch
Id: 2/8 Title: FOBOS Artix-7 a12t DUT - Connectors, IO

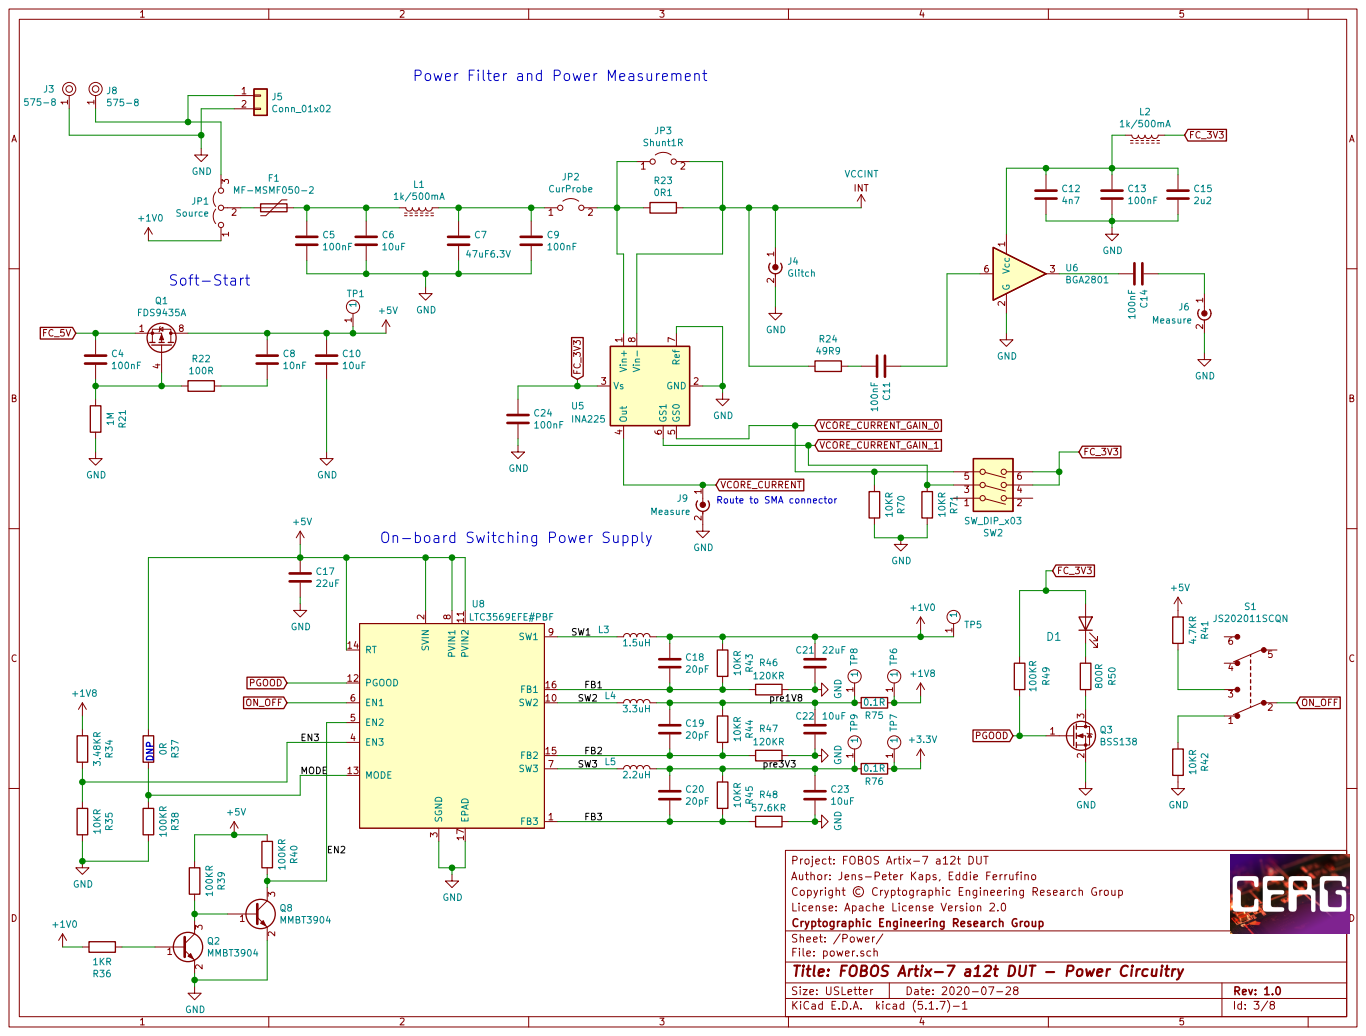
[picture p242: page 3]

Route to SMA connector Power Filter and Power Measurement

SW1FB1 FB2 On-board Switching Power Supply

Project: FOBOS Artix-7 a12t DUT
Author: Jens-Peter Kaps, Eddie Ferrufino
Copyright © Cryptographic Engineering Research Group
License: Apache License Version 2.0
File: power.sch Sheet: /Power/ Cryptographic Engineering Research Group

Id: 3/8 Title: FOBOS Artix-7 a12t DUT - Power Circuitry

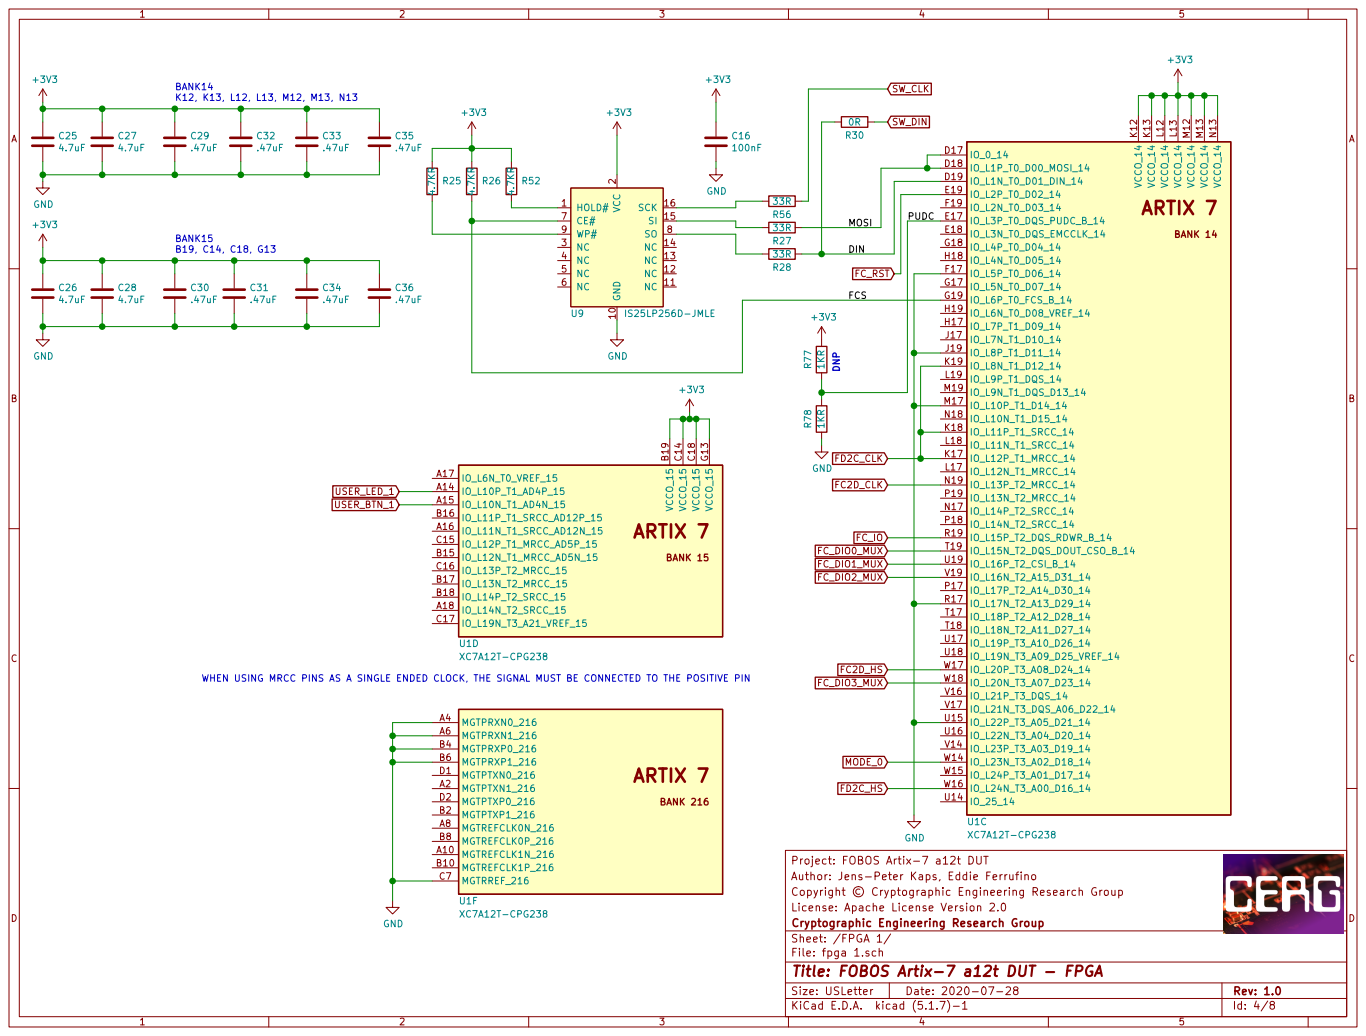
[picture p243: page 4]

2 NC 3 NC 4 NC 5 NC 6 CE# 7 SO 8 WP# 9 U9 IS25LP256D-JMLE R52 4.7KR R26 4.7KR

Project: FOBOS Artix-7 a12t DUT GND

Author: Jens-Peter Kaps, Eddie Ferrufino
Copyright © Cryptographic Engineering Research Group
License: Apache License Version 2.0
File: fpga 1.sch Sheet: /FPGA 1/ Cryptographic Engineering Research Group

Id: 4/8 Title: FOBOS Artix-7 a12t DUT - FPGA

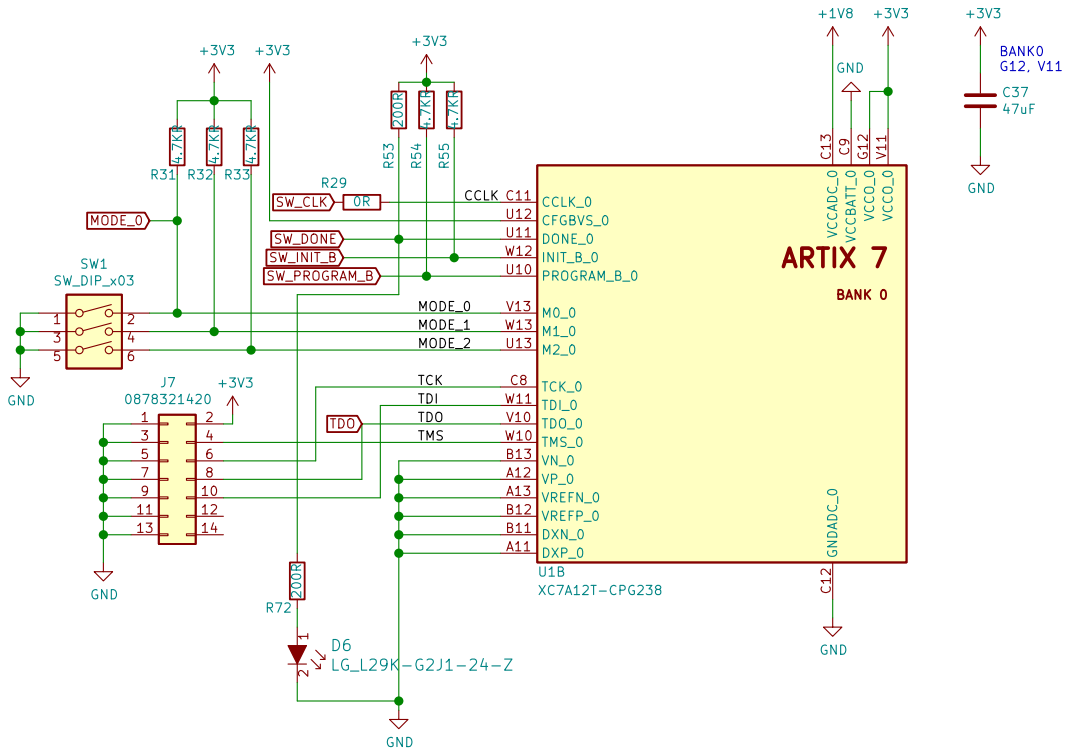
[picture p244: page 5]

Project: FOBOS Artix-7 a12t DUT GND GND

9 | 10
11 | 12
13 | 14

Author: Jens-Peter Kaps, Eddie Ferrufino
Copyright © Cryptographic Engineering Research Group
License: Apache License Version 2.0
Cryptographic Engineering Research Group
Sheet: /FPGA Programming/
File: fpgaprog.sch
Id: 5/8 Title: FOBOS ARTIX7-A12T-CPG238 DUT - FPGA Programming

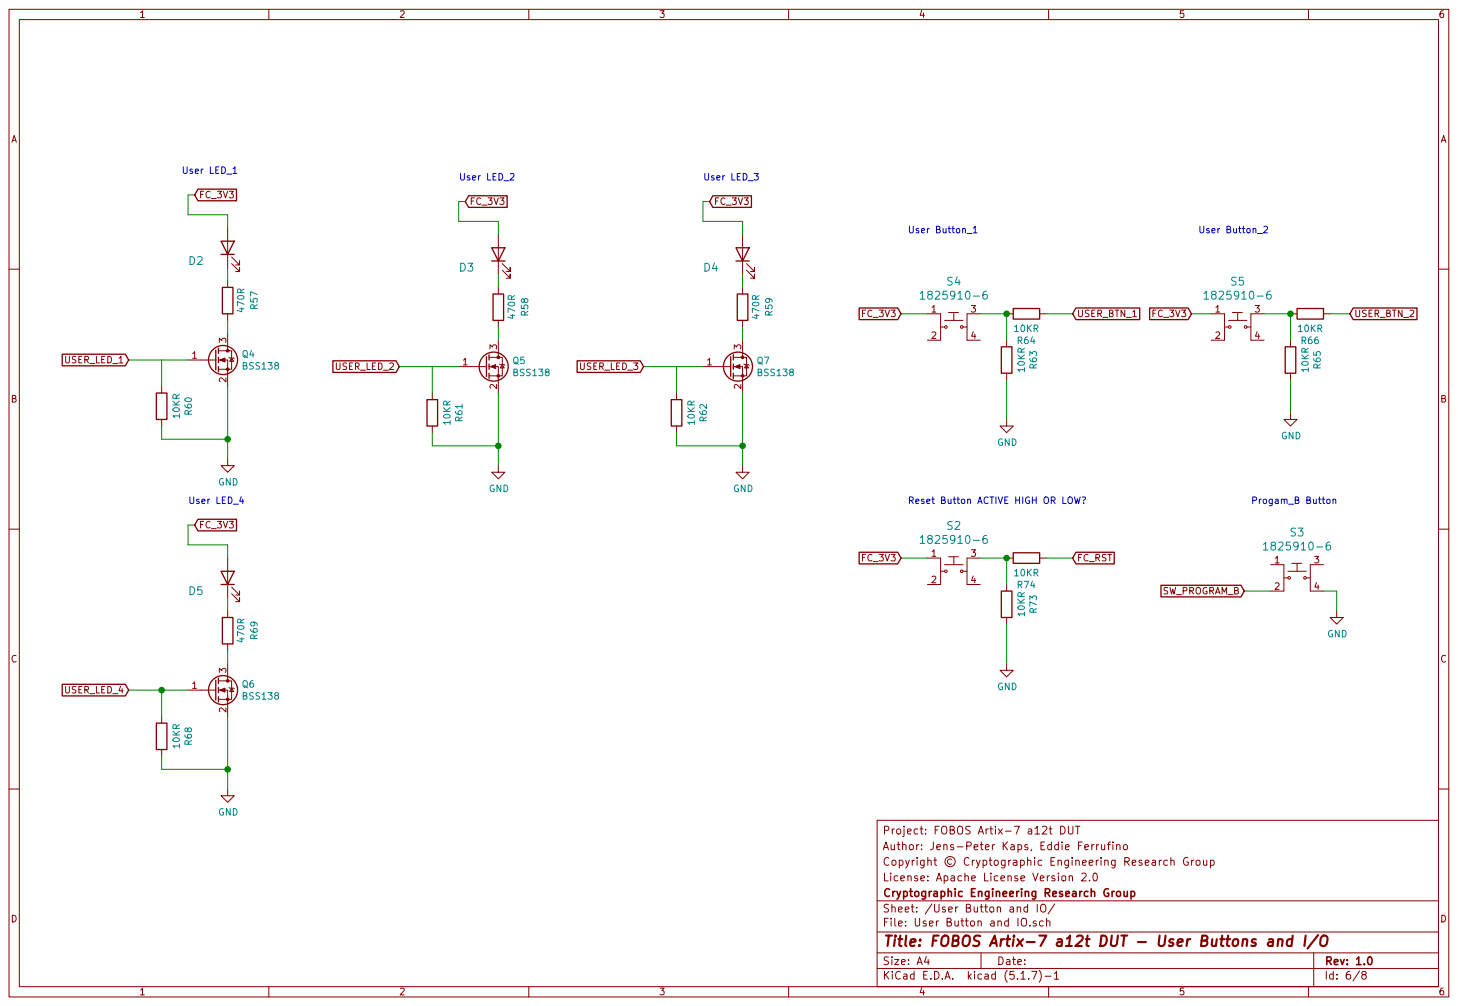
[picture p245: page 6]

Project: FOBOS Artix-7 a12t DUT R62 10KR

Author: Jens-Peter Kaps, Eddie Ferrufino
Copyright © Cryptographic Engineering Research Group
License: Apache License Version 2.0
File: User Button and IO.sch Sheet: /User Button and IO/ Cryptographic Engineering Research Group

Id: 6/8 Title: FOBOS Artix-7 a12t DUT - User Buttons and I/O

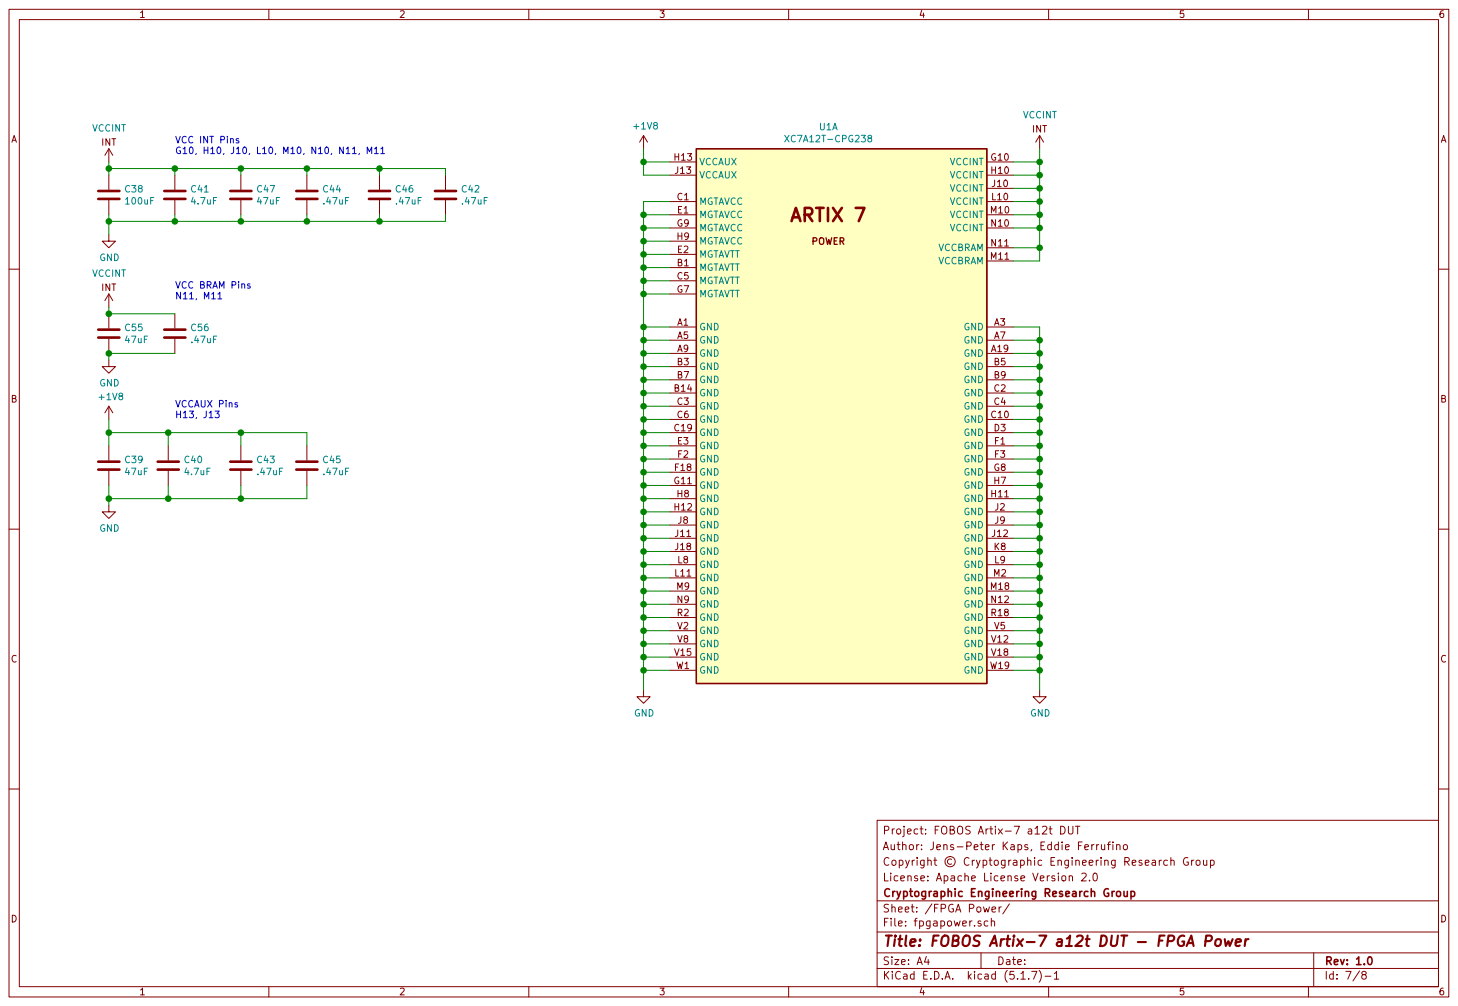
[picture p246: page 7]

XC7A12T-CPG238 C41
.47uF VCC INT Pins G10, H10, J10, L10, M10, N10, N11, M11 VCC BRAM Pins N11, M11 VCCAUX Pins H13, J13

Project: FOBOS Artix-7 a12t DUT
Author: Jens-Peter Kaps, Eddie Ferrufino
Copyright © Cryptographic Engineering Research Group
License: Apache License Version 2.0
File: fpgapower.sch Sheet: /FPGA Power/ Cryptographic Engineering Research Group

Id: 7/8 Title: FOBOS Artix-7 a12t DUT - FPGA Power

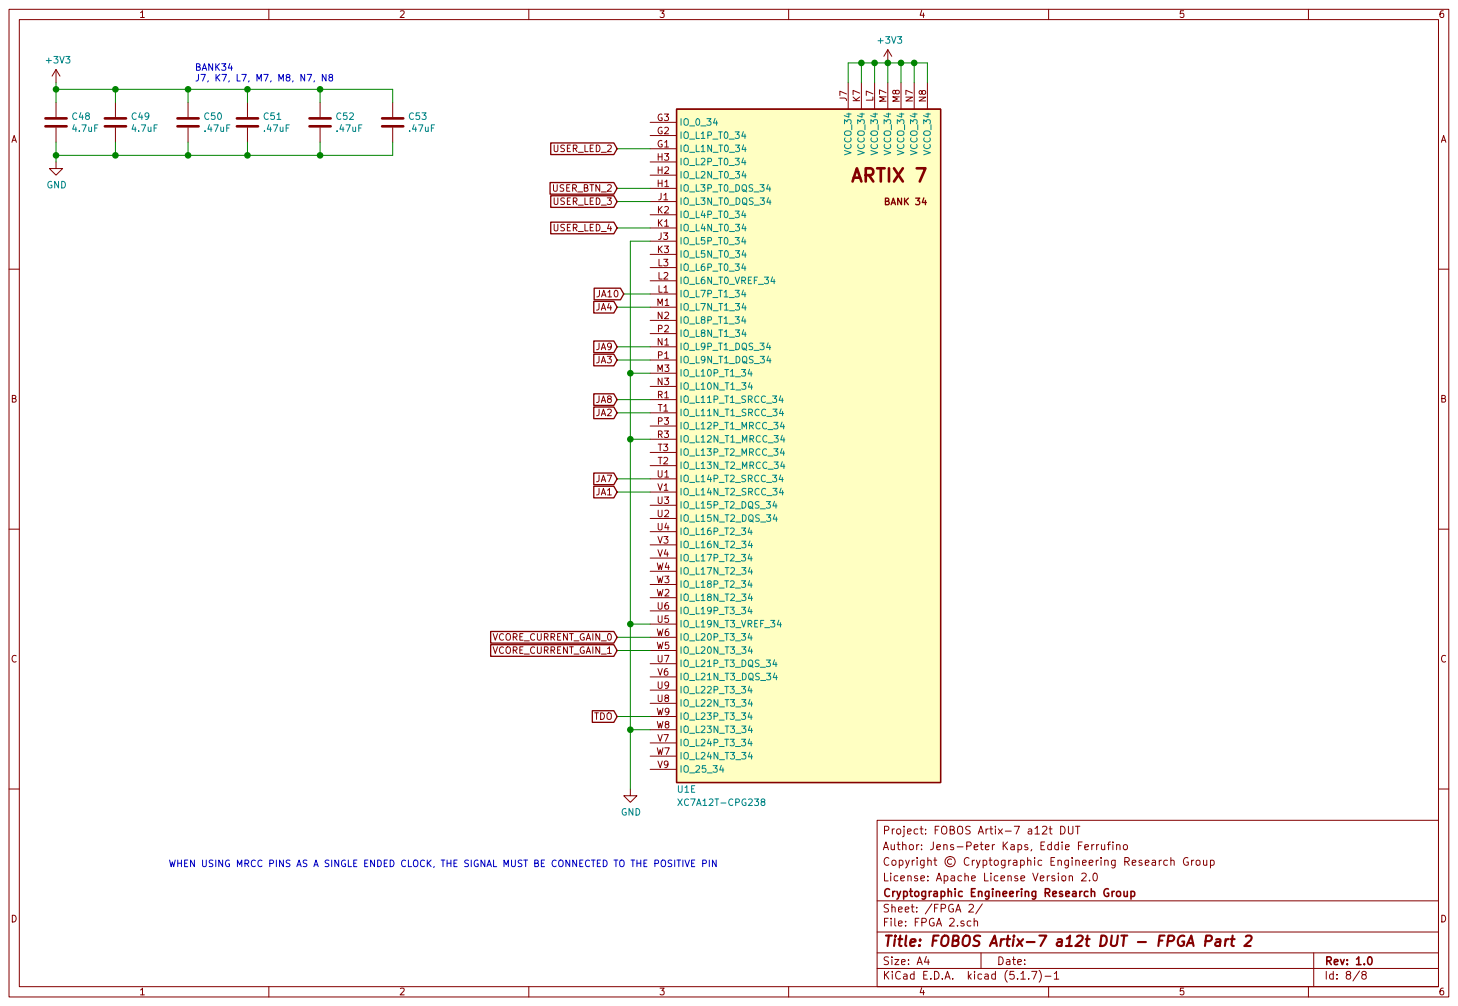
[picture p247: page 8]

JA7 BANK34
J7, K7, L7, M7, M8, N7, N8 WHEN USING MRCC PINS AS A SINGLE ENDED CLOCK, THE SIGNAL MUST BE CONNECTED TO THE POSITIVE PIN
USER_LED_2 USER_LED_4 USER_LED_3 VCORE_CURRENT_GAIN_1 TDO
USER_BTN_2 VCORE_CURRENT_GAIN_0

Project: FOBOS Artix-7 a12t DUT
Author: Jens-Peter Kaps, Eddie Ferrufino
Copyright © Cryptographic Engineering Research Group
License: Apache License Version 2.0
File: FPGA 2.sch Sheet: /FPGA 2/ Cryptographic Engineering Research Group

Id: 8/8 Title: FOBOS Artix-7 a12t DUT - FPGA Part 2
