kammoh/fobos/oldfobos/doc/UserGuide/figures/cmospwr.pdf

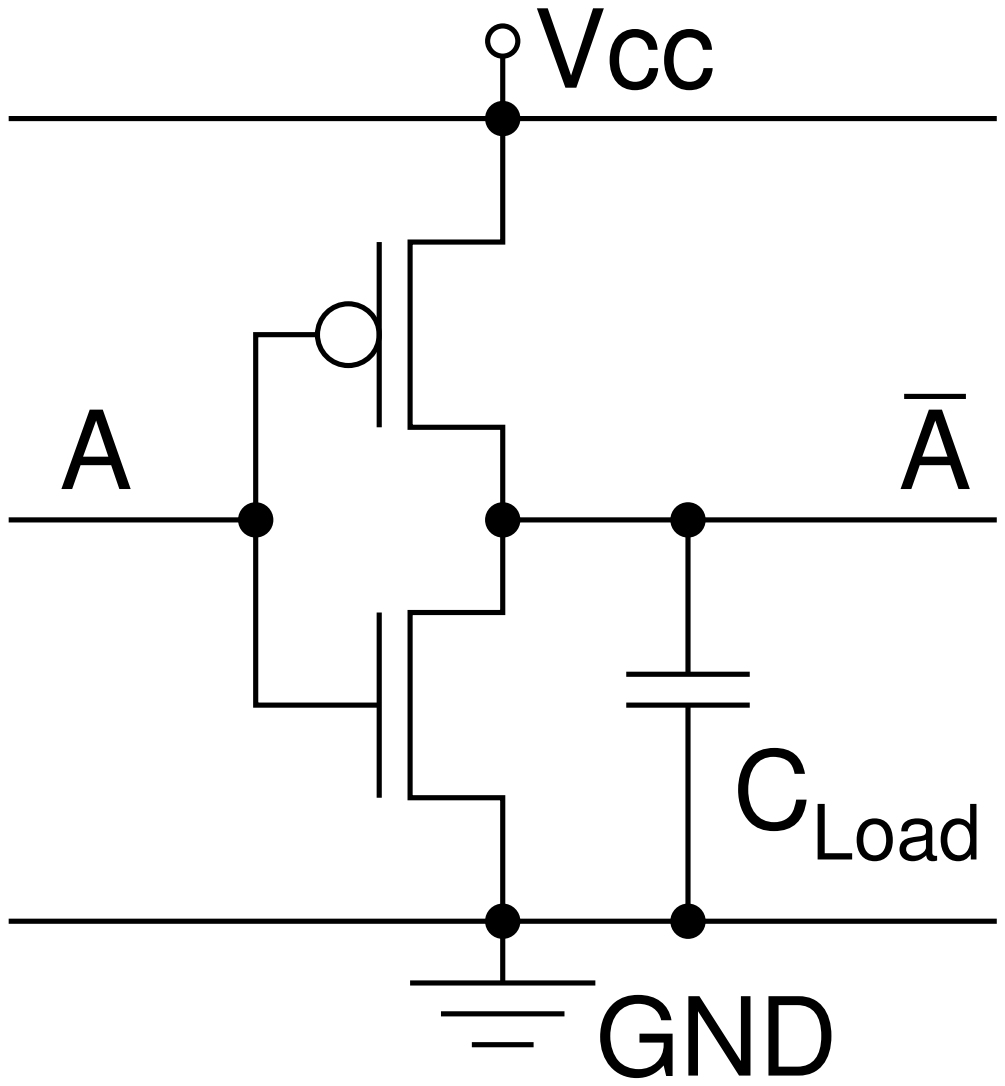
[picture p248: page 1]
Vcc; GND; CLoad
