kammoh/fobos/oldfobos/doc/UserGuide/figures/cmospwr1.pdf

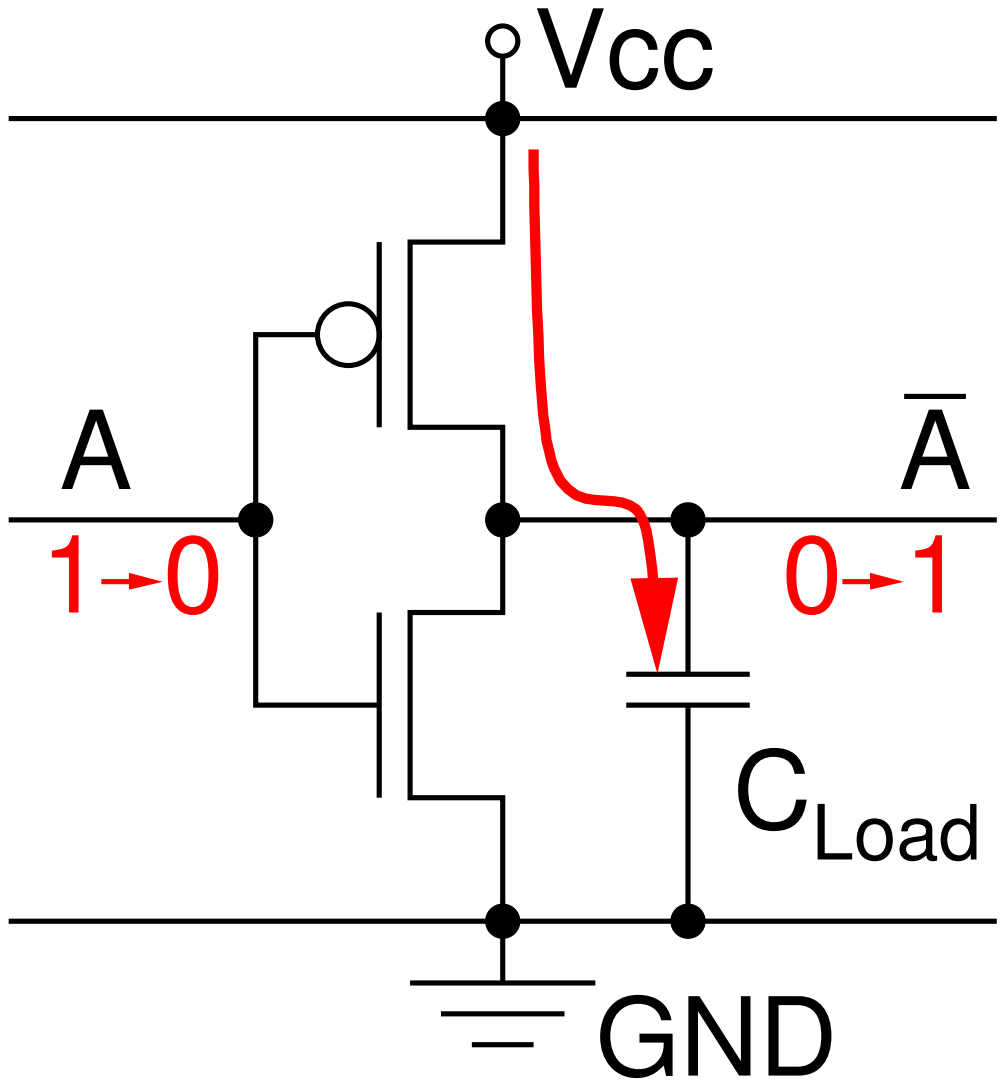
[picture p249: page 1]
Vcc; GND; CLoad
