kammoh/fobos/oldfobos/doc/UserGuide/figures/cmospwr2.pdf

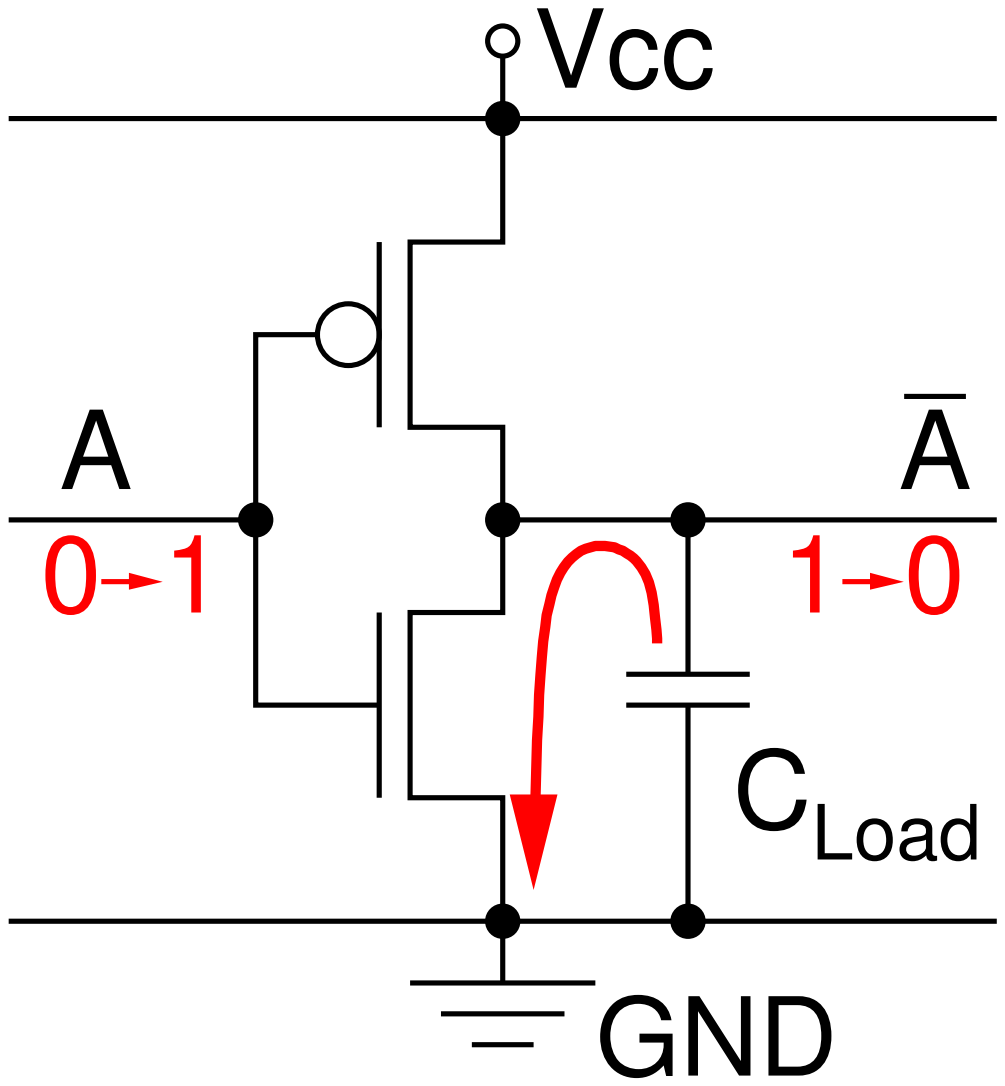
[picture p250: page 1]
Vcc; GND; CLoad
