kammoh/fobos/docs/source/figures/fobos3-remote.pdf

### FOBOS Control

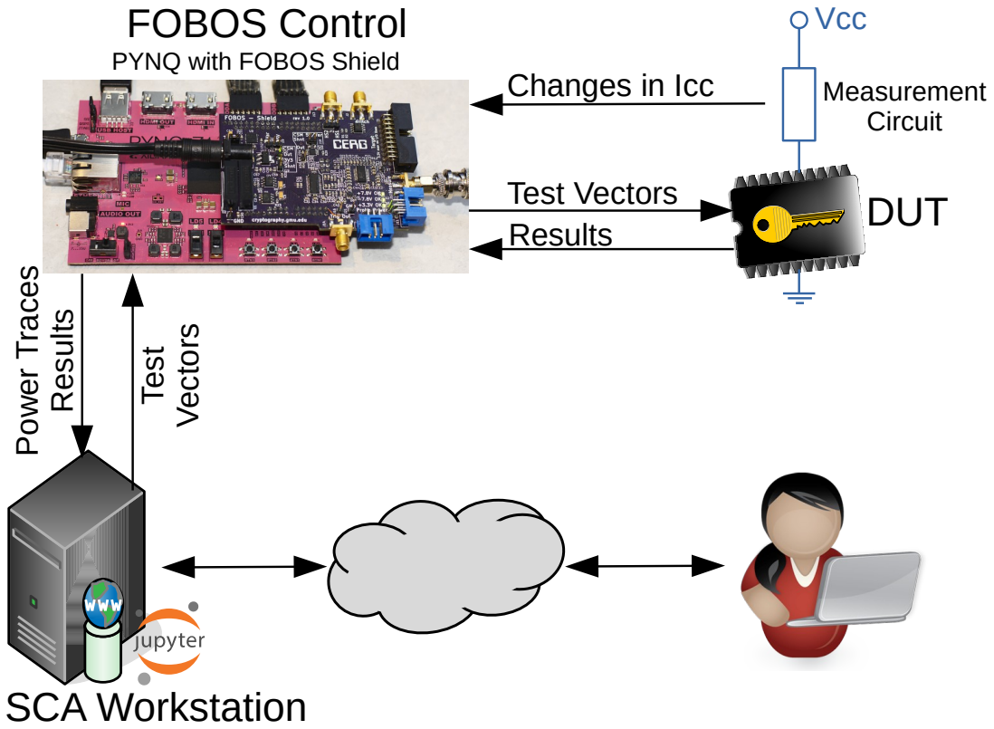
[picture p251: page 1]
Test Vectors Results; SCA Workstation; DUT; Vcc; ctors; er Tra; ults; Measurement Circuit

PYNQ with FOBOS Shield

Changes in Icc
