kammoh/fobos/oldfobos/doc/figures/fobos2-block.pdf

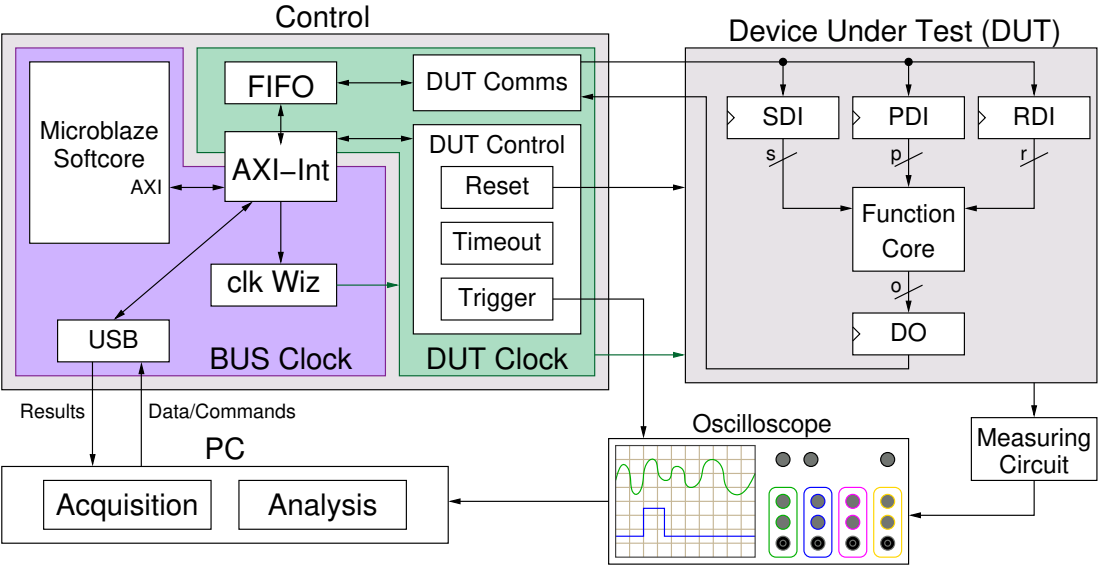
[picture p252: page 1]
FIFO; clk Wiz; Acquisition; Analysis; DUT Clock; Control; AXI−Int; BUS Clock; AXI; Results; Data/Commands; Timeout; Reset; Trigger; SDI; PDI; RDI; Core; Function; USB; Measuring Circuit; DUT Control; DUT Comms; Microblaze Softcore; Oscilloscope

Device Under Test (DUT)
