kammoh/fobos/oldfobos/doc/figures/fobos3-block.pdf

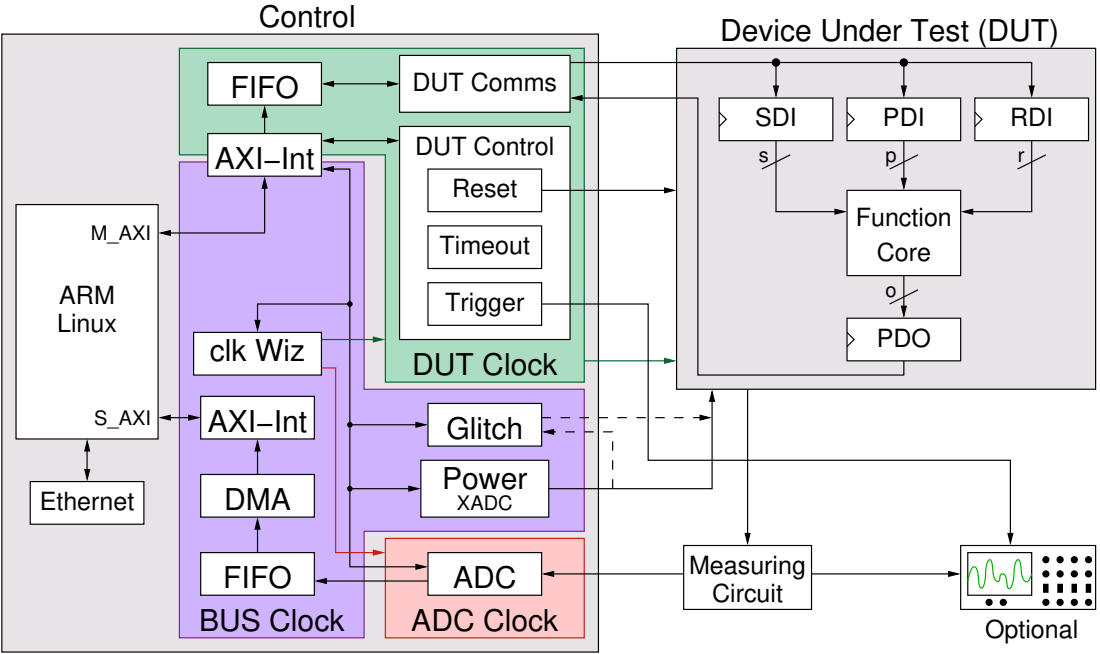
[picture p253: page 1]
DMA; XADC; Power; FIFO; ADC; clk Wiz; AXI−Int; Glitch; BUS Clock; ADC Clock; M_AXI; S_AXI; DUT Clock; Control; Timeout; Reset; Trigger; SDI; Measuring Circuit; PDI; RDI; Core; Function; PDO; Ethernet; DUT Control; DUT Comms; Optional; ARM Linux

Device Under Test (DUT)
