kammoh/fobos/oldfobos/doc/figures/fobos-block.pdf

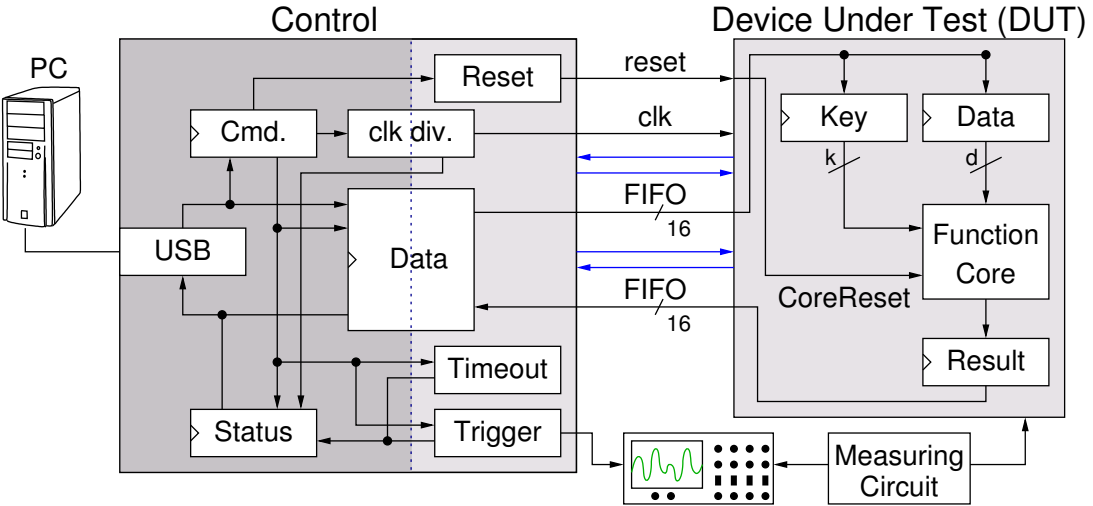
[picture p254: page 1]
Control; Device Under Test (DUT); FIFO; clk; reset; CoreReset; Status; Trigger; Timeout; USB; Reset; Cmd.; Key; Data; Core; Function; Result; clk div.; Measuring Circuit
