kammoh/fobos/oldfobos/doc/figures/fobos-dac.pdf

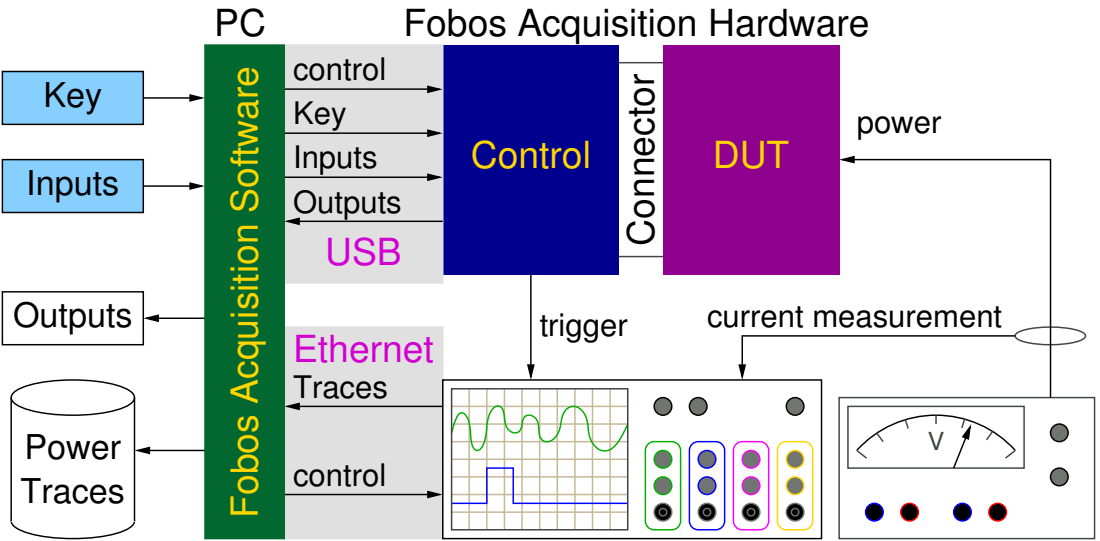
[picture p255: page 1]
Key; Inputs; Outputs; Power Traces; Connector; Control; DUT; trigger; power; current measurement; control; Traces; control Key Inputs Outputs USB; Ethernet

Fobos Acquisition Hardware

Fobos Acquisition Software
