kammoh/fobos/oldfobos/doc/figures/fobos-top.pdf

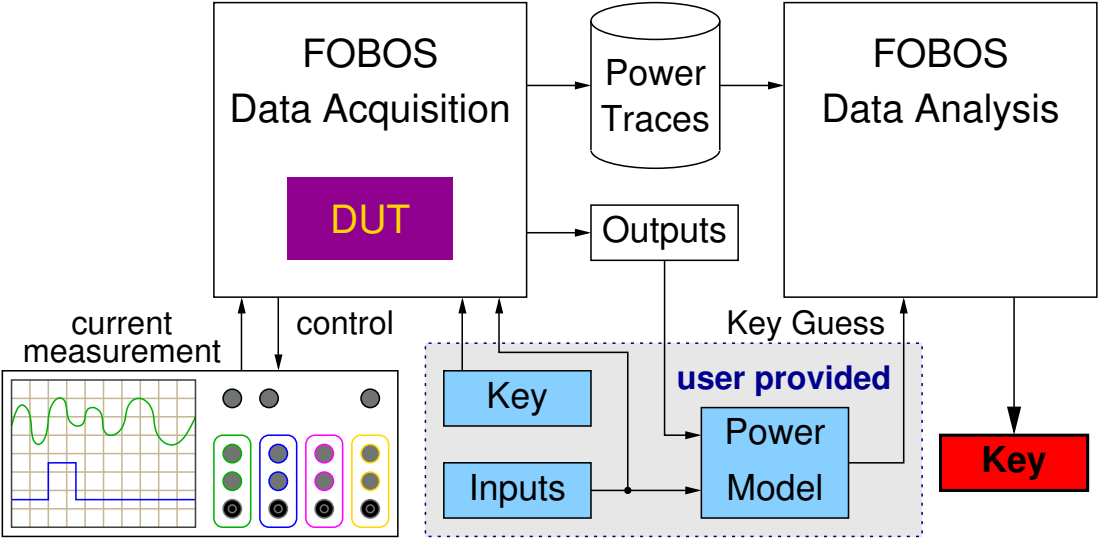
[picture p256: page 1]
Data Acquisition; FOBOS; DUT; Key; Power Traces; Inputs; Power; Model; Outputs; Data Analysis; measurement; current; control; Key Guess; user provided
