kammoh/fobos/oldfobos/doc/UserGuide/figures/aes128.pdf

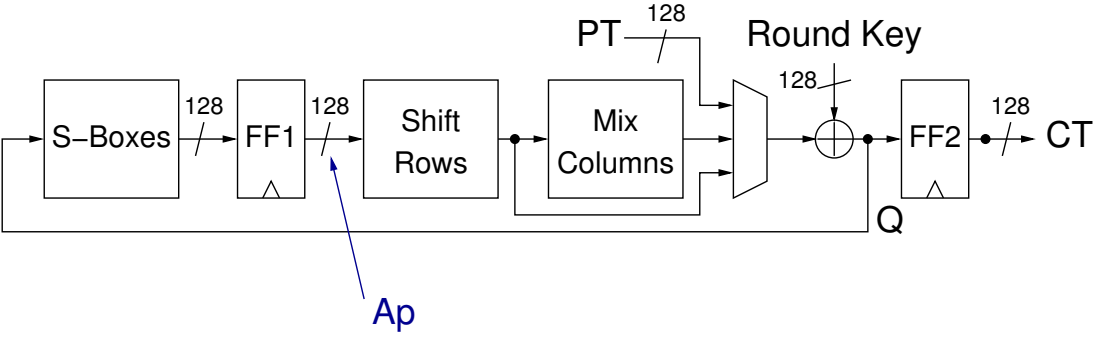
[picture p257: page 1]
S−Boxes; Columns; Shift; Mix; Rows; Round Key
