kammoh/fobos/oldfobos/doc/UserGuide/figures/aescompblock.pdf

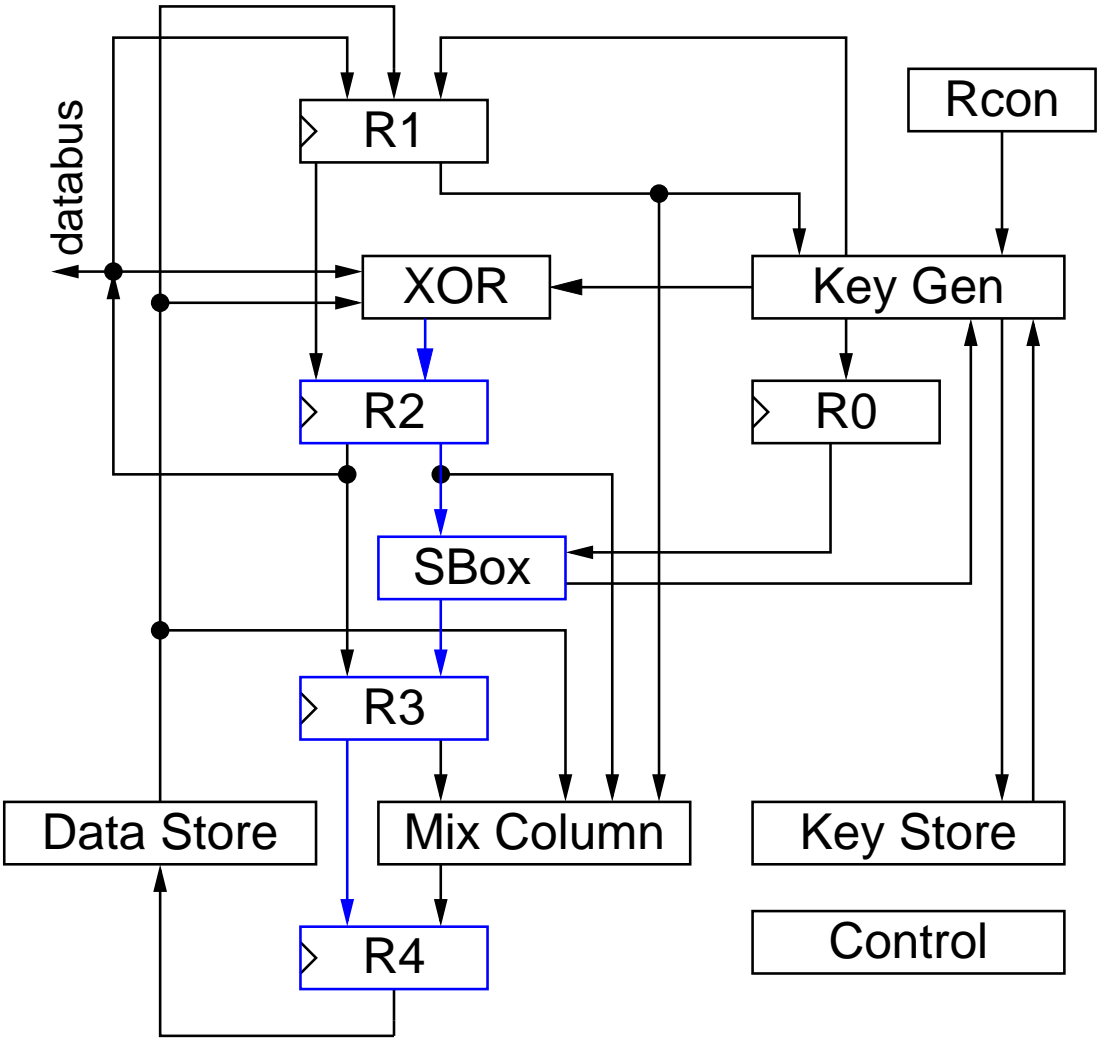
[picture p258: page 1]
Mix Column; Key Gen; Rcon; Key Store; Control; databus; Data Store; SBox; XOR
