kammoh/fobos/oldfobos/doc/UserGuide/figures/corr_plot.pdf

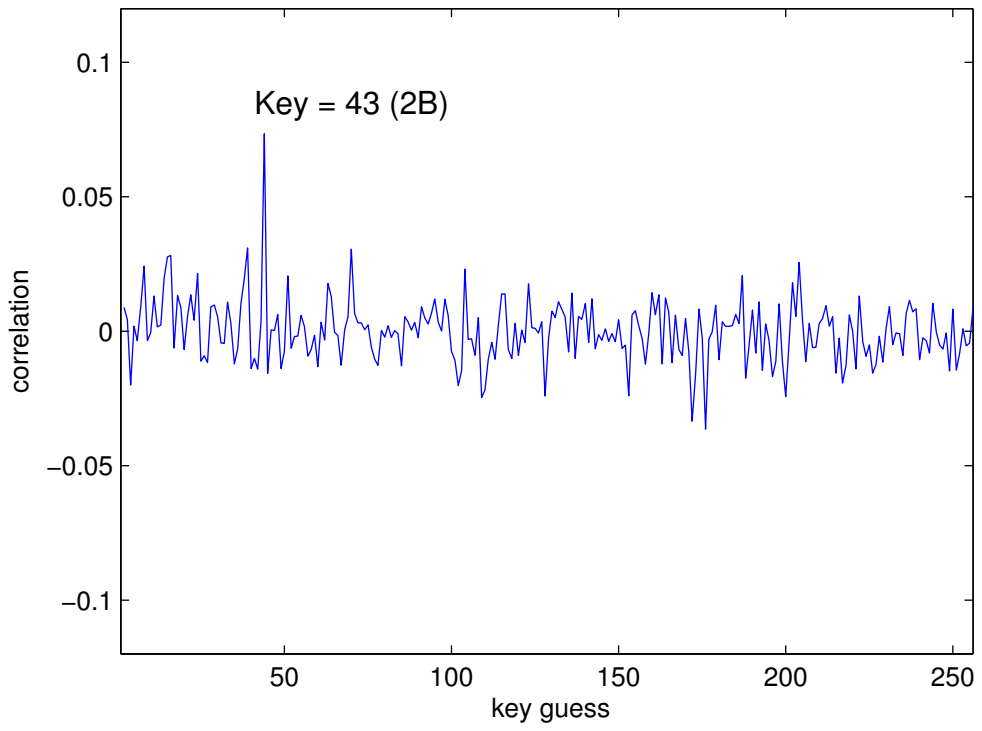
[picture p259: page 1]
key guess; correlation; Key = 43 (2B)
