kammoh/fobos/oldfobos/doc/UserGuide/figures/mtd_plot.pdf

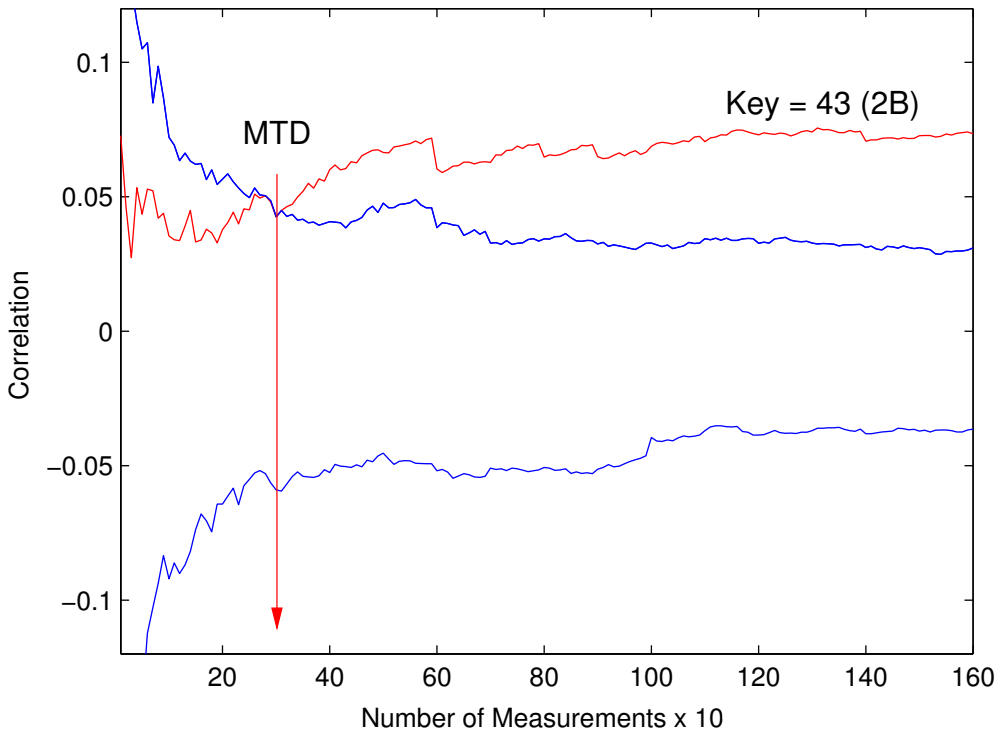
[picture p260: page 1]
Correlation; Key = 43 (2B); MTD

Number of Measurements x 10²
