kammoh/fobos/oldfobos/temp/mem_buffer/schematics/micron cellular ram mt45w8mw16 FSM Async.pdf

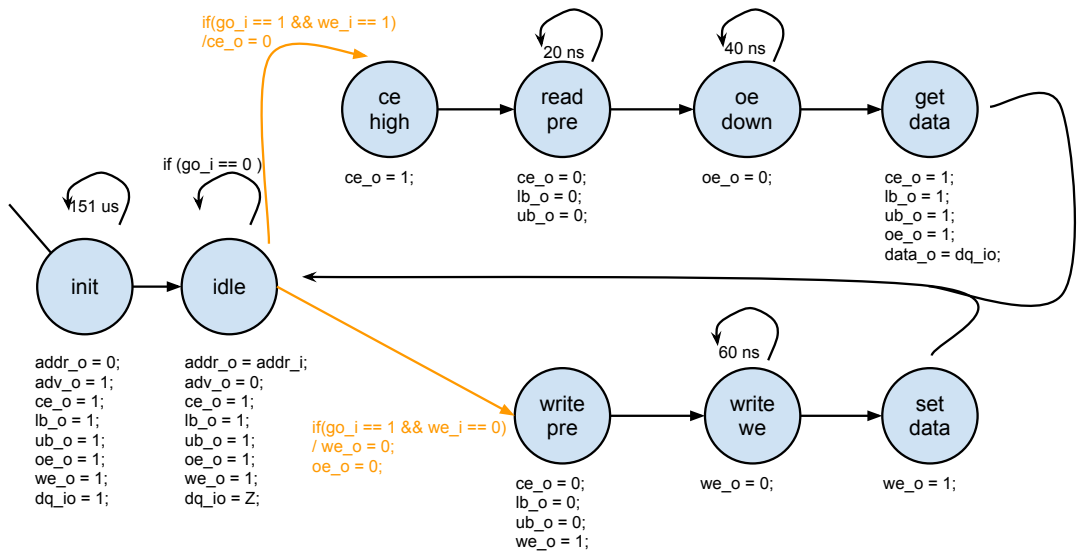
[picture p261: page 1]
init; oe down; idle; ce high; read pre; write pre; write we; set data; get data; addr_o = 0; adv_o = 1; ce_o = 1; lb_o = 1; ub_o = 1; oe_o = 1; we_o = 1; dq_io = 1;; addr_o = addr_i; adv_o = 0; ce_o = 1; lb_o = 1; ub_o = 1; oe_o = 1; we_o = 1; dq_io = Z;; lb_o = 1; ub_o = 1; oe_o = 1; data_o = dq_io;
