kammoh/fobos/docs/source/figures/DUT-artix7-power.pdf

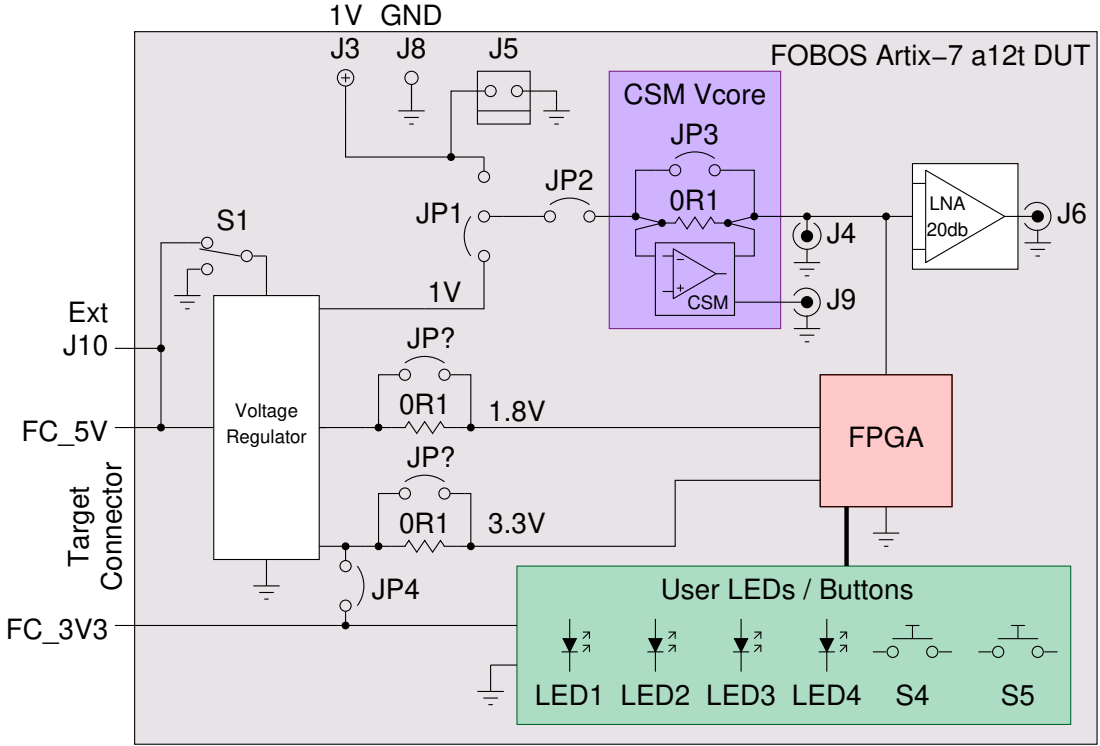
[picture p262: page 1]
