kammoh/fobos/docs/source/figures/fobos3-power-rev2.pdf

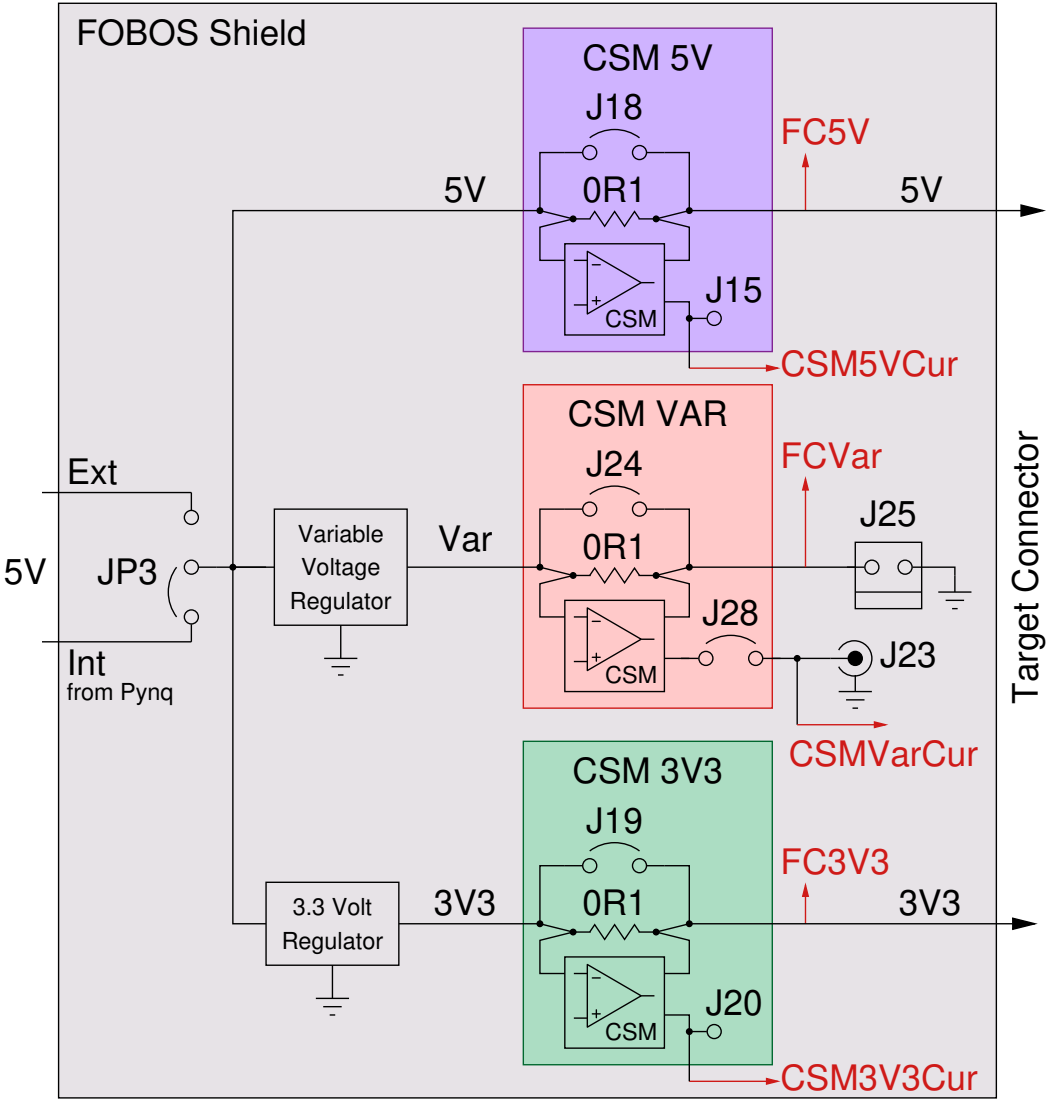
[picture p263: page 1]
