kammoh/fobos/hardware/fobos-dut/dut-artix7-a12t-cpg238/dut-artix7-a12t.kicad_pcb

## KiCad design hardware/fobos-dut/dut-artix7-a12t-cpg238/dut-artix7-a12t.kicad_pcb (2022-08-14)

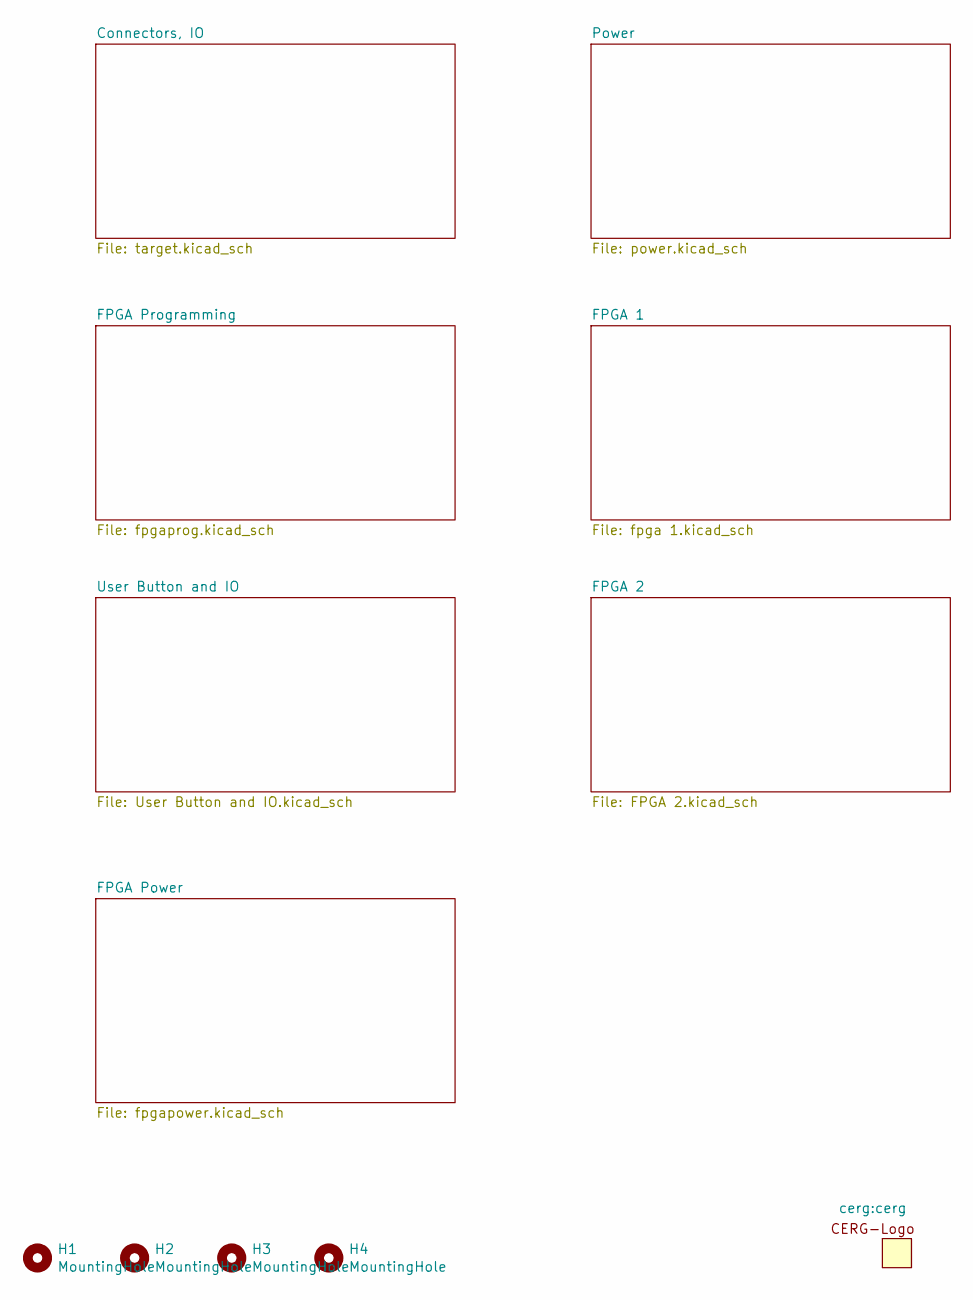
[picture p265: schematic dut-artix7-a12t.kicad_sch, FOBOS Artix-7 a12t DUT]

Parts:
H1, H2, H3, H4: MountingHole; MH_4-40

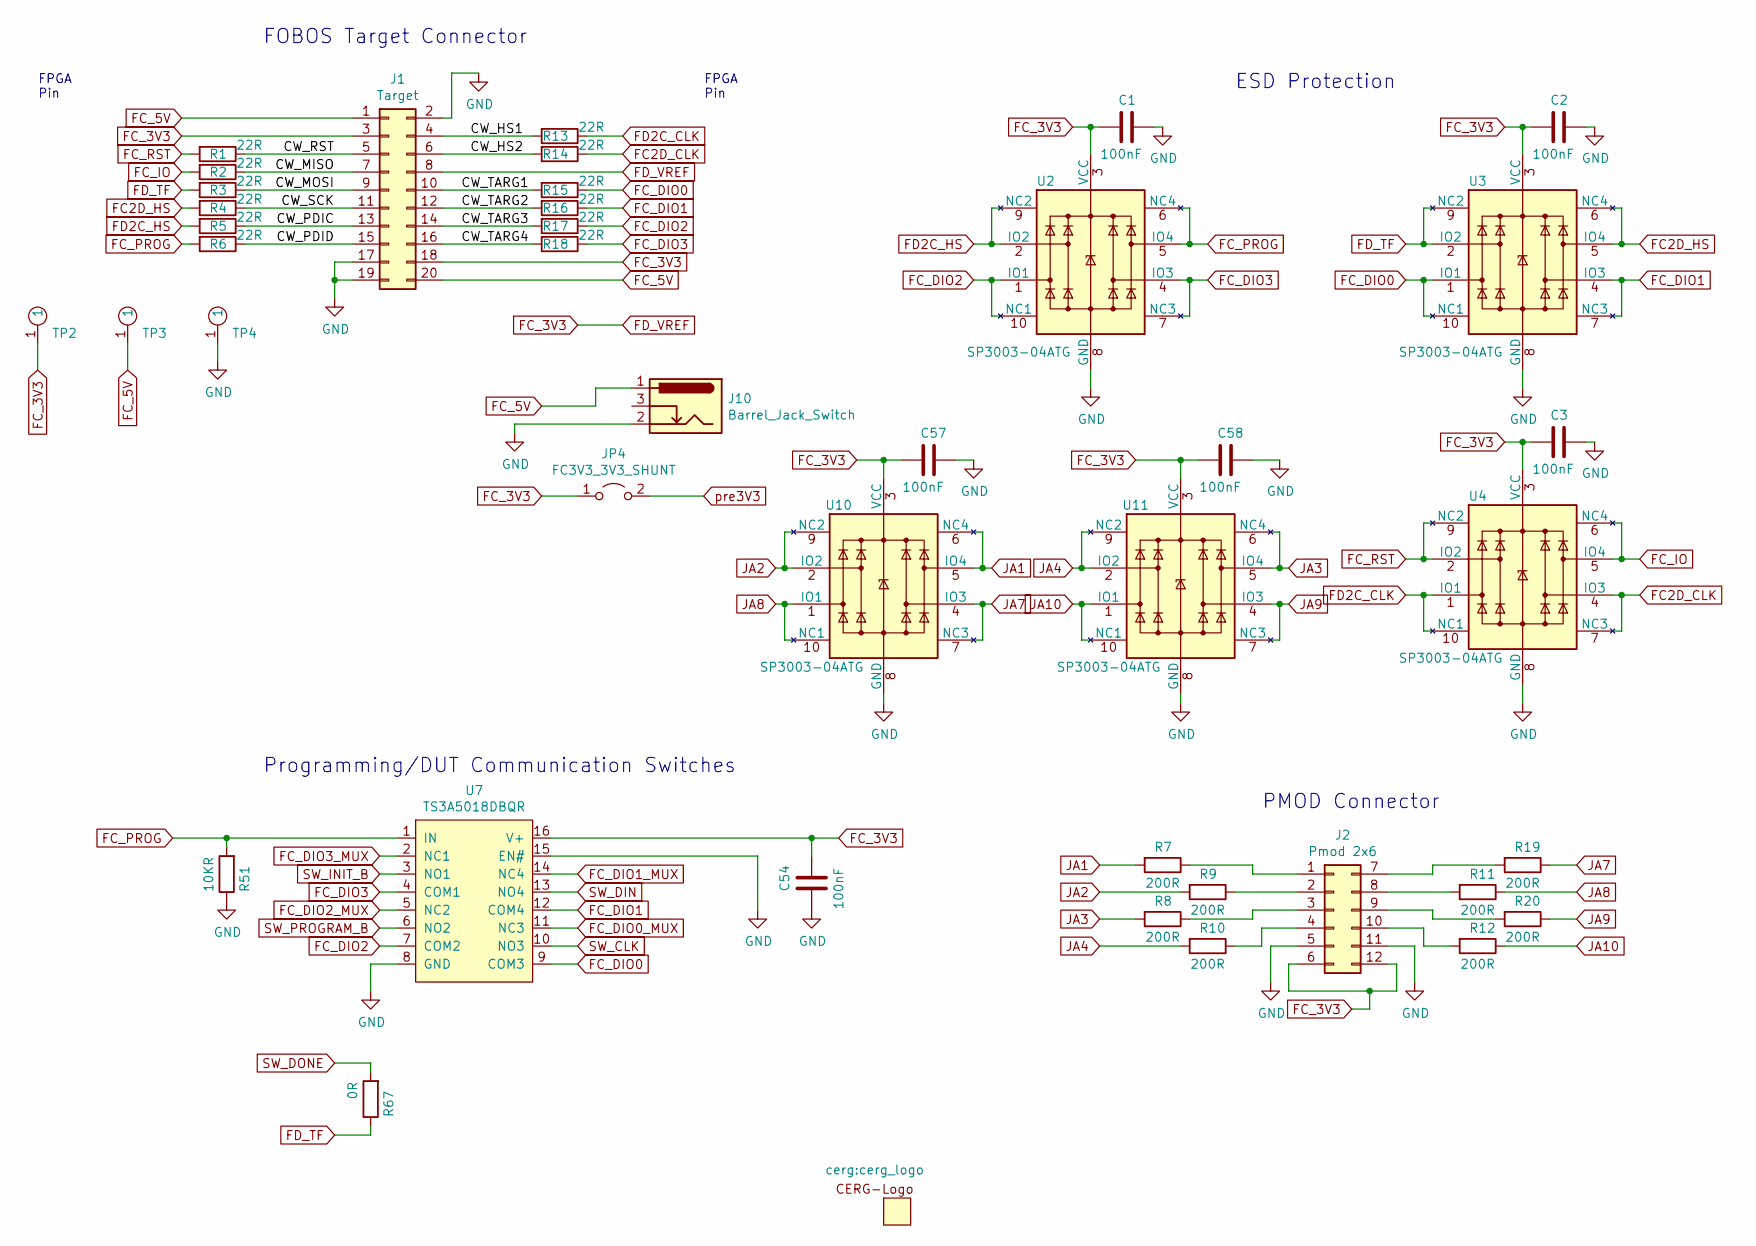
[picture p266: schematic target.kicad_sch, FOBOS Artix-7 a12t DUT - Connectors, IO]

Parts:
C1, C2, C3, C54, C57, C58: 100nF; C_0603_1608Metric; MPN 06036C104KAT4A
J1: Target; IDC-Header_2x10_P2.54mm_Horizontal; MPN 61202021721
J2: Pmod 2x6; PinSocket_2x06_P2.54mm_Horizontal_FLipped; MPN PH2RA-12-UA
J10: Barrel_Jack_Switch; BarrelJack_CUI_PJ-102AH_Horizontal
JP4: FC3V3_3V3_SHUNT; PinHeader_1x02_P2.54mm_Vertical; MPN 10129378-902001BLF
R1, R2, R3, R4, R5, R6, R13, R14, R15, R16, R17, R18: 22R; R_0603_1608Metric; MPN ERJ-U03J220V
R7, R8, R9, R10, R11, R12, R19, R20: 200R; R_0603_1608Metric; MPN ERA-3AED201V
R51: 10KR; R_0603_1608Metric; MPN ERJ-3EKF1002V
R67: 0R; R_0603_1608Metric; MPN RMCF0603ZT0R00
TP2, TP3, TP4: 5281; MPN 5281
U2, U3, U4, U10, U11: SP3003-04ATG; MSOP-10_3x3mm_P0.5mm; MPN SP3003-04ATG
U7: TS3A5018DBQR; SSOP-16_4.0x5.0mm_P0.635mm; MPN TS3A5018DBQR

Connections:
/Connectors, IO/CW_HS1: J1.4, R13.2
/Connectors, IO/CW_HS2: J1.6, R14.2
/Connectors, IO/CW_MISO: J1.7, R2.1
/Connectors, IO/CW_MOSI: J1.9, R3.1
/Connectors, IO/CW_PDIC: J1.13, R5.1
/Connectors, IO/CW_PDID: J1.15, R6.1
/Connectors, IO/CW_RST: J1.5, R1.1
/Connectors, IO/CW_SCK: J1.11, R4.1
/Connectors, IO/CW_TARG1: J1.10, R15.2
/Connectors, IO/CW_TARG2: J1.12, R16.2
/Connectors, IO/CW_TARG3: J1.14, R17.2
/Connectors, IO/CW_TARG4: J1.16, R18.2
FC2D_CLK: R14.1, U4.4 (IO3), U4.7 (NC3); also elsewhere on the board
FC2D_HS: R4.2, U3.5 (IO4), U3.6 (NC4); also elsewhere on the board
FC_5V: J1.1, J1.20, J10.1, TP3.1; also elsewhere on the board
FC_DIO0: R15.1, U3.1 (IO1), U3.10 (NC1), U7.9 (COM3)
FC_DIO0_MUX: U7.11 (NC3); also elsewhere on the board
FC_DIO1: R16.1, U3.4 (IO3), U3.7 (NC3), U7.12 (COM4)
FC_DIO1_MUX: U7.14 (NC4); also elsewhere on the board
FC_DIO2: R17.1, U2.1 (IO1), U2.10 (NC1), U7.7 (COM2)
FC_DIO2_MUX: U7.5 (NC2); also elsewhere on the board
FC_DIO3: R18.1, U2.4 (IO3), U2.7 (NC3), U7.4 (COM1)
FC_DIO3_MUX: U7.2 (NC1); also elsewhere on the board
FC_IO: R2.2, U4.5 (IO4), U4.6 (NC4); also elsewhere on the board
FC_PROG: R6.2, R51.2, U2.5 (IO4), U2.6 (NC4), U7.1 (IN)
FC_RST: R1.2, U4.2 (IO2), U4.9 (NC2); also elsewhere on the board
FD2C_CLK: R13.1, U4.1 (IO1), U4.10 (NC1); also elsewhere on the board
FD2C_HS: R5.2, U2.2 (IO2), U2.9 (NC2); also elsewhere on the board
FD_TF: R3.2, R67.1, U3.2 (IO2), U3.9 (NC2)
GND: C1.1, C2.1, C3.1, C54.2, C57.1, C58.1, J1.2, J1.17, J1.19, J2.5, J2.11, J10.2, R51.1, TP4.1, U2.8 (GND), U3.8 (GND), U4.8 (GND), U7.8 (GND), U7.15 (EN#), U10.8 (GND), U11.8 (GND); also elsewhere on the board
JA1: R7.2, U10.5 (IO4), U10.6 (NC4); also elsewhere on the board
JA2: R9.2, U10.2 (IO2), U10.9 (NC2); also elsewhere on the board
JA3: R8.2, U11.5 (IO4), U11.6 (NC4); also elsewhere on the board
JA4: R10.2, U11.2 (IO2), U11.9 (NC2); also elsewhere on the board
JA7: R19.1, U10.4 (IO3), U10.7 (NC3); also elsewhere on the board
JA8: R11.1, U10.1 (IO1), U10.10 (NC1); also elsewhere on the board
JA9: R20.1, U11.4 (IO3), U11.7 (NC3); also elsewhere on the board
JA10: R12.1, U11.1 (IO1), U11.10 (NC1); also elsewhere on the board
unnamed: J2.1, R7.1
unnamed: J2.2, R9.1
unnamed: J2.3, R8.1
unnamed: J2.4, R10.1
unnamed: J2.7, R19.2
unnamed: J2.8, R11.2
unnamed: J2.9, R20.2
unnamed: J2.10, R12.2
SW_CLK: U7.10 (NO3); also elsewhere on the board
SW_DIN: U7.13 (NO4); also elsewhere on the board
SW_DONE: R67.2; also elsewhere on the board
SW_INIT_B: U7.3 (NO1); also elsewhere on the board
SW_PROGRAM_B: U7.6 (NO2); also elsewhere on the board

Notes on the sheet:
Programming/DUT Communication Switches
FPGA Pin
ESD Protection
PMOD Connector
FOBOS Target Connector

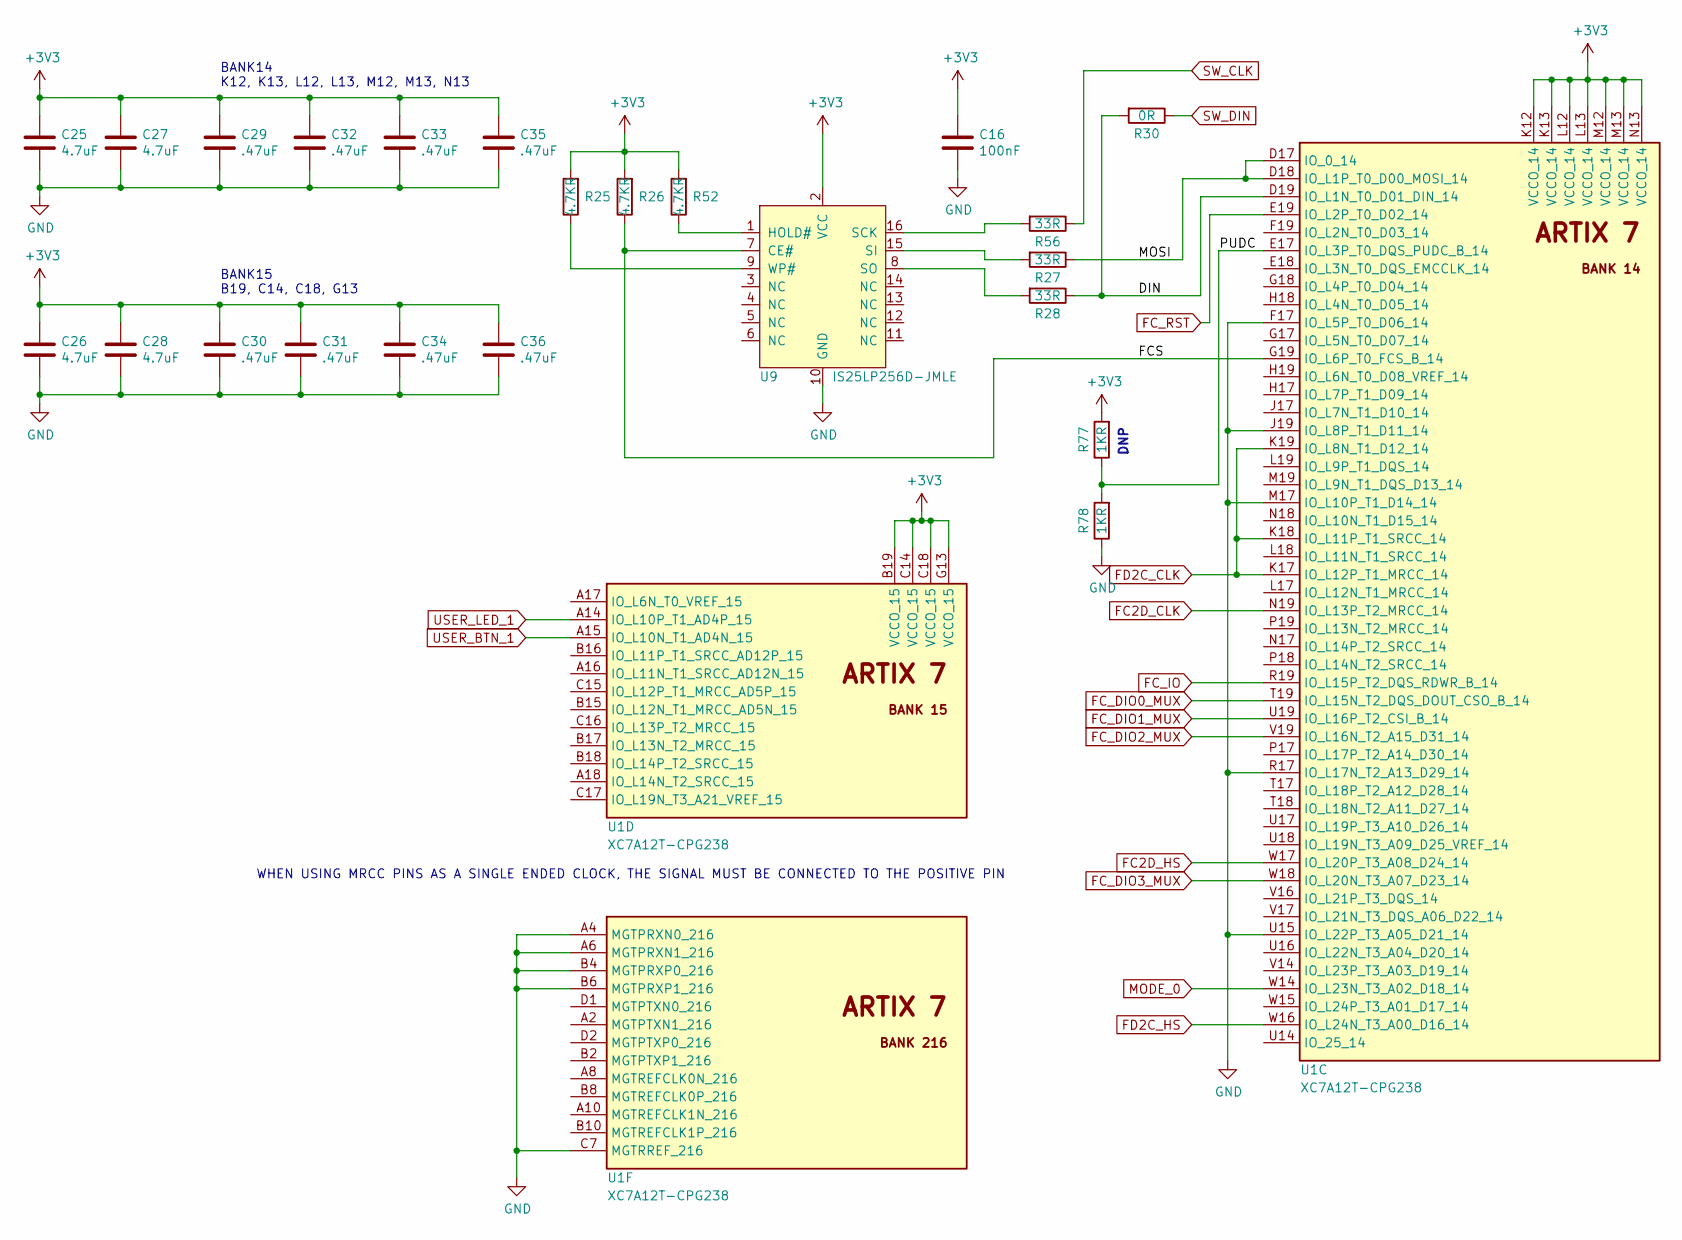
[picture p267: schematic fpga 1.kicad_sch, FOBOS Artix-7 a12t DUT - FPGA]

Parts:
C16: 100nF; C_0603_1608Metric; MPN 06036C104KAT4A
C25, C26, C27, C28: 4.7uF; C_0402_1005Metric_Pad0.74x0.62mm_HandSolder; MPN GRM155R60J475ME87J
C29, C30, C31, C32, C33, C34, C35, C36: .47uF; C_0402_1005Metric_Pad0.74x0.62mm_HandSolder; MPN C0402C474K9PACTU
R25, R26, R52: 4.7KR; R_0603_1608Metric; MPN ERJ-3GEYJ472V
R27, R28, R56: 33R; R_0603_1608Metric; MPN ERA-3AHD330V
R30: 0R; R_0603_1608Metric; MPN RMCF0603ZT0R00
R77, R78: 1KR; R_0603_1608Metric
U1: XC7A12T-CPG238; Xilinx_CPG238
U9: IS25LP256D-JMLE; SOIC-16W_7.5x10.3mm_P1.27mm; MPN IS25LP256D-JMLE

Connections:
/FPGA 1/DIN: R28.1, R30.2, U1.D19 (IO_L1N_T0_D01_DIN_14)
/FPGA 1/FCS: R26.1, U1.G19 (IO_L6P_T0_FCS_B_14), U9.7 (CE#)
/FPGA 1/MOSI: R27.1, U1.D17 (IO_0_14), U1.D18 (IO_L1P_T0_D00_MOSI_14)
/FPGA 1/PUDC: R77.1, R78.2, U1.E17 (IO_L3P_T0_DQS_PUDC_B_14)
FC2D_CLK: U1.N19 (IO_L13P_T2_MRCC_14); also elsewhere on the board
FC2D_HS: U1.W17 (IO_L20P_T3_A08_D24_14); also elsewhere on the board
FC_DIO0_MUX: U1.T19 (IO_L15N_T2_DQS_DOUT_CSO_B_14); also elsewhere on the board
FC_DIO1_MUX: U1.U19 (IO_L16P_T2_CSI_B_14); also elsewhere on the board
FC_DIO2_MUX: U1.V19 (IO_L16N_T2_A15_D31_14); also elsewhere on the board
FC_DIO3_MUX: U1.W18 (IO_L20N_T3_A07_D23_14); also elsewhere on the board
FC_IO: U1.R19 (IO_L15P_T2_DQS_RDWR_B_14); also elsewhere on the board
FC_RST: U1.E19 (IO_L2P_T0_D02_14); also elsewhere on the board
FD2C_CLK: U1.K17 (IO_L12P_T1_MRCC_14), U1.K18 (IO_L11P_T1_SRCC_14), U1.K19 (IO_L8N_T1_D12_14); also elsewhere on the board
FD2C_HS: U1.W16 (IO_L24N_T3_A00_D16_14); also elsewhere on the board
GND: C16.2, C25.2, C26.2, C27.2, C28.2, C29.2, C30.2, C31.2, C32.2, C33.2, C34.2, C35.2, C36.2, R78.1, U1.A4 (MGTPRXN0_216), U1.A6 (MGTPRXN1_216), U1.B4 (MGTPRXP0_216), U1.B6 (MGTPRXP1_216), U1.C7 (MGTRREF_216), U1.F17 (IO_L5P_T0_D06_14), U1.J19 (IO_L8P_T1_D11_14), U1.M17 (IO_L10P_T1_D14_14), U1.R17 (IO_L17N_T2_A13_D29_14), U1.U15 (IO_L22P_T3_A05_D21_14), U9.10 (GND); also elsewhere on the board
MODE_0: U1.W14 (IO_L23N_T3_A02_D18_14); also elsewhere on the board
unnamed: R25.1, U9.9 (WP#)
unnamed: R27.2, U9.15 (SI)
unnamed: R28.2, U9.8 (SO)
unnamed: R52.1, U9.1 (HOLD#)
unnamed: R56.2, U9.16 (SCK)
SW_CLK: R56.1; also elsewhere on the board
SW_DIN: R30.1; also elsewhere on the board
USER_BTN_1: U1.A15 (IO_L10N_T1_AD4N_15); also elsewhere on the board
USER_LED_1: U1.A14 (IO_L10P_T1_AD4P_15); also elsewhere on the board

Notes on the sheet:
WHEN USING MRCC PINS AS A SINGLE ENDED CLOCK, THE SIGNAL MUST BE CONNECTED TO THE POSITIVE PIN
DNP
BANK15 B19, C14, C18, G13
BANK14 K12, K13, L12, L13, M12, M13, N13

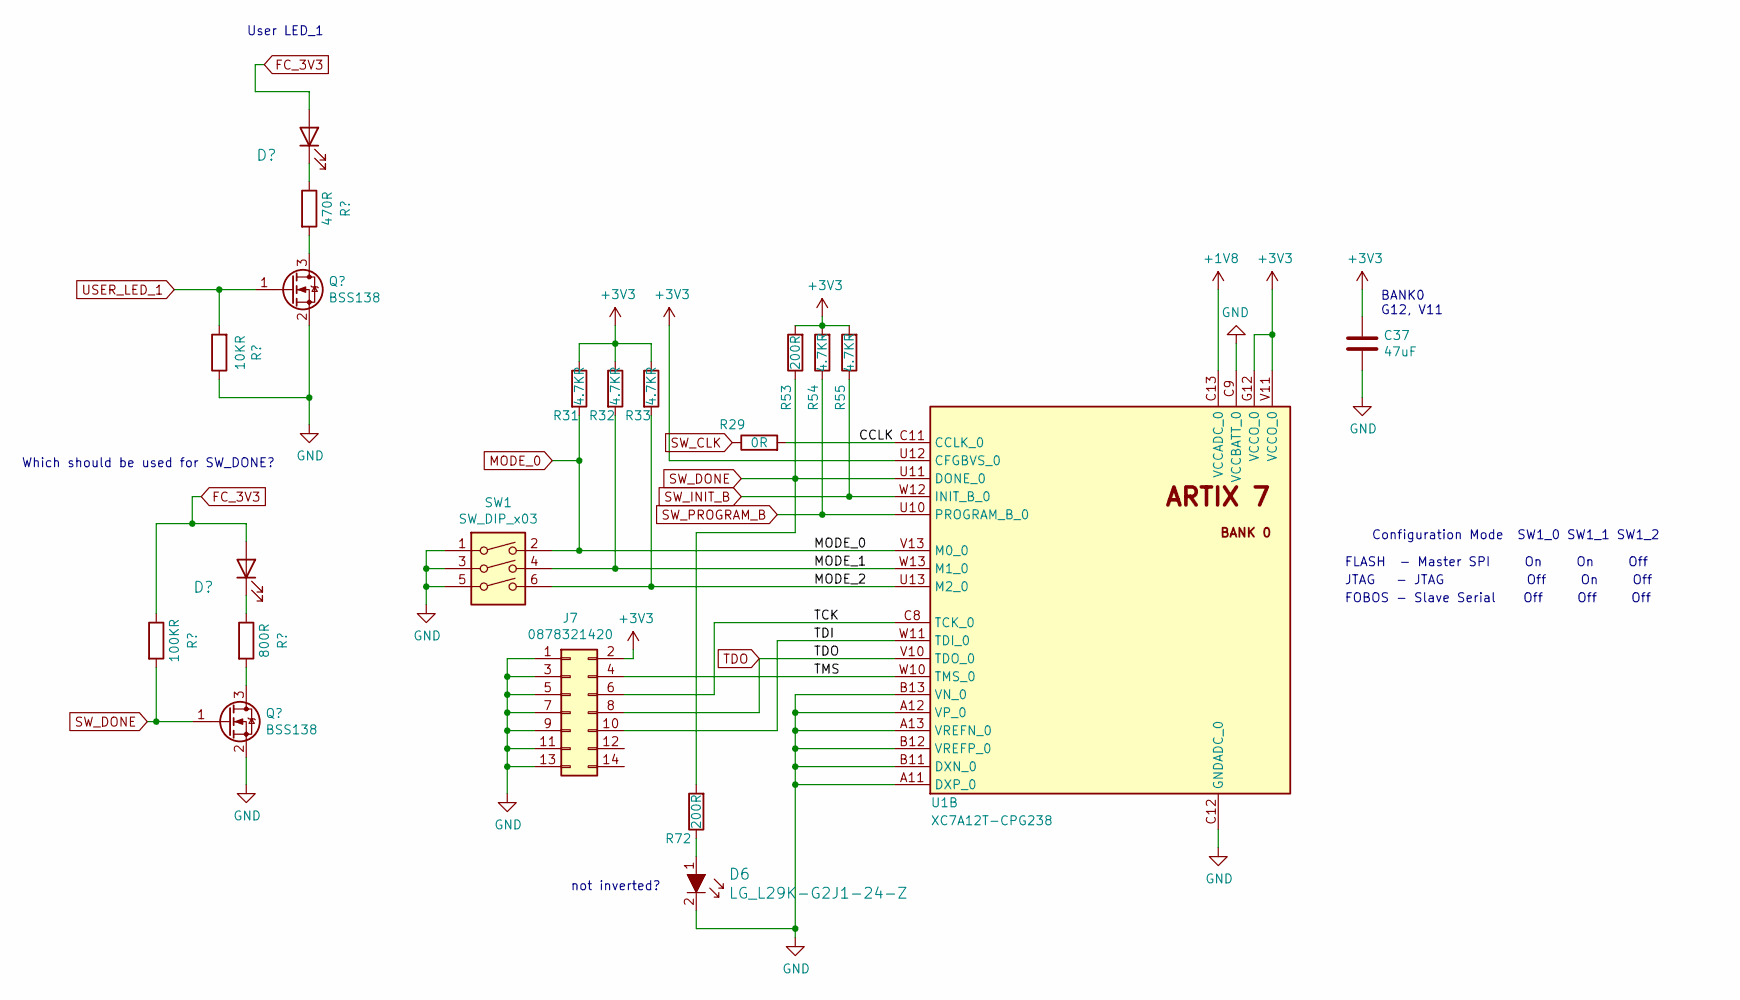
[picture p268: schematic fpgaprog.kicad_sch, FOBOS ARTIX7-A12T-CPG238 DUT - FPGA Programming]

Parts:
C37: 47uF; C_0603_1608Metric_Pad1.08x0.95mm_HandSolder; MPN 06036D476MAT2A
D6: LG_L29K-G2J1-24-Z; LED_0603_1608Metric; MPN LG L29K-G2J1-24-Z; Digi-Key_PN 475-2709-1-ND
J7: 0878321420; PinHeader_2x7_P2mm_SMD; MPN 0878321420; Digi-Key_PN WM18641-ND
R29: 0R; R_0603_1608Metric; MPN RMCF0603ZT0R00
R31, R32, R33, R54, R55: 4.7KR; R_0603_1608Metric; MPN ERJ-3GEYJ472V
R53, R72: 200R; R_0603_1608Metric; MPN ERA-3AED201V
SW1: SW_DIP_x03; DS04-254-2-03BK-SMT; MPN DS04-254-2-03BK-SMT
U1: XC7A12T-CPG238; Xilinx_CPG238

Connections:
/FPGA Programming/CCLK: R29.2, U1.C11 (CCLK_0)
/FPGA Programming/MODE_1: R32.2, SW1.4, U1.W13 (M1_0)
/FPGA Programming/MODE_2: R33.2, SW1.6, U1.U13 (M2_0)
/FPGA Programming/TCK: J7.6, U1.C8 (TCK_0)
/FPGA Programming/TDI: J7.10, U1.W11 (TDI_0)
/FPGA Programming/TMS: J7.4, U1.W10 (TMS_0)
GND: C37.2, D6.2, J7.1, J7.3, J7.5, J7.7, J7.9, J7.11, J7.13, SW1.1, SW1.3, SW1.5, U1.A11 (DXP_0), U1.A12 (VP_0), U1.A13 (VREFN_0), U1.B11 (DXN_0), U1.B12 (VREFP_0), U1.B13 (VN_0), U1.C9 (VCCBATT_0), U1.C12 (GNDADC_0); also elsewhere on the board
MODE_0: R31.2, SW1.2, U1.V13 (M0_0); also elsewhere on the board
unnamed: D6.1, R72.1
SW_CLK: R29.1; also elsewhere on the board
SW_DONE: R53.1, R72.2, U1.U11 (DONE_0); also elsewhere on the board
SW_INIT_B: R55.1, U1.W12 (INIT_B_0); also elsewhere on the board
SW_PROGRAM_B: R54.1, U1.U10 (PROGRAM_B_0); also elsewhere on the board
TDO: J7.8, U1.V10 (TDO_0); also elsewhere on the board

Notes on the sheet:
BANK0 G12, V11
not inverted?
JTAG - JTAG Off On Off
FLASH - Master SPI On On Off
FOBOS - Slave Serial Off Off Off
Which should be used for SW_DONE?
Configuration Mode SW1_0 SW1_1 SW1_2
User LED_1

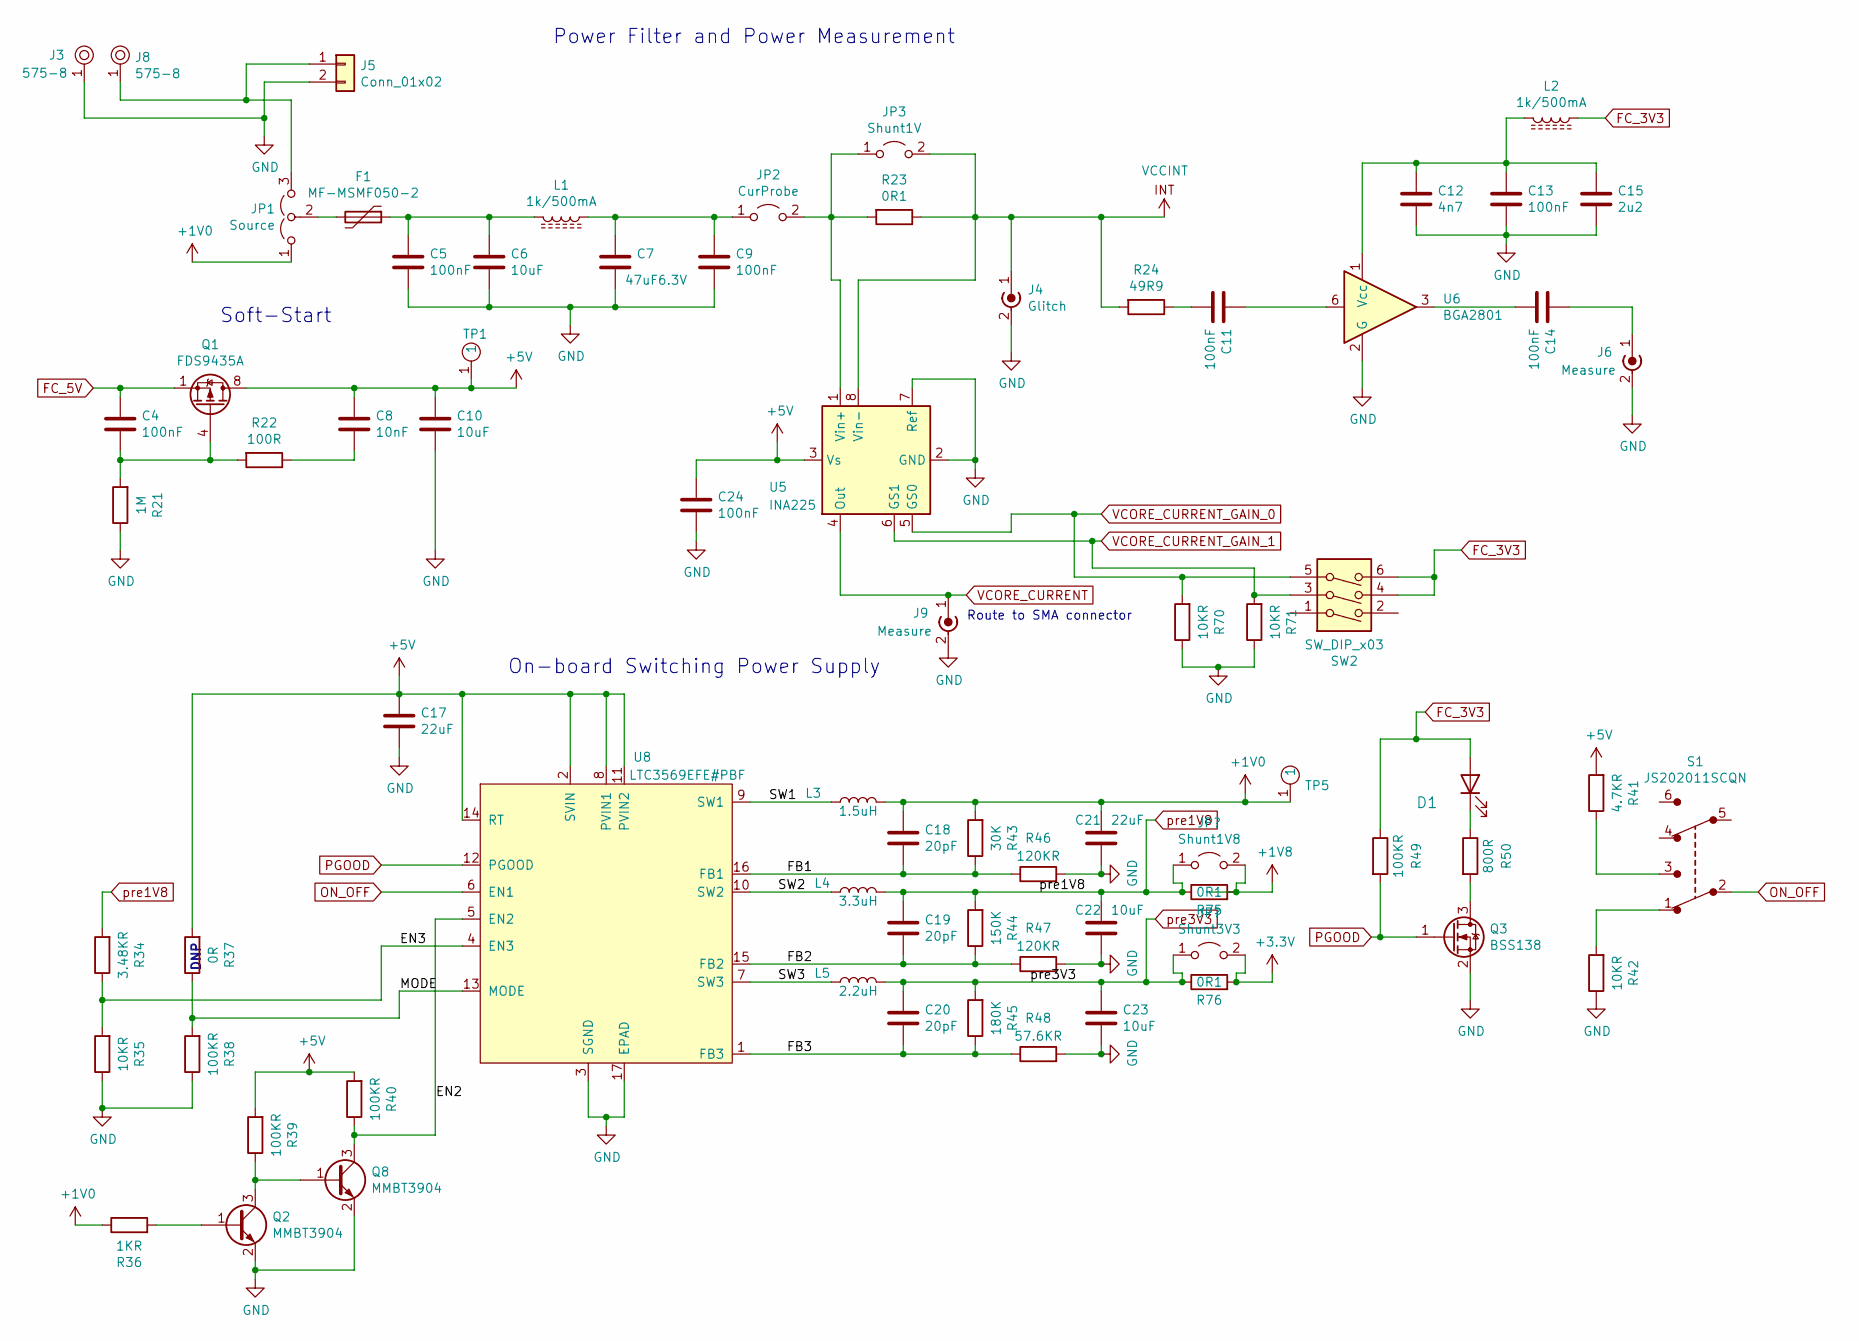
[picture p269: schematic power.kicad_sch, FOBOS Artix-7 a12t DUT - Power Circuitry]

Parts:
C4, C5, C9, C11, C13, C14, C24: 100nF; C_0603_1608Metric; MPN 06036C104KAT4A
C6, C10, C22, C23: 10uF; C_0805_2012Metric; MPN GRM21BR70J106KA73L
C7: 47uF6.3V; C_0805_2012Metric; Part GRM21BR60J476ME15K
C8: 10nF; C_0603_1608Metric; MPN 885012206014
C12: 4n7; C_0603_1608Metric; MPN 885012206012
C15: 2u2; C_0805_2012Metric; MPN 885012207001
C17, C21: 22uF; C_0805_2012Metric; MPN CL21A226KQCLRNC
C18, C19, C20: 20pF; C_0603_1608Metric; MPN C0603C200G8HAC7867
D1: LG_L29K-G2J1-24-Z; LED_0603_1608Metric; MPN LG L29K-G2J1-24-Z; Digi-Key_PN 475-2709-1-ND
F1: MF-MSMF050-2; Fuse_1206_3216Metric; MPN ERB-RG2R00V
J3, J8: 575-8; MPN 575-8
J4: Glitch; SMA-JOHNSON-142-0701-201; MPN 142-0701-801
J5: Conn_01x02; Molex_KK-254_AE-6410-02A_1x02_P2.54mm_Vertical; MPN 0022272021
J6, J9: Measure; SMA-JOHNSON-142-0701-801; MPN 142-0701-801
JP1: Source; PinHeader_1x03_P2.54mm_Vertical; MPN 77311-822-03LF
JP2: CurProbe; PinHeader_1x02_P2.54mm_Vertical; MPN 10129378-902001BLF
JP3: Shunt1V; PinHeader_1x02_P2.54mm_Vertical; MPN 10129378-902001BLF
L1, L2: 1k/500mA; L_0603_1608Metric
L3: 1.5uH; L_SRN2012; MPN SRN2012-1R5M
L4: 3.3uH; L_BRC2012; MPN BRC2012T3R3MD
L5: 2.2uH; L_SRN2012; MPN SRN2010-2R2M
Q1: FDS9435A; SOIC-8_3.9x4.9mm_P1.27mm; MPN FDS9435A
Q2, Q8: MMBT3904; SOT-23
Q3: BSS138; SOT-23; MPN BSS138
R21: 1M; R_0603_1608Metric; MPN ERJ-3GEYJ105V
R22: 100R; R_0603_1608Metric; MPN ERJ-U03J101V
R23: 0R1; R_1206_3216Metric; MPN KRL1632E-M-R100-F-T5
R24: 49R9; R_0603_1608Metric; MPN ERJ-3EKF49R9V
R34: 3.48KR; R_0603_1608Metric; MPN ERJ-3EKF3481V
R35, R42, R70, R71: 10KR; R_0603_1608Metric; MPN ERJ-3EKF1002V
R36: 1KR; R_0603_1608Metric; MPN ERA-3AED102V
R37: 0R; R_0603_1608Metric; MPN RMCF0603ZT0R00
R38, R39, R40, R49: 100KR; R_0603_1608Metric; MPN ERA-3AED104V
R41: 4.7KR; R_0603_1608Metric; MPN ERJ-3GEYJ472V
R43: 30K; R_0603_1608Metric; MPN ERJ-3EKF1002V
R44: 150K; R_0603_1608Metric; MPN ERJ-3EKF1002V
R45: 180K; R_0603_1608Metric; MPN ERJ-3EKF1002V
R46, R47: 120KR; R_0603_1608Metric; MPN ERJ-3EKF1203V
R48: 57.6KR; R_0603_1608Metric; MPN ERJ-3EKF5762V
R50: 800R; R_0603_1608Metric; MPN RC0603FR-07806RL
R75, R76: 0R1; R_1206_3216Metric
S1: JS202011SCQN; Switch_Slide_JS202011SCQN; MPN JS202011SCQN; Digi-Key_PN 401-2002-1-ND
SW2: SW_DIP_x03; DS04-254-2-03BK-SMT; MPN DS04-254-2-03BK-SMT
TP1, TP5: 5281; MPN 5281
U5: INA225; MSOP-8_3x3mm_P0.65mm; MPN INA225AIDGKT
U6: BGA2801; SOT-363_SC-70-6; MPN BGA2801,115
U8: LTC3569EFE#PBF; TSSOP-16-1EP_W4.40mm; MPN LTC3569EFE#PBF

Connections:
+1V0: C18.1, C21.1, JP1.1 (A), L3.2, R36.1, R43.2, TP5.1
+5V: C8.1, C10.1, C17.1, Q1.5 (D), Q1.6 (D), Q1.7 (D), Q1.8 (D), R37.2, R39.2, R40.2, R41.2, TP1.1, U8.2 (SVIN), U8.8 (PVIN1), U8.11 (PVIN2), U8.14 (RT)
/Power/EN2: Q8.3 (C), R40.1, U8.5 (EN2)
/Power/EN3: R34.1, R35.2, U8.4 (EN3)
/Power/FB1: C18.2, R43.1, R46.1, U8.16 (FB1)
/Power/FB2: C19.2, R44.1, R47.1, U8.15 (FB2)
/Power/FB3: C20.2, R45.1, R48.1, U8.1 (FB3)
/Power/MODE: R37.1, R38.2, U8.13 (MODE)
/Power/SW1: L3.1, U8.9 (SW1)
/Power/SW2: L4.1, U8.10 (SW2)
/Power/SW3: L5.1, U8.7 (SW3)
/Power/pre3V3: C20.1, C23.1, L5.2, R45.2, R76.1; also elsewhere on the board
FC_5V: C4.1, Q1.1 (S), Q1.2 (S), Q1.3 (S); also elsewhere on the board
GND: C5.2, C6.2, C7.2, C9.2, C10.2, C12.2, C13.2, C15.2, C17.2, C21.2, C22.2, C23.2, C24.2, J3.1, J4.2 (Ext), J5.2, J6.2 (Ext), J9.2 (Ext), Q2.2 (E), Q3.2 (S), Q8.2 (E), R21.1, R35.1, R38.1, R42.1, R46.2, R47.2, R48.2, R70.1, R71.1, U5.2 (GND), U5.7 (Ref), U6.2 (G), U6.4 (G), U6.5 (G), U8.3 (SGND), U8.17 (EPAD); also elsewhere on the board
unnamed: C4.2, Q1.4 (G), R21.2, R22.2
unnamed: C5.1, C6.1, F1.1, L1.2
unnamed: C7.1, C9.1, JP2.1 (A), L1.1
unnamed: C8.2, R22.1
unnamed: C11.1, U6.6
unnamed: C11.2, R24.1
unnamed: C12.1, C13.1, C15.1, L2.2, U6.1 (Vcc)
unnamed: C14.1, J6.1 (In)
unnamed: C14.2, U6.3
unnamed: D1.1 (K), R50.1
unnamed: F1.2, JP1.2 (C)
unnamed: J5.1, J8.1, JP1.3 (B)
unnamed: JP2.2 (B), JP3.1 (A), R23.2, U5.1 (Vin+)
unnamed: Q2.1 (B), R36.2
unnamed: Q2.3 (C), Q8.1 (B), R39.1
unnamed: Q3.3 (D), R50.2
unnamed: R41.1, S1.3
unnamed: R42.2, S1.1
ON_OFF: S1.2, U8.6 (EN1)
PGOOD: Q3.1 (G), R49.2, U8.12 (PGOOD)
VCCINT: J4.1 (In), JP3.2 (B), R23.1, R24.2, U5.8 (Vin-); also elsewhere on the board
VCORE_CURRENT: J9.1 (In), U5.4 (Out)
VCORE_CURRENT_GAIN_0: R70.2, SW2.5, U5.5 (GS0); also elsewhere on the board
VCORE_CURRENT_GAIN_1: R71.2, SW2.3, U5.6 (GS1); also elsewhere on the board

Notes on the sheet:
DNP
On-board Switching Power Supply
Route to SMA connector
Soft-Start
Power Filter and Power Measurement

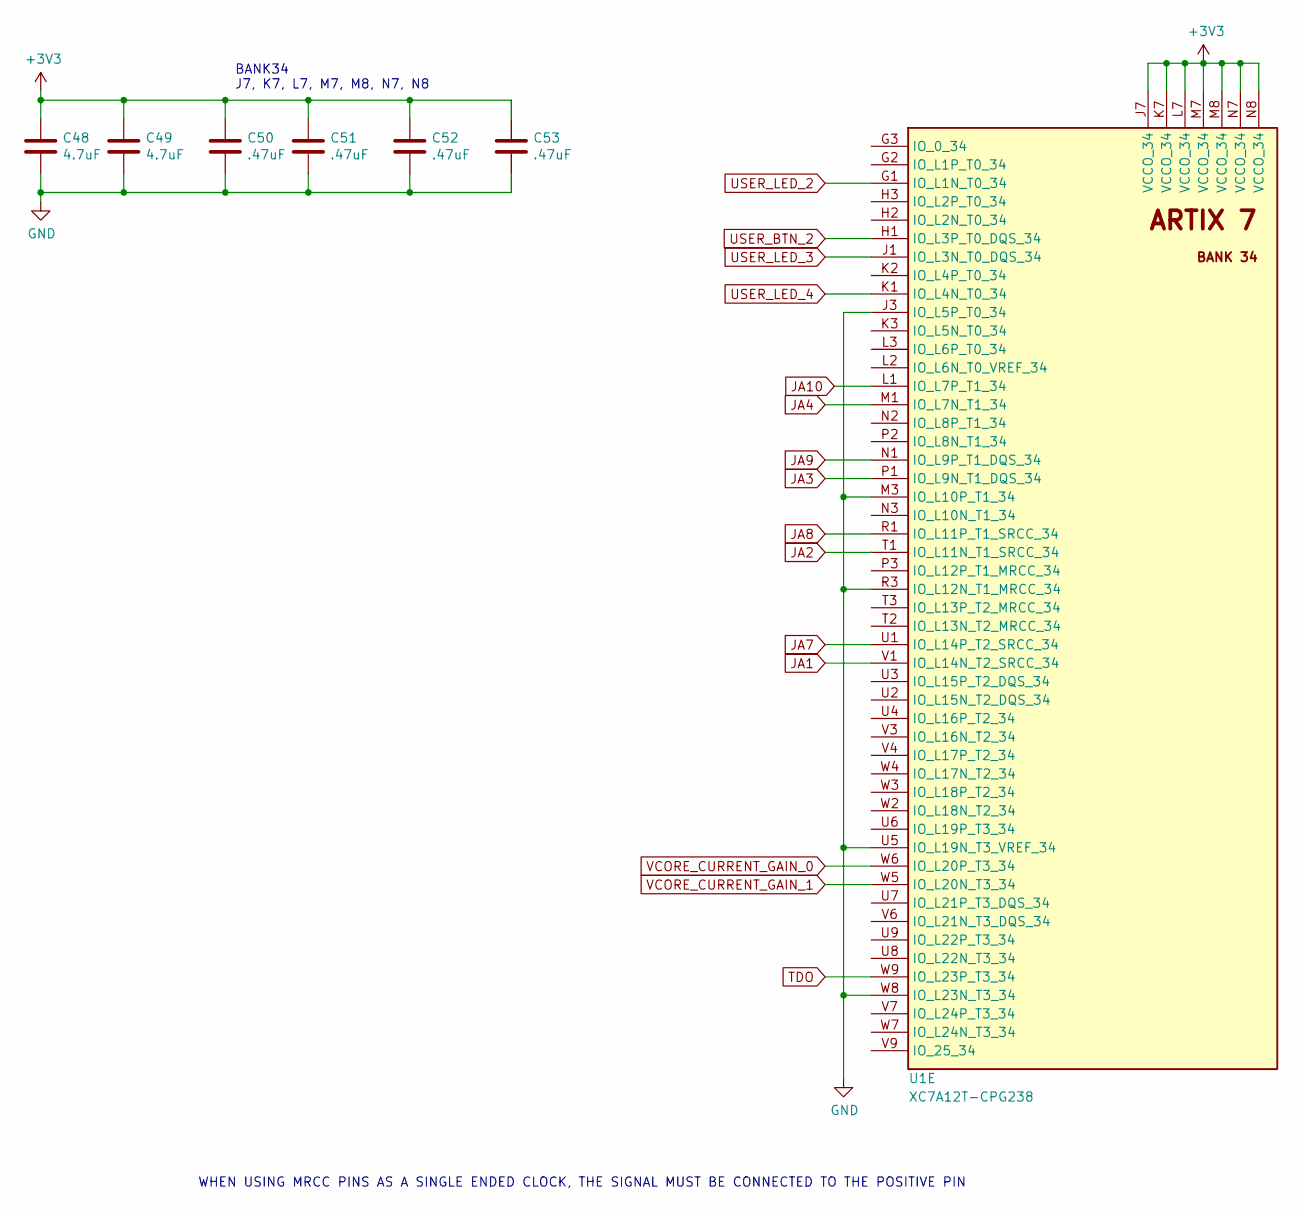
[picture p270: schematic FPGA 2.kicad_sch, FOBOS Artix-7 a12t DUT - FPGA Part 2]

Parts:
C48, C49: 4.7uF; C_0402_1005Metric_Pad0.74x0.62mm_HandSolder; MPN GRM155R60J475ME87J
C50, C51, C52, C53: .47uF; C_0402_1005Metric_Pad0.74x0.62mm_HandSolder; MPN C0402C474K9PACTU
U1: XC7A12T-CPG238; Xilinx_CPG238

Connections:
GND: C48.2, C49.2, C50.2, C51.2, C52.2, C53.2, U1.J3 (IO_L5P_T0_34), U1.M3 (IO_L10P_T1_34), U1.R3 (IO_L12N_T1_MRCC_34), U1.U5 (IO_L19N_T3_VREF_34), U1.W8 (IO_L23N_T3_34); also elsewhere on the board
JA1: U1.V1 (IO_L14N_T2_SRCC_34); also elsewhere on the board
JA2: U1.T1 (IO_L11N_T1_SRCC_34); also elsewhere on the board
JA3: U1.P1 (IO_L9N_T1_DQS_34); also elsewhere on the board
JA4: U1.M1 (IO_L7N_T1_34); also elsewhere on the board
JA7: U1.U1 (IO_L14P_T2_SRCC_34); also elsewhere on the board
JA8: U1.R1 (IO_L11P_T1_SRCC_34); also elsewhere on the board
JA9: U1.N1 (IO_L9P_T1_DQS_34); also elsewhere on the board
JA10: U1.L1 (IO_L7P_T1_34); also elsewhere on the board
TDO: U1.W9 (IO_L23P_T3_34); also elsewhere on the board
USER_BTN_2: U1.H1 (IO_L3P_T0_DQS_34); also elsewhere on the board
USER_LED_2: U1.G1 (IO_L1N_T0_34); also elsewhere on the board
USER_LED_3: U1.J1 (IO_L3N_T0_DQS_34); also elsewhere on the board
USER_LED_4: U1.K1 (IO_L4N_T0_34); also elsewhere on the board
VCORE_CURRENT_GAIN_0: U1.W6 (IO_L20P_T3_34); also elsewhere on the board
VCORE_CURRENT_GAIN_1: U1.W5 (IO_L20N_T3_34); also elsewhere on the board

Notes on the sheet:
BANK34 J7, K7, L7, M7, M8, N7, N8
WHEN USING MRCC PINS AS A SINGLE ENDED CLOCK, THE SIGNAL MUST BE CONNECTED TO THE POSITIVE PIN

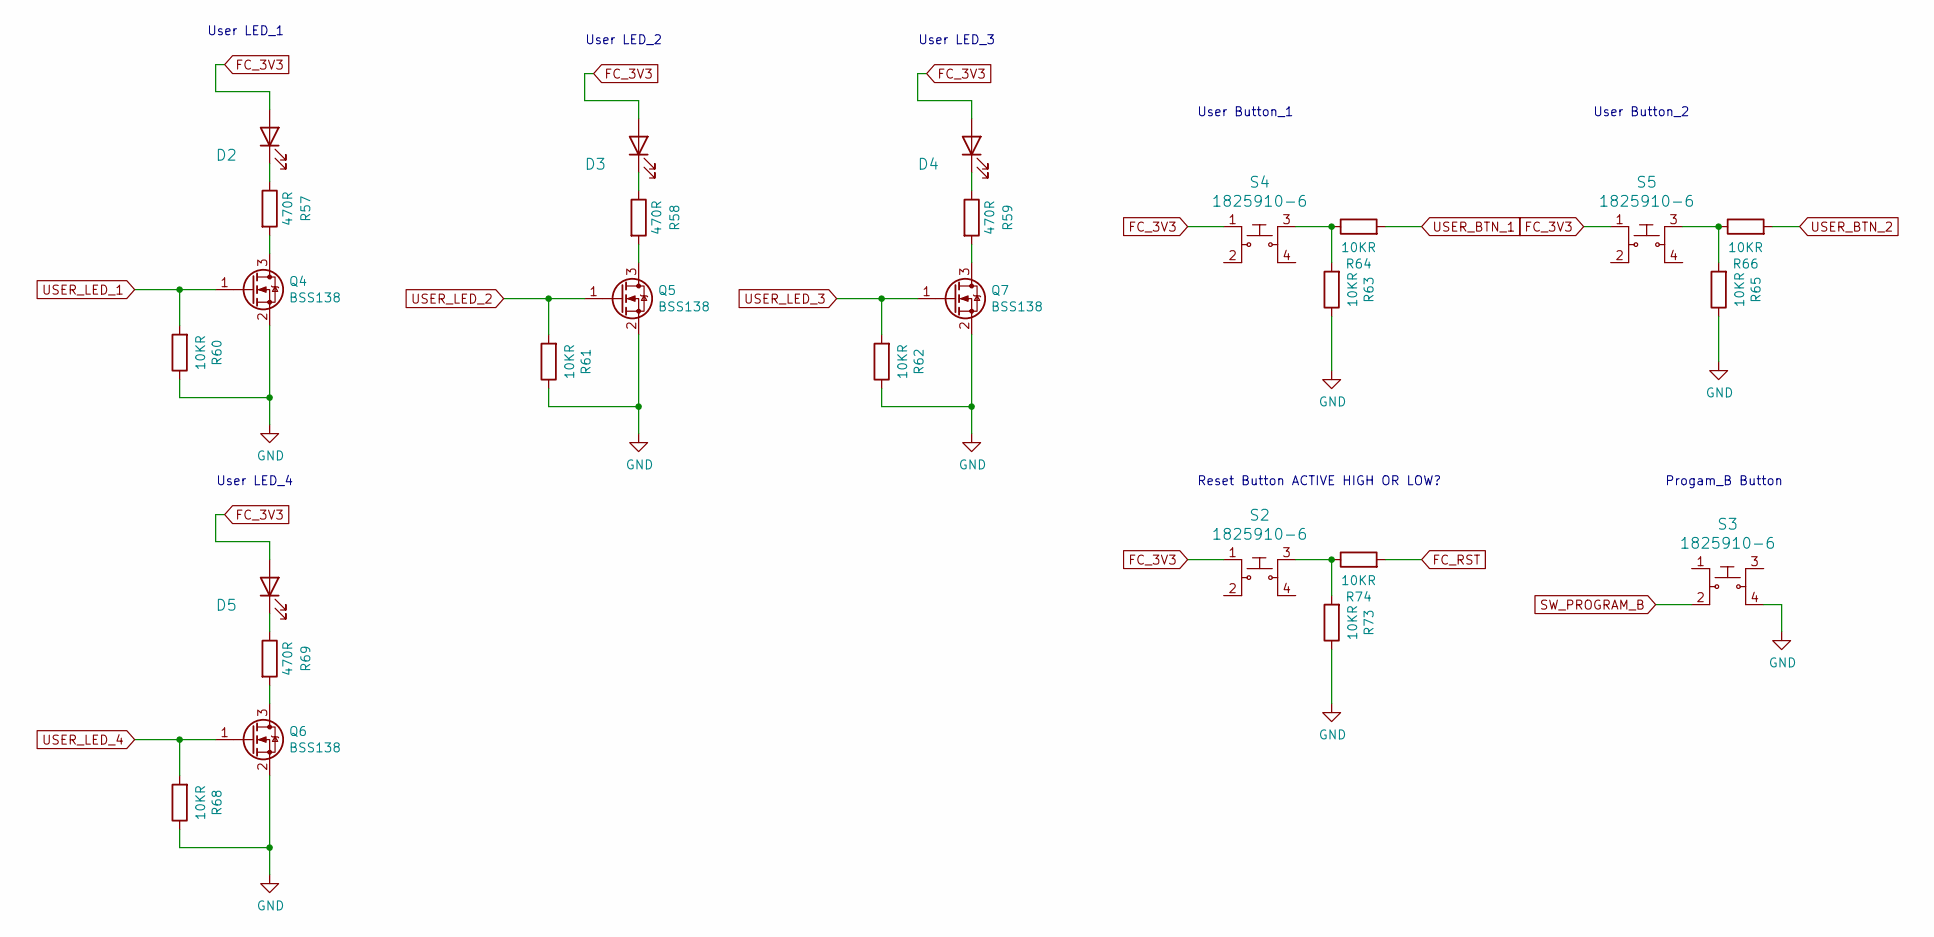
[picture p271: schematic User Button and IO.kicad_sch, FOBOS Artix-7 a12t DUT - User Buttons and I/O]

Parts:
D2, D3, D4, D5: LG_L29K-G2J1-24-Z; LED_0603_1608Metric; MPN LG L29K-G2J1-24-Z; Digi-Key_PN 475-2709-1-ND
Q4, Q5, Q6, Q7: BSS138; SOT-23; MPN BSS138
R57, R58, R59, R69: 470R; R_0603_1608Metric; MPN ERJ-U03J471V
R60, R61, R62, R63, R64, R65, R66, R68, R73, R74: 10KR; R_0603_1608Metric; MPN ERJ-3EKF1002V
S2, S3, S4, S5: 1825910-6; Switch_Tactile_THT_6x6mm; MPN 1825910-6; Digi-Key_PN 450-1650-ND

Connections:
FC_RST: R74.2; also elsewhere on the board
GND: Q4.2 (S), Q5.2 (S), Q6.2 (S), Q7.2 (S), R60.1, R61.1, R62.1, R63.1, R65.1, R68.1, R73.1, S3.4; also elsewhere on the board
unnamed: D2.1 (K), R57.1
unnamed: D3.1 (K), R58.1
unnamed: D4.1 (K), R59.1
unnamed: D5.1 (K), R69.1
unnamed: Q4.3 (D), R57.2
unnamed: Q5.3 (D), R58.2
unnamed: Q6.3 (D), R69.2
unnamed: Q7.3 (D), R59.2
unnamed: R63.2, R64.1, S4.3
unnamed: R65.2, R66.1, S5.3
unnamed: R73.2, R74.1, S2.3
SW_PROGRAM_B: S3.2; also elsewhere on the board
USER_BTN_1: R64.2; also elsewhere on the board
USER_BTN_2: R66.2; also elsewhere on the board
USER_LED_1: Q4.1 (G), R60.2; also elsewhere on the board
USER_LED_2: Q5.1 (G), R61.2; also elsewhere on the board
USER_LED_3: Q7.1 (G), R62.2; also elsewhere on the board
USER_LED_4: Q6.1 (G), R68.2; also elsewhere on the board

Notes on the sheet:
User LED_2
User LED_3
User LED_1
Reset Button ACTIVE HIGH OR LOW?
User Button_1
User LED_4
Progam_B Button
User Button_2
