kammoh/fobos/hardware/fobos-dut/dut-artix7-a12t-cpg238/dut-artix7-a12t.kicad_pcb

## KiCad design hardware/fobos-dut/dut-artix7-a12t-cpg238/dut-artix7-a12t.kicad_pcb (continued)

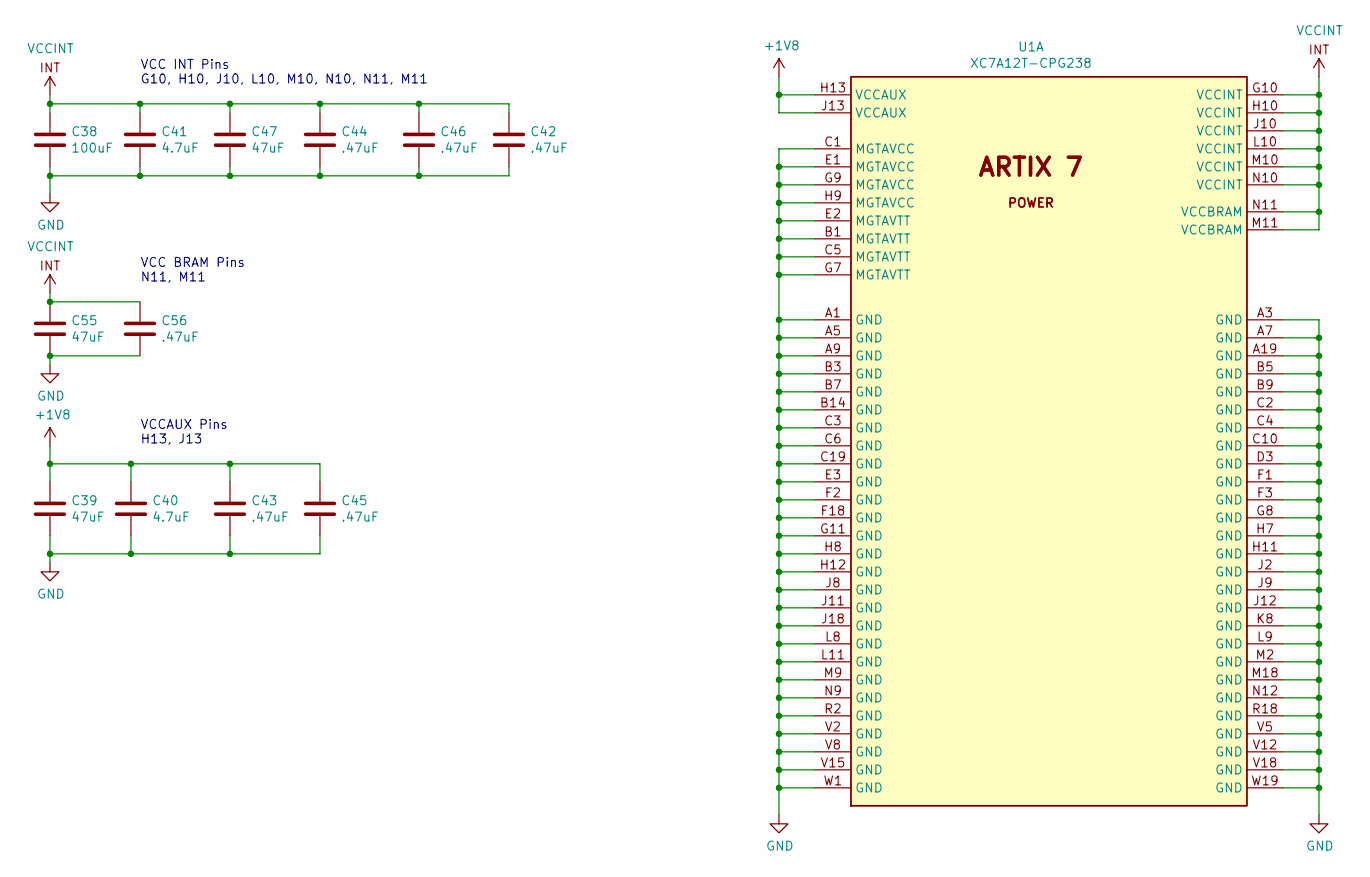
[picture p272: schematic fpgapower.kicad_sch, FOBOS Artix-7 a12t DUT - FPGA Power]

Parts:
C38: 100uF; C_1210_3225Metric_Pad1.33x2.70mm_HandSolder; MPN JMK325ABJ107MM-P
C39, C47, C55: 47uF; C_0603_1608Metric_Pad1.08x0.95mm_HandSolder; MPN 06036D476MAT2A
C40, C41: 4.7uF; C_0402_1005Metric_Pad0.74x0.62mm_HandSolder; MPN GRM155R60J475ME87J
C42, C43, C44, C45, C46, C56: .47uF; C_0402_1005Metric_Pad0.74x0.62mm_HandSolder; MPN C0402C474K9PACTU
U1: XC7A12T-CPG238; Xilinx_CPG238

Connections:
GND: C38.2, C39.2, C40.2, C41.2, C42.2, C43.2, C44.2, C45.2, C46.2, C47.2, C55.2, C56.2, U1.A1 (GND), U1.A3 (GND), U1.A5 (GND), U1.A7 (GND), U1.A9 (GND), U1.A19 (GND), U1.B1 (MGTAVTT), U1.B3 (GND), U1.B5 (GND), U1.B7 (GND), U1.B9 (GND), U1.B14 (GND), U1.C1 (MGTAVCC), U1.C2 (GND), U1.C3 (GND), U1.C4 (GND), U1.C5 (MGTAVTT), U1.C6 (GND), U1.C10 (GND), U1.C19 (GND), U1.D3 (GND), U1.E1 (MGTAVCC), U1.E2 (MGTAVTT), U1.E3 (GND), U1.F1 (GND), U1.F2 (GND), U1.F3 (GND), U1.F18 (GND), U1.G7 (MGTAVTT), U1.G8 (GND), U1.G9 (MGTAVCC), U1.G11 (GND), U1.H7 (GND), U1.H8 (GND), U1.H9 (MGTAVCC), U1.H11 (GND), U1.H12 (GND), U1.J2 (GND), U1.J8 (GND), U1.J9 (GND), U1.J11 (GND), U1.J12 (GND), U1.J18 (GND), U1.K8 (GND), U1.L8 (GND), U1.L9 (GND), U1.L11 (GND), U1.M2 (GND), U1.M9 (GND), U1.M18 (GND), U1.N9 (GND), U1.N12 (GND), U1.R2 (GND), U1.R18 (GND), U1.V2 (GND), U1.V5 (GND), U1.V8 (GND), U1.V12 (GND), U1.V15 (GND), U1.V18 (GND), U1.W1 (GND), U1.W19 (GND); also elsewhere on the board
VCCINT: C38.1, C41.1, C42.1, C44.1, C46.1, C47.1, C55.1, C56.1, U1.G10 (VCCINT), U1.H10 (VCCINT), U1.J10 (VCCINT), U1.L10 (VCCINT), U1.M10 (VCCINT), U1.M11 (VCCBRAM), U1.N10 (VCCINT), U1.N11 (VCCBRAM); also elsewhere on the board

Notes on the sheet:
VCCAUX Pins H13, J13
VCC BRAM Pins N11, M11
VCC INT Pins G10, H10, J10, L10, M10, N10, N11, M11

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
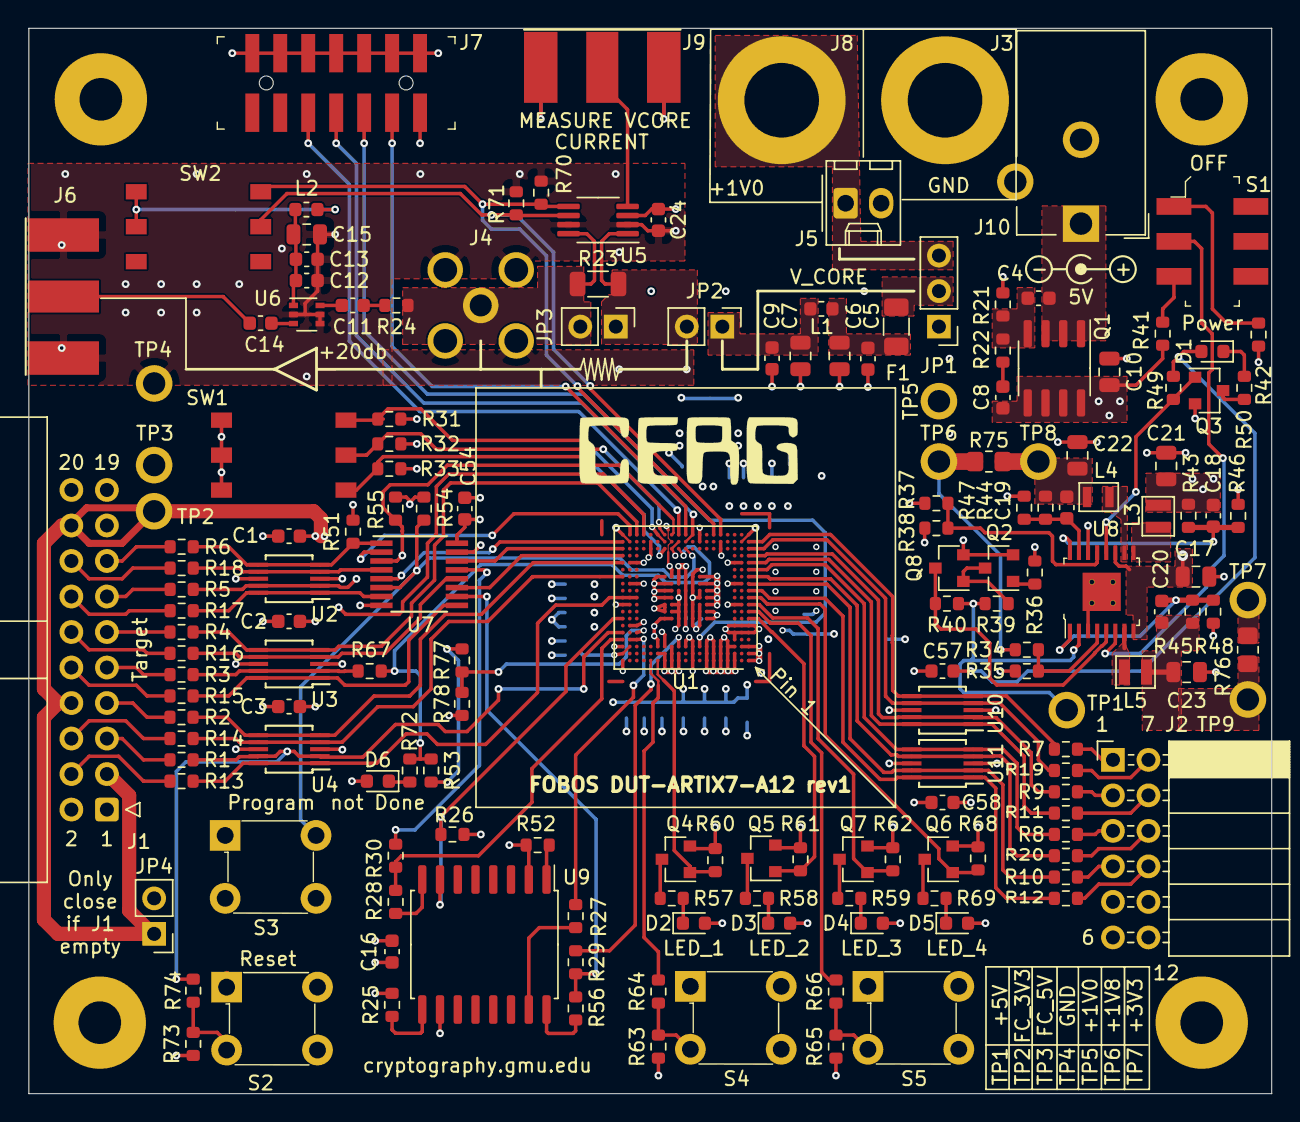
[picture p273: board dut-artix7-a12t.kicad_pcb from above]

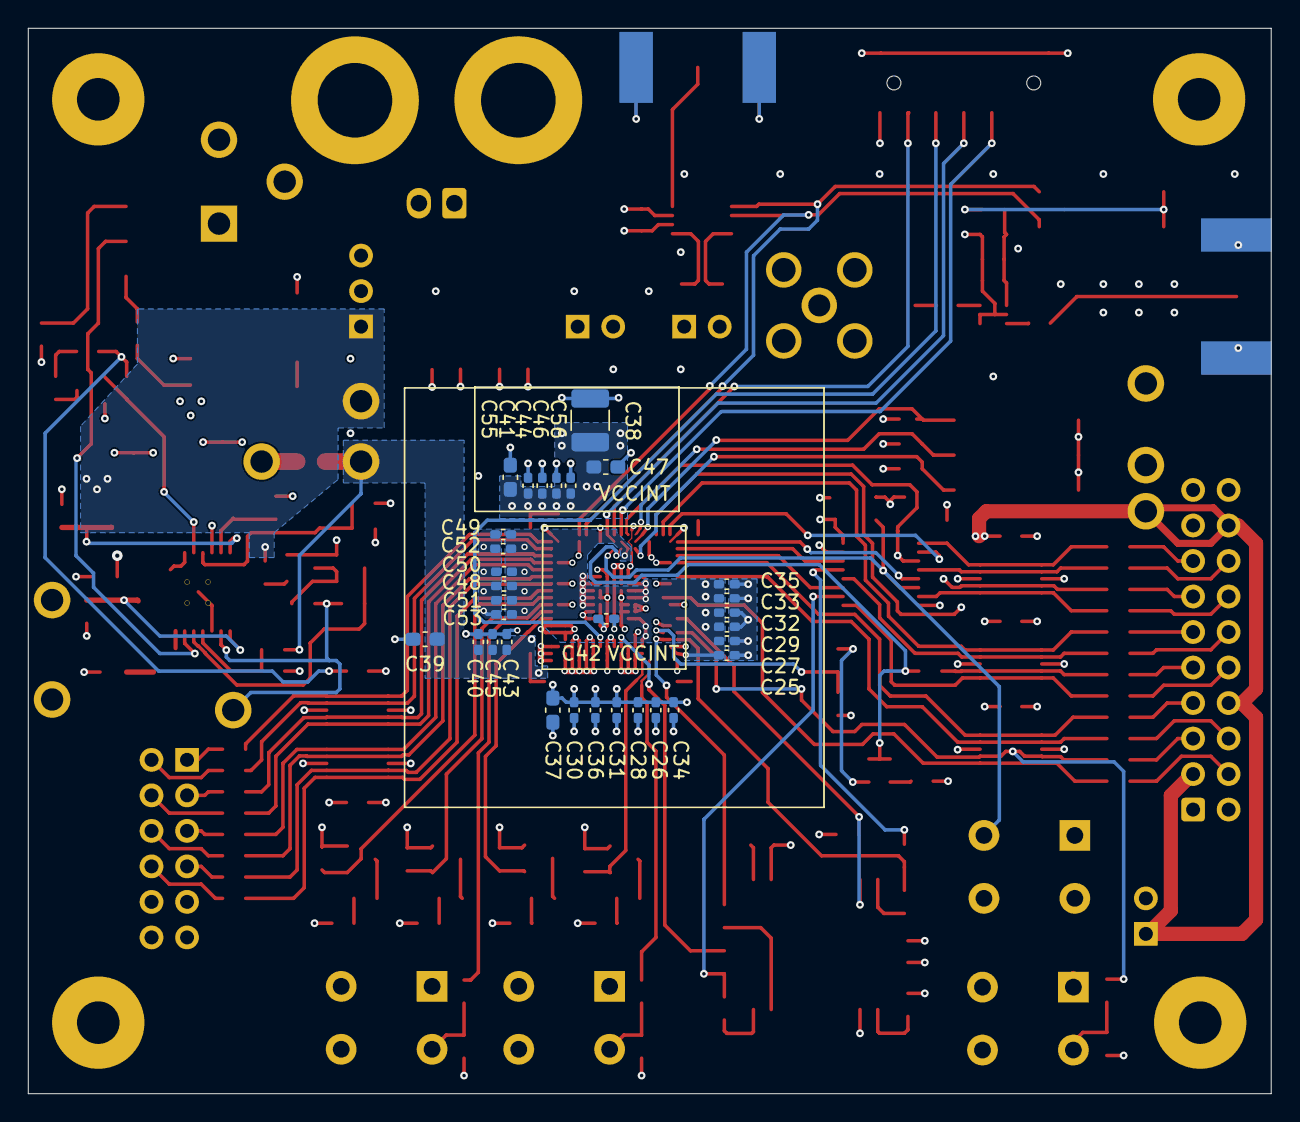
[picture p274: board dut-artix7-a12t.kicad_pcb from below]

Board: 4 copper layers, 88.9 x 76.2 mm, 201 parts (31 on the bottom side), 126 nets.

Other parts of the board:
TP6, TP7, TP8, TP9: 5281

Their connections:
/Power/pre3V3: TP9.1; also elsewhere on the board
