kammoh/fobos/hardware/fobos-shield/fobosshield.kicad_pcb

## KiCad design hardware/fobos-shield/fobosshield.kicad_pcb (2021-08-05)

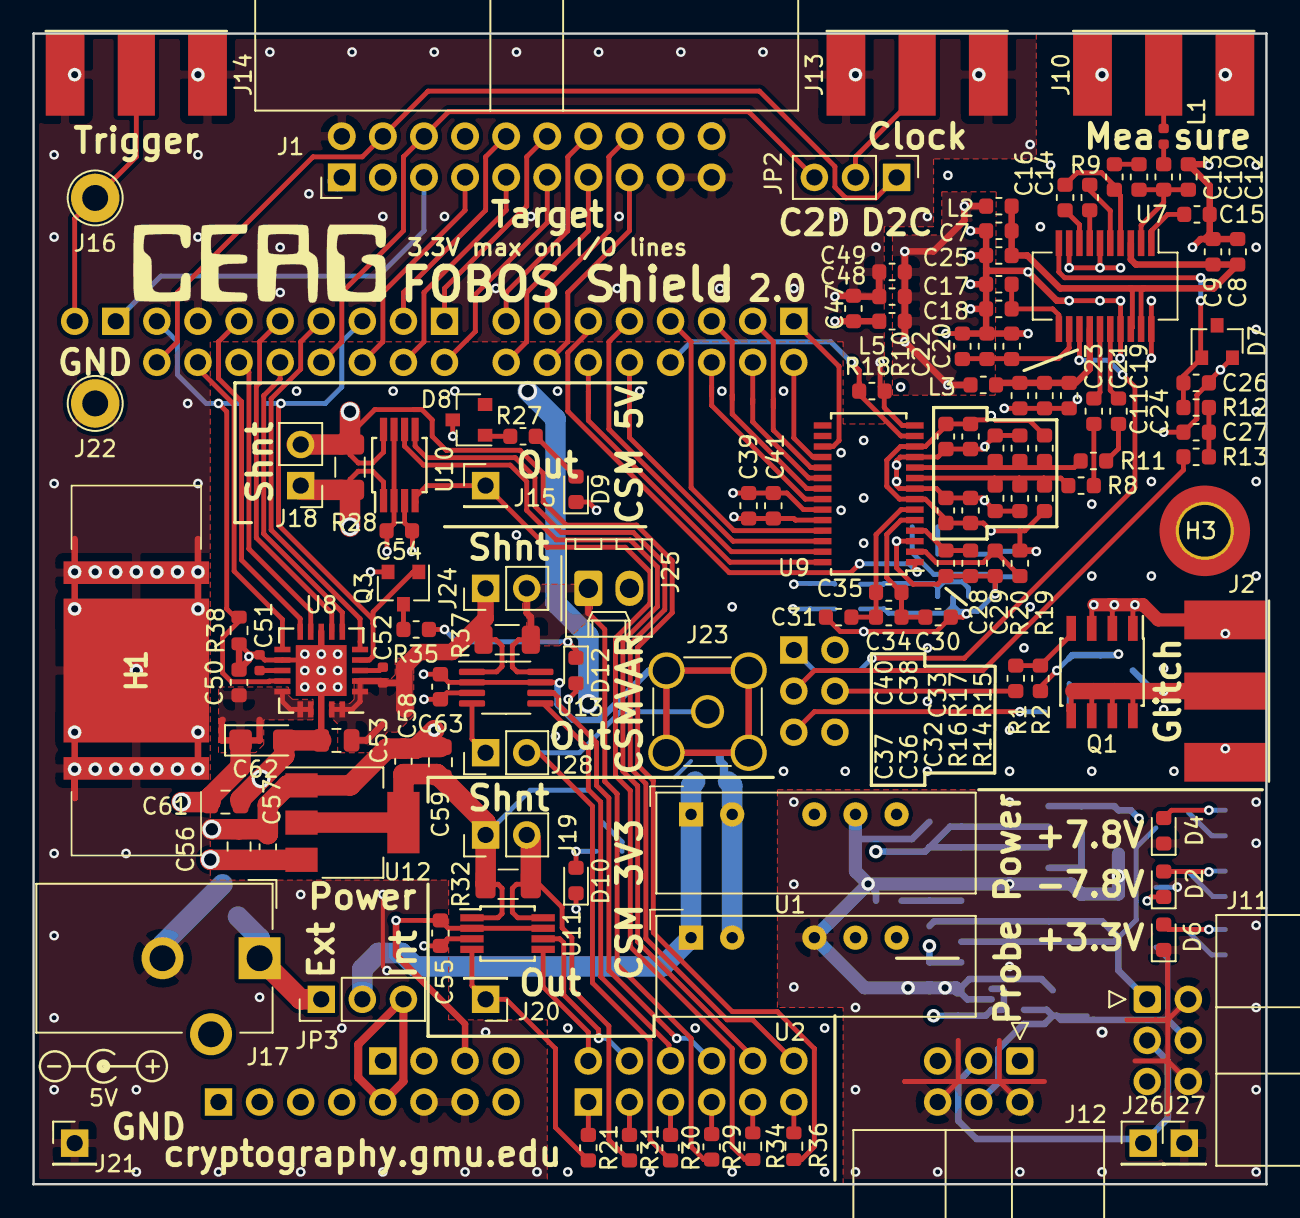
[picture p275: board fobosshield.kicad_pcb from above]

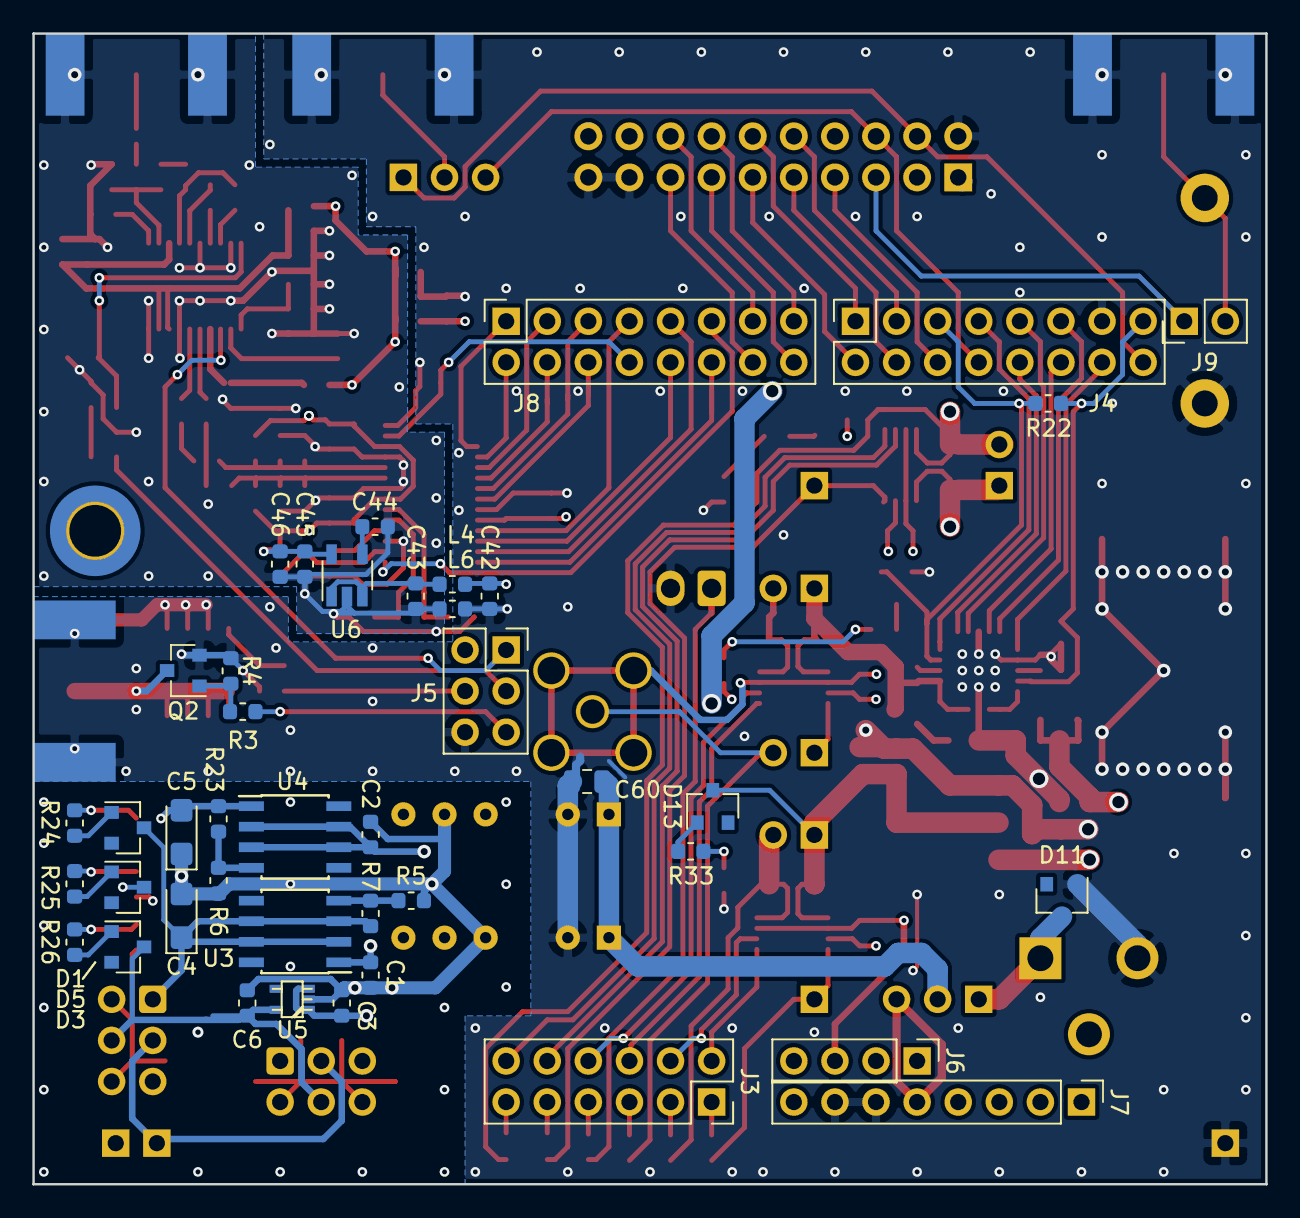
[picture p276: board fobosshield.kicad_pcb from below]

Board: 4 copper layers, 76.2 x 71.1 mm, 168 parts (42 on the bottom side), 122 nets.

Parts:
C1, C2: 100n, 16V; C_0603_1608Metric
C3, C6, C7, C23, C26, C27, C43, C45, C50: 1uF; C_0603_1608Metric
C4, C5, C62: 1uF; CP_EIA-3216-18_Kemet-A
C8, C10, C11, C14, C15, C16, C18, C21, C22, C24, C25, C28, C30, C31, C34, C36, C38, C39, C42, C46, C48, C54, C55, C57, C58, C63: 100n; C_0603_1608Metric
C9, C17, C19, C20: 1nF; C_0603_1608Metric
C12: 22pF; C_0603_1608Metric
C13: 18nF; C_0603_1608Metric
C29, C35: 10u; C_0603_1608Metric
C32, C33: 100p; C_0603_1608Metric
C37, C40, C41, C44, C47: 10n; C_0603_1608Metric
C49: 2u2; C_0603_1608Metric
C51: 10n; C_0402_1005Metric
C52: 220p; C_0402_1005Metric
C53, C56, C59: 10uF; C_0805_2012Metric
C60, C61: 10uF, 10V; C_0805_2012Metric
D1: 6V2; D_SOT-23_ANK
D2, D4, D6, D9, D10, D12: green; LED_0603_1608Metric
D3, D13: 2V4; D_SOT-23_ANK
D5, D11: 5V1; D_SOT-23_ANK
D7: BAV99; SOT-23
D8: 3V9; D_SOT-23_ANK
H1: 573100D00010G
H3: MountingHole; MountingHole_3.2mm_M3_DIN965_Pad_TopBottom
J1: Target; IDC-Header_2x10_P2.54mm_Horizontal
J2: Glitch; SMA-JOHNSON-142-0701-801
J3: Analog; PinHeader_2x06_P2.54mm_Vertical_flipped
J4: IOH; PinHeader_2x08_P2.54mm_Vertical_Flipped
J5: SPI; PinSocket_2x03_P2.54mm_Vertical
J6: Analog2; PinHeader_1x04_P2.54mm_Vertical
J7: Power; PinHeader_1x08_P2.54mm_Vertical
J8: IOL; PinHeader_2x08_P2.54mm_Vertical_Flipped
J9: SPI2; PinHeader_1x02_P2.54mm_Vertical
J10: ADCin; SMA-JOHNSON-142-0701-801
J11: PP1; IDC-Header_2x03_P2.54mm_Horizontal
J12: PP2; IDC-Header_2x03_P2.54mm_Horizontal
J13: Clock; SMA-JOHNSON-142-0701-801
J14: Trigger; SMA-JOHNSON-142-0701-801
J15: CSM5VCur; PinHeader_1x01_P2.54mm_Vertical
J16: Conn_01x01; TestPoint_Loop_D2.60mm_Drill1.6mm_Beaded
J17: Barrel_Jack_Switch; BarrelJack_CUI_PJ-102AH_Horizontal
J18, J19, J24: Conn_01x02; PinHeader_1x02_P2.54mm_Vertical
J20: CSM3V3Cur; PinHeader_1x01_P2.54mm_Vertical
J21: GND; PinHeader_1x01_P2.54mm_Vertical
J22: GND; TestPoint_Loop_D2.60mm_Drill1.6mm_Beaded
J23: Conn_Coaxial_Power; SMA_Amphenol_901-144_Vertical
J25: V_Var; Molex_KK-254_AE-6410-02A_1x02_P2.54mm_Vertical
J26: AUX; PinHeader_1x01_P2.54mm_Vertical
J27: GNDP; PinHeader_1x01_P2.54mm_Vertical
J28: CSM5VCur; PinHeader_1x02_P2.54mm_Vertical
JP2: ExtClkSel; PinHeader_1x03_P2.54mm_Vertical
JP3: Power Ext or int; PinHeader_1x03_P2.54mm_Vertical
L1: 120nH; L_0402_1005Metric
L2, L3, L4, L5, L6: 1k/500mA; L_0603_1608Metric
Q1: IRF7807Z; SOIC-8_3.9x4.9mm_P1.27mm
Q2: IRLML2502; SOT-23
Q3: BSS138L; SOT-23
R1, R3: 1R; R_0603_1608Metric
R2, R4, R10, R38: 10k; R_0603_1608Metric
R5, R6: 1K2, 1%; R_0603_1608Metric
R7, R23: 240R, 1%; R_0603_1608Metric
R8, R11: 33R, 0.5%; R_0603_1608Metric
R9: 274R; R_0603_1608Metric
R12, R13, R19: 2k; R_0603_1608Metric
R14, R15, R16, R17, R20: 1k; R_0603_1608Metric
R18, R24, R25, R26, R33: 100R; R_0603_1608Metric
R21, R29, R30, R31, R34, R36: 1k69 1%; R_0603_1608Metric
R22: 22K; R_0603_1608Metric
R27: 330R; R_0603_1608Metric
R28, R32, R37: 0R1; R_1206_3216Metric
R35: 470R; R_0603_1608Metric
U1: RB-0509D; Converter_DCDC_muRata_NMAxxxxSC_THT
U2: REE-0505S; Converter_DCDC_muRata_NMAxxxxSC_THT
U3: LM317L_SO8; SOIC-8_3.9x4.9mm_P1.27mm
U4: LM337L_SO8; SOIC-8_3.9x4.9mm_P1.27mm
U5: LD59015; sot323-5
U6: LP3985IM5-3.0; TSOT-23-5
U7: AD8331; QSOP-20_3.9x8.7mm_P0.635mm
U8: TPS7A7100_VQFN20; Texas_VQFN-RGW-20
U9: AD9215; TSSOP-28_4.4x9.7mm_P0.65mm
U10, U11, U13: INA225; MSOP-8_3x3mm_P0.65mm
U12: LD1117S33TR_SOT223; SOT-223-3_TabPin2

Connections:
5Vclean: C48.2, C49.2, L2.2, L3.2, L5.1
/Ardu/A0: J3.1, R21.1
/Ardu/A1: J3.3, R31.1
/Ardu/A2: J3.5, R30.1
/Ardu/A3: J3.7, R29.1
/Ardu/A4: J3.9, R34.1
/Ardu/A5: J3.11, R36.1
/Power/3V3P: C6.1, D3.1, J11.4, J12.4, U5.5
/Power/+7V8P: C4.1, D1.1, J11.1, J12.1, R7.1, U3.2, U3.3, U3.6, U3.7
/Power/-7V8P: C5.2, D2.1, J11.5, J12.5, R23.1, U4.1
/Power/GNDP: C1.2, C2.1, C3.2, C4.2, C5.1, C6.2, D4.1, D5.1, D6.1, J11.2, J11.6, J12.2, J12.6, J27.1, R5.2, R6.2, U1.5, U2.4, U5.2
ADC_CLK: J8.8, R18.2, U9.13
ADC_D0: J8.1, U9.17
ADC_D1: J8.2, U9.18
ADC_D2: J8.3, U9.19
ADC_D3: J8.4, U9.20
ADC_D4: J8.5, U9.21
ADC_D5: J8.6, U9.22
ADC_D6: J8.7, U9.25
ADC_D7: J8.10, U9.26
ADC_D8: J8.9, U9.27
ADC_D9: J8.12, U9.28
ADC_OR: J8.11, U9.1
CSM3V3Cur: J20.1, R21.2, U11.4
CSM3V3Gain0: J3.2, U11.5
CSM3V3Gain1: J3.4, U11.6
CSM5VCur: J15.1, R34.2, U10.4
CSM5VGain0: J3.12, U10.5
CSM5VGain1: J3.10, U10.6
CSMVarCur: J23.1, J28.2, R30.2
CSMVarGain0: J3.6, U13.5
CSMVarGain1: J3.8, U13.6
FC2D_CLK: J1.6, J4.8, JP2.3
FC2D_HS: J1.11, J4.2
FC_3V3: J1.3, J1.18, J19.2, R31.2, R32.2, U11.8
FC_5V: J1.1, J1.20, J18.2, R28.2, R36.2, U10.8
FC_DIO0: J1.10, J4.3
FC_DIO1: J1.12, J4.1
FC_DIO2: J1.14, J8.15
FC_DIO3: J1.16, J8.13
FC_IO: J1.7, J4.6
FC_PROG: J1.15, J8.14
FC_RST: J1.5, J9.1
FC_Var: J24.2, J25.1, R29.2, R37.2, U13.8
FD2C_CLK: J1.4, J4.16, JP2.1
FD2C_HS: J1.13, J8.16
FD_TF: J1.9, J4.4
GND: C39.1, C41.1, C42.1, C47.1, C48.1, C49.1, C50.2, C51.2, C53.2, C56.2, C57.2, C58.2, C59.2, C60.2, C61.2, C62.2, D9.1, D10.1, D11.2, H1.1, H1.2, H1.3, J1.2, J1.17, J1.19, J2.2, J4.13, J5.6, J7.6, J7.7, J13.2, J14.2, J17.2, J21.1, J22.1, J25.2, L6.2, Q1.1, Q1.2, Q1.3, Q2.2, Q3.2, R2.2, R4.2, R18.1, R38.1, U1.2, U2.2, U8.8, U8.12, U8.18, U8.21, U9.14, U9.23, U12.1
GNDA: C7.1, C8.1, C9.1, C12.1, C15.1, C17.1, C18.1, C19.1, C20.1, C21.1, C22.1, C23.1, C25.1, C26.1, C27.1, C28.1, C29.1, C30.2, C31.2, C32.2, C33.1, C36.1, C37.1, C38.1, C40.1, C43.1, C44.1, C45.1, C46.1, D7.2, J10.2, L6.1, R10.1, R16.2, R17.2, R20.1, U6.2, U7.6, U7.9, U7.17, U7.20, U9.3, U9.8, U9.11
Glitch: J5.4, R1.1
GlitchLP: J5.5, R3.1
IN: C50.1, C56.1, C57.1, C60.1, C61.1, C62.1, D8.1, J18.1, JP3.2, R28.1, U1.1, U2.1, U8.15, U8.16, U8.17, U10.1, U12.3
unnamed: C1.1, U1.6, U3.1
unnamed: C2.2, U1.4, U4.2, U4.3, U4.6, U4.7
unnamed: C3.1, U2.6, U5.1, U5.3
unnamed: C10.1, C12.2, C13.1, U7.2
unnamed: C10.2, L1.1
unnamed: C11.1, R8.1
unnamed: C11.2, U7.15
unnamed: C13.2, R9.2
unnamed: C14.1, U7.7
unnamed: C14.2, U7.5
unnamed: C15.2, U7.1
unnamed: C16.1, U7.8
unnamed: C16.2, R9.1, U7.4
unnamed: C17.2, C18.2, U7.11
unnamed: C19.2, C21.2, C23.2, L3.1, U7.14
unnamed: C20.2, C22.2, R10.2, U7.12
unnamed: C24.1, R11.1
unnamed: C24.2, U7.16
unnamed: C7.2, C8.2, C9.2, C25.2, L2.1, U7.3, U7.18, U7.19
unnamed: C26.2, D7.1, R12.1, U7.10
unnamed: C27.2, R12.2, R13.1
unnamed: C28.2, C29.2, U9.4
unnamed: C30.1, C34.2, C35.2, U9.5
unnamed: C31.1, C34.1, C35.1, U9.6
unnamed: C32.1, R8.2, R14.2, R16.1, U9.9
unnamed: C33.2, R11.2, R15.2, R17.1, U9.10
unnamed: C43.2, L4.1, U6.1, U6.3
unnamed: C44.2, U6.4
unnamed: C51.1, U8.13
unnamed: C52.1, C53.1, J24.1, R37.1, U8.1, U8.2, U8.19, U8.20, U13.1
unnamed: C52.2, U8.3
unnamed: C58.1, C59.1, D13.1, J19.1, R32.1, U11.1, U12.2
unnamed: D1.2, R24.2
unnamed: D2.2, R25.1
unnamed: D3.2, R26.1
unnamed: D4.2, R24.1
unnamed: D5.2, R25.2
unnamed: D6.2, R26.2
unnamed: D8.2, R27.1
unnamed: D9.2, R27.2
unnamed: D10.2, R33.2
unnamed: D11.1, J17.1, JP3.1
unnamed: D12.1, R35.2
unnamed: D13.2, R33.1
unnamed: J2.1, Q1.5, Q1.6, Q1.7, Q1.8, Q2.3
unnamed: J10.1, L1.2
unnamed: J11.3, J12.3, J26.1
unnamed: J13.1, JP2.2
unnamed: J28.1, U13.4
unnamed: Q1.4, R1.2, R2.1
unnamed: Q2.1, R3.2, R4.1
unnamed: Q3.3, R35.1
unnamed: R5.1, R7.2, U3.4
unnamed: R19.1, R20.2, U9.2
unnamed: R6.1, R23.2, U4.4
PWR0: J4.7, U8.5
PWR1: J4.10, U8.6
PWR2: J4.9, U8.7
PWR3: J4.12, U8.9
PWR4: J4.11, U8.10
PWR5: J4.14, U8.11
PWR_EN: J4.15, R22.2, R38.2, U8.14
PWR_PG: J4.5, Q3.1, R22.1, U8.4
Trigger: J9.2, J14.1, J16.1
VCC3V3: C39.2, C41.2, C42.2, D12.2, J7.2, J7.4, L4.2, U9.24
VCC5V0: C47.2, C54.1, C55.1, C63.1, J7.5, JP3.3, L5.2, U10.3, U11.3, U13.3
VDDA: C36.2, C37.2, C38.2, C40.2, C45.2, C46.2, R14.1, R15.1, R19.2, U6.5, U9.7, U9.12
VGA_GAIN: J5.3, R13.2
VGA_HILO: J5.1, U7.13
XADCGND: C54.2, C55.2, C63.2, J6.3, J23.2, U10.2, U10.7, U11.2, U11.7, U13.2, U13.7
