kammoh/fobos/hardware/fobos-mtc/fobos-mtc.kicad_pcb

## KiCad design hardware/fobos-mtc/fobos-mtc.kicad_pcb (2020-07-28)

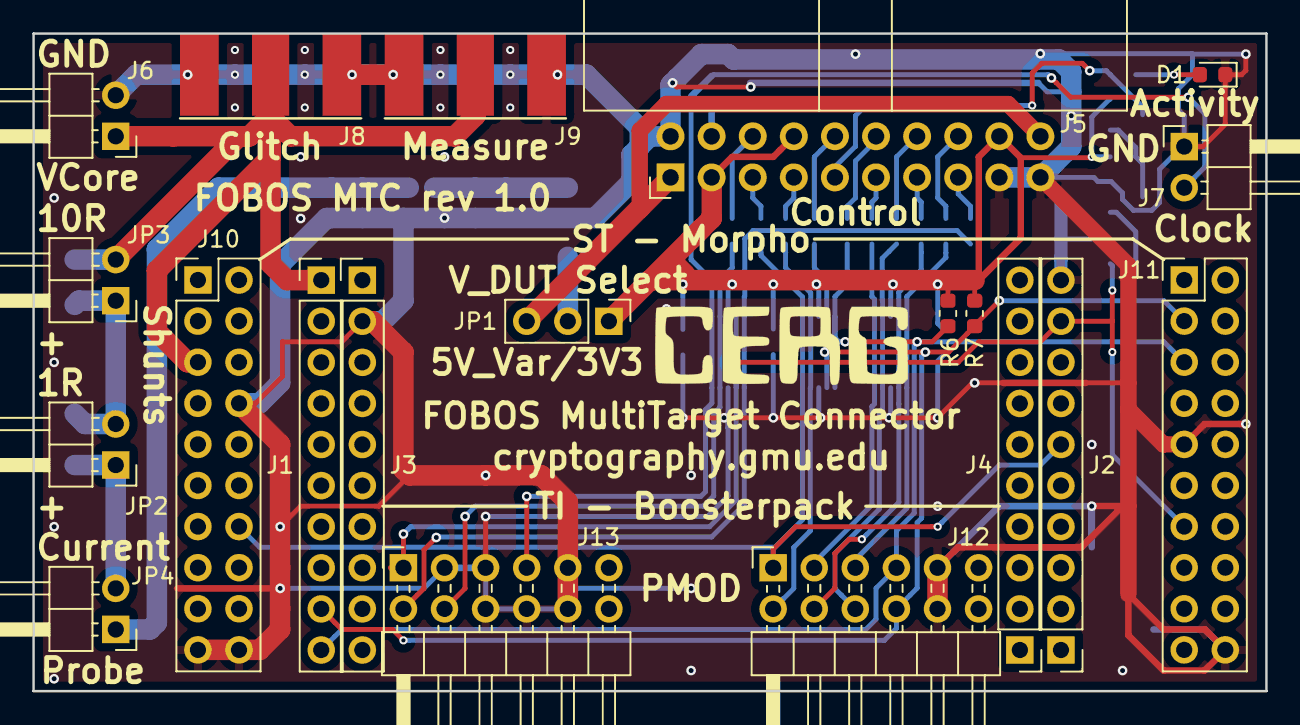
[picture p277: board fobos-mtc.kicad_pcb from above]

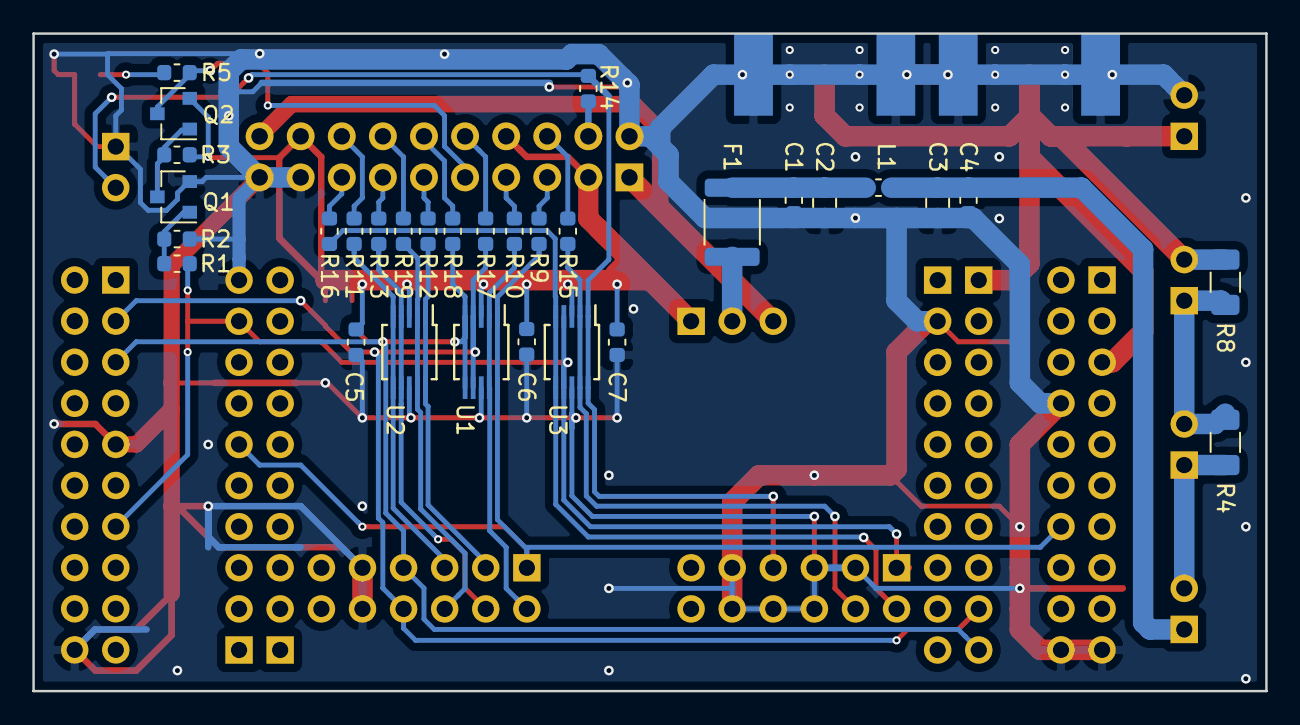
[picture p278: board fobos-mtc.kicad_pcb from below]

Board: 2 copper layers, 76.2 x 40.6 mm, 51 parts (31 on the bottom side), 36 nets.

Parts:
C1, C4, C5, C6, C7: 100nF; C_0603_1608Metric
C2: 10uF; C_0805_2012Metric
C3: 47uF6.3V; C_0805_2012Metric
D1: Activity; LED_0603_1608Metric
F1: MF-MSMF050-2; Fuse_1812_4532Metric
J1, J2, J3, J4: Conn_01x10; PinHeader_1x10_P2.54mm_Vertical
J5: Target; IDC-Header_2x10_P2.54mm_Horizontal
J6: Conn_01x02; PinHeader_1x02_P2.54mm_Horizontal
J7: clk; PinHeader_1x02_P2.54mm_Horizontal
J8: Glitch; SMA-JOHNSON-142-0701-801
J9: Measure; SMA-JOHNSON-142-0701-801
J10, J11: Conn_02x10_Odd_Even; PinSocket_2x10_P2.54mm_Vertical-flipped
J12, J13: Conn_02x06_Top_Bottom; PinHeader_2x06_P2.54mm_Horizontal-flipped
JP1: Source; PinHeader_1x03_P2.54mm_Vertical
JP2: Shunt1R; PinHeader_1x02_P2.54mm_Horizontal
JP3: Shunt10R; PinHeader_1x02_P2.54mm_Horizontal
JP4: CurProbe; PinHeader_1x02_P2.54mm_Horizontal
L1: 1k/500mA; L_0603_1608Metric
Q1: BSS138; SOT-23
Q2: BSS84; SOT-23
R1, R9, R10, R11, R12, R13, R14, R15, R16, R17, R18, R19: 22R; R_0603_1608Metric
R2, R3, R6, R7: 10k; R_0603_1608Metric
R4: 1R; R_1206_3216Metric
R5: 470R; R_0603_1608Metric
R8: 10R; R_1206_3216Metric
U1, U2, U3: SP3003-04ATG; MSOP-10_3x3mm_P0.5mm

Connections:
/dutconnect/CV_RST: J5.5, R9.1
/dutconnect/CW_HS1: J5.4, R14.2
/dutconnect/CW_HS2: J5.6, R15.2
/dutconnect/CW_MISO: J5.7, R10.1
/dutconnect/CW_PDIC: J5.13, R13.1
/dutconnect/CW_PDID: J5.15, R16.1
/dutconnect/CW_SCK: J5.11, R12.1
/dutconnect/CW_TARG1: J5.10, R17.2
/dutconnect/CW_TARG2: J5.12, R18.2
/dutconnect/CW_TARG3: J5.14, R19.2
/dutconnect/CW_TARG4: J5.16, R11.2
Aux: J13.7, R16.2, U3.5, U3.6
CLK_C2D: J13.8, R15.1, U3.2, U3.9
CLK_D2C: J7.2, J13.4, R14.1, U3.1, U3.10
CW_3V3: C5.1, C6.1, C7.1, J5.3, J5.8, J5.18, JP1.1, Q2.2, R3.1, R6.2, R7.2, U1.3, U2.3, U3.3
CW_5V: J5.1, J5.20, JP1.3
DIO0: J1.9, J11.3, J12.10, R7.1, R17.1, U1.4, U1.7
DIO1: J1.10, J11.5, J12.4, R6.1, R18.1, U1.5, U1.6
DIO2: J12.9, R19.1, U2.2, U2.9
DIO3: J12.3, R11.1, U2.5, U2.6
GND: C1.2, C2.2, C3.2, C4.2, C5.2, C6.2, C7.2, D1.1, J2.10, J3.2, J5.2, J5.17, J5.19, J6.2, J7.1, J8.2, J9.2, J10.8, J10.19, J10.20, J11.9, J11.20, J12.5, J12.11, J13.2, J13.3, J13.5, J13.9, J13.10, J13.11, Q1.2, R2.2, U1.8, U2.8, U3.8
IO: J12.7, R10.2, U1.2, U1.9
unnamed: C1.1, C2.1, F1.1, L1.2
unnamed: D1.2, R5.2
unnamed: F1.2, JP1.2
unnamed: JP2.1, JP4.2, R4.2
unnamed: JP2.2, JP3.1, R4.1, R8.2
unnamed: Q1.1, R1.1, R2.1
unnamed: Q1.3, Q2.1, R3.2
RST: J2.6, J10.14, J12.1, R9.2, U1.1, U1.10
Ready: J12.2, R12.2, U2.1, U2.10
TF: J5.9, Q2.3, R5.1
TFD: J2.9, J11.13, J13.1, R1.2, U3.4, U3.7
V_XBD: J1.1, J6.1, J8.1, J9.1, J10.5, JP3.2, R8.1
Valid: J12.8, R13.2, U2.4, U2.7
XBD_AVCC: C3.1, C4.1, JP4.1, L1.1
