kammoh/fobos/oldfobos/sources/bridgeconnector/nexys3-spartan3-starter/vhdci-fx2.brd

## EAGLE design oldfobos/sources/bridgeconnector/nexys3-spartan3-starter/vhdci-fx2.brd (2013-10-07)

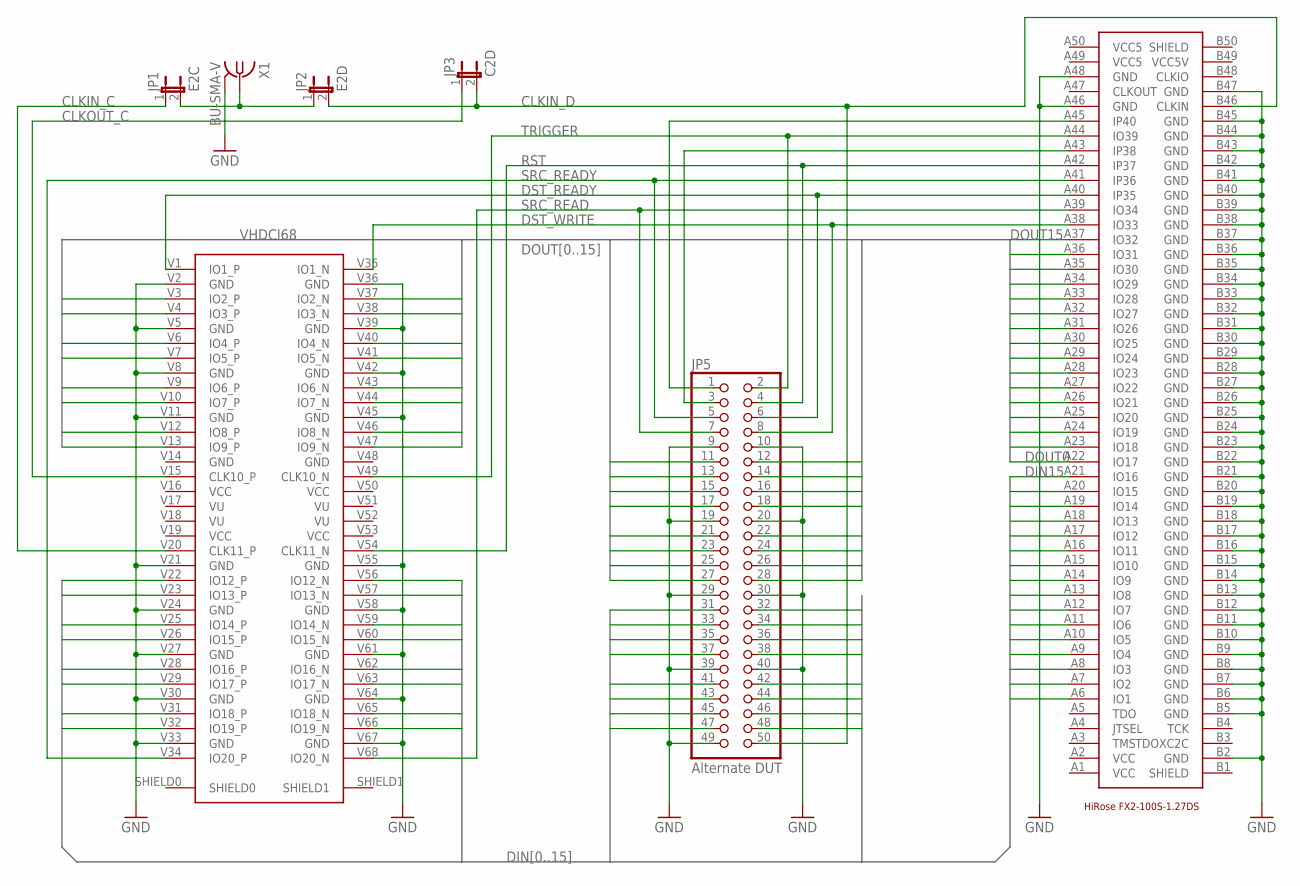
[picture p279: schematic vhdci-fx2.sch]

Parts:
JP1: E2C; JP1
JP2: E2D; JP1
JP3: C2D; JP1
JP5: Alternate DUT; 2X25
U$1: HIROSE-FX2-100S-1.27DS; HIROSE-FX2-100
U$2: VHDCI68
X1: BU-SMA-V

Connections:
CLKIN_C: JP1.1, U$2.V20 (CLK11_P)
CLKIN_D: JP2.2, JP3.2, JP5.50, U$1.B46 (CLKIN)
CLKOUT_C: JP3.1, U$2.V15 (CLK10_P)
DIN0: JP5.48, U$1.A6 (IO1), U$2.V66 (IO19_N)
DIN1: JP5.47, U$1.A7 (IO2), U$2.V32 (IO19_P)
DIN2: JP5.46, U$1.A8 (IO3), U$2.V65 (IO18_N)
DIN3: JP5.45, U$1.A9 (IO4), U$2.V31 (IO18_P)
DIN4: JP5.44, U$1.A10 (IO5), U$2.V63 (IO17_N)
DIN5: JP5.43, U$1.A11 (IO6), U$2.V29 (IO17_P)
DIN6: JP5.42, U$1.A12 (IO7), U$2.V62 (IO16_N)
DIN7: JP5.41, U$1.A13 (IO8), U$2.V28 (IO16_P)
DIN8: JP5.38, U$1.A14 (IO9), U$2.V60 (IO15_N)
DIN9: JP5.37, U$1.A15 (IO10), U$2.V26 (IO15_P)
DIN10: JP5.36, U$1.A16 (IO11), U$2.V59 (IO14_N)
DIN11: JP5.35, U$1.A17 (IO12), U$2.V25 (IO14_P)
DIN12: JP5.34, U$1.A18 (IO13), U$2.V57 (IO13_N)
DIN13: JP5.33, U$1.A19 (IO14), U$2.V23 (IO13_P)
DIN14: JP5.32, U$1.A20 (IO15), U$2.V56 (IO12_N)
DIN15: JP5.31, U$1.A21 (IO16), U$2.V22 (IO12_P)
DOUT0: JP5.28, U$1.A22 (IO17), U$2.V47 (IO9_N)
DOUT1: JP5.27, U$1.A23 (IO18), U$2.V13 (IO9_P)
DOUT2: JP5.26, U$1.A24 (IO19), U$2.V46 (IO8_N)
DOUT3: JP5.25, U$1.A25 (IO20), U$2.V12 (IO8_P)
DOUT4: JP5.24, U$1.A26 (IO21), U$2.V44 (IO7_N)
DOUT5: JP5.23, U$1.A27 (IO22), U$2.V10 (IO7_P)
DOUT6: JP5.22, U$1.A28 (IO23), U$2.V43 (IO6_N)
DOUT7: JP5.21, U$1.A29 (IO24), U$2.V9 (IO6_P)
DOUT8: JP5.18, U$1.A30 (IO25), U$2.V41 (IO5_N)
DOUT9: JP5.17, U$1.A31 (IO26), U$2.V7 (IO5_P)
DOUT10: JP5.16, U$1.A32 (IO27), U$2.V40 (IO4_N)
DOUT11: JP5.15, U$1.A33 (IO28), U$2.V6 (IO4_P)
DOUT12: JP5.14, U$1.A34 (IO29), U$2.V38 (IO3_N)
DOUT13: JP5.13, U$1.A35 (IO30), U$2.V4 (IO3_P)
DOUT14: JP5.12, U$1.A36 (IO31), U$2.V37 (IO2_N)
DOUT15: JP5.11, U$1.A37 (IO32), U$2.V3 (IO2_P)
DST_READY: JP5.6, U$1.A40 (IP35), U$2.V1 (IO1_P)
DST_WRITE: JP5.8, U$1.A38 (IO33), U$2.V35 (IO1_N)
GND: JP5.9, JP5.10, JP5.19, JP5.20, JP5.29, JP5.30, JP5.39, JP5.40, JP5.49, U$1.A46 (GND), U$1.A48 (GND), U$1.B2 (GND), U$1.B5 (GND), U$1.B6 (GND), U$1.B7 (GND), U$1.B8 (GND), U$1.B9 (GND), U$1.B10 (GND), U$1.B11 (GND), U$1.B12 (GND), U$1.B13 (GND), U$1.B14 (GND), U$1.B15 (GND), U$1.B16 (GND), U$1.B17 (GND), U$1.B18 (GND), U$1.B19 (GND), U$1.B20 (GND), U$1.B21 (GND), U$1.B22 (GND), U$1.B23 (GND), U$1.B24 (GND), U$1.B25 (GND), U$1.B26 (GND), U$1.B27 (GND), U$1.B28 (GND), U$1.B29 (GND), U$1.B30 (GND), U$1.B31 (GND), U$1.B32 (GND), U$1.B33 (GND), U$1.B34 (GND), U$1.B35 (GND), U$1.B36 (GND), U$1.B37 (GND), U$1.B38 (GND), U$1.B39 (GND), U$1.B40 (GND), U$1.B41 (GND), U$1.B42 (GND), U$1.B43 (GND), U$1.B44 (GND), U$1.B45 (GND), U$1.B47 (GND), U$2.V2 (GND), U$2.V5 (GND), U$2.V8 (GND), U$2.V11 (GND), U$2.V21 (GND), U$2.V24 (GND), U$2.V27 (GND), U$2.V30 (GND), U$2.V33 (GND), U$2.V36 (GND), U$2.V39 (GND), U$2.V42 (GND), U$2.V45 (GND), U$2.V55 (GND), U$2.V58 (GND), U$2.V61 (GND), U$2.V64 (GND), U$2.V67 (GND), X1.2 (GND), X1.3 (GND), X1.4 (GND), X1.5 (GND)
unnamed: JP1.2, JP2.1, X1.1
unnamed: JP5.1, U$1.A45 (IP40)
unnamed: JP5.3, U$1.A43 (IP38)
RST: JP5.4, U$1.A42 (IP37), U$2.V54 (CLK11_N)
SRC_READ: JP5.7, U$1.A39 (IO34), U$2.V68 (IO20_N)
SRC_READY: JP5.5, U$1.A41 (IP36), U$2.V34 (IO20_P)
TRIGGER: JP5.2, U$1.A44 (IO39), U$2.V49 (CLK10_N)
VCC: U$1.A1 (VCC), U$1.A2 (VCC), U$2.V16 (VCC), U$2.V19 (VCC), U$2.V50 (VCC), U$2.V53 (VCC)
VCC5: U$1.A49 (VCC5), U$1.A50 (VCC5)
VCC5V: U$1.B49 (VCC5V)
VU: U$2.V17 (VU), U$2.V18 (VU), U$2.V51 (VU), U$2.V52 (VU)

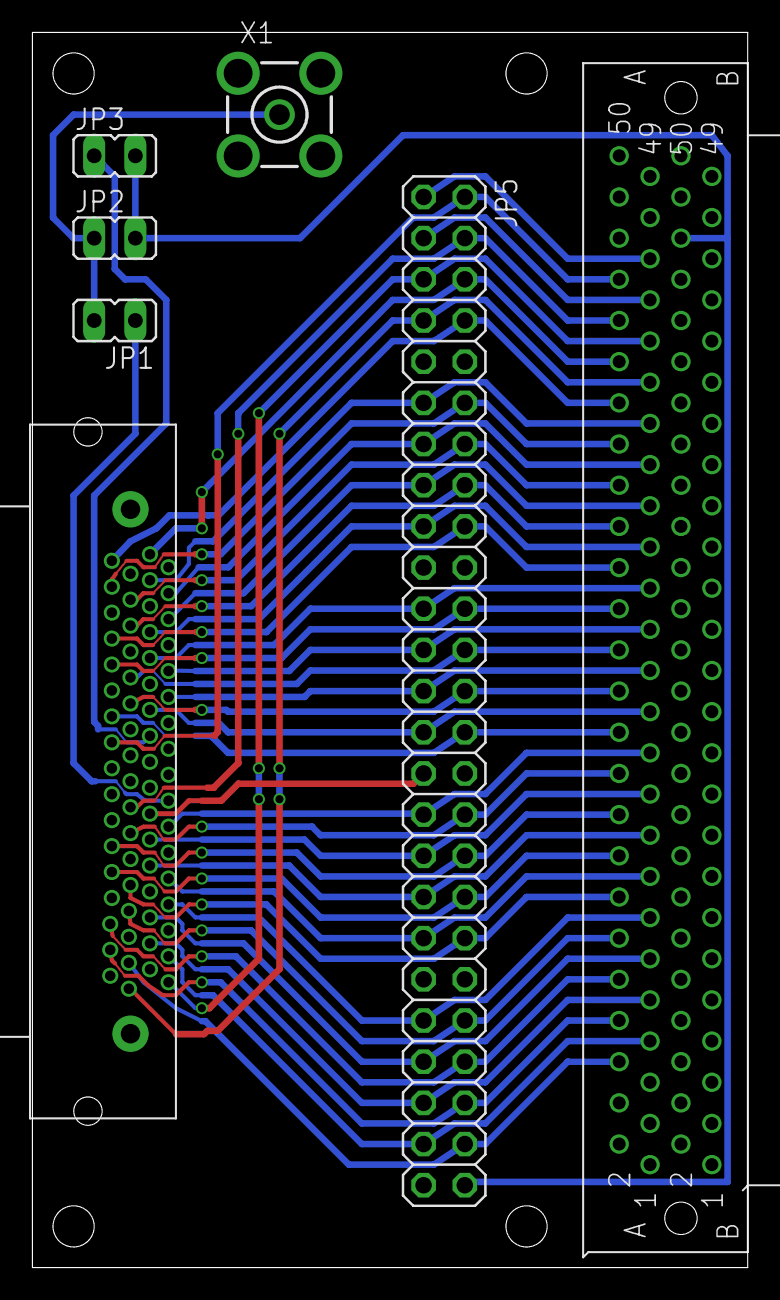
[picture p280: board vhdci-fx2.brd from above]

Board: 2 copper layers, 44.1 x 76.2 mm, 7 parts (0 on the bottom side), 48 nets.
