kammoh/fobos/oldfobos/sources/bridgeconnector/nexys3-nexys3/vhdci-fx2-gnd.brd

## EAGLE design oldfobos/sources/bridgeconnector/nexys3-nexys3/vhdci-fx2-gnd.brd (2013-10-07)

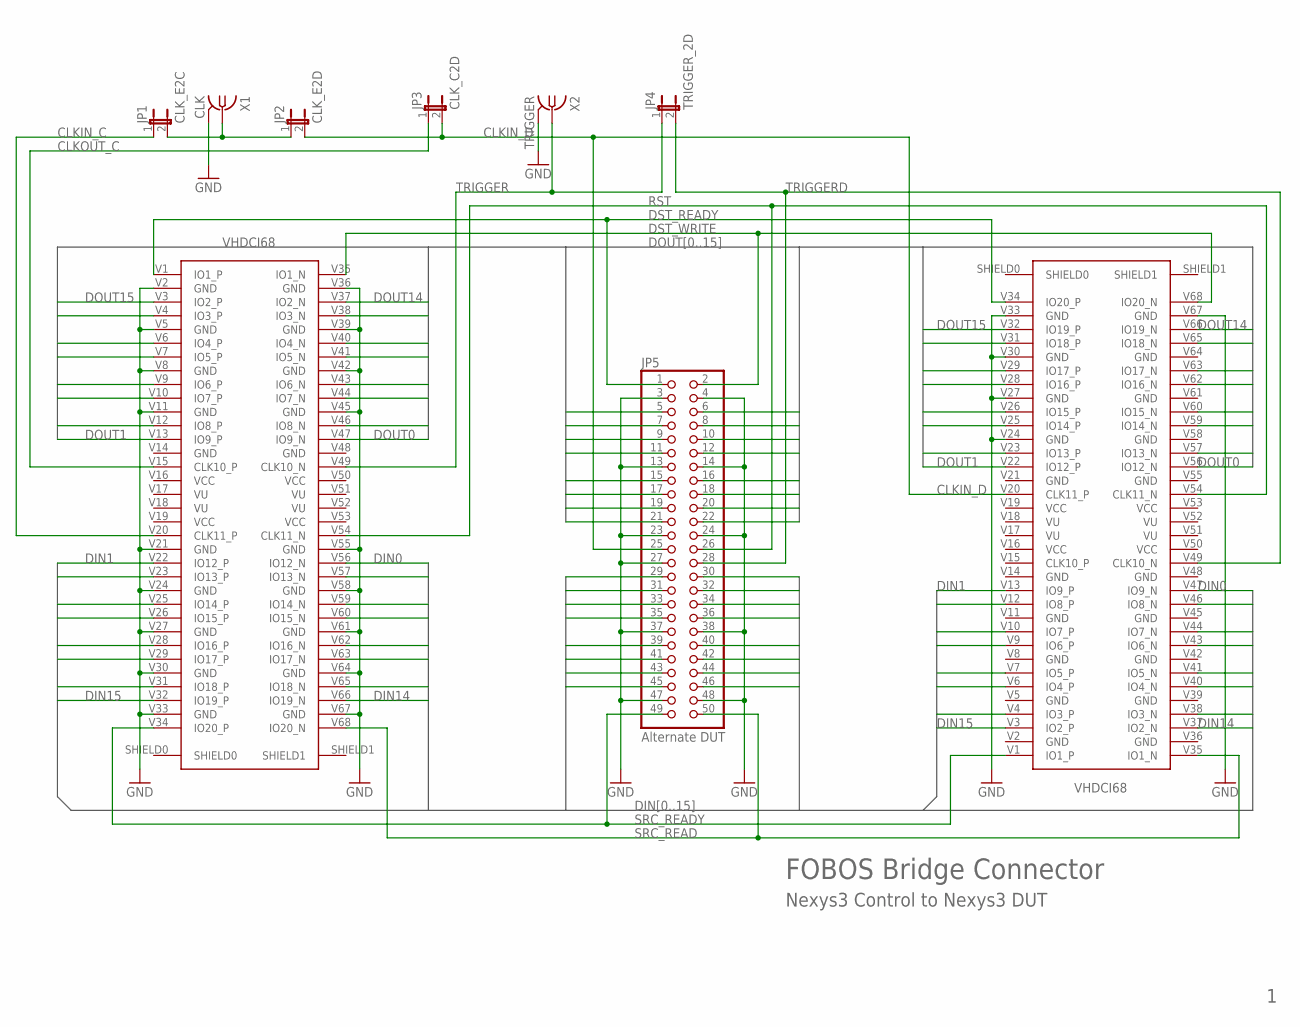
[picture p285: schematic vhdci-fx2-gnd.sch]

Parts:
JP1: CLK_E2C; JP1
JP2: CLK_E2D; JP1
JP3: CLK_C2D; JP1
JP4: TRIGGER_2D; JP1
JP5: Alternate DUT; 2X25
U$1, U$2: VHDCI68
X1: CLK; BU-SMA-V
X2: TRIGGER; BU-SMA-V

Connections:
CLKIN_C: JP1.1, U$2.V20 (CLK11_P)
CLKIN_D: JP2.2, JP3.2, JP5.25, U$1.V20 (CLK11_P)
CLKOUT_C: JP3.1, U$2.V15 (CLK10_P)
DIN0: JP5.30, U$1.V47 (IO9_N), U$2.V56 (IO12_N)
DIN1: JP5.29, U$1.V13 (IO9_P), U$2.V22 (IO12_P)
DIN2: JP5.32, U$1.V46 (IO8_N), U$2.V57 (IO13_N)
DIN3: JP5.31, U$1.V12 (IO8_P), U$2.V23 (IO13_P)
DIN4: JP5.34, U$1.V44 (IO7_N), U$2.V59 (IO14_N)
DIN5: JP5.33, U$1.V10 (IO7_P), U$2.V25 (IO14_P)
DIN6: JP5.36, U$1.V43 (IO6_N), U$2.V60 (IO15_N)
DIN7: JP5.35, U$1.V9 (IO6_P), U$2.V26 (IO15_P)
DIN8: JP5.40, U$1.V41 (IO5_N), U$2.V62 (IO16_N)
DIN9: JP5.39, U$1.V7 (IO5_P), U$2.V28 (IO16_P)
DIN10: JP5.42, U$1.V40 (IO4_N), U$2.V63 (IO17_N)
DIN11: JP5.41, U$1.V6 (IO4_P), U$2.V29 (IO17_P)
DIN12: JP5.44, U$1.V38 (IO3_N), U$2.V65 (IO18_N)
DIN13: JP5.43, U$1.V4 (IO3_P), U$2.V31 (IO18_P)
DIN14: JP5.46, U$1.V37 (IO2_N), U$2.V66 (IO19_N)
DIN15: JP5.45, U$1.V3 (IO2_P), U$2.V32 (IO19_P)
DOUT0: JP5.22, U$1.V56 (IO12_N), U$2.V47 (IO9_N)
DOUT1: JP5.21, U$1.V22 (IO12_P), U$2.V13 (IO9_P)
DOUT2: JP5.20, U$1.V57 (IO13_N), U$2.V46 (IO8_N)
DOUT3: JP5.19, U$1.V23 (IO13_P), U$2.V12 (IO8_P)
DOUT4: JP5.18, U$1.V59 (IO14_N), U$2.V44 (IO7_N)
DOUT5: JP5.17, U$1.V25 (IO14_P), U$2.V10 (IO7_P)
DOUT6: JP5.16, U$1.V60 (IO15_N), U$2.V43 (IO6_N)
DOUT7: JP5.15, U$1.V26 (IO15_P), U$2.V9 (IO6_P)
DOUT8: JP5.12, U$1.V62 (IO16_N), U$2.V41 (IO5_N)
DOUT9: JP5.11, U$1.V28 (IO16_P), U$2.V7 (IO5_P)
DOUT10: JP5.10, U$1.V63 (IO17_N), U$2.V40 (IO4_N)
DOUT11: JP5.9, U$1.V29 (IO17_P), U$2.V6 (IO4_P)
DOUT12: JP5.8, U$1.V65 (IO18_N), U$2.V38 (IO3_N)
DOUT13: JP5.7, U$1.V31 (IO18_P), U$2.V4 (IO3_P)
DOUT14: JP5.6, U$1.V66 (IO19_N), U$2.V37 (IO2_N)
DOUT15: JP5.5, U$1.V32 (IO19_P), U$2.V3 (IO2_P)
DST_READY: JP5.1, U$1.V34 (IO20_P), U$2.V1 (IO1_P)
DST_WRITE: JP5.2, U$1.V68 (IO20_N), U$2.V35 (IO1_N)
GND: JP5.3, JP5.4, JP5.13, JP5.14, JP5.23, JP5.24, JP5.27, JP5.37, JP5.38, JP5.47, JP5.48, U$1.V24 (GND), U$1.V27 (GND), U$1.V30 (GND), U$1.V33 (GND), U$1.V67 (GND), U$2.V2 (GND), U$2.V5 (GND), U$2.V8 (GND), U$2.V11 (GND), U$2.V21 (GND), U$2.V24 (GND), U$2.V27 (GND), U$2.V30 (GND), U$2.V33 (GND), U$2.V36 (GND), U$2.V39 (GND), U$2.V42 (GND), U$2.V45 (GND), U$2.V55 (GND), U$2.V58 (GND), U$2.V61 (GND), U$2.V64 (GND), U$2.V67 (GND), X1.2 (GND), X1.3 (GND), X1.4 (GND), X1.5 (GND), X2.2 (GND), X2.3 (GND), X2.4 (GND), X2.5 (GND)
unnamed: JP1.2, JP2.1, X1.1
RST: JP5.26, U$1.V54 (CLK11_N), U$2.V54 (CLK11_N)
SRC_READ: JP5.50, U$1.V35 (IO1_N), U$2.V68 (IO20_N)
SRC_READY: JP5.49, U$1.V1 (IO1_P), U$2.V34 (IO20_P)
TRIGGER: JP4.1, U$2.V49 (CLK10_N), X2.1
TRIGGERD: JP4.2, JP5.28, U$1.V49 (CLK10_N)
VCC: U$1.V16 (VCC), U$1.V19 (VCC), U$1.V50 (VCC), U$1.V53 (VCC), U$2.V16 (VCC), U$2.V19 (VCC), U$2.V50 (VCC), U$2.V53 (VCC)
VU: U$1.V17 (VU), U$1.V18 (VU), U$1.V51 (VU), U$1.V52 (VU), U$2.V17 (VU), U$2.V18 (VU), U$2.V51 (VU), U$2.V52 (VU)

Notes on the sheet:
FOBOS Bridge Connector
Nexys3 Control to Nexys3 DUT

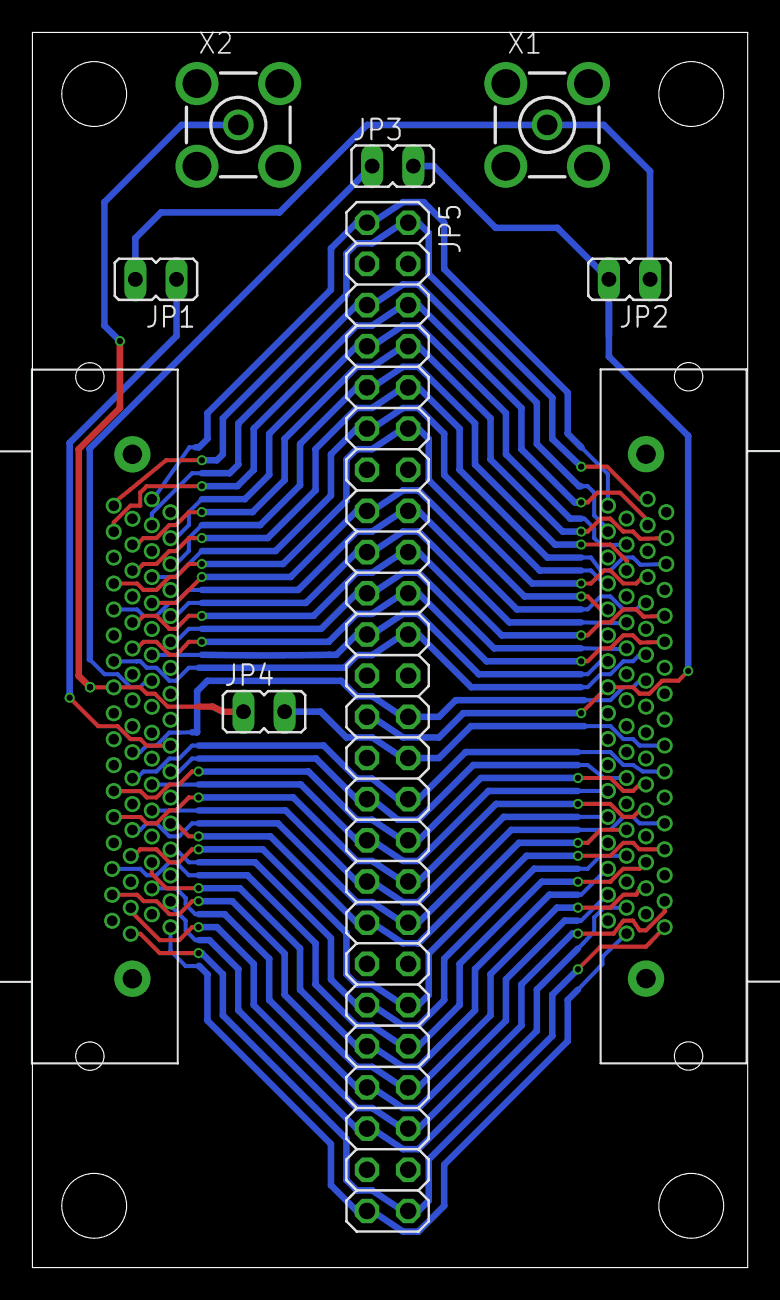
[picture p286: board oldfobos/sources/bridgeconnector/nexys3-nexys3/vhdci-fx2-gnd.brd from above]

Board: 2 copper layers, 44.1 x 76.2 mm, 9 parts (0 on the bottom side), 46 nets.
