kammoh/fobos/dut/soc_wrapper/vivado/src/constr/ext_debug.xdc

set_property MARK_DEBUG true [get_nets {din_IBUF[1]}]
set_property MARK_DEBUG true [get_nets {din_IBUF[3]}]
set_property MARK_DEBUG true [get_nets {din_IBUF[2]}]
set_property MARK_DEBUG true [get_nets {din_IBUF[0]}]
set_property MARK_DEBUG true [get_nets {dout_OBUF[2]}]
set_property MARK_DEBUG true [get_nets do_ready_IBUF]
set_property MARK_DEBUG true [get_nets dut_clk_IBUF]
set_property MARK_DEBUG true [get_nets {dut_rst_IBUF[0]}]
set_property MARK_DEBUG true [get_nets {dout_OBUF[0]}]
set_property MARK_DEBUG true [get_nets {dout_OBUF[1]}]
set_property MARK_DEBUG true [get_nets do_valid_OBUF]
set_property MARK_DEBUG true [get_nets di_ready_OBUF]
set_property MARK_DEBUG true [get_nets {dout_OBUF[3]}]
connect_debug_port u_ila_0/clk [get_nets [list dut_clk_IBUF]]
connect_debug_port u_ila_0/probe6 [get_nets [list dut_clk_IBUF]]
connect_debug_port dbg_hub/clk [get_nets dut_clk_IBUF]


set_property MARK_DEBUG true [get_nets di_valid_IBUF]
set_property MARK_DEBUG false [get_nets {soc_dut_i/ps7_0_axi_periph_M00_AXI_WDATA[27]}]
set_property MARK_DEBUG false [get_nets {soc_dut_i/ps7_0_axi_periph_M00_AXI_WDATA[29]}]
set_property MARK_DEBUG false [get_nets {soc_dut_i/ps7_0_axi_periph_M00_AXI_WDATA[30]}]
set_property MARK_DEBUG false [get_nets {soc_dut_i/ps7_0_axi_periph_M00_AXI_WDATA[12]}]
set_property MARK_DEBUG false [get_nets {soc_dut_i/ps7_0_axi_periph_M00_AXI_WDATA[15]}]
set_property MARK_DEBUG false [get_nets {soc_dut_i/ps7_0_axi_periph_M00_AXI_WDATA[19]}]
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
set_property MARK_DEBUG true [get_nets {soc_dut_i/ctrlComm_0_M_AXIS_TDATA[25]}]
set_property MARK_DEBUG true [get_nets {soc_dut_i/ctrlComm_0_M_AXIS_TDATA[18]}]
set_property MARK_DEBUG true [get_nets {soc_dut_i/ctrlComm_0_M_AXIS_TDATA[19]}]
set_property MARK_DEBUG true [get_nets {soc_dut_i/ctrlComm_0_M_AXIS_TDATA[13]}]
set_property MARK_DEBUG true [get_nets {soc_dut_i/ctrlComm_0_M_AXIS_TDATA[16]}]
set_property MARK_DEBUG true [get_nets {soc_dut_i/ctrlComm_0_M_AXIS_TDATA[15]}]
set_property MARK_DEBUG true [get_nets {soc_dut_i/ctrlComm_0_M_AXIS_TDATA[10]}]
set_property MARK_DEBUG true [get_nets {soc_dut_i/ctrlComm_0_M_AXIS_TDATA[9]}]
set_property MARK_DEBUG true [get_nets {soc_dut_i/ctrlComm_0_M_AXIS_TDATA[12]}]
set_property MARK_DEBUG true [get_nets {soc_dut_i/ctrlComm_0_M_AXIS_TDATA[11]}]
set_property MARK_DEBUG true [get_nets {soc_dut_i/ctrlComm_0_M_AXIS_TDATA[6]}]
set_property MARK_DEBUG true [get_nets {soc_dut_i/ctrlComm_0_M_AXIS_TDATA[3]}]
set_property MARK_DEBUG true [get_nets {soc_dut_i/ctrlComm_0_M_AXIS_TDATA[2]}]
set_property MARK_DEBUG true [get_nets {soc_dut_i/ctrlComm_0_M_AXIS_TDATA[5]}]
set_property MARK_DEBUG true [get_nets {soc_dut_i/ctrlComm_0_M_AXIS_TDATA[0]}]
set_property MARK_DEBUG true [get_nets {soc_dut_i/ctrlComm_0_M_AXIS_TDATA[1]}]
set_property MARK_DEBUG true [get_nets {soc_dut_i/ctrlComm_0_M_AXIS_TDATA[4]}]
set_property MARK_DEBUG true [get_nets {soc_dut_i/ctrlComm_0_M_AXIS_TDATA[20]}]
set_property MARK_DEBUG true [get_nets {soc_dut_i/ctrlComm_0_M_AXIS_TDATA[14]}]
set_property MARK_DEBUG true [get_nets {soc_dut_i/ctrlComm_0_M_AXIS_TDATA[8]}]
set_property MARK_DEBUG true [get_nets {soc_dut_i/ctrlComm_0_M_AXIS_TDATA[17]}]
set_property MARK_DEBUG true [get_nets {soc_dut_i/ctrlComm_0_M_AXIS_TDATA[7]}]
set_property MARK_DEBUG true [get_nets soc_dut_i/ctrlComm_0_M_AXIS_TREADY]
connect_debug_port u_ila_0/probe3 [get_nets [list {dut_rst_IBUF[0]}]]
connect_debug_port dbg_hub/clk [get_nets dut_clk_OBUF]



set_property MARK_DEBUG true [get_nets {soc_dut_i/aes_axi_0/do_data[124]}]
set_property MARK_DEBUG true [get_nets {soc_dut_i/aes_axi_0/do_data[116]}]
set_property MARK_DEBUG true [get_nets {soc_dut_i/aes_axi_0/do_data[108]}]
set_property MARK_DEBUG true [get_nets {soc_dut_i/aes_axi_0/do_data[96]}]
set_property MARK_DEBUG true [get_nets {soc_dut_i/aes_axi_0/do_data[84]}]
set_property MARK_DEBUG true [get_nets {soc_dut_i/aes_axi_0/do_data[72]}]
set_property MARK_DEBUG true [get_nets {soc_dut_i/aes_axi_0/do_data[125]}]
set_property MARK_DEBUG true [get_nets {soc_dut_i/aes_axi_0/do_data[117]}]
set_property MARK_DEBUG true [get_nets {soc_dut_i/aes_axi_0/do_data[73]}]
set_property MARK_DEBUG true [get_nets {soc_dut_i/aes_axi_0/do_data[3]}]
set_property MARK_DEBUG true [get_nets {soc_dut_i/aes_axi_0/do_data[45]}]
set_property MARK_DEBUG true [get_nets {soc_dut_i/aes_axi_0/do_data[102]}]
set_property MARK_DEBUG true [get_nets {soc_dut_i/aes_axi_0/do_data[114]}]
set_property MARK_DEBUG true [get_nets {soc_dut_i/aes_axi_0/do_data[90]}]
set_property MARK_DEBUG true [get_nets {soc_dut_i/aes_axi_0/do_data[78]}]
set_property MARK_DEBUG true [get_nets {soc_dut_i/aes_axi_0/do_data[42]}]
set_property MARK_DEBUG true [get_nets {soc_dut_i/aes_axi_0/do_data[6]}]
set_property MARK_DEBUG true [get_nets {soc_dut_i/aes_axi_0/do_data[111]}]
set_property MARK_DEBUG true [get_nets {soc_dut_i/aes_axi_0/do_data[99]}]
set_property MARK_DEBUG true [get_nets {soc_dut_i/aes_axi_0/do_data[87]}]
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
oc_dut_i/aes_axi_0/do_data[87]} {soc_dut_i/aes_axi_0/do_data[88]} {soc_dut_i/aes_axi_0/do_data[89]} {soc_dut_i/aes_axi_0/do_data[90]} {soc_dut_i/aes_axi_0/do_data[91]} {soc_dut_i/aes_axi_0/do_data[92]} {soc_dut_i/aes_axi_0/do_data[93]} {soc_dut_i/aes_axi_0/do_data[94]} {soc_dut_i/aes_axi_0/do_data[95]} {soc_dut_i/aes_axi_0/do_data[96]} {soc_dut_i/aes_axi_0/do_data[97]} {soc_dut_i/aes_axi_0/do_data[98]} {soc_dut_i/aes_axi_0/do_data[99]} {soc_dut_i/aes_axi_0/do_data[100]} {soc_dut_i/aes_axi_0/do_data[101]} {soc_dut_i/aes_axi_0/do_data[102]} {soc_dut_i/aes_axi_0/do_data[103]} {soc_dut_i/aes_axi_0/do_data[104]} {soc_dut_i/aes_axi_0/do_data[105]} {soc_dut_i/aes_axi_0/do_data[106]} {soc_dut_i/aes_axi_0/do_data[107]} {soc_dut_i/aes_axi_0/do_data[108]} {soc_dut_i/aes_axi_0/do_data[109]} {soc_dut_i/aes_axi_0/do_data[110]} {soc_dut_i/aes_axi_0/do_data[111]} {soc_dut_i/aes_axi_0/do_data[112]} {soc_dut_i/aes_axi_0/do_data[113]} {soc_dut_i/aes_axi_0/do_data[114]} {soc_dut_i/aes_axi_0/do_data[115]} {soc_dut_i/aes_axi_0/do_data[116]} {soc_dut_i/aes_axi_0/do_data[117]} {soc_dut_i/aes_axi_0/do_data[118]} {soc_dut_i/aes_axi_0/do_data[119]} {soc_dut_i/aes_axi_0/do_data[120]} {soc_dut_i/aes_axi_0/do_data[121]} {soc_dut_i/aes_axi_0/do_data[122]} {soc_dut_i/aes_axi_0/do_data[123]} {soc_dut_i/aes_axi_0/do_data[124]} {soc_dut_i/aes_axi_0/do_data[125]} {soc_dut_i/aes_axi_0/do_data[126]} {soc_dut_i/aes_axi_0/do_data[127]}]]
connect_debug_port u_ila_0/probe17 [get_nets [list soc_dut_i/aes_axi_0/do_ready]]
connect_debug_port u_ila_0/probe20 [get_nets [list soc_dut_i/aes_axi_0/do_valid]]
connect_debug_port u_ila_0/probe23 [get_nets [list soc_dut_i/aes_axi_0/pdi_ready]]
connect_debug_port u_ila_0/probe24 [get_nets [list soc_dut_i/aes_axi_0/pdi_valid]]


set_property MARK_DEBUG true [get_nets {soc_dut_i/cryptoWrapper_0/m_axis_do_tdata[0]}]
set_property MARK_DEBUG true [get_nets {soc_dut_i/cryptoWrapper_0/m_axis_do_tdata[100]}]
set_property MARK_DEBUG true [get_nets {soc_dut_i/cryptoWrapper_0/m_axis_do_tdata[101]}]
set_property MARK_DEBUG true [get_nets {soc_dut_i/cryptoWrapper_0/m_axis_do_tdata[102]}]
set_property MARK_DEBUG true [get_nets {soc_dut_i/cryptoWrapper_0/m_axis_do_tdata[103]}]
set_property MARK_DEBUG true [get_nets {soc_dut_i/cryptoWrapper_0/m_axis_do_tdata[104]}]
set_property MARK_DEBUG true [get_nets {soc_dut_i/cryptoWrapper_0/m_axis_do_tdata[105]}]
set_property MARK_DEBUG true [get_nets {soc_dut_i/cryptoWrapper_0/m_axis_do_tdata[106]}]
set_property MARK_DEBUG true [get_nets {soc_dut_i/cryptoWrapper_0/m_axis_do_tdata[107]}]
set_property MARK_DEBUG true [get_nets {soc_dut_i/cryptoWrapper_0/m_axis_do_tdata[108]}]
set_property MARK_DEBUG true [get_nets {soc_dut_i/cryptoWrapper_0/m_axis_do_tdata[109]}]
set_property MARK_DEBUG true [get_nets {soc_dut_i/cryptoWrapper_0/m_axis_do_tdata[10]}]
set_property MARK_DEBUG true [get_nets {soc_dut_i/cryptoWrapper_0/m_axis_do_tdata[110]}]
set_property MARK_DEBUG true [get_nets {soc_dut_i/cryptoWrapper_0/m_axis_do_tdata[111]}]
set_property MARK_DEBUG true [get_nets {soc_dut_i/cryptoWrapper_0/m_axis_do_tdata[112]}]
set_property MARK_DEBUG true [get_nets {soc_dut_i/cryptoWrapper_0/m_axis_do_tdata[113]}]
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
set_property MARK_DEBUG true [get_nets soc_dut_i/cryptoWrapper_0/m_axis_do_tvalid]
set_property MARK_DEBUG true [get_nets soc_dut_i/cryptoWrapper_0/s_axis_pdi_tvalid]
set_property MARK_DEBUG true [get_nets soc_dut_i/cryptoWrapper_0/s_axis_sdi_tvalid]

set_property MARK_DEBUG true [get_nets soc_dut_i/ctrlComm_0/do_ready]
set_property MARK_DEBUG true [get_nets soc_dut_i/ctrlComm_0/di_valid]
set_property MARK_DEBUG true [get_nets soc_dut_i/ctrlComm_0/di_ready]
set_property MARK_DEBUG true [get_nets {soc_dut_i/ctrlComm_0/dout[1]}]
set_property MARK_DEBUG true [get_nets {soc_dut_i/ctrlComm_0/dout[0]}]
set_property MARK_DEBUG true [get_nets {soc_dut_i/ctrlComm_0/din[1]}]
set_property MARK_DEBUG true [get_nets {soc_dut_i/ctrlComm_0/din[0]}]
set_property MARK_DEBUG true [get_nets {soc_dut_i/ctrlComm_0/dout[3]}]
set_property MARK_DEBUG true [get_nets {soc_dut_i/ctrlComm_0/dout[2]}]
set_property MARK_DEBUG true [get_nets {soc_dut_i/ctrlComm_0/din[3]}]
set_property MARK_DEBUG true [get_nets soc_dut_i/ctrlComm_0/do_valid]
set_property MARK_DEBUG true [get_nets {soc_dut_i/ctrlComm_0/din[2]}]
create_debug_core u_ila_0 ila
set_property ALL_PROBE_SAME_MU true [get_debug_cores u_ila_0]
set_property ALL_PROBE_SAME_MU_CNT 1 [get_debug_cores u_ila_0]
set_property C_ADV_TRIGGER false [get_debug_cores u_ila_0]
set_property C_DATA_DEPTH 1024 [get_debug_cores u_ila_0]
set_property C_EN_STRG_QUAL false [get_debug_cores u_ila_0]
set_property C_INPUT_PIPE_STAGES 0 [get_debug_cores u_ila_0]
set_property C_TRIGIN_EN false [get_debug_cores u_ila_0]
set_property C_TRIGOUT_EN false [get_debug_cores u_ila_0]
set_property port_width 1 [get_debug_ports u_ila_0/clk]
connect_debug_port u_ila_0/clk [get_nets [list soc_dut_i/processing_system7_0/inst/FCLK_CLK1]]
set_property PROBE_TYPE DATA_AND_TRIGGER [get_debug_ports u_ila_0/probe0]
set_property port_width 128 [get_debug_ports u_ila_0/probe0]
connect_debug_port u_ila_0/probe0 [get_nets [list {soc_dut_i/cryptoWrapper_0/s_axis_pdi_tdata[0]} {soc_dut_i/cryptoWrapper_0/s_axis_pdi_tdata[1]} {soc_dut_i/cryptoWrapper_0/s_axis_pdi_tdata[2]} {soc_dut_i/cryptoWrapper_0/s_axis_pdi_tdata[3]} {soc_dut_i/cryptoWrapper_0/s_axis_pdi_tdata[4]} {soc_dut_i/cryptoWrapper_0/s_axis_pdi_tdata[5]} {soc_dut_i/cryptoWrapper_0/s_axis_pdi_tdata[6]} {soc_dut_i/cryptoWrapper_0/s_axis_pdi_tdata[7]} {soc_dut_i/cryptoWrapper_0/s_axis_pdi_tdata[8]} {soc_dut_i/cryptoWrapper_0/s_axis_pdi_tdata[9]} {soc_dut_i/cryptoWrapper_0/s_axis_pdi_tdata[10]} {soc_dut_i/cryptoWrapper_0/s_axis_pdi_tdata[11]} {soc_dut_i/cryptoWrapper_0/s_axis_pdi_tdata[12]} {soc_dut_i/cryptoWrapper_0/s_axis_pdi_tdata[13]} {soc_dut_i/cryptoWrapper_0/s_axis_pdi_tdata[14]} {soc_dut_i/cryptoWrapper_0/s_axis_pdi_tdata[15]} {soc_dut_i/cryptoWrapper_0/s_axis_pdi_tdata[16]} {soc_dut_i/cryptoWrapper_0/s_axis_pdi_tdata[17]} {soc_dut_i/cryptoWrapper_0/s_axis_pdi_tdata[18]} {soc_dut_i/cryptoWrapper_0/s_axis_pdi_tdata[19]} {soc_dut_i/cryptoWrapper_0/s_axis_pdi_tdata[20]} {soc_dut_i/cryptoWrapper_0/s_axis_pdi_tdata[21]} {soc_dut_i/cryptoWrapper_0/s_axis_pdi_tdata[22]} {soc_dut_i/cryptoWrapper_0/s_axis_pdi_tdata[23]} {soc_dut_i/cryptoWrapper_0/s_axis_pdi_tdata[24]} {soc_dut_i/cryptoWrapper_0/s_axis_pdi_tdata[25]} {soc_dut_i/cryptoWrapper_0/s_axis_pdi_tdata[26]} {soc_dut_i/cryptoWrapper_0/s_axis_pdi_tdata[27]} {soc_dut_i/cryptoWrapper_0/s_axis_pdi_tdata[28]} {soc_dut_i/cryptoWrapper_0/s_axis_pdi_t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
/cryptoWrapper_0/s_axis_pdi_tdata[121]} {soc_dut_i/cryptoWrapper_0/s_axis_pdi_tdata[122]} {soc_dut_i/cryptoWrapper_0/s_axis_pdi_tdata[123]} {soc_dut_i/cryptoWrapper_0/s_axis_pdi_tdata[124]} {soc_dut_i/cryptoWrapper_0/s_axis_pdi_tdata[125]} {soc_dut_i/cryptoWrapper_0/s_axis_pdi_tdata[126]} {soc_dut_i/cryptoWrapper_0/s_axis_pdi_tdata[127]}]]
create_debug_core u_ila_1 ila
set_property ALL_PROBE_SAME_MU true [get_debug_cores u_ila_1]
set_property ALL_PROBE_SAME_MU_CNT 1 [get_debug_cores u_ila_1]
set_property C_ADV_TRIGGER false [get_debug_cores u_ila_1]
set_property C_DATA_DEPTH 1024 [get_debug_cores u_ila_1]
set_property C_EN_STRG_QUAL false [get_debug_cores u_ila_1]
set_property C_INPUT_PIPE_STAGES 0 [get_debug_cores u_ila_1]
set_property C_TRIGIN_EN false [get_debug_cores u_ila_1]
set_property C_TRIGOUT_EN false [get_debug_cores u_ila_1]
set_property port_width 1 [get_debug_ports u_ila_1/clk]
connect_debug_port u_ila_1/clk [get_nets [list soc_dut_i/processing_system7_0/inst/FCLK_CLK0]]
set_property PROBE_TYPE DATA_AND_TRIGGER [get_debug_ports u_ila_1/probe0]
set_property port_width 4 [get_debug_ports u_ila_1/probe0]
connect_debug_port u_ila_1/probe0 [get_nets [list {soc_dut_i/ctrlComm_0/din[0]} {soc_dut_i/ctrlComm_0/din[1]} {soc_dut_i/ctrlComm_0/din[2]} {soc_dut_i/ctrlComm_0/din[3]}]]
create_debug_port u_ila_0 probe
set_property PROBE_TYPE DATA_AND_TRIGGER [get_debug_ports u_ila_0/probe1]
set_property port_width 128 [get_debug_ports u_ila_0/probe1]
connect_debug_port u_ila_0/probe1 [get_nets [list {soc_dut_i/cryptoWrapper_0/s_axis_sdi_tdata[0]} {soc_dut_i/cryptoWrapper_0/s_axis_sdi_tdata[1]} {soc_dut_i/cryptoWrapper_0/s_axis_sdi_tdata[2]} {soc_dut_i/cryptoWrapper_0/s_axis_sdi_tdata[3]} {soc_dut_i/cryptoWrapper_0/s_axis_sdi_tdata[4]} {soc_dut_i/cryptoWrapper_0/s_axis_sdi_tdata[5]} {soc_dut_i/cryptoWrapper_0/s_axis_sdi_tdata[6]} {soc_dut_i/cryptoWrapper_0/s_axis_sdi_tdata[7]} {soc_dut_i/cryptoWrapper_0/s_axis_sdi_tdata[8]} {soc_dut_i/cryptoWrapper_0/s_axis_sdi_tdata[9]} {soc_dut_i/cryptoWrapper_0/s_axis_sdi_tdata[10]} {soc_dut_i/cryptoWrapper_0/s_axis_sdi_tdata[11]} {soc_dut_i/cryptoWrapper_0/s_axis_sdi_tdata[12]} {soc_dut_i/cryptoWrapper_0/s_axis_sdi_tdata[13]} {soc_dut_i/cryptoWrapper_0/s_axis_sdi_tdata[14]} {soc_dut_i/cryptoWrapper_0/s_axis_sdi_tdata[15]} {soc_dut_i/cryptoWrapper_0/s_axis_sdi_tdata[16]} {soc_dut_i/cryptoWrapper_0/s_axis_sdi_tdata[17]} {soc_dut_i/cryptoWrapper_0/s_axis_sdi_tdata[18]} {soc_dut_i/cryptoWrapper_0/s_axis_sdi_tdata[19]} {soc_dut_i/cryptoWrapper_0/s_axis_sdi_tdata[20]} {soc_dut_i/cryptoWrapper_0/s_axis_sdi_tdata[21]} {soc_dut_i/cryptoWrapper_0/s_axis_sdi_tdata[22]} {soc_dut_i/cryptoWrapper_0/s_axis_sdi_tdata[23]} {soc_dut_i/cryptoWrapper_0/s_axis_sdi_tdata[24]} {soc_dut_i/cryptoWrapper_0/s_axis_sdi_tdata[25]} {soc_dut_i/cryptoWrapper_0/s_axis_sdi_tdata[26]} {soc_dut_i/cryptoWrapper_0/s_axis_sdi_tdata[27]} {soc_dut_i/cryptoWrapper_0/s_axis_sdi_tdata[28]} {soc_dut_i/cryptoWrapper_0/s_axis_sdi_t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
/cryptoWrapper_0/s_axis_sdi_tdata[121]} {soc_dut_i/cryptoWrapper_0/s_axis_sdi_tdata[122]} {soc_dut_i/cryptoWrapper_0/s_axis_sdi_tdata[123]} {soc_dut_i/cryptoWrapper_0/s_axis_sdi_tdata[124]} {soc_dut_i/cryptoWrapper_0/s_axis_sdi_tdata[125]} {soc_dut_i/cryptoWrapper_0/s_axis_sdi_tdata[126]} {soc_dut_i/cryptoWrapper_0/s_axis_sdi_tdata[127]}]]
create_debug_port u_ila_0 probe
set_property PROBE_TYPE DATA_AND_TRIGGER [get_debug_ports u_ila_0/probe2]
set_property port_width 128 [get_debug_ports u_ila_0/probe2]
connect_debug_port u_ila_0/probe2 [get_nets [list {soc_dut_i/cryptoWrapper_0/m_axis_do_tdata[0]} {soc_dut_i/cryptoWrapper_0/m_axis_do_tdata[1]} {soc_dut_i/cryptoWrapper_0/m_axis_do_tdata[2]} {soc_dut_i/cryptoWrapper_0/m_axis_do_tdata[3]} {soc_dut_i/cryptoWrapper_0/m_axis_do_tdata[4]} {soc_dut_i/cryptoWrapper_0/m_axis_do_tdata[5]} {soc_dut_i/cryptoWrapper_0/m_axis_do_tdata[6]} {soc_dut_i/cryptoWrapper_0/m_axis_do_tdata[7]} {soc_dut_i/cryptoWrapper_0/m_axis_do_tdata[8]} {soc_dut_i/cryptoWrapper_0/m_axis_do_tdata[9]} {soc_dut_i/cryptoWrapper_0/m_axis_do_tdata[10]} {soc_dut_i/cryptoWrapper_0/m_axis_do_tdata[11]} {soc_dut_i/cryptoWrapper_0/m_axis_do_tdata[12]} {soc_dut_i/cryptoWrapper_0/m_axis_do_tdata[13]} {soc_dut_i/cryptoWrapper_0/m_axis_do_tdata[14]} {soc_dut_i/cryptoWrapper_0/m_axis_do_tdata[15]} {soc_dut_i/cryptoWrapper_0/m_axis_do_tdata[16]} {soc_dut_i/cryptoWrapper_0/m_axis_do_tdata[17]} {soc_dut_i/cryptoWrapper_0/m_axis_do_tdata[18]} {soc_dut_i/cryptoWrapper_0/m_axis_do_tdata[19]} {soc_dut_i/cryptoWrapper_0/m_axis_do_tdata[20]} {soc_dut_i/cryptoWrapper_0/m_axis_do_tdata[21]} {soc_dut_i/cryptoWrapper_0/m_axis_do_tdata[22]} {soc_dut_i/cryptoWrapper_0/m_axis_do_tdata[23]} {soc_dut_i/cryptoWrapper_0/m_axis_do_tdata[24]} {soc_dut_i/cryptoWrapper_0/m_axis_do_tdata[25]} {soc_dut_i/cryptoWrapper_0/m_axis_do_tdata[26]} {soc_dut_i/cryptoWrapper_0/m_axis_do_tdata[27]} {soc_dut_i/cryptoWrapper_0/m_axis_do_tdata[28]} {soc_dut_i/cryptoWrapper_0/m_axis_do_tdata[29]} {soc_dut_i/cryptoWra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
_do_tdata[123]} {soc_dut_i/cryptoWrapper_0/m_axis_do_tdata[124]} {soc_dut_i/cryptoWrapper_0/m_axis_do_tdata[125]} {soc_dut_i/cryptoWrapper_0/m_axis_do_tdata[126]} {soc_dut_i/cryptoWrapper_0/m_axis_do_tdata[127]}]]
create_debug_port u_ila_0 probe
set_property PROBE_TYPE DATA_AND_TRIGGER [get_debug_ports u_ila_0/probe3]
set_property port_width 1 [get_debug_ports u_ila_0/probe3]
connect_debug_port u_ila_0/probe3 [get_nets [list soc_dut_i/cryptoWrapper_0/m_axis_do_tvalid]]
create_debug_port u_ila_0 probe
set_property PROBE_TYPE DATA_AND_TRIGGER [get_debug_ports u_ila_0/probe4]
set_property port_width 1 [get_debug_ports u_ila_0/probe4]
connect_debug_port u_ila_0/probe4 [get_nets [list soc_dut_i/cryptoWrapper_0/s_axis_pdi_tvalid]]
create_debug_port u_ila_0 probe
set_property PROBE_TYPE DATA_AND_TRIGGER [get_debug_ports u_ila_0/probe5]
set_property port_width 1 [get_debug_ports u_ila_0/probe5]
connect_debug_port u_ila_0/probe5 [get_nets [list soc_dut_i/cryptoWrapper_0/s_axis_sdi_tvalid]]
create_debug_port u_ila_1 probe
set_property PROBE_TYPE DATA_AND_TRIGGER [get_debug_ports u_ila_1/probe1]
set_property port_width 4 [get_debug_ports u_ila_1/probe1]
connect_debug_port u_ila_1/probe1 [get_nets [list {soc_dut_i/ctrlComm_0/dout[0]} {soc_dut_i/ctrlComm_0/dout[1]} {soc_dut_i/ctrlComm_0/dout[2]} {soc_dut_i/ctrlComm_0/dout[3]}]]
create_debug_port u_ila_1 probe
set_property PROBE_TYPE DATA_AND_TRIGGER [get_debug_ports u_ila_1/probe2]
set_property port_width 1 [get_debug_ports u_ila_1/probe2]
connect_debug_port u_ila_1/probe2 [get_nets [list soc_dut_i/ctrlComm_0/di_ready]]
create_debug_port u_ila_1 probe
set_property PROBE_TYPE DATA_AND_TRIGGER [get_debug_ports u_ila_1/probe3]
set_property port_width 1 [get_debug_ports u_ila_1/probe3]
connect_debug_port u_ila_1/probe3 [get_nets [list soc_dut_i/ctrlComm_0/di_valid]]
create_debug_port u_ila_1 probe
set_property PROBE_TYPE DATA_AND_TRIGGER [get_debug_ports u_ila_1/probe4]
set_property port_width 1 [get_debug_ports u_ila_1/probe4]
connect_debug_port u_ila_1/probe4 [get_nets [list soc_dut_i/ctrlComm_0/do_ready]]
create_debug_port u_ila_1 probe
set_property PROBE_TYPE DATA_AND_TRIGGER [get_debug_ports u_ila_1/probe5]
set_property port_width 1 [get_debug_ports u_ila_1/probe5]
connect_debug_port u_ila_1/probe5 [get_nets [list soc_dut_i/ctrlComm_0/do_valid]]
set_property C_CLK_INPUT_FREQ_HZ 300000000 [get_debug_cores dbg_hub]
set_property C_ENABLE_CLK_DIVIDER false [get_debug_cores dbg_hub]
set_property C_USER_SCAN_CHAIN 1 [get_debug_cores dbg_hub]
connect_debug_port dbg_hub/clk [get_nets u_ila_1_FCLK_CLK0]
