kammoh/fobos/dut/soc_wrapper/vivado/src/constr/debug.xdc

set_property MARK_DEBUG true [get_nets soc_dut_i/dutcomm_0_di_valid]
set_property MARK_DEBUG true [get_nets {soc_dut_i/ctrlComm_0_dout[2]}]
set_property MARK_DEBUG true [get_nets {soc_dut_i/ctrlComm_0_dout[1]}]
set_property MARK_DEBUG true [get_nets {soc_dut_i/dutcomm_0_din[3]}]
set_property MARK_DEBUG true [get_nets {soc_dut_i/dutcomm_0_din[2]}]
set_property MARK_DEBUG true [get_nets soc_dut_i/ctrlComm_0_di_ready]
set_property MARK_DEBUG true [get_nets {soc_dut_i/ctrlComm_0_dout[3]}]
set_property MARK_DEBUG true [get_nets soc_dut_i/dutcomm_0_do_ready]
set_property MARK_DEBUG true [get_nets {soc_dut_i/dutcomm_0_din[1]}]
set_property MARK_DEBUG true [get_nets soc_dut_i/ctrlComm_0_do_valid]
set_property MARK_DEBUG true [get_nets {soc_dut_i/dutcomm_0_din[0]}]
set_property MARK_DEBUG true [get_nets {soc_dut_i/ctrlComm_0_dout[0]}]
set_property MARK_DEBUG true [get_nets soc_dut_i/dutcomm_0/snd_start]


set_property MARK_DEBUG true [get_nets {soc_dut_i/dutcomm_0_M_AXIS_TDATA[9]}]
set_property MARK_DEBUG true [get_nets {soc_dut_i/dutcomm_0_M_AXIS_TDATA[7]}]
set_property MARK_DEBUG true [get_nets {soc_dut_i/dutcomm_0_M_AXIS_TDATA[14]}]
set_property MARK_DEBUG true [get_nets {soc_dut_i/dutcomm_0_M_AXIS_TDATA[22]}]
set_property MARK_DEBUG true [get_nets {soc_dut_i/dutcomm_0_M_AXIS_TDATA[29]}]
set_property MARK_DEBUG true [get_nets {soc_dut_i/dutcomm_0_M_AXIS_TDATA[31]}]
set_property MARK_DEBUG true [get_nets {soc_dut_i/dutcomm_0_M_AXIS_TDATA[21]}]
set_property MARK_DEBUG true [get_nets {soc_dut_i/dutcomm_0_M_AXIS_TDATA[24]}]
set_property MARK_DEBUG true [get_nets {soc_dut_i/dutcomm_0_M_AXIS_TDATA[23]}]
set_property MARK_DEBUG true [get_nets {soc_dut_i/dutcomm_0_M_AXIS_TDATA[26]}]
set_property MARK_DEBUG true [get_nets {soc_dut_i/dutcomm_0_M_AXIS_TDATA[25]}]
set_property MARK_DEBUG true [get_nets {soc_dut_i/dutcomm_0_M_AXIS_TDATA[28]}]
set_property MARK_DEBUG true [get_nets {soc_dut_i/dutcomm_0_M_AXIS_TDATA[13]}]
set_property MARK_DEBUG true [get_nets {soc_dut_i/dutcomm_0_M_AXIS_TDATA[15]}]
set_property MARK_DEBUG true [get_nets {soc_dut_i/dutcomm_0_M_AXIS_TDATA[18]}]
set_property MARK_DEBUG true [get_nets {soc_dut_i/dutcomm_0_M_AXIS_TDATA[17]}]
set_property MARK_DEBUG true [get_nets {soc_dut_i/dutcomm_0_M_AXIS_TDATA[20]}]
set_property MARK_DEBUG true [get_nets {soc_dut_i/dutcomm_0_M_AXIS_TDATA[19]}]
set_property MARK_DEBUG true [get_nets {soc_dut_i/dutcomm_0_M_AXIS_TDATA[3]}]
set_property MARK_DEBUG true [get_nets {soc_dut_i/dutcomm_0_M_AXIS_TDATA[1]}]
set_property MARK_DEBUG true [get_nets {soc_dut_i/dutcomm_0_M_AXIS_TDATA[0]}]
set_property MARK_DEBUG true [get_nets {soc_dut_i/dutcomm_0_M_AXIS_TDATA[27]}]
set_property MARK_DEBUG true [get_nets {soc_dut_i/dutcomm_0_M_AXIS_TDATA[11]}]
set_property MARK_DEBUG true [get_nets {soc_dut_i/dutcomm_0_M_AXIS_TDATA[12]}]
set_property MARK_DEBUG true [get_nets {soc_dut_i/dutcomm_0_M_AXIS_TDATA[8]}]
set_property MARK_DEBUG true [get_nets {soc_dut_i/dutcomm_0_M_AXIS_TDATA[10]}]
set_property MARK_DEBUG true [get_nets {soc_dut_i/dutcomm_0_M_AXIS_TDATA[4]}]
set_property MARK_DEBUG true [get_nets {soc_dut_i/dutcomm_0_M_AXIS_TDATA[2]}]
set_property MARK_DEBUG true [get_nets {soc_dut_i/dutcomm_0_M_AXIS_TDATA[5]}]
set_property MARK_DEBUG true [get_nets {soc_dut_i/dutcomm_0_M_AXIS_TDATA[6]}]
set_property MARK_DEBUG true [get_nets {soc_dut_i/dutcomm_0_M_AXIS_TDATA[30]}]
set_property MARK_DEBUG true [get_nets {soc_dut_i/dutcomm_0_M_AXIS_TDATA[16]}]
set_property MARK_DEBUG true [get_nets soc_dut_i/dutcomm_0_M_AXIS_TVALID]
set_property MARK_DEBUG true [get_nets soc_dut_i/dutcomm_0_M_AXIS_TREADY]
set_property MARK_DEBUG true [get_nets soc_dut_i/dutcomm_0_M_AXIS_TLAST]

set_property MARK_DEBUG true [get_nets soc_dut_i/ctrlComm_0/U0/res_ready]
connect_debug_port u_ila_0/probe0 [get_nets [list {soc_dut_i/dutcomm_0_M_AXIS_TDATA[4]} {soc_dut_i/dutcomm_0_M_AXIS_TDATA[5]} {soc_dut_i/dutcomm_0_M_AXIS_TDATA[6]} {soc_dut_i/dutcomm_0_M_AXIS_TDATA[7]} {soc_dut_i/dutcomm_0_M_AXIS_TDATA[8]} {soc_dut_i/dutcomm_0_M_AXIS_TDATA[9]} {soc_dut_i/dutcomm_0_M_AXIS_TDATA[10]} {soc_dut_i/dutcomm_0_M_AXIS_TDATA[11]} {soc_dut_i/dutcomm_0_M_AXIS_TDATA[12]} {soc_dut_i/dutcomm_0_M_AXIS_TDATA[13]} {soc_dut_i/dutcomm_0_M_AXIS_TDATA[14]} {soc_dut_i/dutcomm_0_M_AXIS_TDATA[15]} {soc_dut_i/dutcomm_0_M_AXIS_TDATA[16]} {soc_dut_i/dutcomm_0_M_AXIS_TDATA[17]} {soc_dut_i/dutcomm_0_M_AXIS_TDATA[18]} {soc_dut_i/dutcomm_0_M_AXIS_TDATA[19]} {soc_dut_i/dutcomm_0_M_AXIS_TDATA[20]} {soc_dut_i/dutcomm_0_M_AXIS_TDATA[21]} {soc_dut_i/dutcomm_0_M_AXIS_TDATA[22]} {soc_dut_i/dutcomm_0_M_AXIS_TDATA[23]} {soc_dut_i/dutcomm_0_M_AXIS_TDATA[24]} {soc_dut_i/dutcomm_0_M_AXIS_TDATA[25]} {soc_dut_i/dutcomm_0_M_AXIS_TDATA[26]} {soc_dut_i/dutcomm_0_M_AXIS_TDATA[27]} {soc_dut_i/dutcomm_0_M_AXIS_TDATA[28]} {soc_dut_i/dutcomm_0_M_AXIS_TDATA[29]} {soc_dut_i/dutcomm_0_M_AXIS_TDATA[30]} {soc_dut_i/dutcomm_0_M_AXIS_TDATA[31]}]]
connect_debug_port u_ila_0/probe1 [get_nets [list {soc_dut_i/dutcomm_0_din[0]} {soc_dut_i/dutcomm_0_din[1]} {soc_dut_i/dutcomm_0_din[2]} {soc_dut_i/dutcomm_0_din[3]}]]
connect_debug_port u_ila_0/probe2 [get_nets [list {soc_dut_i/ctrlComm_0_dout[0]} {soc_dut_i/ctrlComm_0_dout[1]} {soc_dut_i/ctrlComm_0_dout[2]} {soc_dut_i/ctrlComm_0_dout[3]}]]
connect_debug_port u_ila_0/probe4 [get_nets [list soc_dut_i/ctrlComm_0_di_ready]]
connect_debug_port u_ila_0/probe5 [get_nets [list soc_dut_i/ctrlComm_0_do_valid]]
connect_debug_port u_ila_0/probe9 [get_nets [list soc_dut_i/dutcomm_0_di_valid]]
connect_debug_port u_ila_0/probe10 [get_nets [list soc_dut_i/dutcomm_0_do_ready]]
connect_debug_port u_ila_0/probe11 [get_nets [list soc_dut_i/dutcomm_0_M_AXIS_TLAST]]
connect_debug_port u_ila_0/probe12 [get_nets [list soc_dut_i/dutcomm_0_M_AXIS_TREADY]]
connect_debug_port u_ila_0/probe13 [get_nets [list soc_dut_i/dutcomm_0_M_AXIS_TVALID]]
connect_debug_port u_ila_0/probe15 [get_nets [list soc_dut_i/dutcomm_0/snd_start]]

set_property MARK_DEBUG false [get_nets {soc_dut_i/ctrlComm_0_M_AXIS_TDATA[15]}]
set_property MARK_DEBUG false [get_nets {soc_dut_i/ctrlComm_0_M_AXIS_TDATA[14]}]
set_property MARK_DEBUG false [get_nets {soc_dut_i/ctrlComm_0_M_AXIS_TDATA[18]}]
set_property MARK_DEBUG false [get_nets {soc_dut_i/ctrlComm_0_M_AXIS_TDATA[24]}]
set_property MARK_DEBUG false [get_nets {soc_dut_i/ctrlComm_0_M_AXIS_TDATA[3]}]
set_property MARK_DEBUG false [get_nets {soc_dut_i/ctrlComm_0_M_AXIS_TDATA[21]}]
set_property MARK_DEBUG false [get_nets {soc_dut_i/ctrlComm_0_M_AXIS_TDATA[5]}]
set_property MARK_DEBUG false [get_nets {soc_dut_i/ctrlComm_0_M_AXIS_TDATA[2]}]
set_property MARK_DEBUG false [get_nets {soc_dut_i/ctrlComm_0_M_AXIS_TDATA[7]}]
set_property MARK_DEBUG false [get_nets {soc_dut_i/ctrlComm_0_M_AXIS_TDATA[26]}]
set_property MARK_DEBUG false [get_nets {soc_dut_i/ctrlComm_0_M_AXIS_TDATA[13]}]
set_property MARK_DEBUG false [get_nets {soc_dut_i/ctrlComm_0_M_AXIS_TDATA[8]}]
set_property MARK_DEBUG false [get_nets {soc_dut_i/ctrlComm_0_M_AXIS_TDATA[23]}]
set_property MARK_DEBUG false [get_nets {soc_dut_i/ctrlComm_0_M_AXIS_TDATA[17]}]
set_property MARK_DEBUG false [get_nets {soc_dut_i/ctrlComm_0_M_AXIS_TDATA[16]}]
set_property MARK_DEBUG false [get_nets {soc_dut_i/ctrlComm_0_M_AXIS_TDATA[22]}]
set_property MARK_DEBUG false [get_nets {soc_dut_i/ctrlComm_0_M_AXIS_TDATA[20]}]
set_property MARK_DEBUG false [get_nets {soc_dut_i/ctrlComm_0_M_AXIS_TDATA[6]}]
set_property MARK_DEBUG false [get_nets {soc_dut_i/ctrlComm_0_M_AXIS_TDATA[29]}]
set_property MARK_DEBUG false [get_nets {soc_dut_i/ctrlComm_0_M_AXIS_TDATA[28]}]
set_property MARK_DEBUG false [get_nets {soc_dut_i/ctrlComm_0_M_AXIS_TDATA[19]}]
set_property MARK_DEBUG false [get_nets {soc_dut_i/ctrlComm_0_M_AXIS_TDATA[30]}]
set_property MARK_DEBUG false [get_nets {soc_dut_i/ctrlComm_0_M_AXIS_TDATA[1]}]
set_property MARK_DEBUG false [get_nets {soc_dut_i/ctrlComm_0_M_AXIS_TDATA[25]}]
set_property MARK_DEBUG false [get_nets {soc_dut_i/ctrlComm_0_M_AXIS_TDATA[0]}]
set_property MARK_DEBUG false [get_nets soc_dut_i/ctrlComm_0_M_AXIS_TREADY]
set_property MARK_DEBUG false [get_nets {soc_dut_i/ctrlComm_0_M_AXIS_TDATA[31]}]
set_property MARK_DEBUG false [get_nets {soc_dut_i/ctrlComm_0_M_AXIS_TDATA[27]}]
set_property MARK_DEBUG false [get_nets soc_dut_i/ctrlComm_0_M_AXIS_TLAST]
set_property MARK_DEBUG false [get_nets soc_dut_i/ctrlComm_0_M_AXIS_TVALID]
set_property MARK_DEBUG false [get_nets {soc_dut_i/ctrlComm_0_M_AXIS_TDATA[4]}]
set_property MARK_DEBUG false [get_nets {soc_dut_i/ctrlComm_0_M_AXIS_TDATA[10]}]
set_property MARK_DEBUG false [get_nets {soc_dut_i/ctrlComm_0_M_AXIS_TDATA[12]}]
set_property MARK_DEBUG false [get_nets {soc_dut_i/ctrlComm_0_M_AXIS_TDATA[9]}]
set_property MARK_DEBUG false [get_nets {soc_dut_i/ctrlComm_0_M_AXIS_TDATA[11]}]
set_property MARK_DEBUG true [get_nets soc_dut_i/di_ready]
set_property MARK_DEBUG true [get_nets soc_dut_i/do_valid]
set_property MARK_DEBUG true [get_nets {soc_dut_i/din[3]}]
set_property MARK_DEBUG true [get_nets {soc_dut_i/din[2]}]
set_property MARK_DEBUG true [get_nets {soc_dut_i/din[1]}]
set_property MARK_DEBUG true [get_nets {soc_dut_i/din[0]}]
set_property MARK_DEBUG true [get_nets soc_dut_i/di_valid]
set_property MARK_DEBUG true [get_nets soc_dut_i/do_ready]
