kammoh/fobos/control/pynqctrl/vivado/src/constr/debug.xdc

####set_property MARK_DEBUG false [get_nets ctrl_top_i/dutcomm_0/s_axi_awvalid]
###set_property MARK_DEBUG false [get_nets ctrl_top_i/dutcomm_0/s_axi_aresetn]
###set_property MARK_DEBUG false [get_nets {ctrl_top_i/dutcomm_0/s_axi_wdata[0]}]
###set_property MARK_DEBUG false [get_nets {ctrl_top_i/dutcomm_0/s_axi_rdata[29]}]
###set_property MARK_DEBUG false [get_nets {ctrl_top_i/dutcomm_0/s_axi_rdata[25]}]
###set_property MARK_DEBUG false [get_nets {ctrl_top_i/dutcomm_0/s_axi_wdata[20]}]
###set_property MARK_DEBUG false [get_nets {ctrl_top_i/dutcomm_0/s_axi_wdata[4]}]
###set_property MARK_DEBUG false [get_nets {ctrl_top_i/dutcomm_0/s_axi_wdata[7]}]
###set_property MARK_DEBUG false [get_nets {ctrl_top_i/dutcomm_0/s_axi_wdata[16]}]
###set_property MARK_DEBUG false [get_nets {ctrl_top_i/dutcomm_0/s_axi_rdata[5]}]
###set_property MARK_DEBUG false [get_nets {ctrl_top_i/dutcomm_0/s_axi_rdata[13]}]
###set_property MARK_DEBUG false [get_nets {ctrl_top_i/dutcomm_0/s_axi_rdata[17]}]
###set_property MARK_DEBUG false [get_nets {ctrl_top_i/dutcomm_0/s_axi_rdata[1]}]
###set_property MARK_DEBUG false [get_nets ctrl_top_i/dutcomm_0/m_axis_aclk]
###set_property MARK_DEBUG false [get_nets {ctrl_top_i/dutcomm_0/s_axi_wdata[23]}]
###set_property MARK_DEBUG false [get_nets {ctrl_top_i/dutcomm_0/s_axi_wdata[11]}]
###set_property MARK_DEBUG false [get_nets {ctrl_top_i/dutcomm_0/s_axi_rdata[4]}]
###set_property MARK_DEBUG false [get_nets {ctrl_top_i/dutcomm_0/s_axi_rdata[16]}]
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
###set_property MARK_DEBUG true [get_nets {ctrl_top_i/dutcomm_0/U0/s_axis_tdata[14]}]
###set_property MARK_DEBUG true [get_nets {ctrl_top_i/dutcomm_0/U0/s_axis_tdata[17]}]
###set_property MARK_DEBUG true [get_nets {ctrl_top_i/dutcomm_0/U0/s_axis_tdata[20]}]



###create_debug_core u_ila_0 ila
###set_property ALL_PROBE_SAME_MU true [get_debug_cores u_ila_0]
###set_property ALL_PROBE_SAME_MU_CNT 1 [get_debug_cores u_ila_0]
###set_property C_ADV_TRIGGER false [get_debug_cores u_ila_0]
###set_property C_DATA_DEPTH 1024 [get_debug_cores u_ila_0]
###set_property C_EN_STRG_QUAL false [get_debug_cores u_ila_0]
###set_property C_INPUT_PIPE_STAGES 0 [get_debug_cores u_ila_0]
###set_property C_TRIGIN_EN false [get_debug_cores u_ila_0]
###set_property C_TRIGOUT_EN false [get_debug_cores u_ila_0]
###set_property port_width 1 [get_debug_ports u_ila_0/clk]
###connect_debug_port u_ila_0/clk [get_nets [list ctrl_top_i/processing_system7_0/inst/FCLK_CLK1]]
###set_property PROBE_TYPE DATA_AND_TRIGGER [get_debug_ports u_ila_0/probe0]
###set_property port_width 4 [get_debug_ports u_ila_0/probe0]
###connect_debug_port u_ila_0/probe0 [get_nets [list {ctrl_top_i/dutcomm_0/U0/din[0]} {ctrl_top_i/dutcomm_0/U0/din[1]} {ctrl_top_i/dutcomm_0/U0/din[2]} {ctrl_top_i/dutcomm_0/U0/din[3]}]]
###create_debug_port u_ila_0 probe
###set_property PROBE_TYPE DATA_AND_TRIGGER [get_debug_ports u_ila_0/probe1]
###set_property port_width 28 [get_debug_ports u_ila_0/probe1]
###connect_debug_port u_ila_0/probe1 [get_nets [list {ctrl_top_i/dutcomm_0/U0/m_axis_tdata[0]} {ctrl_top_i/dutcomm_0/U0/m_axis_tdata[1]} {ctrl_top_i/dutcomm_0/U0/m_axis_tdata[2]} {ctrl_top_i/dutcomm_0/U0/m_axis_tdata[3]} {ctrl_top_i/dutcomm_0/U0/m_axis_tdata[4]} {ctrl_top_i/dutcomm_0/U0/m_axis_tdata[5]} {ctrl_top_i/dutcomm_0/U0/m_axis_tdata[6]} {ctrl_top_i/dutcomm_0/U0/m_axis_tdata[7]} {ctrl_top_i/dutcomm_0/U0/m_axis_tdata[8]} {ctrl_top_i/dutcomm_0/U0/m_axis_tdata[9]} {ctrl_top_i/dutcomm_0/U0/m_axis_tdata[10]} {ctrl_top_i/dutcomm_0/U0/m_axis_tdata[11]} {ctrl_top_i/dutcomm_0/U0/m_axis_tdata[12]} {ctrl_top_i/dutcomm_0/U0/m_axis_tdata[13]} {ctrl_top_i/dutcomm_0/U0/m_axis_tdata[14]} {ctrl_top_i/dutcomm_0/U0/m_axis_tdata[15]} {ctrl_top_i/dutcomm_0/U0/m_axis_tdata[16]} {ctrl_top_i/dutcomm_0/U0/m_axis_tdata[17]} {ctrl_top_i/dutcomm_0/U0/m_axis_tdata[18]} {ctrl_top_i/dutcomm_0/U0/m_axis_tdata[19]} {ctrl_top_i/dutcomm_0/U0/m_axis_tdata[20]} {ctrl_top_i/dutcomm_0/U0/m_axis_tdata[21]} {ctrl_top_i/dutcomm_0/U0/m_axis_tdata[22]} {ctrl_top_i/dutcomm_0/U0/m_axis_tdata[23]} {ctrl_top_i/dutcomm_0/U0/m_axis_tdata[24]} {ctrl_top_i/dutcomm_0/U0/m_axis_tdata[25]} {ctrl_top_i/dutcomm_0/U0/m_axis_tdata[26]} {ctrl_top_i/dutcomm_0/U0/m_axis_tdata[27]}]]
###create_debug_port u_ila_0 probe
###set_property PROBE_TYPE DATA_AND_TRIGGER [get_debug_ports u_ila_0/probe2]
###set_property port_width 32 [get_debug_ports u_ila_0/probe2]
###connect_debug_port u_ila_0/probe2 [get_nets [list {ctrl_top_i/dutcomm_0/U0/s_axis_tdata[0]} {ctrl_top_i/dutcomm_0/U0/s_axis_tdata[1]} {ctrl_top_i/dutcomm_0/U0/s_axis_tdata[2]} {ctrl_top_i/dutcomm_0/U0/s_axis_tdata[3]} {ctrl_top_i/dutcomm_0/U0/s_axis_tdata[4]} {ctrl_top_i/dutcomm_0/U0/s_axis_tdata[5]} {ctrl_top_i/dutcomm_0/U0/s_axis_tdata[6]} {ctrl_top_i/dutcomm_0/U0/s_axis_tdata[7]} {ctrl_top_i/dutcomm_0/U0/s_axis_tdata[8]} {ctrl_top_i/dutcomm_0/U0/s_axis_tdata[9]} {ctrl_top_i/dutcomm_0/U0/s_axis_tdata[10]} {ctrl_top_i/dutcomm_0/U0/s_axis_tdata[11]} {ctrl_top_i/dutcomm_0/U0/s_axis_tdata[12]} {ctrl_top_i/dutcomm_0/U0/s_axis_tdata[13]} {ctrl_top_i/dutcomm_0/U0/s_axis_tdata[14]} {ctrl_top_i/dutcomm_0/U0/s_axis_tdata[15]} {ctrl_top_i/dutcomm_0/U0/s_axis_tdata[16]} {ctrl_top_i/dutcomm_0/U0/s_axis_tdata[17]} {ctrl_top_i/dutcomm_0/U0/s_axis_tdata[18]} {ctrl_top_i/dutcomm_0/U0/s_axis_tdata[19]} {ctrl_top_i/dutcomm_0/U0/s_axis_tdata[20]} {ctrl_top_i/dutcomm_0/U0/s_axis_tdata[21]} {ctrl_top_i/dutcomm_0/U0/s_axis_tdata[22]} {ctrl_top_i/dutcomm_0/U0/s_axis_tdata[23]} {ctrl_top_i/dutcomm_0/U0/s_axis_tdata[24]} {ctrl_top_i/dutcomm_0/U0/s_axis_tdata[25]} {ctrl_top_i/dutcomm_0/U0/s_axis_tdata[26]} {ctrl_top_i/dutcomm_0/U0/s_axis_tdata[27]} {ctrl_top_i/dutcomm_0/U0/s_axis_tdata[28]} {ctrl_top_i/dutcomm_0/U0/s_axis_tdata[29]} {ctrl_top_i/dutcomm_0/U0/s_axis_tdata[30]} {ctrl_top_i/dutcomm_0/U0/s_axis_tdata[31]}]]
###create_debug_port u_ila_0 probe
###set_property PROBE_TYPE DATA_AND_TRIGGER [get_debug_ports u_ila_0/probe3]
###set_property port_width 4 [get_debug_ports u_ila_0/probe3]
###connect_debug_port u_ila_0/probe3 [get_nets [list {ctrl_top_i/dutcomm_0/U0/dout[0]} {ctrl_top_i/dutcomm_0/U0/dout[1]} {ctrl_top_i/dutcomm_0/U0/dout[2]} {ctrl_top_i/dutcomm_0/U0/dout[3]}]]
###create_debug_port u_ila_0 probe
###set_property PROBE_TYPE DATA_AND_TRIGGER [get_debug_ports u_ila_0/probe4]
###set_property port_width 1 [get_debug_ports u_ila_0/probe4]
###connect_debug_port u_ila_0/probe4 [get_nets [list ctrl_top_i/dutcomm_0/U0/di_ready]]
###create_debug_port u_ila_0 probe
###set_property PROBE_TYPE DATA_AND_TRIGGER [get_debug_ports u_ila_0/probe5]
###set_property port_width 1 [get_debug_ports u_ila_0/probe5]
###connect_debug_port u_ila_0/probe5 [get_nets [list ctrl_top_i/dutcomm_0/U0/di_valid]]
###create_debug_port u_ila_0 probe
###set_property PROBE_TYPE DATA_AND_TRIGGER [get_debug_ports u_ila_0/probe6]
###set_property port_width 1 [get_debug_ports u_ila_0/probe6]
###connect_debug_port u_ila_0/probe6 [get_nets [list ctrl_top_i/dutcomm_0/U0/do_ready]]
###create_debug_port u_ila_0 probe
###set_property PROBE_TYPE DATA_AND_TRIGGER [get_debug_ports u_ila_0/probe7]
###set_property port_width 1 [get_debug_ports u_ila_0/probe7]
###connect_debug_port u_ila_0/probe7 [get_nets [list ctrl_top_i/dutcomm_0/U0/do_valid]]
###create_debug_port u_ila_0 probe
###set_property PROBE_TYPE DATA_AND_TRIGGER [get_debug_ports u_ila_0/probe8]
###set_property port_width 1 [get_debug_ports u_ila_0/probe8]
###connect_debug_port u_ila_0/probe8 [get_nets [list ctrl_top_i/dutcomm_0/U0/dut_rst]]
###create_debug_port u_ila_0 probe
###set_property PROBE_TYPE DATA_AND_TRIGGER [get_debug_ports u_ila_0/probe9]
###set_property port_width 1 [get_debug_ports u_ila_0/probe9]
###connect_debug_port u_ila_0/probe9 [get_nets [list ctrl_top_i/dutcomm_0/U0/dut_working]]
###create_debug_port u_ila_0 probe
###set_property PROBE_TYPE DATA_AND_TRIGGER [get_debug_ports u_ila_0/probe10]
###set_property port_width 1 [get_debug_ports u_ila_0/probe10]
###connect_debug_port u_ila_0/probe10 [get_nets [list ctrl_top_i/dutcomm_0/U0/dutcm_n_0]]
###create_debug_port u_ila_0 probe
###set_property PROBE_TYPE DATA_AND_TRIGGER [get_debug_ports u_ila_0/probe11]
###set_property port_width 1 [get_debug_ports u_ila_0/probe11]
###connect_debug_port u_ila_0/probe11 [get_nets [list ctrl_top_i/dutcomm_0/U0/dutcm_n_1]]
###create_debug_port u_ila_0 probe
###set_property PROBE_TYPE DATA_AND_TRIGGER [get_debug_ports u_ila_0/probe12]
###set_property port_width 1 [get_debug_ports u_ila_0/probe12]
###connect_debug_port u_ila_0/probe12 [get_nets [list ctrl_top_i/dutcomm_0/U0/dutcm_n_2]]
###create_debug_port u_ila_0 probe
###set_property PROBE_TYPE DATA_AND_TRIGGER [get_debug_ports u_ila_0/probe13]
###set_property port_width 1 [get_debug_ports u_ila_0/probe13]
###connect_debug_port u_ila_0/probe13 [get_nets [list ctrl_top_i/dutcomm_0/U0/m_axis_tready]]
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
##set_property MARK_DEBUG true [get_nets {ctrl_top_i/dutcomm_0/U0/s_axis_tdata[23]}]
##set_property MARK_DEBUG true [get_nets {ctrl_top_i/dutcomm_0/U0/s_axis_tdata[24]}]
##set_property MARK_DEBUG true [get_nets {ctrl_top_i/dutcomm_0/U0/s_axis_tdata[25]}]
##set_property MARK_DEBUG true [get_nets {ctrl_top_i/dutcomm_0/U0/s_axis_tdata[26]}]
##set_property MARK_DEBUG true [get_nets {ctrl_top_i/dutcomm_0/U0/s_axis_tdata[27]}]
##set_property MARK_DEBUG true [get_nets {ctrl_top_i/dutcomm_0/U0/s_axis_tdata[28]}]
##set_property MARK_DEBUG true [get_nets {ctrl_top_i/dutcomm_0/U0/s_axis_tdata[29]}]
##set_property MARK_DEBUG true [get_nets {ctrl_top_i/dutcomm_0/U0/s_axis_tdata[2]}]
##set_property MARK_DEBUG true [get_nets {ctrl_top_i/dutcomm_0/U0/s_axis_tdata[30]}]
##set_property MARK_DEBUG true [get_nets {ctrl_top_i/dutcomm_0/U0/s_axis_tdata[31]}]
##set_property MARK_DEBUG true [get_nets {ctrl_top_i/dutcomm_0/U0/s_axis_tdata[3]}]
##set_property MARK_DEBUG true [get_nets {ctrl_top_i/dutcomm_0/U0/s_axis_tdata[4]}]
##set_property MARK_DEBUG true [get_nets {ctrl_top_i/dutcomm_0/U0/s_axis_tdata[5]}]
##set_property MARK_DEBUG true [get_nets {ctrl_top_i/dutcomm_0/U0/s_axis_tdata[6]}]
##set_property MARK_DEBUG true [get_nets {ctrl_top_i/dutcomm_0/U0/s_axis_tdata[7]}]
##set_property MARK_DEBUG true [get_nets {ctrl_top_i/dutcomm_0/U0/s_axis_tdata[8]}]
##set_property MARK_DEBUG true [get_nets {ctrl_top_i/dutcomm_0/U0/s_axis_tdata[9]}]
##set_property MARK_DEBUG true [get_nets ctrl_top_i/dutcomm_0/U0/snd_start]
##set_property MARK_DEBUG true [get_nets ctrl_top_i/dutcomm_0/U0/started]


##create_debug_core u_ila_0 ila
##set_property ALL_PROBE_SAME_MU true [get_debug_cores u_ila_0]
##set_property ALL_PROBE_SAME_MU_CNT 1 [get_debug_cores u_ila_0]
##set_property C_ADV_TRIGGER false [get_debug_cores u_ila_0]
##set_property C_DATA_DEPTH 1024 [get_debug_cores u_ila_0]
##set_property C_EN_STRG_QUAL false [get_debug_cores u_ila_0]
##set_property C_INPUT_PIPE_STAGES 0 [get_debug_cores u_ila_0]
##set_property C_TRIGIN_EN false [get_debug_cores u_ila_0]
##set_property C_TRIGOUT_EN false [get_debug_cores u_ila_0]
##set_property port_width 1 [get_debug_ports u_ila_0/clk]
##connect_debug_port u_ila_0/clk [get_nets [list ctrl_top_i/processing_system7_0/inst/FCLK_CLK1]]
##set_property PROBE_TYPE DATA_AND_TRIGGER [get_debug_ports u_ila_0/probe0]
##set_property port_width 32 [get_debug_ports u_ila_0/probe0]
##connect_debug_port u_ila_0/probe0 [get_nets [list {ctrl_top_i/dutcomm_0/U0/s_axis_tdata[0]} {ctrl_top_i/dutcomm_0/U0/s_axis_tdata[1]} {ctrl_top_i/dutcomm_0/U0/s_axis_tdata[2]} {ctrl_top_i/dutcomm_0/U0/s_axis_tdata[3]} {ctrl_top_i/dutcomm_0/U0/s_axis_tdata[4]} {ctrl_top_i/dutcomm_0/U0/s_axis_tdata[5]} {ctrl_top_i/dutcomm_0/U0/s_axis_tdata[6]} {ctrl_top_i/dutcomm_0/U0/s_axis_tdata[7]} {ctrl_top_i/dutcomm_0/U0/s_axis_tdata[8]} {ctrl_top_i/dutcomm_0/U0/s_axis_tdata[9]} {ctrl_top_i/dutcomm_0/U0/s_axis_tdata[10]} {ctrl_top_i/dutcomm_0/U0/s_axis_tdata[11]} {ctrl_top_i/dutcomm_0/U0/s_axis_tdata[12]} {ctrl_top_i/dutcomm_0/U0/s_axis_tdata[13]} {ctrl_top_i/dutcomm_0/U0/s_axis_tdata[14]} {ctrl_top_i/dutcomm_0/U0/s_axis_tdata[15]} {ctrl_top_i/dutcomm_0/U0/s_axis_tdata[16]} {ctrl_top_i/dutcomm_0/U0/s_axis_tdata[17]} {ctrl_top_i/dutcomm_0/U0/s_axis_tdata[18]} {ctrl_top_i/dutcomm_0/U0/s_axis_tdata[19]} {ctrl_top_i/dutcomm_0/U0/s_axis_tdata[20]} {ctrl_top_i/dutcomm_0/U0/s_axis_tdata[21]} {ctrl_top_i/dutcomm_0/U0/s_axis_tdata[22]} {ctrl_top_i/dutcomm_0/U0/s_axis_tdata[23]} {ctrl_top_i/dutcomm_0/U0/s_axis_tdata[24]} {ctrl_top_i/dutcomm_0/U0/s_axis_tdata[25]} {ctrl_top_i/dutcomm_0/U0/s_axis_tdata[26]} {ctrl_top_i/dutcomm_0/U0/s_axis_tdata[27]} {ctrl_top_i/dutcomm_0/U0/s_axis_tdata[28]} {ctrl_top_i/dutcomm_0/U0/s_axis_tdata[29]} {ctrl_top_i/dutcomm_0/U0/s_axis_tdata[30]} {ctrl_top_i/dutcomm_0/U0/s_axis_tdata[31]}]]
##create_debug_port u_ila_0 probe
##set_property PROBE_TYPE DATA_AND_TRIGGER [get_debug_ports u_ila_0/probe1]
##set_property port_width 28 [get_debug_ports u_ila_0/probe1]
##connect_debug_port u_ila_0/probe1 [get_nets [list {ctrl_top_i/dutcomm_0/U0/m_axis_tdata[0]} {ctrl_top_i/dutcomm_0/U0/m_axis_tdata[1]} {ctrl_top_i/dutcomm_0/U0/m_axis_tdata[2]} {ctrl_top_i/dutcomm_0/U0/m_axis_tdata[3]} {ctrl_top_i/dutcomm_0/U0/m_axis_tdata[4]} {ctrl_top_i/dutcomm_0/U0/m_axis_tdata[5]} {ctrl_top_i/dutcomm_0/U0/m_axis_tdata[6]} {ctrl_top_i/dutcomm_0/U0/m_axis_tdata[7]} {ctrl_top_i/dutcomm_0/U0/m_axis_tdata[8]} {ctrl_top_i/dutcomm_0/U0/m_axis_tdata[9]} {ctrl_top_i/dutcomm_0/U0/m_axis_tdata[10]} {ctrl_top_i/dutcomm_0/U0/m_axis_tdata[11]} {ctrl_top_i/dutcomm_0/U0/m_axis_tdata[12]} {ctrl_top_i/dutcomm_0/U0/m_axis_tdata[13]} {ctrl_top_i/dutcomm_0/U0/m_axis_tdata[14]} {ctrl_top_i/dutcomm_0/U0/m_axis_tdata[15]} {ctrl_top_i/dutcomm_0/U0/m_axis_tdata[16]} {ctrl_top_i/dutcomm_0/U0/m_axis_tdata[17]} {ctrl_top_i/dutcomm_0/U0/m_axis_tdata[18]} {ctrl_top_i/dutcomm_0/U0/m_axis_tdata[19]} {ctrl_top_i/dutcomm_0/U0/m_axis_tdata[20]} {ctrl_top_i/dutcomm_0/U0/m_axis_tdata[21]} {ctrl_top_i/dutcomm_0/U0/m_axis_tdata[22]} {ctrl_top_i/dutcomm_0/U0/m_axis_tdata[23]} {ctrl_top_i/dutcomm_0/U0/m_axis_tdata[24]} {ctrl_top_i/dutcomm_0/U0/m_axis_tdata[25]} {ctrl_top_i/dutcomm_0/U0/m_axis_tdata[26]} {ctrl_top_i/dutcomm_0/U0/m_axis_tdata[27]}]]
##create_debug_port u_ila_0 probe
##set_property PROBE_TYPE DATA_AND_TRIGGER [get_debug_ports u_ila_0/probe2]
##set_property port_width 32 [get_debug_ports u_ila_0/probe2]
##connect_debug_port u_ila_0/probe2 [get_nets [list {ctrl_top_i/axi_dma_0/s_axis_s2mm_tdata[0]} {ctrl_top_i/axi_dma_0/s_axis_s2mm_tdata[1]} {ctrl_top_i/axi_dma_0/s_axis_s2mm_tdata[2]} {ctrl_top_i/axi_dma_0/s_axis_s2mm_tdata[3]} {ctrl_top_i/axi_dma_0/s_axis_s2mm_tdata[4]} {ctrl_top_i/axi_dma_0/s_axis_s2mm_tdata[5]} {ctrl_top_i/axi_dma_0/s_axis_s2mm_tdata[6]} {ctrl_top_i/axi_dma_0/s_axis_s2mm_tdata[7]} {ctrl_top_i/axi_dma_0/s_axis_s2mm_tdata[8]} {ctrl_top_i/axi_dma_0/s_axis_s2mm_tdata[9]} {ctrl_top_i/axi_dma_0/s_axis_s2mm_tdata[10]} {ctrl_top_i/axi_dma_0/s_axis_s2mm_tdata[11]} {ctrl_top_i/axi_dma_0/s_axis_s2mm_tdata[12]} {ctrl_top_i/axi_dma_0/s_axis_s2mm_tdata[13]} {ctrl_top_i/axi_dma_0/s_axis_s2mm_tdata[14]} {ctrl_top_i/axi_dma_0/s_axis_s2mm_tdata[15]} {ctrl_top_i/axi_dma_0/s_axis_s2mm_tdata[16]} {ctrl_top_i/axi_dma_0/s_axis_s2mm_tdata[17]} {ctrl_top_i/axi_dma_0/s_axis_s2mm_tdata[18]} {ctrl_top_i/axi_dma_0/s_axis_s2mm_tdata[19]} {ctrl_top_i/axi_dma_0/s_axis_s2mm_tdata[20]} {ctrl_top_i/axi_dma_0/s_axis_s2mm_tdata[21]} {ctrl_top_i/axi_dma_0/s_axis_s2mm_tdata[22]} {ctrl_top_i/axi_dma_0/s_axis_s2mm_tdata[23]} {ctrl_top_i/axi_dma_0/s_axis_s2mm_tdata[24]} {ctrl_top_i/axi_dma_0/s_axis_s2mm_tdata[25]} {ctrl_top_i/axi_dma_0/s_axis_s2mm_tdata[26]} {ctrl_top_i/axi_dma_0/s_axis_s2mm_tdata[27]} {ctrl_top_i/axi_dma_0/s_axis_s2mm_tdata[28]} {ctrl_top_i/axi_dma_0/s_axis_s2mm_tdata[29]} {ctrl_top_i/axi_dma_0/s_axis_s2mm_tdata[30]} {ctrl_top_i/axi_dma_0/s_axis_s2mm_tdata[31]}]]
##create_debug_port u_ila_0 probe
##set_property PROBE_TYPE DATA_AND_TRIGGER [get_debug_ports u_ila_0/probe3]
##set_property port_width 4 [get_debug_ports u_ila_0/probe3]
##connect_debug_port u_ila_0/probe3 [get_nets [list {ctrl_top_i/dutcomm_0/U0/dutcm/din[0]} {ctrl_top_i/dutcomm_0/U0/dutcm/din[1]} {ctrl_top_i/dutcomm_0/U0/dutcm/din[2]} {ctrl_top_i/dutcomm_0/U0/dutcm/din[3]}]]
##create_debug_port u_ila_0 probe
##set_property PROBE_TYPE DATA_AND_TRIGGER [get_debug_ports u_ila_0/probe4]
##set_property port_width 4 [get_debug_ports u_ila_0/probe4]
##connect_debug_port u_ila_0/probe4 [get_nets [list {ctrl_top_i/dutcomm_0/U0/din[0]} {ctrl_top_i/dutcomm_0/U0/din[1]} {ctrl_top_i/dutcomm_0/U0/din[2]} {ctrl_top_i/dutcomm_0/U0/din[3]}]]
##create_debug_port u_ila_0 probe
##set_property PROBE_TYPE DATA_AND_TRIGGER [get_debug_ports u_ila_0/probe5]
##set_property port_width 4 [get_debug_ports u_ila_0/probe5]
##connect_debug_port u_ila_0/probe5 [get_nets [list {ctrl_top_i/dutcomm_0/U0/dout[0]} {ctrl_top_i/dutcomm_0/U0/dout[1]} {ctrl_top_i/dutcomm_0/U0/dout[2]} {ctrl_top_i/dutcomm_0/U0/dout[3]}]]
##create_debug_port u_ila_0 probe
##set_property PROBE_TYPE DATA_AND_TRIGGER [get_debug_ports u_ila_0/probe6]
##set_property port_width 1 [get_debug_ports u_ila_0/probe6]
##connect_debug_port u_ila_0/probe6 [get_nets [list ctrl_top_i/dutcomm_0/U0/di_ready]]
##create_debug_port u_ila_0 probe
##set_property PROBE_TYPE DATA_AND_TRIGGER [get_debug_ports u_ila_0/probe7]
##set_property port_width 1 [get_debug_ports u_ila_0/probe7]
##connect_debug_port u_ila_0/probe7 [get_nets [list ctrl_top_i/dutcomm_0/U0/di_valid]]
##create_debug_port u_ila_0 probe
##set_property PROBE_TYPE DATA_AND_TRIGGER [get_debug_ports u_ila_0/probe8]
##set_property port_width 1 [get_debug_ports u_ila_0/probe8]
##connect_debug_port u_ila_0/probe8 [get_nets [list ctrl_top_i/dutcomm_0/U0/do_ready]]
##create_debug_port u_ila_0 probe
##set_property PROBE_TYPE DATA_AND_TRIGGER [get_debug_ports u_ila_0/probe9]
##set_property port_width 1 [get_debug_ports u_ila_0/probe9]
##connect_debug_port u_ila_0/probe9 [get_nets [list ctrl_top_i/dutcomm_0/U0/do_valid]]
##create_debug_port u_ila_0 probe
##set_property PROBE_TYPE DATA_AND_TRIGGER [get_debug_ports u_ila_0/probe10]
##set_property port_width 1 [get_debug_ports u_ila_0/probe10]
##connect_debug_port u_ila_0/probe10 [get_nets [list ctrl_top_i/dutcomm_0/U0/dut_rst]]
##create_debug_port u_ila_0 probe
##set_property PROBE_TYPE DATA_AND_TRIGGER [get_debug_ports u_ila_0/probe11]
##set_property port_width 1 [get_debug_ports u_ila_0/probe11]
##connect_debug_port u_ila_0/probe11 [get_nets [list ctrl_top_i/dutcomm_0/U0/dut_working]]
##create_debug_port u_ila_0 probe
##set_property PROBE_TYPE DATA_AND_TRIGGER [get_debug_ports u_ila_0/probe12]
##set_property port_width 1 [get_debug_ports u_ila_0/probe12]
##connect_debug_port u_ila_0/probe12 [get_nets [list ctrl_top_i/dutcomm_0/U0/m_axis_tready]]
##create_debug_port u_ila_0 probe
##set_property PROBE_TYPE DATA_AND_TRIGGER [get_debug_ports u_ila_0/probe13]
##set_property port_width 1 [get_debug_ports u_ila_0/probe13]
##connect_debug_port u_ila_0/probe13 [get_nets [list ctrl_top_i/dutcomm_0/U0/m_axis_tvalid]]
##create_debug_port u_ila_0 probe
##set_property PROBE_TYPE DATA_AND_TRIGGER [get_debug_ports u_ila_0/probe14]
##set_property port_width 1 [get_debug_ports u_ila_0/probe14]
##connect_debug_port u_ila_0/probe14 [get_nets [list ctrl_top_i/dutcomm_0/U0/op_done]]
##create_debug_port u_ila_0 probe
##set_property PROBE_TYPE DATA_AND_TRIGGER [get_debug_ports u_ila_0/probe15]
##set_property port_width 1 [get_debug_ports u_ila_0/probe15]
##connect_debug_port u_ila_0/probe15 [get_nets [list ctrl_top_i/axi_dma_0/s_axis_s2mm_tlast]]
##create_debug_port u_ila_0 probe
##set_property PROBE_TYPE DATA_AND_TRIGGER [get_debug_ports u_ila_0/probe16]
##set_property port_width 1 [get_debug_ports u_ila_0/probe16]
##connect_debug_port u_ila_0/probe16 [get_nets [list ctrl_top_i/axi_dma_0/s_axis_s2mm_tready]]
##create_debug_port u_ila_0 probe
##set_property PROBE_TYPE DATA_AND_TRIGGER [get_debug_ports u_ila_0/probe17]
##set_property port_width 1 [get_debug_ports u_ila_0/probe17]
##connect_debug_port u_ila_0/probe17 [get_nets [list ctrl_top_i/axi_dma_0/s_axis_s2mm_tvalid]]
##create_debug_port u_ila_0 probe
##set_property PROBE_TYPE DATA_AND_TRIGGER [get_debug_ports u_ila_0/probe18]
##set_property port_width 1 [get_debug_ports u_ila_0/probe18]
##connect_debug_port u_ila_0/probe18 [get_nets [list ctrl_top_i/dutcomm_0/U0/snd_start]]
##create_debug_port u_ila_0 probe
##set_property PROBE_TYPE DATA_AND_TRIGGER [get_debug_ports u_ila_0/probe19]
##set_property port_width 1 [get_debug_ports u_ila_0/probe19]
##connect_debug_port u_ila_0/probe19 [get_nets [list ctrl_top_i/dutcomm_0/U0/started]]
##set_property C_CLK_INPUT_FREQ_HZ 300000000 [get_debug_cores dbg_hub]
##set_property C_ENABLE_CLK_DIVIDER false [get_debug_cores dbg_hub]
##set_property C_USER_SCAN_CHAIN 1 [get_debug_cores dbg_hub]
##connect_debug_port dbg_hub/clk [get_nets u_ila_0_FCLK_CLK1]

#set_property MARK_DEBUG true [get_nets ctrl_top_i/dutcomm_0/started]
#set_property MARK_DEBUG true [get_nets ctrl_top_i/dutcomm_0/op_done]
#set_property MARK_DEBUG true [get_nets ctrl_top_i/dutcomm_0/di_valid]
#set_property MARK_DEBUG true [get_nets ctrl_top_i/dutcomm_0/dut_rst]
#set_property MARK_DEBUG true [get_nets {ctrl_top_i/dutcomm_0/din[1]}]
#set_property MARK_DEBUG true [get_nets ctrl_top_i/dutcomm_0/do_ready]
#set_property MARK_DEBUG true [get_nets ctrl_top_i/dutcomm_0/di_ready]
#set_property MARK_DEBUG true [get_nets ctrl_top_i/dutcomm_0/dut_working]
#set_property MARK_DEBUG true [get_nets {ctrl_top_i/dutcomm_0/din[2]}]
#set_property MARK_DEBUG true [get_nets {ctrl_top_i/axi_dma_0/s_axis_s2mm_tdata[9]}]
#set_property MARK_DEBUG true [get_nets {ctrl_top_i/axi_dma_0/s_axis_s2mm_tdata[8]}]
#set_property MARK_DEBUG true [get_nets {ctrl_top_i/axi_dma_0/s_axis_s2mm_tdata[21]}]
#set_property MARK_DEBUG true [get_nets {ctrl_top_i/axi_dma_0/s_axis_s2mm_tdata[20]}]
#set_property MARK_DEBUG true [get_nets {ctrl_top_i/axi_dma_0/s_axis_s2mm_tdata[18]}]
#set_property MARK_DEBUG true [get_nets {ctrl_top_i/axi_dma_0/s_axis_s2mm_tdata[17]}]
#set_property MARK_DEBUG true [get_nets {ctrl_top_i/axi_dma_0/s_axis_s2mm_tdata[15]}]
#set_property MARK_DEBUG true [get_nets {ctrl_top_i/axi_dma_0/s_axis_s2mm_tdata[23]}]
#set_property MARK_DEBUG true [get_nets {ctrl_top_i/axi_dma_0/s_axis_s2mm_tdata[24]}]
#set_property MARK_DEBUG true [get_nets {ctrl_top_i/axi_dma_0/s_axis_s2mm_tdata[27]}]
#set_property MARK_DEBUG true [get_nets {ctrl_top_i/axi_dma_0/s_axis_s2mm_tdata[26]}]
#set_property MARK_DEBUG true [get_nets {ctrl_top_i/axi_dma_0/s_axis_s2mm_tdata[29]}]
#set_property MARK_DEBUG true [get_nets {ctrl_top_i/axi_dma_0/s_axis_s2mm_tdata[14]}]
#set_property MARK_DEBUG true [get_nets {ctrl_top_i/axi_dma_0/s_axis_s2mm_tdata[5]}]
#set_property MARK_DEBUG true [get_nets {ctrl_top_i/axi_dma_0/s_axis_s2mm_tdata[4]}]
#set_property MARK_DEBUG true [get_nets {ctrl_top_i/axi_dma_0/s_axis_s2mm_tdata[3]}]
#set_property MARK_DEBUG true [get_nets {ctrl_top_i/axi_dma_0/s_axis_s2mm_tdata[12]}]
#set_property MARK_DEBUG true [get_nets ctrl_top_i/axi_dma_0/s_axis_s2mm_tlast]
#set_property MARK_DEBUG true [get_nets ctrl_top_i/axi_dma_0/s_axis_s2mm_tvalid]
#set_property MARK_DEBUG true [get_nets ctrl_top_i/axi_dma_0/s_axis_s2mm_tready]
#set_property MARK_DEBUG true [get_nets {ctrl_top_i/axi_dma_0/s_axis_s2mm_tdata[11]}]
#set_property MARK_DEBUG true [get_nets {ctrl_top_i/dutcomm_0/dout[3]}]
#set_property MARK_DEBUG true [get_nets {ctrl_top_i/dutcomm_0/dout[1]}]
#set_property MARK_DEBUG true [get_nets {ctrl_top_i/dutcomm_0/dout[0]}]
#set_property MARK_DEBUG true [get_nets {ctrl_top_i/axi_dma_0/s_axis_s2mm_tdata[13]}]
#set_property MARK_DEBUG true [get_nets {ctrl_top_i/axi_dma_0/s_axis_s2mm_tdata[0]}]
#set_property MARK_DEBUG true [get_nets {ctrl_top_i/axi_dma_0/s_axis_s2mm_tdata[28]}]
#set_property MARK_DEBUG true [get_nets {ctrl_top_i/axi_dma_0/s_axis_s2mm_tdata[7]}]
#set_property MARK_DEBUG true [get_nets {ctrl_top_i/dutcomm_0/din[0]}]
#set_property MARK_DEBUG true [get_nets {ctrl_top_i/dutcomm_0/din[3]}]
#set_property MARK_DEBUG true [get_nets {ctrl_top_i/axi_dma_0/s_axis_s2mm_tdata[1]}]
#set_property MARK_DEBUG true [get_nets {ctrl_top_i/axi_dma_0/s_axis_s2mm_tdata[25]}]
#set_property MARK_DEBUG true [get_nets {ctrl_top_i/axi_dma_0/s_axis_s2mm_tdata[16]}]
#set_property MARK_DEBUG true [get_nets {ctrl_top_i/dutcomm_0/dout[2]}]
#set_property MARK_DEBUG true [get_nets {ctrl_top_i/axi_dma_0/s_axis_s2mm_tdata[31]}]
#set_property MARK_DEBUG true [get_nets {ctrl_top_i/axi_dma_0/s_axis_s2mm_tdata[22]}]
#set_property MARK_DEBUG true [get_nets {ctrl_top_i/axi_dma_0/s_axis_s2mm_tdata[10]}]
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
#set_property MARK_DEBUG true [get_nets {ctrl_top_i/FWFT_to_M_AXIS_2clk_0/d_transfer_len_count_reg[1]}]
#set_property MARK_DEBUG true [get_nets {ctrl_top_i/FWFT_to_M_AXIS_2clk_0/d_transfer_len_count_reg[10]}]
#set_property MARK_DEBUG true [get_nets {ctrl_top_i/FWFT_to_M_AXIS_2clk_0/d_transfer_len_count_reg[13]}]
#set_property MARK_DEBUG true [get_nets {ctrl_top_i/FWFT_to_M_AXIS_2clk_0/d_transfer_len_count_reg[8]}]
#set_property MARK_DEBUG true [get_nets {ctrl_top_i/FWFT_to_M_AXIS_2clk_0/d_transfer_len_count_reg[7]}]
#set_property MARK_DEBUG true [get_nets {ctrl_top_i/FWFT_to_M_AXIS_2clk_0/d_transfer_len_count_reg[5]}]

#connect_debug_port u_ila_0/probe1 [get_nets [list {ctrl_top_i/FWFT_to_M_AXIS_2clk_0/fifo_din[0]} {ctrl_top_i/FWFT_to_M_AXIS_2clk_0/fifo_din[1]} {ctrl_top_i/FWFT_to_M_AXIS_2clk_0/fifo_din[2]} {ctrl_top_i/FWFT_to_M_AXIS_2clk_0/fifo_din[3]} {ctrl_top_i/FWFT_to_M_AXIS_2clk_0/fifo_din[4]} {ctrl_top_i/FWFT_to_M_AXIS_2clk_0/fifo_din[5]} {ctrl_top_i/FWFT_to_M_AXIS_2clk_0/fifo_din[6]} {ctrl_top_i/FWFT_to_M_AXIS_2clk_0/fifo_din[7]} {ctrl_top_i/FWFT_to_M_AXIS_2clk_0/fifo_din[8]} {ctrl_top_i/FWFT_to_M_AXIS_2clk_0/fifo_din[9]} {ctrl_top_i/FWFT_to_M_AXIS_2clk_0/fifo_din[10]} {ctrl_top_i/FWFT_to_M_AXIS_2clk_0/fifo_din[11]} {ctrl_top_i/FWFT_to_M_AXIS_2clk_0/fifo_din[12]} {ctrl_top_i/FWFT_to_M_AXIS_2clk_0/fifo_din[13]} {ctrl_top_i/FWFT_to_M_AXIS_2clk_0/fifo_din[14]} {ctrl_top_i/FWFT_to_M_AXIS_2clk_0/fifo_din[15]} {ctrl_top_i/FWFT_to_M_AXIS_2clk_0/fifo_din[16]} {ctrl_top_i/FWFT_to_M_AXIS_2clk_0/fifo_din[17]} {ctrl_top_i/FWFT_to_M_AXIS_2clk_0/fifo_din[18]} {ctrl_top_i/FWFT_to_M_AXIS_2clk_0/fifo_din[19]} {ctrl_top_i/FWFT_to_M_AXIS_2clk_0/fifo_din[20]} {ctrl_top_i/FWFT_to_M_AXIS_2clk_0/fifo_din[21]} {ctrl_top_i/FWFT_to_M_AXIS_2clk_0/fifo_din[22]} {ctrl_top_i/FWFT_to_M_AXIS_2clk_0/fifo_din[23]} {ctrl_top_i/FWFT_to_M_AXIS_2clk_0/fifo_din[24]} {ctrl_top_i/FWFT_to_M_AXIS_2clk_0/fifo_din[25]} {ctrl_top_i/FWFT_to_M_AXIS_2clk_0/fifo_din[26]} {ctrl_top_i/FWFT_to_M_AXIS_2clk_0/fifo_din[27]} {ctrl_top_i/FWFT_to_M_AXIS_2clk_0/fifo_din[28]} {ctrl_top_i/FWFT_to_M_AXIS_2clk_0/fifo_din[29]} {ctrl_top_i/FWFT_to_M_AXIS_2clk_0/fifo_din[30]} {ctrl_top_i/FWFT_to_M_AXIS_2clk_0/fifo_din[31]}]]
#connect_debug_port u_ila_0/probe2 [get_nets [list {ctrl_top_i/FWFT_to_M_AXIS_2clk_0/d_transfer_len_count_reg[0]} {ctrl_top_i/FWFT_to_M_AXIS_2clk_0/d_transfer_len_count_reg[1]} {ctrl_top_i/FWFT_to_M_AXIS_2clk_0/d_transfer_len_count_reg[2]} {ctrl_top_i/FWFT_to_M_AXIS_2clk_0/d_transfer_len_count_reg[3]} {ctrl_top_i/FWFT_to_M_AXIS_2clk_0/d_transfer_len_count_reg[4]} {ctrl_top_i/FWFT_to_M_AXIS_2clk_0/d_transfer_len_count_reg[5]} {ctrl_top_i/FWFT_to_M_AXIS_2clk_0/d_transfer_len_count_reg[6]} {ctrl_top_i/FWFT_to_M_AXIS_2clk_0/d_transfer_len_count_reg[7]} {ctrl_top_i/FWFT_to_M_AXIS_2clk_0/d_transfer_len_count_reg[8]} {ctrl_top_i/FWFT_to_M_AXIS_2clk_0/d_transfer_len_count_reg[9]} {ctrl_top_i/FWFT_to_M_AXIS_2clk_0/d_transfer_len_count_reg[10]} {ctrl_top_i/FWFT_to_M_AXIS_2clk_0/d_transfer_len_count_reg[11]} {ctrl_top_i/FWFT_to_M_AXIS_2clk_0/d_transfer_len_count_reg[12]} {ctrl_top_i/FWFT_to_M_AXIS_2clk_0/d_transfer_len_count_reg[13]} {ctrl_top_i/FWFT_to_M_AXIS_2clk_0/d_transfer_len_count_reg[14]} {ctrl_top_i/FWFT_to_M_AXIS_2clk_0/d_transfer_len_count_reg[15]} {ctrl_top_i/FWFT_to_M_AXIS_2clk_0/d_transfer_len_count_reg[16]} {ctrl_top_i/FWFT_to_M_AXIS_2clk_0/d_transfer_len_count_reg[17]} {ctrl_top_i/FWFT_to_M_AXIS_2clk_0/d_transfer_len_count_reg[18]} {ctrl_top_i/FWFT_to_M_AXIS_2clk_0/d_transfer_len_count_reg[19]} {ctrl_top_i/FWFT_to_M_AXIS_2clk_0/d_transfer_len_count_reg[20]} {ctrl_top_i/FWFT_to_M_AXIS_2clk_0/d_transfer_len_count_reg[21]} {ctrl_top_i/FWFT_to_M_AXIS_2clk_0/d_transfer_len_count_reg[22]} {ctrl_top_i/FWFT_to_M_AXIS_2clk_0/d_transfer_len_count_reg[23]} {ctrl_top_i/FWFT_to_M_AXIS_2clk_0/d_transfer_len_count_reg[24]} {ctrl_top_i/FWFT_to_M_AXIS_2clk_0/d_transfer_len_count_reg[25]} {ctrl_top_i/FWFT_to_M_AXIS_2clk_0/d_transfer_len_count_reg[26]} {ctrl_top_i/FWFT_to_M_AXIS_2clk_0/d_transfer_len_count_reg[27]} {ctrl_top_i/FWFT_to_M_AXIS_2clk_0/d_transfer_len_count_reg[28]} {ctrl_top_i/FWFT_to_M_AXIS_2clk_0/d_transfer_len_count_reg[29]} {ctrl_top_i/FWFT_to_M_AXIS_2clk_0/d_transfer_len_count_reg[30]} {ctrl_top_i/FWFT_to_M_AXIS_2clk_0/d_transfer_len_count_reg[31]}]]
#connect_debug_port u_ila_0/probe3 [get_nets [list {ctrl_top_i/FWFT_to_M_AXIS_2clk_0/m00_axis_tdata[0]} {ctrl_top_i/FWFT_to_M_AXIS_2clk_0/m00_axis_tdata[1]} {ctrl_top_i/FWFT_to_M_AXIS_2clk_0/m00_axis_tdata[2]} {ctrl_top_i/FWFT_to_M_AXIS_2clk_0/m00_axis_tdata[3]} {ctrl_top_i/FWFT_to_M_AXIS_2clk_0/m00_axis_tdata[4]} {ctrl_top_i/FWFT_to_M_AXIS_2clk_0/m00_axis_tdata[5]} {ctrl_top_i/FWFT_to_M_AXIS_2clk_0/m00_axis_tdata[6]} {ctrl_top_i/FWFT_to_M_AXIS_2clk_0/m00_axis_tdata[7]} {ctrl_top_i/FWFT_to_M_AXIS_2clk_0/m00_axis_tdata[8]} {ctrl_top_i/FWFT_to_M_AXIS_2clk_0/m00_axis_tdata[9]} {ctrl_top_i/FWFT_to_M_AXIS_2clk_0/m00_axis_tdata[10]} {ctrl_top_i/FWFT_to_M_AXIS_2clk_0/m00_axis_tdata[11]} {ctrl_top_i/FWFT_to_M_AXIS_2clk_0/m00_axis_tdata[12]} {ctrl_top_i/FWFT_to_M_AXIS_2clk_0/m00_axis_tdata[13]} {ctrl_top_i/FWFT_to_M_AXIS_2clk_0/m00_axis_tdata[14]} {ctrl_top_i/FWFT_to_M_AXIS_2clk_0/m00_axis_tdata[15]} {ctrl_top_i/FWFT_to_M_AXIS_2clk_0/m00_axis_tdata[16]} {ctrl_top_i/FWFT_to_M_AXIS_2clk_0/m00_axis_tdata[17]} {ctrl_top_i/FWFT_to_M_AXIS_2clk_0/m00_axis_tdata[18]} {ctrl_top_i/FWFT_to_M_AXIS_2clk_0/m00_axis_tdata[19]} {ctrl_top_i/FWFT_to_M_AXIS_2clk_0/m00_axis_tdata[20]} {ctrl_top_i/FWFT_to_M_AXIS_2clk_0/m00_axis_tdata[21]} {ctrl_top_i/FWFT_to_M_AXIS_2clk_0/m00_axis_tdata[22]} {ctrl_top_i/FWFT_to_M_AXIS_2clk_0/m00_axis_tdata[23]} {ctrl_top_i/FWFT_to_M_AXIS_2clk_0/m00_axis_tdata[24]} {ctrl_top_i/FWFT_to_M_AXIS_2clk_0/m00_axis_tdata[25]} {ctrl_top_i/FWFT_to_M_AXIS_2clk_0/m00_axis_tdata[26]} {ctrl_top_i/FWFT_to_M_AXIS_2clk_0/m00_axis_tdata[27]} {ctrl_top_i/FWFT_to_M_AXIS_2clk_0/m00_axis_tdata[28]} {ctrl_top_i/FWFT_to_M_AXIS_2clk_0/m00_axis_tdata[29]} {ctrl_top_i/FWFT_to_M_AXIS_2clk_0/m00_axis_tdata[30]} {ctrl_top_i/FWFT_to_M_AXIS_2clk_0/m00_axis_tdata[31]}]]
#connect_debug_port u_ila_0/probe12 [get_nets [list ctrl_top_i/FWFT_to_M_AXIS_2clk_0/fifo_full]]
#connect_debug_port u_ila_0/probe13 [get_nets [list ctrl_top_i/FWFT_to_M_AXIS_2clk_0/fifo_write]]
#connect_debug_port u_ila_0/probe14 [get_nets [list ctrl_top_i/FWFT_to_M_AXIS_2clk_0/U0/init_done]]

#set_property MARK_DEBUG true [get_nets {ctrl_top_i/dutcomm_0/U0/dutcm/m_axis_tdata[8]}]
#set_property MARK_DEBUG true [get_nets {ctrl_top_i/dutcomm_0/U0/dutcm/m_axis_tdata[7]}]
#set_property MARK_DEBUG true [get_nets {ctrl_top_i/dutcomm_0/U0/dutcm/m_axis_tdata[1]}]
#set_property MARK_DEBUG true [get_nets {ctrl_top_i/dutcomm_0/U0/dutcm/m_axis_tdata[0]}]
#set_property MARK_DEBUG true [get_nets {ctrl_top_i/dutcomm_0/U0/dutcm/m_axis_tdata[24]}]
#set_property MARK_DEBUG true [get_nets {ctrl_top_i/dutcomm_0/U0/dutcm/dout[2]}]
#set_property MARK_DEBUG true [get_nets {ctrl_top_i/dutcomm_0/U0/dutcm/m_axis_tdata[9]}]
#set_property MARK_DEBUG true [get_nets {ctrl_top_i/dutcomm_0/U0/dutcm/m_axis_tdata[5]}]
#set_property MARK_DEBUG true [get_nets {ctrl_top_i/dutcomm_0/U0/dutcm/m_axis_tdata[4]}]
#set_property MARK_DEBUG true [get_nets {ctrl_top_i/dutcomm_0/U0/dutcm/dout[1]}]
#set_property MARK_DEBUG true [get_nets {ctrl_top_i/dutcomm_0/U0/dutcm/din[3]}]
#set_property MARK_DEBUG true [get_nets {ctrl_top_i/dutcomm_0/U0/dutcm/m_axis_tdata[11]}]
#set_property MARK_DEBUG true [get_nets {ctrl_top_i/dutcomm_0/U0/dutcm/m_axis_tdata[22]}]
#set_property MARK_DEBUG true [get_nets {ctrl_top_i/dutcomm_0/U0/dutcm/m_axis_tdata[21]}]
#set_property MARK_DEBUG true [get_nets {ctrl_top_i/dutcomm_0/U0/dutcm/m_axis_tdata[20]}]
#set_property MARK_DEBUG true [get_nets {ctrl_top_i/dutcomm_0/U0/dutcm/m_axis_tdata[13]}]
#set_property MARK_DEBUG true [get_nets {ctrl_top_i/dutcomm_0/U0/dutcm/m_axis_tdata[16]}]
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
#set_property MARK_DEBUG true [get_nets {ctrl_top_i/dutcomm_0/U0/dutcm/s_axis_tdata[12]}]
#set_property MARK_DEBUG true [get_nets {ctrl_top_i/dutcomm_0/U0/dutcm/s_axis_tdata[13]}]
#set_property MARK_DEBUG true [get_nets {ctrl_top_i/dutcomm_0/U0/dutcm/s_axis_tdata[10]}]
#set_property MARK_DEBUG true [get_nets {ctrl_top_i/dutcomm_0/U0/dutcm/s_axis_tdata[17]}]
#set_property MARK_DEBUG true [get_nets {ctrl_top_i/dutcomm_0/U0/dutcm/s_axis_tdata[19]}]
#set_property MARK_DEBUG true [get_nets {ctrl_top_i/dutcomm_0/U0/dutcm/s_axis_tdata[20]}]
#set_property MARK_DEBUG true [get_nets {ctrl_top_i/dutcomm_0/U0/dutcm/s_axis_tdata[8]}]
#set_property MARK_DEBUG true [get_nets ctrl_top_i/dutcomm_0/U0/dutcm/di_ready]
#set_property MARK_DEBUG true [get_nets ctrl_top_i/dutcomm_0/U0/dutcm/di_valid]
#set_property MARK_DEBUG true [get_nets ctrl_top_i/dutcomm_0/U0/dutcm/s_axis_tready]
#set_property MARK_DEBUG true [get_nets ctrl_top_i/dutcomm_0/U0/dutcm/m_axis_tvalid]
#set_property MARK_DEBUG true [get_nets ctrl_top_i/dutcomm_0/U0/dutcm/do_valid]
#set_property MARK_DEBUG true [get_nets ctrl_top_i/dutcomm_0/U0/dutcm/do_ready]
#set_property MARK_DEBUG true [get_nets ctrl_top_i/dutcomm_0/U0/dutcm/s_axis_tvalid]
#set_property MARK_DEBUG true [get_nets ctrl_top_i/dutcomm_0/U0/dutcm/m_axis_tready]
#set_property MARK_DEBUG true [get_nets ctrl_top_i/dutcomm_0/U0/dutcm/m_axis_tlast]

#create_debug_core u_ila_0 ila
#set_property ALL_PROBE_SAME_MU true [get_debug_cores u_ila_0]
#set_property ALL_PROBE_SAME_MU_CNT 1 [get_debug_cores u_ila_0]
#set_property C_ADV_TRIGGER false [get_debug_cores u_ila_0]
#set_property C_DATA_DEPTH 1024 [get_debug_cores u_ila_0]
#set_property C_EN_STRG_QUAL false [get_debug_cores u_ila_0]
#set_property C_INPUT_PIPE_STAGES 0 [get_debug_cores u_ila_0]
#set_property C_TRIGIN_EN false [get_debug_cores u_ila_0]
#set_property C_TRIGOUT_EN false [get_debug_cores u_ila_0]
#set_property port_width 1 [get_debug_ports u_ila_0/clk]
#connect_debug_port u_ila_0/clk [get_nets [list ctrl_top_i/processing_system7_0/inst/FCLK_CLK1]]
#set_property PROBE_TYPE DATA_AND_TRIGGER [get_debug_ports u_ila_0/probe0]
#set_property port_width 4 [get_debug_ports u_ila_0/probe0]
#connect_debug_port u_ila_0/probe0 [get_nets [list {ctrl_top_i/dutcomm_0/U0/dutcm/din[0]} {ctrl_top_i/dutcomm_0/U0/dutcm/din[1]} {ctrl_top_i/dutcomm_0/U0/dutcm/din[2]} {ctrl_top_i/dutcomm_0/U0/dutcm/din[3]}]]
#create_debug_port u_ila_0 probe
#set_property PROBE_TYPE DATA_AND_TRIGGER [get_debug_ports u_ila_0/probe1]
#set_property port_width 4 [get_debug_ports u_ila_0/probe1]
#connect_debug_port u_ila_0/probe1 [get_nets [list {ctrl_top_i/dutcomm_0/dout[0]} {ctrl_top_i/dutcomm_0/dout[1]} {ctrl_top_i/dutcomm_0/dout[2]} {ctrl_top_i/dutcomm_0/dout[3]}]]
#create_debug_port u_ila_0 probe
#set_property PROBE_TYPE DATA_AND_TRIGGER [get_debug_ports u_ila_0/probe2]
#set_property port_width 4 [get_debug_ports u_ila_0/probe2]
#connect_debug_port u_ila_0/probe2 [get_nets [list {ctrl_top_i/dutcomm_0/din[0]} {ctrl_top_i/dutcomm_0/din[1]} {ctrl_top_i/dutcomm_0/din[2]} {ctrl_top_i/dutcomm_0/din[3]}]]
#create_debug_port u_ila_0 probe
#set_property PROBE_TYPE DATA_AND_TRIGGER [get_debug_ports u_ila_0/probe3]
#set_property port_width 28 [get_debug_ports u_ila_0/probe3]
#connect_debug_port u_ila_0/probe3 [get_nets [list {ctrl_top_i/axi_dma_0/s_axis_s2mm_tdata[4]} {ctrl_top_i/axi_dma_0/s_axis_s2mm_tdata[5]} {ctrl_top_i/axi_dma_0/s_axis_s2mm_tdata[6]} {ctrl_top_i/axi_dma_0/s_axis_s2mm_tdata[7]} {ctrl_top_i/axi_dma_0/s_axis_s2mm_tdata[8]} {ctrl_top_i/axi_dma_0/s_axis_s2mm_tdata[9]} {ctrl_top_i/axi_dma_0/s_axis_s2mm_tdata[10]} {ctrl_top_i/axi_dma_0/s_axis_s2mm_tdata[11]} {ctrl_top_i/axi_dma_0/s_axis_s2mm_tdata[12]} {ctrl_top_i/axi_dma_0/s_axis_s2mm_tdata[13]} {ctrl_top_i/axi_dma_0/s_axis_s2mm_tdata[14]} {ctrl_top_i/axi_dma_0/s_axis_s2mm_tdata[15]} {ctrl_top_i/axi_dma_0/s_axis_s2mm_tdata[16]} {ctrl_top_i/axi_dma_0/s_axis_s2mm_tdata[17]} {ctrl_top_i/axi_dma_0/s_axis_s2mm_tdata[18]} {ctrl_top_i/axi_dma_0/s_axis_s2mm_tdata[19]} {ctrl_top_i/axi_dma_0/s_axis_s2mm_tdata[20]} {ctrl_top_i/axi_dma_0/s_axis_s2mm_tdata[21]} {ctrl_top_i/axi_dma_0/s_axis_s2mm_tdata[22]} {ctrl_top_i/axi_dma_0/s_axis_s2mm_tdata[23]} {ctrl_top_i/axi_dma_0/s_axis_s2mm_tdata[24]} {ctrl_top_i/axi_dma_0/s_axis_s2mm_tdata[25]} {ctrl_top_i/axi_dma_0/s_axis_s2mm_tdata[26]} {ctrl_top_i/axi_dma_0/s_axis_s2mm_tdata[27]} {ctrl_top_i/axi_dma_0/s_axis_s2mm_tdata[28]} {ctrl_top_i/axi_dma_0/s_axis_s2mm_tdata[29]} {ctrl_top_i/axi_dma_0/s_axis_s2mm_tdata[30]} {ctrl_top_i/axi_dma_0/s_axis_s2mm_tdata[31]}]]
#create_debug_port u_ila_0 probe
#set_property PROBE_TYPE DATA_AND_TRIGGER [get_debug_ports u_ila_0/probe4]
#set_property port_width 4 [get_debug_ports u_ila_0/probe4]
#connect_debug_port u_ila_0/probe4 [get_nets [list {ctrl_top_i/dutcomm_0/U0/dutcm/dout[0]} {ctrl_top_i/dutcomm_0/U0/dutcm/dout[1]} {ctrl_top_i/dutcomm_0/U0/dutcm/dout[2]} {ctrl_top_i/dutcomm_0/U0/dutcm/dout[3]}]]
#create_debug_port u_ila_0 probe
#set_property PROBE_TYPE DATA_AND_TRIGGER [get_debug_ports u_ila_0/probe5]
#set_property port_width 28 [get_debug_ports u_ila_0/probe5]
#connect_debug_port u_ila_0/probe5 [get_nets [list {ctrl_top_i/dutcomm_0/U0/dutcm/m_axis_tdata[0]} {ctrl_top_i/dutcomm_0/U0/dutcm/m_axis_tdata[1]} {ctrl_top_i/dutcomm_0/U0/dutcm/m_axis_tdata[2]} {ctrl_top_i/dutcomm_0/U0/dutcm/m_axis_tdata[3]} {ctrl_top_i/dutcomm_0/U0/dutcm/m_axis_tdata[4]} {ctrl_top_i/dutcomm_0/U0/dutcm/m_axis_tdata[5]} {ctrl_top_i/dutcomm_0/U0/dutcm/m_axis_tdata[6]} {ctrl_top_i/dutcomm_0/U0/dutcm/m_axis_tdata[7]} {ctrl_top_i/dutcomm_0/U0/dutcm/m_axis_tdata[8]} {ctrl_top_i/dutcomm_0/U0/dutcm/m_axis_tdata[9]} {ctrl_top_i/dutcomm_0/U0/dutcm/m_axis_tdata[10]} {ctrl_top_i/dutcomm_0/U0/dutcm/m_axis_tdata[11]} {ctrl_top_i/dutcomm_0/U0/dutcm/m_axis_tdata[12]} {ctrl_top_i/dutcomm_0/U0/dutcm/m_axis_tdata[13]} {ctrl_top_i/dutcomm_0/U0/dutcm/m_axis_tdata[14]} {ctrl_top_i/dutcomm_0/U0/dutcm/m_axis_tdata[15]} {ctrl_top_i/dutcomm_0/U0/dutcm/m_axis_tdata[16]} {ctrl_top_i/dutcomm_0/U0/dutcm/m_axis_tdata[17]} {ctrl_top_i/dutcomm_0/U0/dutcm/m_axis_tdata[18]} {ctrl_top_i/dutcomm_0/U0/dutcm/m_axis_tdata[19]} {ctrl_top_i/dutcomm_0/U0/dutcm/m_axis_tdata[20]} {ctrl_top_i/dutcomm_0/U0/dutcm/m_axis_tdata[21]} {ctrl_top_i/dutcomm_0/U0/dutcm/m_axis_tdata[22]} {ctrl_top_i/dutcomm_0/U0/dutcm/m_axis_tdata[23]} {ctrl_top_i/dutcomm_0/U0/dutcm/m_axis_tdata[24]} {ctrl_top_i/dutcomm_0/U0/dutcm/m_axis_tdata[25]} {ctrl_top_i/dutcomm_0/U0/dutcm/m_axis_tdata[26]} {ctrl_top_i/dutcomm_0/U0/dutcm/m_axis_tdata[27]}]]
#create_debug_port u_ila_0 probe
#set_property PROBE_TYPE DATA_AND_TRIGGER [get_debug_ports u_ila_0/probe6]
#set_property port_width 32 [get_debug_ports u_ila_0/probe6]
#connect_debug_port u_ila_0/probe6 [get_nets [list {ctrl_top_i/dutcomm_0/U0/dutcm/s_axis_tdata[0]} {ctrl_top_i/dutcomm_0/U0/dutcm/s_axis_tdata[1]} {ctrl_top_i/dutcomm_0/U0/dutcm/s_axis_tdata[2]} {ctrl_top_i/dutcomm_0/U0/dutcm/s_axis_tdata[3]} {ctrl_top_i/dutcomm_0/U0/dutcm/s_axis_tdata[4]} {ctrl_top_i/dutcomm_0/U0/dutcm/s_axis_tdata[5]} {ctrl_top_i/dutcomm_0/U0/dutcm/s_axis_tdata[6]} {ctrl_top_i/dutcomm_0/U0/dutcm/s_axis_tdata[7]} {ctrl_top_i/dutcomm_0/U0/dutcm/s_axis_tdata[8]} {ctrl_top_i/dutcomm_0/U0/dutcm/s_axis_tdata[9]} {ctrl_top_i/dutcomm_0/U0/dutcm/s_axis_tdata[10]} {ctrl_top_i/dutcomm_0/U0/dutcm/s_axis_tdata[11]} {ctrl_top_i/dutcomm_0/U0/dutcm/s_axis_tdata[12]} {ctrl_top_i/dutcomm_0/U0/dutcm/s_axis_tdata[13]} {ctrl_top_i/dutcomm_0/U0/dutcm/s_axis_tdata[14]} {ctrl_top_i/dutcomm_0/U0/dutcm/s_axis_tdata[15]} {ctrl_top_i/dutcomm_0/U0/dutcm/s_axis_tdata[16]} {ctrl_top_i/dutcomm_0/U0/dutcm/s_axis_tdata[17]} {ctrl_top_i/dutcomm_0/U0/dutcm/s_axis_tdata[18]} {ctrl_top_i/dutcomm_0/U0/dutcm/s_axis_tdata[19]} {ctrl_top_i/dutcomm_0/U0/dutcm/s_axis_tdata[20]} {ctrl_top_i/dutcomm_0/U0/dutcm/s_axis_tdata[21]} {ctrl_top_i/dutcomm_0/U0/dutcm/s_axis_tdata[22]} {ctrl_top_i/dutcomm_0/U0/dutcm/s_axis_tdata[23]} {ctrl_top_i/dutcomm_0/U0/dutcm/s_axis_tdata[24]} {ctrl_top_i/dutcomm_0/U0/dutcm/s_axis_tdata[25]} {ctrl_top_i/dutcomm_0/U0/dutcm/s_axis_tdata[26]} {ctrl_top_i/dutcomm_0/U0/dutcm/s_axis_tdata[27]} {ctrl_top_i/dutcomm_0/U0/dutcm/s_axis_tdata[28]} {ctrl_top_i/dutcomm_0/U0/dutcm/s_axis_tdata[29]} {ctrl_top_i/dutcomm_0/U0/dutcm/s_axis_tdata[30]} {ctrl_top_i/dutcomm_0/U0/dutcm/s_axis_tdata[31]}]]
#create_debug_port u_ila_0 probe
#set_property PROBE_TYPE DATA_AND_TRIGGER [get_debug_ports u_ila_0/probe7]
#set_property port_width 1 [get_debug_ports u_ila_0/probe7]
#connect_debug_port u_ila_0/probe7 [get_nets [list ctrl_top_i/dutcomm_0/U0/dutcm/di_ready]]
#create_debug_port u_ila_0 probe
#set_property PROBE_TYPE DATA_AND_TRIGGER [get_debug_ports u_ila_0/probe8]
#set_property port_width 1 [get_debug_ports u_ila_0/probe8]
#connect_debug_port u_ila_0/probe8 [get_nets [list ctrl_top_i/dutcomm_0/di_ready]]
#create_debug_port u_ila_0 probe
#set_property PROBE_TYPE DATA_AND_TRIGGER [get_debug_ports u_ila_0/probe9]
#set_property port_width 1 [get_debug_ports u_ila_0/probe9]
#connect_debug_port u_ila_0/probe9 [get_nets [list ctrl_top_i/dutcomm_0/di_valid]]
#create_debug_port u_ila_0 probe
#set_property PROBE_TYPE DATA_AND_TRIGGER [get_debug_ports u_ila_0/probe10]
#set_property port_width 1 [get_debug_ports u_ila_0/probe10]
#connect_debug_port u_ila_0/probe10 [get_nets [list ctrl_top_i/dutcomm_0/U0/dutcm/di_valid]]
#create_debug_port u_ila_0 probe
#set_property PROBE_TYPE DATA_AND_TRIGGER [get_debug_ports u_ila_0/probe11]
#set_property port_width 1 [get_debug_ports u_ila_0/probe11]
#connect_debug_port u_ila_0/probe11 [get_nets [list ctrl_top_i/dutcomm_0/do_ready]]
#create_debug_port u_ila_0 probe
#set_property PROBE_TYPE DATA_AND_TRIGGER [get_debug_ports u_ila_0/probe12]
#set_property port_width 1 [get_debug_ports u_ila_0/probe12]
#connect_debug_port u_ila_0/probe12 [get_nets [list ctrl_top_i/dutcomm_0/U0/dutcm/do_ready]]
#create_debug_port u_ila_0 probe
#set_property PROBE_TYPE DATA_AND_TRIGGER [get_debug_ports u_ila_0/probe13]
#set_property port_width 1 [get_debug_ports u_ila_0/probe13]
#connect_debug_port u_ila_0/probe13 [get_nets [list ctrl_top_i/dutcomm_0/do_valid]]
#create_debug_port u_ila_0 probe
#set_property PROBE_TYPE DATA_AND_TRIGGER [get_debug_ports u_ila_0/probe14]
#set_property port_width 1 [get_debug_ports u_ila_0/probe14]
#connect_debug_port u_ila_0/probe14 [get_nets [list ctrl_top_i/dutcomm_0/U0/dutcm/do_valid]]
#create_debug_port u_ila_0 probe
#set_property PROBE_TYPE DATA_AND_TRIGGER [get_debug_ports u_ila_0/probe15]
#set_property port_width 1 [get_debug_ports u_ila_0/probe15]
#connect_debug_port u_ila_0/probe15 [get_nets [list ctrl_top_i/dutcomm_0/dut_rst]]
#create_debug_port u_ila_0 probe
#set_property PROBE_TYPE DATA_AND_TRIGGER [get_debug_ports u_ila_0/probe16]
#set_property port_width 1 [get_debug_ports u_ila_0/probe16]
#connect_debug_port u_ila_0/probe16 [get_nets [list ctrl_top_i/dutcomm_0/dut_working]]
#create_debug_port u_ila_0 probe
#set_property PROBE_TYPE DATA_AND_TRIGGER [get_debug_ports u_ila_0/probe17]
#set_property port_width 1 [get_debug_ports u_ila_0/probe17]
#connect_debug_port u_ila_0/probe17 [get_nets [list ctrl_top_i/dutcomm_0/U0/dutcm/m_axis_tlast]]
#create_debug_port u_ila_0 probe
#set_property PROBE_TYPE DATA_AND_TRIGGER [get_debug_ports u_ila_0/probe18]
#set_property port_width 1 [get_debug_ports u_ila_0/probe18]
#connect_debug_port u_ila_0/probe18 [get_nets [list ctrl_top_i/dutcomm_0/U0/dutcm/m_axis_tready]]
#create_debug_port u_ila_0 probe
#set_property PROBE_TYPE DATA_AND_TRIGGER [get_debug_ports u_ila_0/probe19]
#set_property port_width 1 [get_debug_ports u_ila_0/probe19]
#connect_debug_port u_ila_0/probe19 [get_nets [list ctrl_top_i/dutcomm_0/U0/dutcm/m_axis_tvalid]]
#create_debug_port u_ila_0 probe
#set_property PROBE_TYPE DATA_AND_TRIGGER [get_debug_ports u_ila_0/probe20]
#set_property port_width 1 [get_debug_ports u_ila_0/probe20]
#connect_debug_port u_ila_0/probe20 [get_nets [list ctrl_top_i/dutcomm_0/op_done]]
#create_debug_port u_ila_0 probe
#set_property PROBE_TYPE DATA_AND_TRIGGER [get_debug_ports u_ila_0/probe21]
#set_property port_width 1 [get_debug_ports u_ila_0/probe21]
#connect_debug_port u_ila_0/probe21 [get_nets [list ctrl_top_i/axi_dma_0/s_axis_s2mm_tlast]]
#create_debug_port u_ila_0 probe
#set_property PROBE_TYPE DATA_AND_TRIGGER [get_debug_ports u_ila_0/probe22]
#set_property port_width 1 [get_debug_ports u_ila_0/probe22]
#connect_debug_port u_ila_0/probe22 [get_nets [list ctrl_top_i/axi_dma_0/s_axis_s2mm_tready]]
#create_debug_port u_ila_0 probe
#set_property PROBE_TYPE DATA_AND_TRIGGER [get_debug_ports u_ila_0/probe23]
#set_property port_width 1 [get_debug_ports u_ila_0/probe23]
#connect_debug_port u_ila_0/probe23 [get_nets [list ctrl_top_i/axi_dma_0/s_axis_s2mm_tvalid]]
#create_debug_port u_ila_0 probe
#set_property PROBE_TYPE DATA_AND_TRIGGER [get_debug_ports u_ila_0/probe24]
#set_property port_width 1 [get_debug_ports u_ila_0/probe24]
#connect_debug_port u_ila_0/probe24 [get_nets [list ctrl_top_i/dutcomm_0/U0/dutcm/s_axis_tready]]
#create_debug_port u_ila_0 probe
#set_property PROBE_TYPE DATA_AND_TRIGGER [get_debug_ports u_ila_0/probe25]
#set_property port_width 1 [get_debug_ports u_ila_0/probe25]
#connect_debug_port u_ila_0/probe25 [get_nets [list ctrl_top_i/dutcomm_0/U0/dutcm/s_axis_tvalid]]
#create_debug_port u_ila_0 probe
#set_property PROBE_TYPE DATA_AND_TRIGGER [get_debug_ports u_ila_0/probe26]
#set_property port_width 1 [get_debug_ports u_ila_0/probe26]
#connect_debug_port u_ila_0/probe26 [get_nets [list ctrl_top_i/dutcomm_0/started]]
#set_property C_CLK_INPUT_FREQ_HZ 300000000 [get_debug_cores dbg_hub]
#set_property C_ENABLE_CLK_DIVIDER false [get_debug_cores dbg_hub]
#set_property C_USER_SCAN_CHAIN 1 [get_debug_cores dbg_hub]
#connect_debug_port dbg_hub/clk [get_nets u_ila_0_FCLK_CLK1]

set_property MARK_DEBUG true [get_nets ctrl_top_i/dut_controller_0/dut_rst]
set_property MARK_DEBUG true [get_nets {ctrl_top_i/dutcomm_0/U0/din[0]}]
set_property MARK_DEBUG true [get_nets {ctrl_top_i/dutcomm_0/U0/din[1]}]
set_property MARK_DEBUG true [get_nets {ctrl_top_i/dutcomm_0/U0/din[2]}]
set_property MARK_DEBUG true [get_nets {ctrl_top_i/dutcomm_0/U0/din[3]}]
set_property MARK_DEBUG true [get_nets {ctrl_top_i/dutcomm_0/U0/dout[0]}]
set_property MARK_DEBUG true [get_nets {ctrl_top_i/dutcomm_0/U0/dout[1]}]
set_property MARK_DEBUG true [get_nets {ctrl_top_i/dutcomm_0/U0/dout[2]}]
set_property MARK_DEBUG true [get_nets {ctrl_top_i/dutcomm_0/U0/dout[3]}]
set_property MARK_DEBUG true [get_nets {ctrl_top_i/dutcomm_0/U0/m_axis_tdata[0]}]
set_property MARK_DEBUG true [get_nets {ctrl_top_i/dutcomm_0/U0/m_axis_tdata[10]}]
set_property MARK_DEBUG true [get_nets {ctrl_top_i/dutcomm_0/U0/m_axis_tdata[11]}]
set_property MARK_DEBUG true [get_nets {ctrl_top_i/dutcomm_0/U0/m_axis_tdata[12]}]
set_property MARK_DEBUG true [get_nets {ctrl_top_i/dutcomm_0/U0/m_axis_tdata[13]}]
set_property MARK_DEBUG true [get_nets {ctrl_top_i/dutcomm_0/U0/m_axis_tdata[14]}]
set_property MARK_DEBUG true [get_nets {ctrl_top_i/dutcomm_0/U0/m_axis_tdata[15]}]
set_property MARK_DEBUG true [get_nets {ctrl_top_i/dutcomm_0/U0/m_axis_tdata[16]}]
set_property MARK_DEBUG true [get_nets {ctrl_top_i/dutcomm_0/U0/m_axis_tdata[17]}]
set_property MARK_DEBUG true [get_nets {ctrl_top_i/dutcomm_0/U0/m_axis_tdata[18]}]
set_property MARK_DEBUG true [get_nets {ctrl_top_i/dutcomm_0/U0/m_axis_tdata[19]}]
set_property MARK_DEBUG true [get_nets {ctrl_top_i/dutcomm_0/U0/m_axis_tdata[1]}]
set_property MARK_DEBUG true [get_nets {ctrl_top_i/dutcomm_0/U0/m_axis_tdata[20]}]
set_property MARK_DEBUG true [get_nets {ctrl_top_i/dutcomm_0/U0/m_axis_tdata[21]}]
set_property MARK_DEBUG true [get_nets {ctrl_top_i/dutcomm_0/U0/m_axis_tdata[22]}]
set_property MARK_DEBUG true [get_nets {ctrl_top_i/dutcomm_0/U0/m_axis_tdata[23]}]
set_property MARK_DEBUG true [get_nets {ctrl_top_i/dutcomm_0/U0/m_axis_tdata[24]}]
set_property MARK_DEBUG true [get_nets {ctrl_top_i/dutcomm_0/U0/m_axis_tdata[25]}]
set_property MARK_DEBUG true [get_nets {ctrl_top_i/dutcomm_0/U0/m_axis_tdata[26]}]
set_property MARK_DEBUG true [get_nets {ctrl_top_i/dutcomm_0/U0/m_axis_tdata[27]}]
set_property MARK_DEBUG true [get_nets {ctrl_top_i/dutcomm_0/U0/m_axis_tdata[2]}]
set_property MARK_DEBUG true [get_nets {ctrl_top_i/dutcomm_0/U0/m_axis_tdata[3]}]
set_property MARK_DEBUG true [get_nets {ctrl_top_i/dutcomm_0/U0/m_axis_tdata[4]}]
set_property MARK_DEBUG true [get_nets {ctrl_top_i/dutcomm_0/U0/m_axis_tdata[5]}]
set_property MARK_DEBUG true [get_nets {ctrl_top_i/dutcomm_0/U0/m_axis_tdata[6]}]
set_property MARK_DEBUG true [get_nets {ctrl_top_i/dutcomm_0/U0/m_axis_tdata[7]}]
set_property MARK_DEBUG true [get_nets {ctrl_top_i/dutcomm_0/U0/m_axis_tdata[8]}]
set_property MARK_DEBUG true [get_nets {ctrl_top_i/dutcomm_0/U0/m_axis_tdata[9]}]
set_property MARK_DEBUG true [get_nets ctrl_top_i/dutcomm_0/U0/di_ready]
set_property MARK_DEBUG true [get_nets ctrl_top_i/dutcomm_0/U0/di_valid]
set_property MARK_DEBUG true [get_nets ctrl_top_i/dutcomm_0/U0/do_ready]
set_property MARK_DEBUG true [get_nets ctrl_top_i/dutcomm_0/U0/do_valid]
connect_debug_port dbg_hub/clk [get_nets dut_clk_OBUF]

set_property MARK_DEBUG true [get_nets {ctrl_top_i/dutcomm_0/din[3]}]
set_property MARK_DEBUG true [get_nets {ctrl_top_i/dutcomm_0/din[2]}]
set_property MARK_DEBUG true [get_nets {ctrl_top_i/dutcomm_0/din[0]}]
set_property MARK_DEBUG true [get_nets {ctrl_top_i/dutcomm_0/din[1]}]
set_property MARK_DEBUG true [get_nets ctrl_top_i/dutcomm_0/s_axis_tready]
set_property MARK_DEBUG true [get_nets ctrl_top_i/dutcomm_0/m_axis_tready]
set_property MARK_DEBUG true [get_nets ctrl_top_i/dutcomm_0/m_axis_tlast]
set_property MARK_DEBUG true [get_nets ctrl_top_i/dutcomm_0/op_done]
set_property MARK_DEBUG true [get_nets ctrl_top_i/dutcomm_0/di_ready]
set_property MARK_DEBUG true [get_nets {ctrl_top_i/dutcomm_0/m_axis_tdata[13]}]
set_property MARK_DEBUG true [get_nets {ctrl_top_i/dutcomm_0/m_axis_tdata[11]}]
set_property MARK_DEBUG true [get_nets {ctrl_top_i/dutcomm_0/m_axis_tdata[8]}]
set_property MARK_DEBUG true [get_nets {ctrl_top_i/dutcomm_0/m_axis_tdata[4]}]
set_property MARK_DEBUG true [get_nets {ctrl_top_i/dutcomm_0/m_axis_tdata[18]}]
set_property MARK_DEBUG true [get_nets {ctrl_top_i/dutcomm_0/m_axis_tdata[30]}]
set_property MARK_DEBUG true [get_nets {ctrl_top_i/dutcomm_0/m_axis_tdata[29]}]
set_property MARK_DEBUG true [get_nets {ctrl_top_i/dutcomm_0/m_axis_tdata[31]}]
set_property MARK_DEBUG true [get_nets {ctrl_top_i/dutcomm_0/m_axis_tdata[20]}]
set_property MARK_DEBUG true [get_nets {ctrl_top_i/dutcomm_0/m_axis_tdata[16]}]
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
set_property MARK_DEBUG true [get_nets ctrl_top_i/openadc_interface_v1_0_0/m_axis_tlast]
set_property MARK_DEBUG true [get_nets ctrl_top_i/openadc_interface_v1_0_0/m_axis_tvalid]
set_property MARK_DEBUG true [get_nets ctrl_top_i/openadc_interface_v1_0_0/m_axis_tready]
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
