kammoh/fobos/(commit log)

2013-03-08 First Commit--files to be used for OpenADC working in slow mode
    [config_template.txt, osc_config_template.txt]
2013-06-13 oscilloscope socket testing
2013-06-14 newer version
    [connections.ods]
2013-08-05 adding memory buffer circuit, need to add driver after verification to reduce the number of control signals input to the circuit and to reduce the complexity. various module sizes added
    [DRAM211_isim_beh.exe_main.nt64.obj, TB_test_module_isim_beh.exe_main.nt64.obj, TOP_pad.csv, a_0566672871_1807433755.nt64.obj, a_1308919437_3212880686.nt64.obj, a_1335952598_3996520542.nt64.obj, a_1567994375_3082922608.nt64.obj, a_2496225489_3929544846.nt64.obj]
2013-08-11 renamed busses and reassigned pins on fx2 to enable more differential pairs and to match with nexys3-nexys3 pin assignments
    [connections.ods, vhdci-fx2-gnd.brd, vhdci-fx2-gnd.sch]
2013-08-11 board layout
    [vhdci-fx2-gnd.brd, vhdci-fx2-gnd.sch]
2013-08-13 datapath/controller interface for memory added
    [DRAM211_isim_beh.exe_main.nt64.obj, TB_test_module_isim_beh.exe_main.nt64.obj, TOP_pad.csv, a_0566672871_1807433755.nt64.obj, a_1308919437_3212880686.nt64.obj, a_1335952598_3996520542.nt64.obj, a_1567994375_3082922608.nt64.obj, a_2496225489_3929544846.nt64.obj]
2013-08-13 some small changes
    [a_1335952598_3996520542.nt64.obj, a_3115858369_2372691052.nt64.obj]
2013-08-16 modified logic to conserve pins and simplify top-level module
    [DRAM211_isim_beh.exe_main.nt64.obj, Datapath_pad.csv, TB_test_module_isim_beh.exe_main.nt64.obj, TOP_pad.csv, a_0566672871_1807433755.nt64.obj, a_1308919437_3212880686.nt64.obj, a_1335952598_3996520542.nt64.obj, a_1567994375_3082922608.nt64.obj]
2013-08-24 added Nexys2 as DUT
    [connections.ods]
2013-08-24 added Nexys2 as control, need to fix clock and signal names
    [connections.ods]
2013-08-26 made some changes to support open adc -1
2013-09-05 some mods
    [top_pad.csv]
2013-09-17 adding schematic, another resource, a memory controller, must combine and verify
2013-10-12 added test code for Board Diagnostics - Python & RTL
2013-10-13 Board Diag test scripts
2013-10-20 board diagnostics will now support openadc/counter streaming
2013-10-20 final openadc board diag
2013-10-27 adding files
    [FOBOS_circuit.sch]
2014-02-26 tiny fixed
    [config.txt]
2014-05-02 added file in osc/testing
    [oscilloscope_config.txt]
2014-05-06 added test files for analysis
    [analysis_config.txt]
2014-05-07 added rest of the stuff
    [analysis_config.txt, oscilloscope_config.txt]
2014-05-21 changed structure
    [analysis_config.txt]
2014-05-30 aded new files
    [compressionParams.txt, config.txt, dataAnalysisParams.txt, postProcessesParams.txt, sampleSpaceDispParams.txt, signalAlignmentParams.txt, traceExpungeParams.txt]
2014-05-30 added new features
    [config.txt]
2014-05-30 first cleaning
    [sampleSpaceDispParams.txt, traceExpungeParams.txt]
2014-06-19 added copyright information
    [config.txt, config_template.txt, osc_config_template.txt, oscilloscope_config.txt]
2014-07-24 temp folder created to house temporary or test case files -- should not be in distribution
    [FOBOS_BOM.xlsx, FOBOS_circuit.sch, compressionParams.txt, config.txt, dataAnalysisParams.txt, postProcessesParams.txt, sampleSpaceDispParams.txt, signalAlignmentParams.txt]
2014-07-24 modified the branch structure
    [compressionParams.txt, dataAnalysisParams.txt, postProcessesParams.txt, sampleSpaceDispParams.txt, signalAlignmentParams.txt, traceExpungeParams.txt]
2014-11-03 new configs
    [sampleSpaceDispParams.txt]
2015-02-26 config commits
    [compressionParams.txt, sampleSpaceDispParams.txt]
2015-02-26 added an option
    [config.txt]
2015-02-27 changed the config file
    [config.txt, oscilloscope_config.txt]
2015-03-01 program to view raw plots. to be copied into the measurement directory
    [config.txt, oscilloscope_config.txt]
2015-03-02 ready for testing
    [config.txt]
2015-04-02 new file
    [aquisitionConfig.txt]
2015-04-02 made some changes
    [config.txt, oscilloscope_config.txt]
2015-04-02 deleted some files
    [config_template.txt, osc_config_template.txt, oscilloscope_config.txt]
2015-04-05 more files to come
    [aquisitionConfig.txt]
2015-04-19 made some changes to correct the error in data analysis
    [aquisitionConfig.txt]
2015-05-22 some changes
    [aquisitionConfig.txt, signalAlignmentParams.txt]
2015-05-24 almost ready for full test
    [aquisitionConfig.txt]
2015-05-24 made changes
    [aquisitionConfig.txt]
2015-05-24 made lots of changes
    [aquisitionConfig.txt]
2015-09-09 added lots of changes
    [aquisitionConfig.txt]
2015-09-09 bug fixed
    [aquisitionConfig.txt]
2015-10-15 some debug messages
    [aquisitionConfig.txt]
2015-11-01 works with victim in control -- dummy victim is data xor key
    [aquisitionConfig.txt]
2015-11-13 fixed displayLED function to allow databus wider than 4 bits
    [fobosControlTop.vhd]
2015-11-14 remapped so that spartan3 pins match other connector too
    [connections.ods]
2015-11-14 trying to switch to external victim
2015-11-16 finalized nexys2ctrl-spartan3edut table
    [connections.ods]
2015-11-18 made all IOs 3.3V etc
2015-11-23 Jens' and Mitras Changes
    [aquisitionConfig.txt, signalAlignmentParams.txt]
2015-12-03 trying 4-bit bus
    [aquisitionConfig.txt]
2015-12-04 4-bit wired interface works
    [aquisitionConfig.txt]
2016-02-20 16 bit bus, fixing trigger
    [aquisitionConfig.txt]
2016-02-26 finally getting data from scope again
    [aquisitionConfig.txt, signalAlignmentParams.txt]
2016-02-29 trying SCA
    [aquisitionConfig.txt, traceExpungeParams.txt]
2016-03-06 Changes to dataAnalysis by reordering operation to improve speed
    [aquisitionConfig.txt, compressionParams.txt, sampleSpaceDispParams.txt, signalAlignmentParams.txt, traceExpungeParams.txt]
2016-03-08 Added histogram plotting and changed the number of points to acquire
    [aquisitionConfig.txt]
2016-03-08 Change the time scale in acquisitionConfig to get more points at intresting clock cylce
    [aquisitionConfig.txt]
2016-03-08 Made changes to Histogram. Each byte has a bin now.
    [sampleSpaceDispParams.txt]
2016-04-26 recovered old data files deleted by Rajesh on 10/10/15
    [aquisitionConfig.txt]
2016-04-27 saving the changes for the athena_aes attack model
    [aquisitionConfig.txt]
2016-04-30 * Made change to plotting module to add minor and major grid lines
    * Made change to configExtract and globals to save windowed data
    [aquisitionConfig.txt, compressionParams.txt, config.txt, sampleSpaceDispParams.txt, traceExpungeParams.txt]
2016-05-02 testing with RIGOL
    [oscilloscope_config.txt]
2016-05-02 Updated with rajesh's changes to plotting module by adding minimumguessingentropy, co-releations for all bytes and print the broken key in the log
    [aquisitionConfig.txt, compressionParams.txt, sampleSpaceDispParams.txt]
2016-05-02 added figures for compression window and sample window
2016-05-03 changes as per request
    [Board_Mod.brd, aquisitionConfig.txt, config.txt, sampleSpaceDispParams.txt, vhdci-fx2-differential.brd, vhdci-fx2-differential.sch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]
2016-05-03 added figrues for trace alignment
2016-05-03 correction to analysis flow figure
2016-05-03 added raw trace with green grid
2016-05-03 updated the trace color to red
2016-05-03 poster ready for print
2016-05-05 changed the file name of the aquisition to acquisitionConfig.txt
    [acquisitionConfig.txt]
2016-05-07 added the powermodel written in python and rectified the typo in the file name aquisition--> acquistion
    [acquisitionConfig.txt, sampleSpaceDispParams.txt]
2016-05-15 added alignment on trigger for acq
    [acquisitionConfig.txt]
2016-05-17 fixed the problem after the change to save only the aligned data after acquisition
    [oscilloscope_core.py]
2016-09-12 Now we automatically adjust trace size
2018-03-02 New trigger types added
    [acquisitionConfig.txt, aquisitionConfig.txt, compressionParams.txt, config.txt, sampleSpaceDispParams.txt]
2018-03-02 Fixed issues with trigger configuration
    [acquisitionConfig.txt]
2018-04-17 power calculation script now uses fobos directories
2018-04-20 added power calcualtion config
2018-04-20 Removed the numpy.vstack call form reading trace routine. This now faster
2018-04-20 Simplified scope reading function for more speed. Fixed isses with result storage
    [acquisitionConfig.txt, config.txt]
2018-04-20 Corrected trace alignment function. CUT_MODE config added
2018-04-28 Edited poster to add new features (power-measuremnt, t-test and profiler)
2018-04-30 Fixed power figure in poster
2018-07-17 Added QuickStart Guides, Added copyright header to files and removed deprecated config parameters.
    [acquisitionConfig.txt]
2018-08-03 Updated fobos-userguide. Fixed isses with the integration of the profiler, power measurement and t-test scripts with the analysis. On branch master Changes to be committed: modified: .gitignore modif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
    [config.txt]
2018-08-10 first checkin of fobos3 shield pcb
    [PVQFN16.step, SMA_Board_Edge_Molex_732511150.step, SSOP-20.step, ardu.sch, dutconnect.sch, fobosshield.kicad_pcb, fobosshield.sch, openADC.sch]
2018-08-10 a few more pcb files
2018-08-10 even more pcb files
2018-08-15 started routing power circuit
    [ardu.sch, fobosshield.kicad_pcb, power.sch]
2018-08-16 all wires routed
    [dutconnect.sch, fobosshield.kicad_pcb, openADC.sch, power.sch]
2018-08-17 few more additions
    [ardu.sch, fobosshield.kicad_pcb, power.sch]
2018-08-17 cerg logo on PCB
2018-08-18 added cms for 3.3V
    [CUI_PJ-102AH.step, ardu.sch, dutconnect.sch, fobosshield.kicad_pcb, fobosshield.sch, power.sch]
2018-08-21 additional requirements
    [ardu.sch, dutconnect.sch, fobosshield.kicad_pcb, fobosshield.sch, js202011scqn.stp, power.sch]
2018-08-22 finalized feature addition
    [ardu.sch, dutconnect.sch, fobosshield.kicad_pcb, power.sch]
2018-08-25 some more updates
    [ardu.sch, fobosshield.kicad_pcb, power.sch]
2018-08-27 new layout for probe power
    [ardu.sch, fobosshield.kicad_pcb, fobosshield.sch, openADC.sch, power.sch]
2018-08-28 variable power new layout
    [ardu.sch, dutconnect.sch, fobosshield.kicad_pcb, fobosshield.sch, openADC.sch, power.sch]
2018-08-28 3V3 CSM layouted
    [fobosshield.kicad_pcb]
2018-08-29 all routed, needs DRC
    [ardu.sch, fobosshield.kicad_pcb]
2018-08-31 DRC passes
    [fobosshield.kicad_pcb]
2018-09-05 made all small vias a little bit larger
    [fobosshield.kicad_pcb]
2018-09-08 verified probe power
    [ardu.sch, fobosshield.kicad_pcb, power.sch]
2018-09-12 Minor changes on error messages. Modified releasefilelist.txt. Added doc files
    [acquisitionConfig.txt, config.txt]
2018-09-12 power supply parts verified
    [fobosshield.kicad_pcb, power.sch]
2018-09-13 dut connectors and glitch verified
    [dutconnect.sch, fobosshield.kicad_pcb]
2018-09-28 tiny updates
    [openADC.sch, power.sch]
2018-09-28 updates from Cw
    [openADC.sch]
2018-09-28 inductor size changed
    [fobosshield.kicad_pcb, openADC.sch]
2018-09-30 added CERG logo
    [fobosshield.kicad_pcb]
2018-09-30 updated some values
    [ardu.sch, openADC.sch, power.sch]
2018-11-09 continuing design
    [dutconnect.sch]
2018-11-11 components complete
    [dutconnect.sch, fobos-ti_launchpad.kicad_pcb]
2018-11-15 part placement
    [dutconnect.sch, fobos-ti_launchpad.kicad_pcb]
2018-11-15 added PMOD and ST Morpho
    [dutconnect.sch, fobos-ti_launchpad.kicad_pcb]
2018-11-16 PMOD pin assignment
    [dutconnect.sch, fobos-ti_launchpad.kicad_pcb]
2018-12-13 Removed ILA to fix an error
    [debug.xdc]
2018-12-19 DMA test works
2018-12-20 Fixed errors in dma.c
2018-12-20 combined dma.c and dut.c
2019-01-16 some fixes
    [dutconnect.sch, fobos-ti_launchpad.kicad_pcb]
2019-01-17 finalized placement of top side components
    [dutconnect.sch, fobos-ti_launchpad.kicad_pcb]
2019-01-17 Added missing PYNQ-Z1 board files and updated README.md
2019-01-17 Added Baysy3 board files and updated README.md
2019-01-17 Removed need for PYNQ-Z1 board files
2019-01-18 Added dut_controller IP. Fixed minor issues with it. Also removed dut_rst pin form dutcomm IP since it is provided by dut_controller IP.
    [counter.vhd, dut_controller_v1_0.vhd, dut_controller_v1_0_S_AXI.vhd, dutcomm_v1_0.vhd, fobos_package.vhd, rst_mod.vhd, rst_mod_tb.vhd, timeout_mod_tb.vhd]
2019-01-21 reverted ctrl hardware to working state
    [dutcomm_v1_0.vhd]
2019-01-24 Fixed DUTCOMM to work with FPGA only DUT.
    [debug.xdc, dutCommCtrl.vhd]
2019-01-31 Fixed issues with Timeout module. Also, issues with DUT comm not working with Timeout module
    [debug.xdc, dutComm.vhd, dutCommCtrl.vhd, dut_controller_v1_0.vhd, dut_controller_v1_0_S_AXI.vhd, dutcomm_v1_0.vhd, timeout_module.vhd]
2019-02-05 Fixed issues with oscilloscope communication
    [debug.xdc, fobosctrl.py, projmgr.py, scope.py]
2019-02-06 Corrected capture directory naming
    [projmgr.py]
2019-02-07 added powermanager IP
2019-02-07 added IOs for powermanager
2019-02-20 Powermanager IP added
2019-02-23 added powermanager register table
    [powermanager.ods]
2019-02-28 added FPGA pinouts and fixed 2 bugs
    [ardu.sch, dutconnect.sch, fobosshield.kicad_pcb, fobosshield.sch, openADC.sch, power.sch]
2019-03-01 small updates to fobos-shield
    [ardu.sch, dutconnect.sch, fobosshield.sch, openADC.sch, power.sch]
2019-03-01 started layout of mtc
    [dutconnect.sch, fobos-ti_launchpad.kicad_pcb]
2019-03-01 still working on layout of MTC
    [dutconnect.sch, fobos-ti_launchpad.kicad_pcb, fobos-ti_launchpad.sch]
2019-03-02 draft layout of MTC done
    [dutconnect.sch, fobos-ti_launchpad.kicad_pcb, fobos-ti_launchpad.sch]
2019-03-04 added more stuff for MTC
    [dutconnect.sch, fobos-ti_launchpad.kicad_pcb]
2019-03-14 added more FPGA pins and fixed bug in FOBOS shield
    [ardu.sch, dutconnect.sch, fobosshield.kicad_pcb, power.sch]
2019-03-25 updates to presentation
    [speed-analysis.ods]
2019-03-25 Updated version of speed-analysis.ods
    [speed-analysis.ods]
2019-03-25 power module code
2019-03-26 ready for release
    [speed-analysis.ods]
2019-03-26 Roadmap is now Speed Analysis
    [speed-analysis.ods]
2019-03-26 RSA and AES computation speed correction
    [speed-analysis.ods]
2019-03-26 Can use OpenADC to collect traces
2019-04-09 Added missing sensitivity list signal in tlast process
    [dutCommCtrl.vhd]
2019-04-16 Now, we can switch between 4bit and 8bit DUT interface(hardware only)
2019-04-16 We can now switch between 4bit and 8bit DUT interface.
2019-04-19 Re-organized CPA attack code and AES hypothetical power generation code.
2019-05-03 Minor changes to capture_adc.ipynb to fix hardcoded sample numbers
2019-05-07 forgot to commit before
    [ardu.sch, speed-analysis.ods]
2019-05-07 fobos-ti_launchpad is now fobos-mtc
    [dutconnect.sch, fobos-ti_launchpad.kicad_pcb, fobos-ti_launchpad.sch]
2019-05-07 moved fobos-ti-launchpad stuff to fobos-mtc
    [fobos-mtc.kicad_pcb, fobos-mtc.sch]
2019-06-07 Fixed a trace bace in processData
    [basys3ctrl.py]
2019-06-10 Fixed trigger module FSM. Modified timeout module testbench
    [timeout_mod_tb.vhd, trigger_module.vhd, trigger_tb.vhd]
2019-06-13 Flashing Basys3 controller SPI flash. Added docs and modified constrain file
2019-06-21 Corrected constrain files to be compatible with Artix7-CW305 board pins
2019-07-03 Modified constrain file to make clk pin in CW305 dut a clock enabled pin.
2019-08-06 Added a function to get trace in mV units from Picoscope.
2019-08-20 Added test mode. Fixed issues with timout and reset features.
    [FOBOS_DUT.vhd, aes_axi.vhd, aes_non_pipe.vhd, aes_tb.vhd, average.vhd, basys3ctrl.py, controller.vhd, counter.vhd]
2019-09-06 Edited AES power model file format
2019-10-08 Added new doc directory for Shpinx doc
    [powermanager.ods, speed-analysis.ods]
2019-10-10 Fixed an issue with ctrl.c that prevented dutcomm from working on non-test mode.
    [basys3ctrl.xdc]
2019-10-25 Fobos 3 DUT power
2019-11-27 Added control board device auto detection.
2019-12-20 some modifications to the shield
    [ardu.sch, dutconnect.sch, fobosshield.kicad_pcb, fobosshield.sch, openADC.sch, power.sch]
2020-01-16 Fixed ADC spikes by registering ADC data at the rising edge.
    [openadc_v1_0.vhd]
2020-01-28 Added power glitch feature
    [basys3ctrl.py, basys3ctrl.xdc, dut_controller_v1_0.vhd, dut_controller_v1_0_S_AXI.vhd, fobosctrl.py, glitcher_tb.vhd, power_glitcher.vhd]
2020-02-07 Created t-test4.py. This file uses memory-mapped numpy arrays to keep traces in the disk to save memory
2020-02-25 fixed issues with the power glicth functionality
    [basys3ctrl.py, basys3ctrl.xdc, dut_controller_v1_0.vhd, dut_controller_v1_0_S_AXI.vhd, power_glitcher.vhd]
2020-02-26 fixed gain control pinout
    [powermanager.ods]
2020-02-26 work in progress
    [openADC.sch, power.sch]
2020-02-27 trying new locations of components on shield
    [ardu.sch, fobosshield.kicad_pcb, power.sch]
2020-02-28 started open ADC layout
    [ardu.sch, fobosshield.kicad_pcb]
2020-03-05 more changes to PCB
    [fobosshield.kicad_pcb, openADC.sch]
2020-03-31 Added client watchdog. fixed issues with pynq ctrl
    [hardware_mgr.py, pynqctrl.py]
2020-03-31 fixed isses with pynqserver and watchdog
    [pynqserver.py, serverWatchdog.py]
2020-04-12 Cleared ADC gain on disconnect
2020-04-13 fixed adc gain limit message
    [pynqctrl.py]
2020-04-13 fixed trace lenght issue
    [pynqserver.py]
2020-04-13 added functions to load and save hypothetical power data
2020-04-15 improved powermodel calculations output meesages
2020-04-15 Fixed issues in projmgr and improved out messages in traceset.py
    [projmgr.py]
2020-04-16 added power model display function
2020-04-22 added 3d model of heat sink
2020-05-27 still working on new layout
    [fobosshield.kicad_pcb]
2020-06-30 Fixed a typo in FOBOS_DUT.vhd related to rdi FIFO isses
    [FOBOS_DUT.vhd]
2020-07-07 Fixed timeout issue in pynqserver.py
    [pynqserver.py]
2020-07-16 added fobos3-power in png format
2020-07-16 Cleaned up FOBOS directory structure. Now it matches the README
    [Board_Mod.brd, Board_Mod.sch, CUI_PJ-102AH.step, FOBOS_BOM.xlsx, FOBOS_circuit.sch, PVQFN16.step, SMA_Board_Edge_Molex_732511150.step, SSOP-20.step]
2020-07-16 Update README.md, added planned FOBOS DUT PCB locations
2020-07-26 SMA connector 3D reference updated
    [fobos-mtc.kicad_pcb]
2020-07-27 moved 3d models to subdirectory, updated paths
    [CUI_PJ-102AH.step, PVQFN16.step, SMA_Board_Edge_Molex_732511150.step, SSOP-20.step, fobosshield.kicad_pcb, fobosshield.sch, openADC.sch, power.sch]
2020-07-28 more pcb library cleanup
    [dutconnect.sch, fobos-mtc.kicad_pcb, fobos-mtc.sch]
2020-07-28 corrected ESD component in library for MTC
    [dutconnect.sch, fobos-mtc.kicad_pcb]
2020-07-30 started artix7 dut development
    [dut-artix7-a12t.kicad_pcb, dut-artix7-a12t.sch, power.sch, target.sch]
2020-07-30 started adding FPGA to Artix7 DUT
    [dut-artix7-a12t.sch, fpga.sch, fpgaprog.sch, power.sch]
2020-08-01 artix 7 dut PCB work
    [dut-artix7-a12t.sch, fpga.sch, power.sch, target.sch]
2020-08-13 artix 7 dut updates
    [dut-artix7-a12t.kicad_pcb, dut-artix7-a12t.sch, fpga.sch, fpgaprog.sch, power.sch, target.sch]
2020-10-30 updated 3d model path of sma connector
    [dut-artix7-a12t.kicad_pcb]
2020-11-19 Added LTC3633 power regulator to serve as the main system power supply
    [fpgaprog.sch, power.sch]
2020-11-24 moving ADC
    [fobosshield.kicad_pcb, openADC.sch]
2020-11-25 Adding LTC3633 power chip to CERG lib
    [power.sch]
2020-11-25 added probe friendly testpoints
    [dutconnect.sch, fobosshield.kicad_pcb, power.sch]
2020-12-15 Removed LTC3633 dual output power switcher IC Added LTC3569 triple output power switcher IC
    [power.sch]
2020-12-16 Finished the LTC3659 circuit - added gnd, epad to gnd net Completed PGOOD LED circuit Added slide switch to serve as ON_OFF switch
    [dut-artix7-a12t.kicad_pcb, power.sch]
2020-12-16 more changes to FOBOS Shield rev2
    [ardu.sch, fobosshield.kicad_pcb, power.sch]
2020-12-18 more adjustments on shield PCB part locations
    [fobosshield.kicad_pcb]
2020-12-21 Added PGOOD LED and NFET Connected INA225 to Current shunt resistor
    [power.sch]
2020-12-21 tiny changes on FOBOS2 shield
    [ardu.sch, fobosshield.kicad_pcb]
2020-12-29 renamed 20-pin connector signals
    [20 Pin Connector.ods, ardu.sch, dutconnect.sch, fobosshield.kicad_pcb, fobosshield.sch, power.sch]
2020-12-30 completed change of signal names on target connector
    [20 Pin Connector.ods, ardu.sch, dutconnect.sch, fobosshield.kicad_pcb, power.sch]
2021-01-11 power regulator layout done
    [ardu.sch, dutconnect.sch, fobosshield.kicad_pcb, power.sch]
2021-01-11 FOBOS Shield rev2 ready for review
    [fobosshield.kicad_pcb]
2021-01-13 -Added TS3A27518EIPWRQ1 6 circuit analog SPDT switch -Connected tripple output power supply to FPGA power pins -Added bypass and decoupling capacitors to the FPGA power pins(these will be DNP) -Swapp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
    [105-0753-001.stp, 878321420.stp, FPGA 2.sch, TSSOP-16_FEBA_LIT.step, dut-artix7-a12t.kicad_pcb, dut-artix7-a12t.sch, fpga 1.sch, fpgaprog.sch]
2021-01-13 touchups on FOBOS Shield PCB
    [fobosshield.kicad_pcb]
2021-01-22 starting to fill areas
    [fobosshield.kicad_pcb]
2021-01-22 FBOBOS Shield rev2 passes DRC
    [fobosshield.kicad_pcb]
2021-01-23 ready for review
    [fobosshield.kicad_pcb]
2021-01-24 disconnected XADC ground from GND
    [fobosshield.kicad_pcb, power.sch]
2021-02-04 fixed small PCB problems
    [fobosshield.kicad_pcb]
2021-02-05 Schematic is 99% complete, getting started on layout
    [91772A106_18-8 SS PAN HEAD PHILLIPS MACHINE SCREW.STEP, 91780A537_ALUM FEM THRDED HEX STANDOFF.STEP, BRC2012T3R3MD.STEP, FPGA 2.sch, SRN2012 series.stp, User Button and IO.sch, c-1825910-6-c-3d.stp, dut-artix7-a12t.kicad_pcb]
2021-02-05 small PCB improvements
    [fobosshield.kicad_pcb]
2021-02-11 added SMA for input from INA225 on DUT
    [fobosshield.kicad_pcb, power.sch]
2021-02-12 FOBOS Shield rev2 ready for manufacturing
    [fobosshield.kicad_pcb, fobosshield.sch, power.sch]
2021-02-15 Preliminary placement underway Made a copy of cerg 3d model within Artix 7 dut project to resolve nagging library path issue
    [CUI_PJ-102AH.step, FPGA 2.sch, PVQFN16.step, SMA_Board_Edge_Molex_732511150.step, SSOP-20.step, User Button and IO.sch, User Library-SSOP16.step, dut-artix7-a12t.kicad_pcb]
2021-03-04 labs are not working with foboslib
    [projmgr.py, viewPlots.py]
2021-03-08 small fixed to foboslib, not done yet
    [hardware_mgr.py, pynqctrl.py]
2021-03-11 Coarse placement of all components within board outline, began to route traces
    [User Button and IO.sch, dut-artix7-a12t.kicad_pcb, power.sch, target.sch]
2021-03-23 ARTIX 7 DUT Layout is 80% done
    [User Button and IO.sch, dut-artix7-a12t.kicad_pcb, fpga 1.sch, power.sch, target.sch]
2021-03-23 Completed layout of the Artix 7 DUT Board
    [FPGA 2.sch, dut-artix7-a12t.kicad_pcb, fpga 1.sch, fpgaprog.sch]
2021-03-25 added xdc files for CW305 20-pin connector
2021-03-27 last PCB update before shipping
    [fobosshield.kicad_pcb]
2021-04-01 Fixed bugs in cw305 xdc files for 20-pin connector
    [pynq_cw305_half_duplex.xdc]
2021-04-02 fixed an issue with fobos fpga wrapper that caused invalid data to be fed to crypto
    [fobos_controller.vhd]
2021-04-09 Expanded copper pours on layer 3 Connected NC mux pins to the FPGA
    [FPGA 2.sch, dut-artix7-a12t.kicad_pcb, target.sch]
2021-04-18 Added external 5V connector Added shunt for FC3v3 and 3V3 Added silkscreen which clarifies switch functionality Thickened 5 mil traces to 7 mil where feasible Moved Vcore amplifier closer to Vcore pa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
    [FPGA 2.sch, dut-artix7-a12t.kicad_pcb, fpga 1.sch, fpgaprog.sch, target.sch]
2021-05-26 Added Manufacturer Part Number, Manufacturer to all components except ferrite beads Added digikey quote
    [FPGA 2.sch, User Button and IO.sch, digikey_quote_25MAY2021.xls, dut-artix7-a12t.csv, dut-artix7-a12t.kicad_pcb, dut-artix7-a12t.ods, fpga 1.sch, fpgaprog.sch]
2021-05-28 Renamed /dut-artix7-a12t to /dut-artix7-a12t-csg325 Added new directory dut-artix7-a12t-cpg238/ - U1 ARTIX 7 has been swapped for CPG238 package
    [105-0753-001.stp, 878321420.stp, 91772A106_18-8 SS PAN HEAD PHILLIPS MACHINE SCREW.STEP, 91780A537_ALUM FEM THRDED HEX STANDOFF.STEP, BRC2012T3R3MD.STEP, CUI_PJ-102AH.step, FPGA 2.sch, PVQFN16.step]
2021-05-30 Committing modified cerg lib
    [xc7a100tcsg324pkg.csv, xc7a100tfgg484pkg.csv, xc7a100tfgg676pkg.csv, xc7a100tftg256pkg.csv, xc7a12tcpg238pkg.csv, xc7a12tcsg325pkg.csv, xc7a15tcpg236pkg.csv, xc7a15tcsg324pkg.csv]
2021-05-31 Started to rewire the CPG238 into the schematic Split FPGA Power and Programming into two sheets since new FPGA symbol explicitly displays each power pin and is much larger
    [FPGA 2.sch, User Button and IO.sch, dut-artix7-a12t.kicad_pcb, dut-artix7-a12t.sch, fpga 1.sch, fpgaprog.sch, power.sch, target.sch]
2021-05-31 Added 3d model for CPG238 part Wiped out old traces and power pours
    [XA7A25T-1CPG238Q.stp, fpgapower.sch]
2021-05-31 annotated artix-7 bom
    [dut-artix7-a12t.ods]
2021-06-01 Connected the fixed signals to the FPGA, flexible IO are left unconnected Added 0.1 ohm resistors to the 1V8 and 3V3 power rails, added test points which allow for easy measurement Updated ARTIX7-A12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
    [7_Series_Schematic_Review_Recommendations.xlsm, FPGA 2.sch, User Button and IO.sch, dut-artix7-a12t.kicad_pcb, dut-artix7-a12t.sch, fpga 1.sch, fpgapower.sch, fpgaprog.sch]
2021-06-06 Added SMA-JOHNSON-142-0701-201 Vertical SMA footprint to CERG lib, added this footprint to the Vcore measurement Re-positioned Power circuitry to the top right quadrant Re-positioned FOBOS connector 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
    [142-0701-201.stp, User Button and IO.sch, dut-artix7-a12t.kicad_pcb, fpgaprog.sch, power.sch]
2021-06-07 updated library ref for diode and FET, placed target connector and some parts
    [User Button and IO.sch, dut-artix7-a12t.kicad_pcb, fpga 1.sch, fpgaprog.sch, power.sch, target.sch]
2021-06-07 few layout alignments incl space around FPGA
    [dut-artix7-a12t.kicad_pcb, fpga 1.sch, fpgaprog.sch]
2021-06-07 moved power jumpers and added graphic
    [dut-artix7-a12t.kicad_pcb, power.sch]
2021-06-08 discussion with Eddie
    [dut-artix7-a12t.kicad_pcb]
2021-06-08 placed user buttons and leds, flash
    [User Button and IO.sch, dut-artix7-a12t.kicad_pcb]
2021-06-08 fixed PMOD
    [dut-artix7-a12t.kicad_pcb, target.sch]
2021-06-09 modified BJT in power circuit to match ordered BOM
    [dut-artix7-a12t.kicad_pcb, power.sch]
2021-06-10 added protection for PMOD
    [dut-artix7-a12t.kicad_pcb, target.sch]
2021-06-11 everything placed on top except decoupling caps
    [dut-artix7-a12t.kicad_pcb, power.sch, target.sch]
2021-06-24 Updated parts on PCB bottom side and fixed U7-U5 mixup on Silkscreen
    [fobosshield.kicad_pcb, power.sch]
2021-06-29 started updating powermanager
2021-06-30 new powermanager IP created and sources copied
    [powermanager.ods]
2021-07-01 updated powermanager and pynq top level, added xdc for shield rev2
    [powermanager.ods]
2021-07-03 powermanager compiles, tristate fixed
    [average.vhd, ctrl_top_wrapper.vhd, powermanager_v1_1_S00_AXI.vhd, powermanagetop.vhdl, pynq_rev2.xdc]
2021-07-07 updated FPGA pins and added XADC channels to schematic
    [ardu.sch]
2021-07-10 powermanager voltage setting and reading fixed
    [powermanager.ods]
2021-07-26 Moved bypass/coupling capacitors underneath the FPGA Started routing top layer using 10 mil tracks with 5 mil spacing
    [dut-artix7-a12t.kicad_pcb, fpgapower.sch]
2021-07-31 added still incomplete power.py to foboslib and nexys4dut.py
2021-08-03 added more commands to power.py
2021-08-04 mixup of gain bits corrected
    [pynq_rev2.xdc]
2021-08-04 checked current measurement commands in power.py
2021-08-05 interactive bom
    [power.sch]
2021-08-06 added avg and max commands to power.py
2021-08-06 power.py ready for testing. Still missing callibration
2021-08-07 Added ADC Over-range port to openadc IP
2021-08-07 added function to check ADC overrange bit of openadc
2021-08-09 Continued to work on layout, escaped FPGA power connections, routed mux signal near fpga.
    [dut-artix7-a12t.kicad_pcb]
2021-08-16 Continued to work on dut-artix7-a12t.kicad_pcb layout
    [dut-artix7-a12t.kicad_pcb]
2021-11-03 DUT controller can now hangle CW305
    [powermanager.ods]
2021-11-19 added UART to PL and target switcher to dutcom
2022-01-22 Updated escape routing of most pads to take advantage of "pad sacrifices"
    [FPGA 2.sch, dut-artix7-a12t.kicad_pcb, fpga 1.sch, target.sch]
2022-01-24 All signals routed, need to route power
    [FPGA 2.sch, dut-artix7-a12t.kicad_pcb, fpga 1.sch, fpgaprog.sch]
2022-01-30 Traces are routed and DRC errors are cleared, last remaining step is to place L3 power planes
    [dut-artix7-a12t.kicad_pcb]
2022-02-04 Poured copper planes for L2 Added second 3 mil trace to Pad V12
    [dut-artix7-a12t.kicad_pcb]
2022-02-04 Modified L2 power planes Fixed bottom silkscreen overlap with component pads
    [dut-artix7-a12t.kicad_pcb]
2022-02-05 Made VCCINT one continuous plane 3V3 plane now has a small plane on the bottom layer as a result of giving up L3 room for VCCINT plane VCCINT measurement point move from VIA near BGA pad G10 to JP5P1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
    [dut-artix7-a12t.kicad_pcb]
2022-02-06 swapped location of measurement and glitch SMA and many other little changes
    [CUI_DEVICES_DS04-254-2-03BK-SMT-TR.step, dut-artix7-a12t.kicad_pcb, power.sch]
2022-02-06 Fixed unconnected trace DRC error Moved position of top silkscreen designators ti fix overlap issues
    [dut-artix7-a12t.kicad_pcb]
2022-02-24 almost last review
    [FPGA 2.sch, User Button and IO.sch, dut-artix7-a12t.kicad_pcb, dut-artix7-a12t.sch, fpga 1.sch, fpgapower.sch, fpgaprog.sch, power.sch]
2022-02-25 Added 3D models for U8 and C1
    [JS202011SCQN.stp, TSSOP-16_FEBA_LIT.step, dut-artix7-a12t.kicad_pcb, fpga.sch]
2022-03-01 added copper corsers around FPGA
    [dut-artix7-a12t.kicad_pcb]
2022-03-09 Moved PCB so that it fits inside of title block Created BOM which matches the rev 1 design Generated pick and place data, assembly drawings
    [BOM_dut-artix7-a12t-cpg238.xlsx, FPGA 2.sch, dut-artix7-a12t.kicad_pcb]
2022-03-22 added updated power notebook
2022-04-21 added new fpga wrapper that can generate randomness on the target board
    [configFile.txt]
2022-04-29 fixed a bug that causes pynq to reuse old data in the case testvector is empty (when dinFile finished)
2022-05-02 Updated BOM/BOM_dut-artix7-a12t-cpg238.xlsx
    [BOM_dut-artix7-a12t-cpg238.xlsx]
2022-05-02 Initial commit of Cyclone 10 dut project. Layout is still underway
    [105-0753-001.stp, 10cl016.xls, 142-0701-201.stp, 7_Series_Schematic_Review_Recommendations.xlsm, 878321420.stp, 91772A106_18-8 SS PAN HEAD PHILLIPS MACHINE SCREW.STEP, 91780A537_ALUM FEM THRDED HEX STANDOFF.STEP, BRC2012T3R3MD.STEP]
2022-05-02 Captured BOM changes in BOM Changes.txt Created dut-artix7-a12t-schematic.pdf
2022-05-04 Moved datasheets, reference designs, and power estimator to nextcloud
    [10cl016.xls, dut-cyclone10-10cl016-u256.kicad_pcb]
2022-05-04 Changed BGA pad diameter from 0.45mm to 0.38mm Changed BGA vias from 8/16mil to 10/18mil
    [dut-cyclone10-10cl016-u256.kicad_pcb]
2022-05-04 fixed issues with ranomness generation in dut_wrapper
    [core_wrapper.vhd, fobosctrl.py, pynqctrl.py, pynqserver.py, serverWatchdog.py]
2022-05-15 Updated jtag connector to match terasic usb blaster Connected SPI Flash Layout is in work
    [SBH11-_ _ _C-D05-ST-_ _.IGS, dut-cyclone10-10cl016-u256.kicad_pcb, fpgaprog.sch]
2022-05-28 fixed typo in fobosctrl, no sudo for nexys4 programing
    [fobosctrl.py, pynqctrl.py]
2022-06-01 removed docs/labs and fixed typos in install-pynq.sh
    [viewPlots.py]
2022-06-05 Added python_conf support, corrected several typos in powermanager calls in pynqserver
    [fobosctrl.py, pynqserver.py, serverWatchdog.py]
2022-06-08 added powerManager and dut_working functions to pynqctrl.py
2022-06-24 fixed bug in projmgr and cleaned up capture_adc
    [projmgr.py]
2022-07-29 added BOM to artix-7 target board
    [dut-artix7-a12t.kicad_pcb]
2022-07-29 converted Artix7 dut to KiCad6
    [FPGA 2.kicad_sch, User Button and IO.kicad_sch, dut-artix7-a12t.kicad_sch, fpga 1.kicad_sch, fpgapower.kicad_sch, fpgaprog.kicad_sch, power.kicad_sch, target.kicad_sch]
2022-08-14 transitioned artix-7 dut to Kikad 6
    [FPGA 2.kicad_sch, User Button and IO.kicad_sch, dut-artix7-a12t.kicad_pcb, dut-artix7-a12t.kicad_sch, fpga 1.kicad_sch, fpgapower.kicad_sch, fpgaprog.kicad_sch, power.kicad_sch]
2022-08-17 Power diagram for Artix-7 DUT
2022-09-02 added power calibration script
2022-09-11 updated power calibration and correct register access error in power.py
    [power_conf.csv]
2022-09-16 fobos_tv_gen: new FOBOS TV generation
    BRAM FIFO wrapper ok
    [configFile.txt]
